AlphaCassiopeiae/web/Files/docs/A7 - Bill of Materials.xlsx

Bill of Materials
Year: | 2025
Semester: | Spring
Team #: | 15
Project Name: | αCassiopeiae
Authors: | Caleb Shinkle, Brian Lu, Seth Deegan, Nathan Huang
Created: | 2025-02-10
Last Modified: | 2025-02-15
Project Component | PCB |  | Value | Package |  |  |  |  | Approximate Price
Description | ID | Qty | (Ohm, etc.) | (type or size) | Manufacturer | Mfg. Part # | Supplier | Supplier Part # | (Qty 1)
RP2350 Stamp XL Boards | 1 | 3 | - | 1 in x 1.75 in | Raspberry Pi | Raspberry Pi Stamp | Pimoroni |  | $19
SMD Red Reverse LEDs | 2 | 36 |  | 3.2 mm x 2.8 mm | SunLED | XZM2CRK45WT-9 | DigiKey | 1497-1331-1-ND | $14
Printed Circuit Board | 3 | 9 | - | Custom | JLCPCB | - | JLCPCB | - | $10
Raspberry Pi Pico 2 | 4 | 3 | - | 21 mm x 51 mm | Raspberry Pi Ltd | RP2350B | DigiKey | - | $5
128 MB Flash | 11 | 3 |  | 8-SOIC (0.209", 5.30mm Width) | Winbond Electronics | W25Q128JVSJQ | DigiKey | W25Q128JVSJQ-ND | $1.75
Crystal Oscillator | 12 | 3 |  | 5 SMD | Abracon LLC | ABM8-272-T3 | DigiKey | 535-ABM8-272-T3TR-ND | $0.54
MCP16331T-E/CH | 5 | 2 | DC-DC converter IC | 6-pin SOT-23 | Microchip Technology | MCP16331T-E/CH | DigiKey | MCP16331T-E/CH | $1
USB-C BREAKOUT | 6 | 6 | - | 22.1mm x 14mm x 4.9mm | SparkFun Electronics | BOB-15100 | DigiKey | BOB-15100 | $6
Flat Flexible Cable | 7 | 3 | - | 2.000 inches | Molex | 0150150233 | DigiKey | WM9647-ND | $2
FFC Socket Strip | 8 | 6 | Connector | 20-position, 1.00 mm pitch | Samtec | FC1-20-01-T-TR | Mouser | 200-FC12001TTR | $3.34
TFT Slide Switches | 9 | 16 | Through Hole Mount | - | Amazon | B09R3XLVVS | Amazon | - | $7
Enclosure | 10 | 1 | - | 12 in x 7 in x 5 in | Custom | - | Custom | - | N/A
Note: Do not list misc. discrete parts (resistors, caps, etc.) such as decoupling caps and ESD protection current limiting resistors.
