AlphaCassiopeiae/web/Team/journal/img - member1/week11/20250325_8800_computer.csv

Query | Qty | Manufacturer | MPN | Octopart URL | Part Description | Description | Schematic Reference | Internal Part Number | Lifecycle | Lead Time | RoHS | Total Qty (@ Batch Size: 4) | SKU | SKU | SKU | SKU | SKU | Packaging | Packaging | Packaging | Packaging | Packaging | Unit Price (@ Batch Size: 4) | Unit Price (@ Batch Size: 4) | Unit Price (@ Batch Size: 4) | Unit Price (@ Batch Size: 4) | Unit Price (@ Batch Size: 4) | In Stock | In Stock | In Stock | In Stock | In Stock | MOQ | MOQ | MOQ | MOQ | MOQ | URL | URL | URL | URL | URL | Distributor [Lowest Price (Preferred Distributors)] | SKU [Lowest Price (Preferred Distributors)] | Packaging [Lowest Price (Preferred Distributors)] | Unit Price (@ Batch Size: 4) [Lowest Price (Preferred Distributors)] | Line Total [Lowest Price (Preferred Distributors)] | Batch Total [Lowest Price (Preferred Distributors)] | In Stock [Lowest Price (Preferred Distributors)] | MOQ [Lowest Price (Preferred Distributors)] | URL [Lowest Price (Preferred Distributors)] | Notes
 |  |  |  |  |  |  |  |  |  |  |  |  | Digi-Key | Mouser | Newark | Onlinecomponents.com | RS Components | Digi-Key | Mouser | Newark | Onlinecomponents.com | RS Components | Digi-Key | Mouser | Newark | Onlinecomponents.com | RS Components | Digi-Key | Mouser | Newark | Onlinecomponents.com | RS Components | Digi-Key | Mouser | Newark | Onlinecomponents.com | RS Components | Digi-Key | Mouser | Newark | Onlinecomponents.com | RS Components
TLC59211IPWR | 5 | Texas Instruments | TLC59211IPWR | https://octopart.com/tlc59211ipwr-texas+instruments-12190463 | Tape & Reel (TR) TLC59211 Boost Surface Mount led driver 6.5mm 200mA 5.5V 1MHz |  |  |  | Production (Last Updated: 1 week ago) | 6w | Compliant | 20 | 296-25404-1-ND | 595-TLC59211IPWR |  |  |  | Cut Tape | Tape & Reel |  |  |  | 1.096 | 1.03 |  |  |  | 5318 | 1116 |  |  |  | 1 | 1 |  |  |  | https://octopart.com/opatz8j6/a1 | https://octopart.com/opatz8j6/a1 |  |  |  | Mouser | 595-TLC59211IPWR | Tape & Reel | 1.03 | 5.15 | 20.6 | 1116 | 1 | https://octopart.com/opatz8j6/a1
VLRK31Q1R2-GS08 | 36 | Vishay | VLRK31Q1R2-GS08 | https://octopart.com/vlrk31q1r2-gs08-vishay-23378693 | Led Smd Red Reverse Gullwing Rohs Compliant: Yes |Vishay VLRK31Q1R2-GS08 |  |  |  |  | 10w | Compliant | 144 | VLRK31Q1R2-GS08CT-ND | 78-VLRK31Q1R2-GS08 | 58AJ2838 |  |  | Cut Tape | Tape & Reel | Cut Tape |  |  | 0.2158 | 0.171 | 0.166 |  |  | 8551 | 806 | 287 |  |  | 1 | 1 | 5 |  |  | https://octopart.com/opatz8j6/a1 | https://octopart.com/opatz8j6/a1 | https://octopart.com/opatz8j6/a1 |  |  | Newark | 58AJ2838 | Cut Tape | 0.166 | 5.976 | 23.904 | 287 | 5 | https://octopart.com/opatz8j6/a1
10145891-0320J13LF | 4 | Amphenol Communications Solutions | 10145891-0320J13LF | https://octopart.com/10145891-0320j13lf-amphenol+communications+solutions-126543368 | DDR4 Memory Module Socket Connector Socket 288 Position 0.85mm Solder Surface Mount |  |  |  |  | 16w |  | 16 | 609-6571-ND | 649-1014591320J13LF | 81AC5784 | 10145891-0320J13LF |  | Tray | Tray |  | Bulk |  | 3.097 | 2.97 | 2.83 |  |  | 1757 | 1500 | 1148 | 2 |  | 1 | 1 | 1 | 32 |  | https://octopart.com/opatz8j6/a1 | https://octopart.com/opatz8j6/a1 | https://octopart.com/opatz8j6/a1 | https://octopart.com/opatz8j6/a1 |  | Newark | 81AC5784 |  | 2.83 | 11.32 | 45.28 | 1148 | 1 | https://octopart.com/opatz8j6/a1
MCP16331T-E/CH | 1 | Microchip | MCP16331T-E/CH | https://octopart.com/mcp16331t-e%2Fch-microchip-47099655 | Conv DC-DC 4.4V to 50V Step Down Single-Out 2V to 24V 0.5A Automotive 6-Pin SOT-23 T/R |  |  |  | Production (Last Updated: 4 years ago) | 17w | Compliant | 4 | MCP16331T-E/CHCT-ND | 579-MCP16331T-E/CH | 84X5964 | MCP16331T-E/CH |  | Cut Tape | Tape & Reel | Cut Tape | Bulk |  | 1.75 | 1.75 | 1.48 |  |  | 4507 | 6366 | 6866 | 6000 |  | 1 | 1 | 1 | 250 |  | https://octopart.com/opatz8j6/a1 | https://octopart.com/opatz8j6/a1 | https://octopart.com/opatz8j6/a1 | https://octopart.com/opatz8j6/a1 |  | Newark | 84X5964 | Cut Tape | 1.48 | 1.48 | 5.92 | 6866 | 1 | https://octopart.com/opatz8j6/a1
USB4105-GF-A | 4 | Global Connector Technology | USB4105-GF-A | https://octopart.com/usb4105-gf-a-global+connector+technology-107467269 | USB Connector, 24 Contact(s), Female, Right Angle, Solder Terminal, Locking, Receptacle |  |  |  |  | 12w | Compliant | 16 | 2073-USB4105-GF-ACT-ND |  | 86AH2021 |  |  | Cut Tape |  | Cut Tape |  |  | 0.659 |  | 0.701 |  |  | 52214 |  | 556 |  |  | 1 |  | 1 |  |  | https://octopart.com/opatz8j6/a1 |  | https://octopart.com/opatz8j6/a1 |  |  | DigiKey | 2073-USB4105-GF-ACT-ND | Cut Tape | 0.659 | 2.636 | 10.544 | 52214 | 1 | https://octopart.com/opatz8j6/a1
OS102011MS2QN1 | 16 | C&K Components | OS102011MS2QN1 | https://octopart.com/os102011ms2qn1-c%26k+components-2486956 | C & K COMPONENTS - OS102011MS2QN1 - Slide Switch, SPDT, On-On, Through Hole, OS Series, 100 mA |  |  |  |  | 10w | Compliant | 64 | CKN9565-ND | 611-OS102011MS2QN1 | 35AH4511 | OS102011MS2QN1 |  | Bulk | Bulk |  | Bulk |  | 0.5616 | 0.475 | 0.51 |  |  | 63701 | 3295 | 315 | 36554 |  | 1 | 1 | 1 | 300 |  | https://octopart.com/opatz8j6/a1 | https://octopart.com/opatz8j6/a1 | https://octopart.com/opatz8j6/a1 | https://octopart.com/opatz8j6/a1 |  | Mouser | 611-OS102011MS2QN1 | Bulk | 0.475 | 7.6 | 30.4 | 3295 | 1 | https://octopart.com/opatz8j6/a1
USB4235-03-C | 1 | Global Connector Technology | USB4235-03-C | https://octopart.com/usb4235-03-c-global+connector+technology-157378717 | Usb Connector, 2.0 Typ C Rcpt, 16POS, SMT; |  |  |  |  | 7w |  | 4 | 2073-USB4235-03-CCT-ND |  | 16AM9284 |  |  | Cut Tape |  |  |  |  | 0.87 |  | 1.15 |  |  | 361 |  | 439 |  |  | 1 |  | 1 |  |  | https://octopart.com/opatz8j6/a1 |  | https://octopart.com/opatz8j6/a1 |  |  | DigiKey | 2073-USB4235-03-CCT-ND | Cut Tape | 0.87 | 0.87 | 3.48 | 361 | 1 | https://octopart.com/opatz8j6/a1
5017868090 | 1 | Molex | 501786-8090 | https://octopart.com/501786-8090-molex-46509680 | FFC & FPC Connectors 0.5 FFC To Board ST Type 80CktEmbsTp Pkg |  |  |  | Production (Last Updated: 4 years ago) | 9w | Compliant | 4 | WM20781CT-ND | 538-501786-8090 | 82AH2668 | 501786-8090 |  | Cut Tape |  | Cut Tape | Bulk |  | 4.82 | 4.82 | 5.12 |  |  | 2552 | 2016 | 623 | 17100 |  | 1 | 1 | 1 | 900 |  | https://octopart.com/opatz8j6/a1 | https://octopart.com/opatz8j6/a1 | https://octopart.com/opatz8j6/a1 | https://octopart.com/opatz8j6/a1 |  | DigiKey | WM20781CT-ND | Cut Tape | 4.82 | 4.82 | 19.28 | 2552 | 1 | https://octopart.com/opatz8j6/a1
1455T2202 | 1 | Hammond | 1455T2202 | https://octopart.com/1455t2202-hammond-50599 | Aluminum enclosure, (L x W x H) 220 x 165 x 51.5 mm, natural, IP54, 1455T2202 |  |  |  |  | 4w | Compliant | 4 | HM906-ND | 546-1455T2202 | 98H4055 | 1455T2202 |  | Bulk | Bulk |  | Bulk |  | 33.01 | 29.41 | 30.87 | 30.01 |  | 37 | 81 | 249 | 3 |  | 1 | 1 | 1 | 1 |  | https://octopart.com/opatz8j6/a1 | https://octopart.com/opatz8j6/a1 | https://octopart.com/opatz8j6/a1 | https://octopart.com/opatz8j6/a1 |  | Mouser | 546-1455T2202 | Bulk | 29.41 | 29.41 | 117.64 | 81 | 1 | https://octopart.com/opatz8j6/a1
S3B-XH-A | 12 | JST | S3B-XH-A | https://octopart.com/s3b-xh-a-jst-3990374 | Board Connector, 3 Contact(s), 1 Row(s), Male, Right Angle, Solder Terminal |  |  |  |  | 16w | Compliant | 48 | 455-S3B-XH-A-ND |  |  |  |  | Bulk |  |  |  |  | 0.118 |  |  |  |  | 138085 |  |  |  |  | 1 |  |  |  |  | https://octopart.com/opatz8j6/a1 |  |  |  |  | DigiKey | 455-S3B-XH-A-ND | Bulk | 0.118 | 1.416 | 5.664 | 138085 | 1 | https://octopart.com/opatz8j6/a1
NCP1117ST33T3G | 3 | onsemi | NCP1117ST33T3G | https://octopart.com/ncp1117st33t3g-onsemi-538117 | NCP1117 Series 1 A 3.3 V Fixed Output LDO Positive Voltage Regulator - SOT-223 |  |  |  | Production (Last Updated: 4 years ago) | 9w | Compliant | 12 | NCP1117ST33T3GOSCT-ND | 863-NCP1117ST33T3G | 67H7013 | NCP1117ST33T3G |  | Cut Tape | Tape & Reel | Cut Tape | Bulk |  | 0.71 | 0.71 | 0.749 |  |  | 35924 | 40182 | 2284 | 16000 |  | 1 | 1 | 1 | 4000 |  | https://octopart.com/opatz8j6/a1 | https://octopart.com/opatz8j6/a1 | https://octopart.com/opatz8j6/a1 | https://octopart.com/opatz8j6/a1 |  | Mouser | 863-NCP1117ST33T3G | Tape & Reel | 0.71 | 2.13 | 8.52 | 40182 | 1 | https://octopart.com/opatz8j6/a1
500SSP1S1M7QEA | 1 | E-Switch | 500SSP1S1M7QEA | https://octopart.com/500ssp1s1m7qea-e-switch-1199228 | Switch Slide ON None ON SPDT Side Slide 5A 250VAC 28VDC PC Pins Bracket Mount/Through Hole |  |  |  |  | 12w | Compliant | 4 | EG2480-ND | 612-500-A171 | 16N1338 | 500SSP1S1M7QEA |  | Bulk | Bulk |  | Bulk |  | 4.13 | 4.03 |  |  |  | 1528 | 730 | 1512 | 762 |  | 1 | 1 | 252 | 63 |  | https://octopart.com/opatz8j6/a1 | https://octopart.com/opatz8j6/a1 | https://octopart.com/opatz8j6/a1 | https://octopart.com/opatz8j6/a1 |  | Mouser | 612-500-A171 | Bulk | 4.03 | 4.03 | 16.12 | 730 | 1 | https://octopart.com/opatz8j6/a1
SS34 | 3 | onsemi | SS34 | https://octopart.com/ss34-onsemi-84331624 | SS Series 500 mV 3 A 40 V Max Reverse Voltage Schottky Rectifier - DO-214AB |  |  |  | Production (Last Updated: 4 years ago) | 9w | Compliant | 12 | SS34FSCT-ND | 512-SS34 | 18C8659 | SS34 |  | Cut Tape | Tape & Reel | Cut Tape | Bulk |  | 0.461 | 0.555 | 0.267 |  |  | 19835 | 63709 | 98766 | 27000 |  | 1 | 1 | 1 | 3000 |  | https://octopart.com/opatz8j6/a1 | https://octopart.com/opatz8j6/a1 | https://octopart.com/opatz8j6/a1 | https://octopart.com/opatz8j6/a1 |  | Newark | 18C8659 | Cut Tape | 0.267 | 0.801 | 3.204 | 98766 | 1 | https://octopart.com/opatz8j6/a1
ERJ-PA3F27R0V | 8 | Panasonic | ERJ-PA3F27R0V | https://octopart.com/erj-pa3f27r0v-panasonic-51302422 | Res Thick Film 0603 27 Ohm 1% 0.25W(1/4W) ±100ppm/C Pad SMD Automotive T/R |  |  |  | Production (Last Updated: 4 years ago) | 15w | Compliant | 32 | P27.00BYCT-ND | 667-ERJ-PA3F27R0V | 85Y6353 | ERJ-PA3F27R0V |  | Cut Tape | Tape & Reel | Cut Tape | Bulk |  | 0.07 | 0.047 | 0.046 |  |  | 29555 | 5294 | 580 | 0 |  | 1 | 1 | 10 | 5000 |  | https://octopart.com/opatz8j6/a1 | https://octopart.com/opatz8j6/a1 | https://octopart.com/opatz8j6/a1 | https://octopart.com/opatz8j6/a1 |  | Newark | 85Y6353 | Cut Tape | 0.046 | 0.368 | 1.472 | 580 | 10 | https://octopart.com/opatz8j6/a1
TAJA226M006RNJ | 6 | AVX | TAJA226M006RNJ | https://octopart.com/taja226m006rnj-avx-3912279 | Cap Tant Solid 22uF 6.3V A CASE 20% (3.2 X 1.6 X 1.6mm) SMD 3216-18 3 Ohm 125A HA T/R |  |  |  | Production (Last Updated: 5 years ago) | 6w | Compliant | 24 | 478-3028-1-ND | 581-TAJA226M006R | 60R5845 |  |  | Cut Tape | Tape & Reel | Cut Tape |  |  | 0.287 | 0.206 | 0.052 |  |  | 10738 | 3115 | 63 |  |  | 1 | 1 | 1 |  |  | https://octopart.com/opatz8j6/a1 | https://octopart.com/opatz8j6/a1 | https://octopart.com/opatz8j6/a1 |  |  | Newark | 60R5845 | Cut Tape | 0.052 | 0.312 | 1.248 | 63 | 1 | https://octopart.com/opatz8j6/a1
C0805C106K4PACTU | 3 | KEMET | C0805C106K4PACTU | https://octopart.com/c0805c106k4pactu-kemet-9144095 | Multilayer Ceramic Capacitors MLCC - SMD/SMT 16V 10uF X5R 0805 10% |  |  |  |  | 33w | Compliant | 12 | 399-C0805C106K4PACTUCT-ND | 80-C0805C106K4P | 25M8789 |  |  | Cut Tape | Tape & Reel | Cut Tape |  |  | 0.086 | 0.086 | 0.738 |  |  | 495105 | 348315 | 213204 |  |  | 1 | 1 | 10 |  |  | https://octopart.com/opatz8j6/a1 | https://octopart.com/opatz8j6/a1 | https://octopart.com/opatz8j6/a1 |  |  | Mouser | 80-C0805C106K4P | Tape & Reel | 0.086 | 0.258 | 1.032 | 348315 | 1 | https://octopart.com/opatz8j6/a1
CRG0603F5K1 | 6 | TE Connectivity | CRG0603F5K1 | https://octopart.com/crg0603f5k1-te+connectivity-16077405 | Res Thick Film 0603 5.1K Ohm 1% 0.1W(1/10W) ±100ppm/C Pad SMD T/R |  |  |  | Production (Last Updated: 2 weeks ago) | 12w | Compliant | 24 | 1712-CRG0603F5K1CT-ND | 279-CRG0603F5K1 | 20R1551 | CRG0603F5K1 |  | Cut Tape | Tape & Reel | Tape & Reel | Bulk |  | 0.027 | 0.019 |  |  |  | 32330 | 25484 | 0 | 5000 |  | 1 | 1 | 20000 | 10000 |  | https://octopart.com/opatz8j6/a1 | https://octopart.com/opatz8j6/a1 | https://octopart.com/opatz8j6/a1 | https://octopart.com/opatz8j6/a1 |  | Mouser | 279-CRG0603F5K1 | Tape & Reel | 0.019 | 0.11399999999999999 | 0.45599999999999996 | 25484 | 1 | https://octopart.com/opatz8j6/a1
CRGCQ0805J100K | 3 | TE Connectivity | CRGCQ0805J100K | https://octopart.com/crgcq0805j100k-te+connectivity-91018199 | Res Thick Film 0805 100K Ohm 5% 0.125W(1/8W) ±100ppm/C Pad SMD Automotive AEC-Q200 T/R |  |  |  | Production (Last Updated: 2 weeks ago) | 12w | Compliant | 12 | A130146CT-ND | 279-CRGCQ0805J100K | 61AC6610 | CRGCQ0805J100K |  | Cut Tape | Tape & Reel | Cut Tape | Bulk |  | 0.031 | 0.017 | 0.018 |  |  | 20354 | 2744 | 8 | 0 |  | 1 | 1 | 10 | 5000 |  | https://octopart.com/opatz8j6/a1 | https://octopart.com/opatz8j6/a1 | https://octopart.com/opatz8j6/a1 | https://octopart.com/opatz8j6/a1 |  | Mouser | 279-CRGCQ0805J100K | Tape & Reel | 0.017 | 0.051000000000000004 | 0.20400000000000001 | 2744 | 1 | https://octopart.com/opatz8j6/a1
AC0402JR-130RL | 12 | Yageo | AC0402JR-130RL | https://octopart.com/ac0402jr-130rl-yageo-30510720 | Zero Ohm Resistor, Jumper, 0402 [1005 Metric], Thick Film, 63 mW, 1 A, Surface Mount |  |  |  |  | 18w |  | 48 | 13-AC0402JR-130RLCT-ND | 603-AC0402JR-130RL | 46AK2287 |  |  | Cut Tape | Tape & Reel |  |  |  | 0.01 | 0.01 | 0.01 |  |  | 74451 | 111817 | 133650 |  |  | 1 | 1 | 10 |  |  | https://octopart.com/opatz8j6/a1 | https://octopart.com/opatz8j6/a1 | https://octopart.com/opatz8j6/a1 |  |  | Mouser | 603-AC0402JR-130RL | Tape & Reel | 0.01 | 0.12 | 0.48 | 111817 | 1 | https://octopart.com/opatz8j6/a1
CRG0402F5K1 | 2 | TE Connectivity | CRG0402F5K1 | https://octopart.com/crg0402f5k1-te+connectivity-22736831 | Fixed Resistor, Thick Film, 0.063W, 5100ohm, 50V, 1% +/-Tol, 100ppm/Cel, Surface Mount, 0402 |  |  |  | Production (Last Updated: 2 weeks ago) | 13w | Compliant | 8 | 1712-CRG0402F5K1CT-ND | 279-CRG0402F5K1 | 95W7485 | CRG0402F5K1 |  | Cut Tape | Tape & Reel | Cut Tape | Bulk |  | 0.1 |  |  |  |  | 27333 | 0 | 9870 | 0 |  | 1 | 10000 | 10 | 10000 |  | https://octopart.com/opatz8j6/a1 | https://octopart.com/opatz8j6/a1 | https://octopart.com/opatz8j6/a1 | https://octopart.com/opatz8j6/a1 |  | DigiKey | 1712-CRG0402F5K1CT-ND | Cut Tape | 0.1 | 0.2 | 0.8 | 27333 | 1 | https://octopart.com/opatz8j6/a1
CRGP0402F150R | 2 | TE Connectivity | CRGP0402F150R | https://octopart.com/crgp0402f150r-te+connectivity-91018667 | Res Thick Film 0402 150 Ohm 1% 0.125W(1/8W) ±100ppm/°C Pad SMD T/R Automotive AEC-Q200 |  |  |  | Production (Last Updated: 2 weeks ago) | 15w | Compliant | 8 | A130345CT-ND | 279-CRGP0402F150R | 61AC7076 | CRGP0402F150R |  | Cut Tape | Tape & Reel | Cut Tape | Bulk |  | 0.13 | 0.13 |  |  |  | 72296 | 20904 | 1928 | 0 |  | 1 | 1 | 10 | 10000 |  | https://octopart.com/opatz8j6/a1 | https://octopart.com/opatz8j6/a1 | https://octopart.com/opatz8j6/a1 | https://octopart.com/opatz8j6/a1 |  | DigiKey | A130345CT-ND | Cut Tape | 0.13 | 0.26 | 1.04 | 72296 | 1 | https://octopart.com/opatz8j6/a1
2176325-1 | 1 | TE Connectivity | 2176325-1 | https://octopart.com/2176325-1-te+connectivity-91017193 | Res Thick Film 0402 10 Ohm 1% 0.125W(1/8W) ±400ppm/°C Pad SMD T/R Automotive AEC-Q200 |  |  |  | Production (Last Updated: 2 weeks ago) | 19w | Compliant | 4 | A130331CT-ND | 279-CRGP0402F10R | 61AC7066 | 2176325-1 |  | Cut Tape | Tape & Reel | Cut Tape | Bulk |  | 0.13 | 0.13 |  |  |  | 11091 | 53543 | 13409 | 50000 |  | 1 | 1 | 10 | 10000 |  | https://octopart.com/opatz8j6/a1 | https://octopart.com/opatz8j6/a1 | https://octopart.com/opatz8j6/a1 | https://octopart.com/opatz8j6/a1 |  | Mouser | 279-CRGP0402F10R | Tape & Reel | 0.13 | 0.13 | 0.52 | 53543 | 1 | https://octopart.com/opatz8j6/a1
598-8010-107F | 2 | Dialight | 598-8010-107F | https://octopart.com/598-8010-107f-dialight-868653 | 0603 PACKAGE MICRO SMD LED Single Color LED, Red, Water Clear, 1.1mm |  |  |  |  | 8w | Compliant | 8 | 350-2029-1-ND | 645-598-8010-107F | 75R0572 | 598-8010-107F |  | Cut Tape | Tape & Reel | Cut Tape | Bulk |  | 0.23 | 0.32 | 0.064 |  |  | 47129 | 162 | 7082 | 8797 |  | 1 | 1 | 1 | 4000 |  | https://octopart.com/opatz8j6/a1 | https://octopart.com/opatz8j6/a1 | https://octopart.com/opatz8j6/a1 | https://octopart.com/opatz8j6/a1 |  | Newark | 75R0572 | Cut Tape | 0.064 | 0.128 | 0.512 | 7082 | 1 | https://octopart.com/opatz8j6/a1
AMK107ABJ106MAHT | 2 | Taiyo Yuden | AMK107ABJ106MAHT | https://octopart.com/amk107abj106maht-taiyo+yuden-29102938 | Multilayer Ceramic Capacitors MLCC - SMD/SMT 10uF 4V X5R +/-20% 0603 AEC-Q200 |  |  |  |  | 12w | Compliant | 8 | 587-3261-1-ND | 963-AMK107ABJ106MAHT | 02AH5350 | AMK107ABJ106MAHT |  | Cut Tape | Tape & Reel | Cut Tape | Bulk |  | 0.12 | 0.11 |  |  |  | 49050 | 11019 | 0 | 16000 |  | 1 | 1 | 4000 | 4000 |  | https://octopart.com/opatz8j6/a1 | https://octopart.com/opatz8j6/a1 | https://octopart.com/opatz8j6/a1 | https://octopart.com/opatz8j6/a1 |  | Mouser | 963-AMK107ABJ106MAHT | Tape & Reel | 0.11 | 0.22 | 0.88 | 11019 | 1 | https://octopart.com/opatz8j6/a1
CC0402MRX5R5BB106 | 2 | Yageo | CC0402MRX5R5BB106 | https://octopart.com/cc0402mrx5r5bb106-yageo-51849243 | 0402 10 uF 6.3 V ±20 % Tolerance X5R SMT Multilayer Ceramic Capacitor |  |  |  |  | 22w | Compliant | 8 | 311-1729-1-ND | 603-CC402MRX5R5BB106 | 34AK1777 |  |  | Cut Tape | Tape & Reel | Cut Tape |  |  | 0.2 | 0.18 |  |  |  | 748335 | 3790 | 94041 |  |  | 1 | 1 | 10 |  |  | https://octopart.com/opatz8j6/a1 | https://octopart.com/opatz8j6/a1 | https://octopart.com/opatz8j6/a1 |  |  | Mouser | 603-CC402MRX5R5BB106 | Tape & Reel | 0.18 | 0.36 | 1.44 | 3790 | 1 | https://octopart.com/opatz8j6/a1
CC0402JRX7R7BB104 | 1 | Yageo | CC0402JRX7R7BB104 | https://octopart.com/cc0402jrx7r7bb104-yageo-21707045 | 0402 0.1 uF 16 V ±5 % Tolerance X7R SMT Multilayer Ceramic Capacitor |  |  |  |  | 18w | Compliant | 4 | 311-1676-1-ND | 603-CC402JRX7R7BB104 | 40AJ6340 |  |  | Cut Tape | Tape & Reel | Cut Tape |  |  | 0.08 | 0.1 |  |  |  | 711875 | 242502 | 29373 |  |  | 1 | 1 | 10 |  |  | https://octopart.com/opatz8j6/a1 | https://octopart.com/opatz8j6/a1 | https://octopart.com/opatz8j6/a1 |  |  | DigiKey | 311-1676-1-ND | Cut Tape | 0.08 | 0.08 | 0.32 | 711875 | 1 | https://octopart.com/opatz8j6/a1
BAS16L-G3-08 | 1 | Vishay | BAS16L-G3-08 | https://octopart.com/bas16l-g3-08-vishay-114064069 | Switching Diode Genpurp Dfn1006-2A Rohs Compliant: Yes |Vishay BAS16L-G3-08 |  |  |  |  | 8w |  | 4 | 112-BAS16L-G3-08CT-ND | 78-BAS16L-G3-08 | 60AJ3508 |  |  | Cut Tape | Tape & Reel | Cut Tape |  |  | 0.17 | 0.17 |  |  |  | 23780 | 26451 | 0 |  |  | 1 | 1 | 5 |  |  | https://octopart.com/opatz8j6/a1 | https://octopart.com/opatz8j6/a1 | https://octopart.com/opatz8j6/a1 |  |  | Mouser | 78-BAS16L-G3-08 | Tape & Reel | 0.17 | 0.17 | 0.68 | 26451 | 1 | https://octopart.com/opatz8j6/a1
B130L-13-F | 1 | Diodes Inc. | B130L-13-F | https://octopart.com/b130l-13-f-diodes+inc.-325738 | Diode Schottky 30 Volt 1A 2-Pin SMA Tape and Reel |  |  |  |  | 10w | Compliant | 4 | B130L-FDICT-ND | 621-B130L-F | 28AK7619 |  |  | Cut Tape | Tape & Reel | Cut Tape |  |  | 0.24 | 0.24 | 0.087 |  |  | 12807 | 34738 | 650 |  |  | 1 | 1 | 1 |  |  | https://octopart.com/opatz8j6/a1 | https://octopart.com/opatz8j6/a1 | https://octopart.com/opatz8j6/a1 |  |  | Newark | 28AK7619 | Cut Tape | 0.087 | 0.087 | 0.348 | 650 | 1 | https://octopart.com/opatz8j6/a1
7447779115 | 1 | Wurth Elektronik | 7447779115 | https://octopart.com/7447779115-wurth+elektronik-8917202 | Power Choke Shielded Wirewound 15uH 20% 1KHz Ferrite 1.6A 81mOhm DCR T/R |  |  |  |  | 8w | Compliant | 4 | 732-4137-1-ND | 710-7447779115 | 08P2859 |  |  | Cut Tape | Tape & Reel | Cut Tape |  |  | 2.13 | 2.31 | 2.78 |  |  | 2355 | 1206 | 971 |  |  | 1 | 1 | 1 |  |  | https://octopart.com/opatz8j6/a1 | https://octopart.com/opatz8j6/a1 | https://octopart.com/opatz8j6/a1 |  |  | DigiKey | 732-4137-1-ND | Cut Tape | 2.13 | 2.13 | 8.52 | 2355 | 1 | https://octopart.com/opatz8j6/a1
CPF-A-0402B10KE1 | 1 | TE Connectivity | CPF-A-0402B10KE1 | https://octopart.com/cpf-a-0402b10ke1-te+connectivity-58810720 | Fixed Resistor, Thin Film, 0.063W, 10000ohm, 25V, 0.1% +/-Tol, 25ppm/Cel, Surface Mount, 0402 |  |  |  | Production (Last Updated: 2 weeks ago) | 10w |  | 4 | 1712-CPF-A-0402B10KE1CT-ND | 279-CPF-A-0402B10KE1 | 52Y3079 | CPF-A-0402B10KE1 |  | Cut Tape | Tape & Reel | Cut Tape | Bulk |  | 0.31 | 0.31 | 0.421 |  |  | 607 | 1939 | 128 | 2000 |  | 1 | 1 | 1 | 1000 |  | https://octopart.com/opatz8j6/a1 | https://octopart.com/opatz8j6/a1 | https://octopart.com/opatz8j6/a1 | https://octopart.com/opatz8j6/a1 |  | Mouser | 279-CPF-A-0402B10KE1 | Tape & Reel | 0.31 | 0.31 | 1.24 | 1939 | 1 | https://octopart.com/opatz8j6/a1
RP73PF1E31K6BTDF | 1 | TE Connectivity | RP73PF1E31K6BTDF | https://octopart.com/rp73pf1e31k6btdf-te+connectivity-89154235 | Res Thin Film 0402 31.6K Ohm 0.1% 0.1W(1/10W) ±25ppm/C Pad SMD Medical T/R |  |  |  | Production (Last Updated: 2 weeks ago) | 10w | Compliant | 4 | 1712-RP73PF1E31K6BTDFCT-ND | 279-RP73PF1E31K6BTDF | 48AC7074 | RP73PF1E31K6BTDF |  | Cut Tape | Tape & Reel | Cut Tape | Bulk |  | 0.21 | 0.33 | 0.309 |  |  | 940 | 885 | 0 | 0 |  | 1 | 1 | 1 | 1000 |  | https://octopart.com/opatz8j6/a1 | https://octopart.com/opatz8j6/a1 | https://octopart.com/opatz8j6/a1 | https://octopart.com/opatz8j6/a1 |  | DigiKey | 1712-RP73PF1E31K6BTDFCT-ND | Cut Tape | 0.21 | 0.21 | 0.84 | 940 | 1 | https://octopart.com/opatz8j6/a1
