AlphaCassiopeiae/web/Team/journal/journal4.html

## Project Journal for Nathan Huang

#### Table of Contents

- Week 15 (April 19 - 25)
- Week 14 (April 12 - 18)
- Week 13 (April 5 - 11)
- Week 12 (March 29 - April 4)
- Week 11 (March 22 - 28)
- Week 10 (March 15 - 21)
- Week 9 (March 8 - 14)
- Week 8 (March 1 - 7)
- Week 7 (February 22 - 28)
- Week 6 (February 15 - 21)
- Week 5 (February 8 - 14)
- Week 4 (February 1 - 7 )
- Week 3 (January 25 - 31)
- Week 2 (January 18 - 24)
- Week 1 (January 11 - 17)

## =============== Week 15: =================

#### Entry 4: -----------------------------------------------------------------

Date: April 25
Start Time: 9:30 am
Duration: 2 hours

Content:
Today was crunch time for the project, as our demonstration was 2:00 PM today. My main priority was creating the debug cables and getting the sticker carved out so that last parts of our software could be debugged for the final demonstration, and we had the final assembly all finished and polished. First, I needed to make the debug cables.
I talked to Brian, who walked me through how he made the first one. To begin, the correct wire gauge was selected, from the box of high quality wire. We choose the colors of green, black, and blue, in that order.



What the debug probe should look like is seen below. I looked up online the process of making on, found here (https://www.societyofrobots.com/electronics_wire_connector.shtml), which would give me some more insight to how these are made.



After selecting the right length and color of wire as seen below, the JST housing and DuPont Housings were found, which is a certain housing that we got.

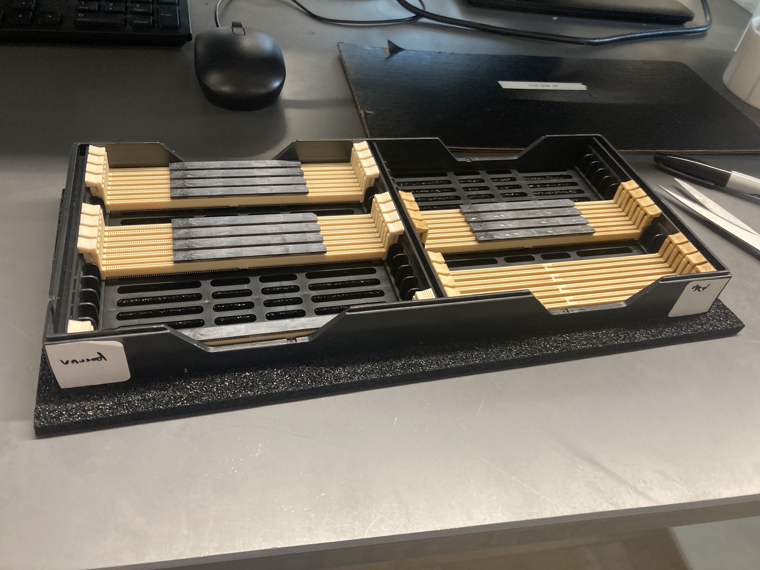
[picture p41: Team/journal/img - member4/week12/4.5.jpg]
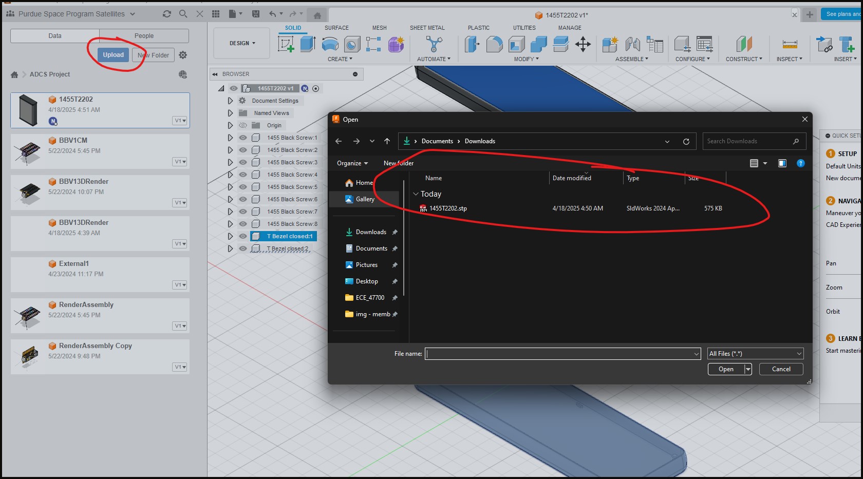
[picture p42: Team/journal/img - member4/week14/4.6.jpg]
   

The wire was crimped so that a little bit of the wire showed, enough to fit into the housing.

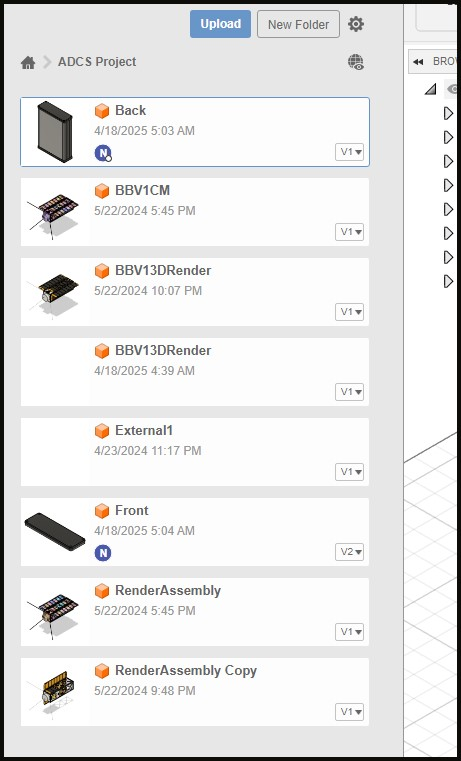
[picture p43: Team/journal/img - member4/week14/4.7.jpg]


After which, the wire was place into the enclosure with tweezers and the pliers were used to move the metal into position. Afterwards, the heavy duty wire crimps were used so that the housing perfectly wrapped around the enclosure.

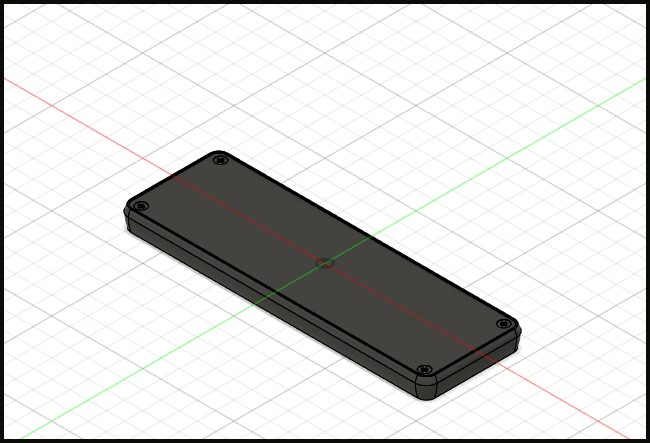
[picture p44: Team/journal/img - member4/week14/4.8.jpg]


Then, I put the proper housing (DuPont or JST) onto the wire, and pushed it into it snapped in. This resulted in each wire looking as below.

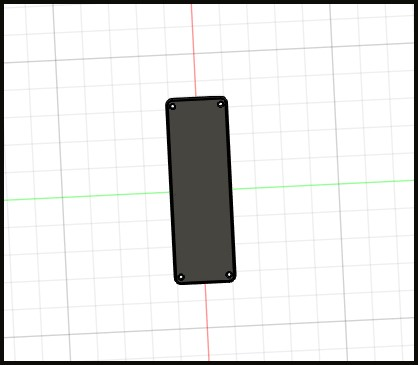
[picture p45: Team/journal/img - member4/week14/4.9.jpg]


The process was repeated for the green, black, and blue wires, as seen below.

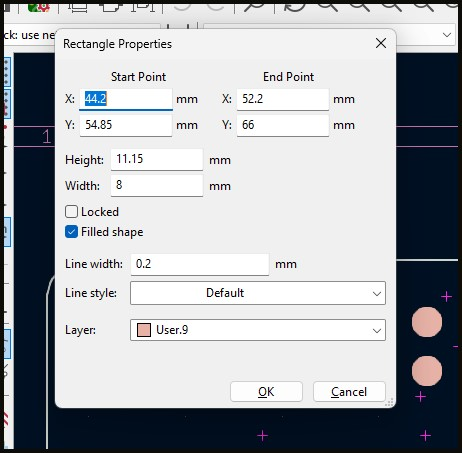
[picture p46: Team/journal/img - member4/week14/4.10.jpg]
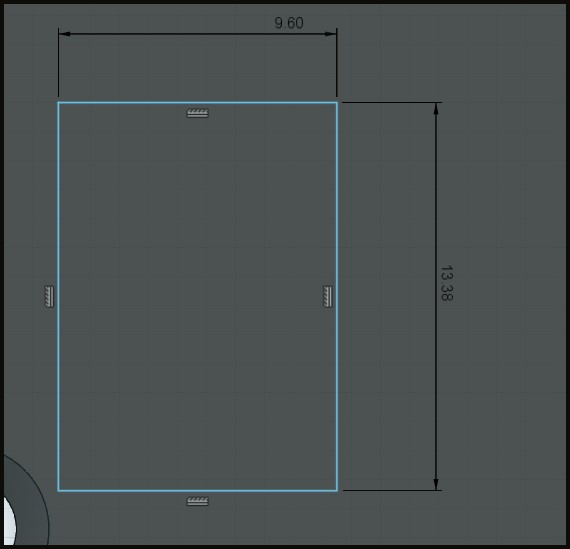
[picture p47: Team/journal/img - member4/week14/4.12.jpg]
  

There were some mishaps, with the metal housing breaking before I could fully crimp it, due to too much pressure being applied with the crimps. The broken housings can be seen in the below image(s).

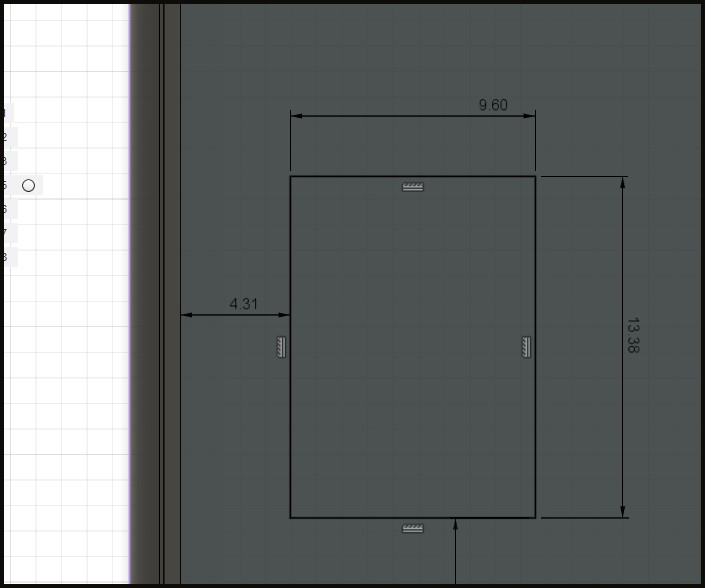
[picture p48: Team/journal/img - member4/week14/4.13.jpg]
 

Then, some rubber shrink wrap was acquired, and cut into tiny rings with pliers so that they could fit around all of the wire. This can be seen in the below image.

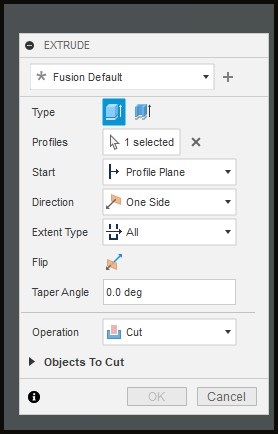
[picture p49: Team/journal/img - member4/week14/4.14.jpg]
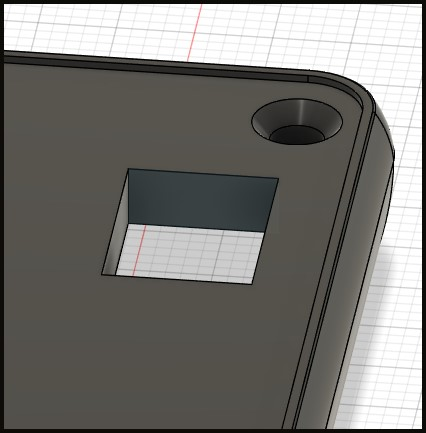
[picture p50: Team/journal/img - member4/week14/4.15.jpg]
 

The shrink wrap was heated with the hot air gun. I turned on the hot air gun from the back and pressed the yellow buttons in periods so that the shrink wrap could fully set. The final product looked as below.

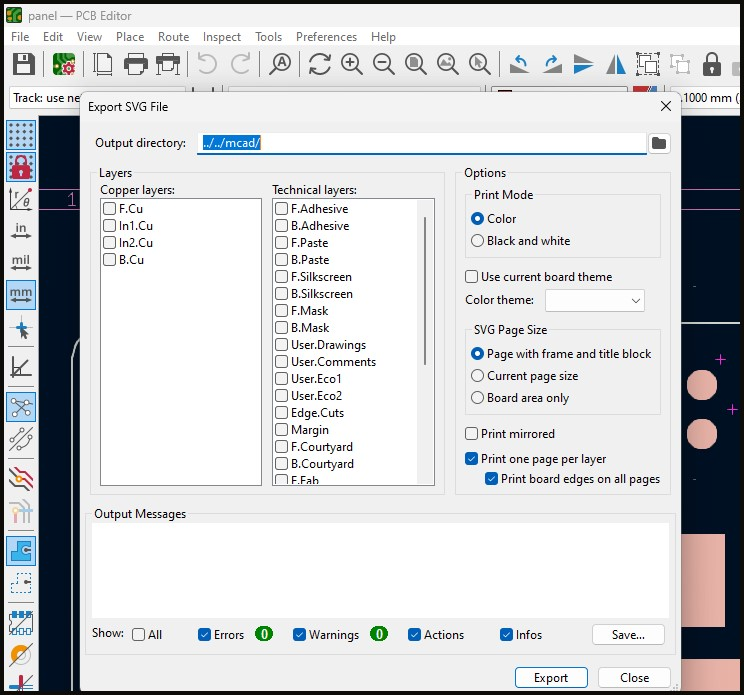
[picture p51: Team/journal/img - member4/week14/4.16.jpg]


I made two more of these wires in the preceding hour. Next, I needed to cut out the sticker for placement on the blue front panel bezel. I grabbed a nail file and an exacto knife, seen in the photo below.



I started by cutting the polygonal areas of the sticker first, by tracing the perimeter. I first cut out the region for the buttons, seen below with the lighter tint around the regions the sticker would be pulled from.



Then, I cut out the back rectangles for each of the 16 switches, tracing each of the them. It can be seen below.

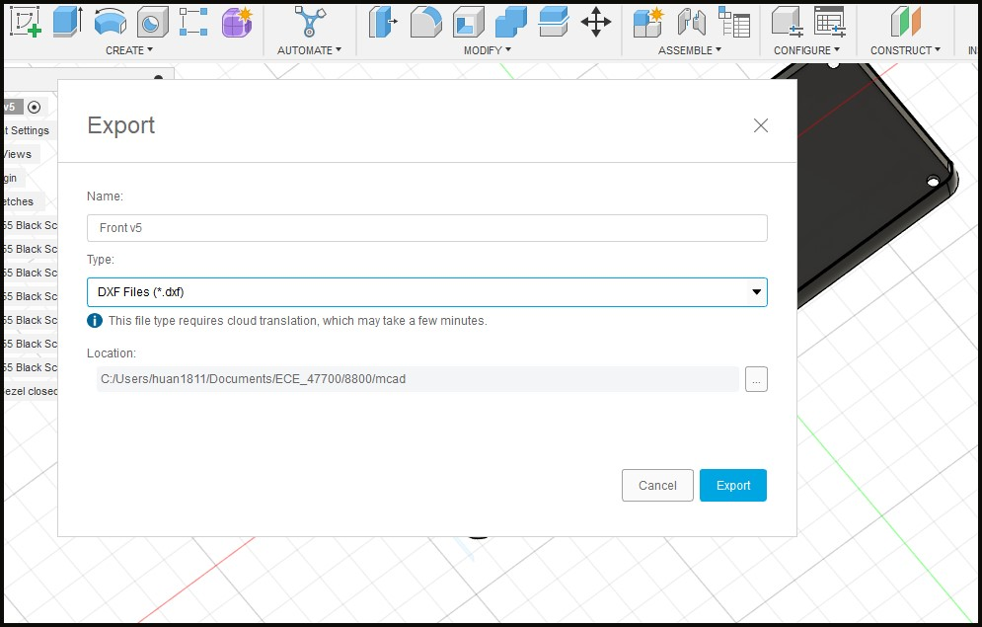
[picture p52: Team/journal/img - member4/week14/4.20.jpg]


For all the little circles, I did some research and found that the best way to remove them when they are stuck to the back of a sticker sheet is by using a sticker label, found with this information here (https://forums.onlinelabels.com/postst1412_Removing-Individual-Circle-Labels.aspx). We will get a circle label or use the back of a pen/pencil, and force push the sticker circles out, seen below.

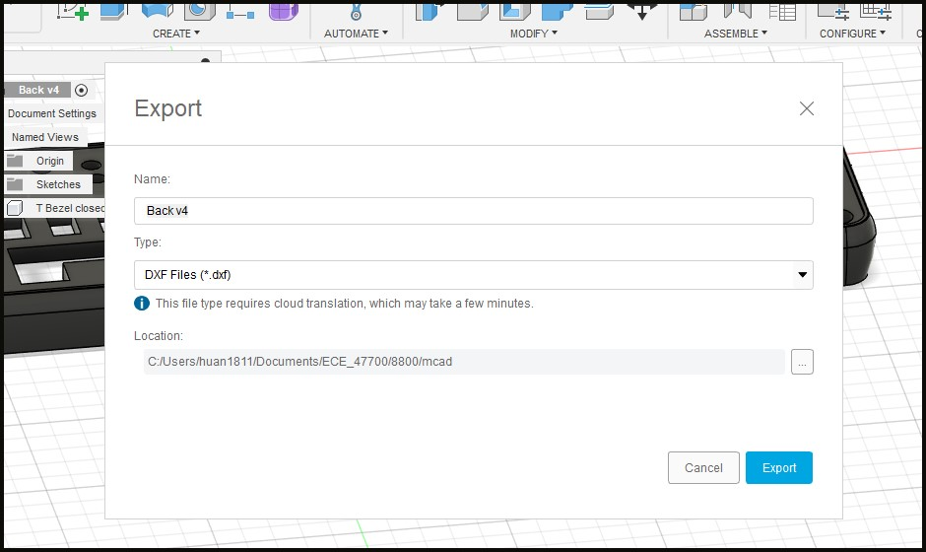
[picture p53: Team/journal/img - member4/week14/4.21.jpg]


It was at this time that I got an email from the machine shop saying the enclosures had been properly tapped, and were ready to be picked up. I went downstairs and brought the new enclosures up, completing the final assembly for the final demo, which was approaching very soon.

Today was crunch time for the project, as our final demonstration was scheduled for 2:00 PM. My main priorities were creating the debug cables and finishing the sticker design for the blue front panel bezel, while ensuring the final assembly was completed and polished. I started by working on the debug cables. I talked to Brian, who showed me the process for making the first one, selecting the right wire gauge and colors (green, black, and blue). I referenced a guide on wire connector creation (https://www.societyofrobots.com/electronics_wire_connector.shtml) for additional insights.

I then proceeded to crimp the wires into JST and DuPont housings, ensuring the crimps were tight and the wires properly inserted into the enclosures. Some mishaps occurred, with a few metal housings breaking due to excessive pressure, but I managed to continue with the process. I added rubber shrink wrap to the wires, which I heated with a hot air gun to secure the wrapping. I created two more wires and moved on to the next task.

Next, I worked on cutting out the sticker for the front panel bezel. I used a nail file and an exacto knife to cut out polygonal areas, including the button regions and rectangles for the 16 switches. I faced some difficulty with the small circle cutouts but found a solution by researching the best way to remove individual circle labels, as detailed in this forum post (https://forums.onlinelabels.com/postst1412_Removing-Individual-Circle-Labels.aspx).

During this, I received an email from the machine shop saying that the enclosures had been tapped and were ready for pickup. I went downstairs, retrieved the enclosures, and completed the final assembly, preparing everything for the imminent demonstration.

Citations:
- 1: Wire Connector Tutorial - Society of Robots (https://www.societyofrobots.com/electronics_wire_connector.shtml)
- 2: Removing Individual Circle Labels - OnlineLabels Forum (https://forums.onlinelabels.com/postst1412_Removing-Individual-Circle-Labels.aspx)

#### Entry 3: -----------------------------------------------------------------

Date: April 23
Start Time: 9:30 am
Duration: 2 hours

Content:
Today, I really needed to get working hardware so that my teammates, who were working on the software, would not face any issues. This began with a visual and close-up inspection of the board I had used the hot plate on, using my eyes and the microscope.

 

I realized that the solder had not melted fully, so only a couple of the components that I needed to be soldered onto the board were properly soldered. Therefore, I needed to manually solder EVERY component onto the board, completing over 1000 solder mounts. I knew this would take a while, so I decided to create a new setup of boards on the soldering station, because I knew that the DIMM connectors would raise the board up slightly, which I needed to avoid.

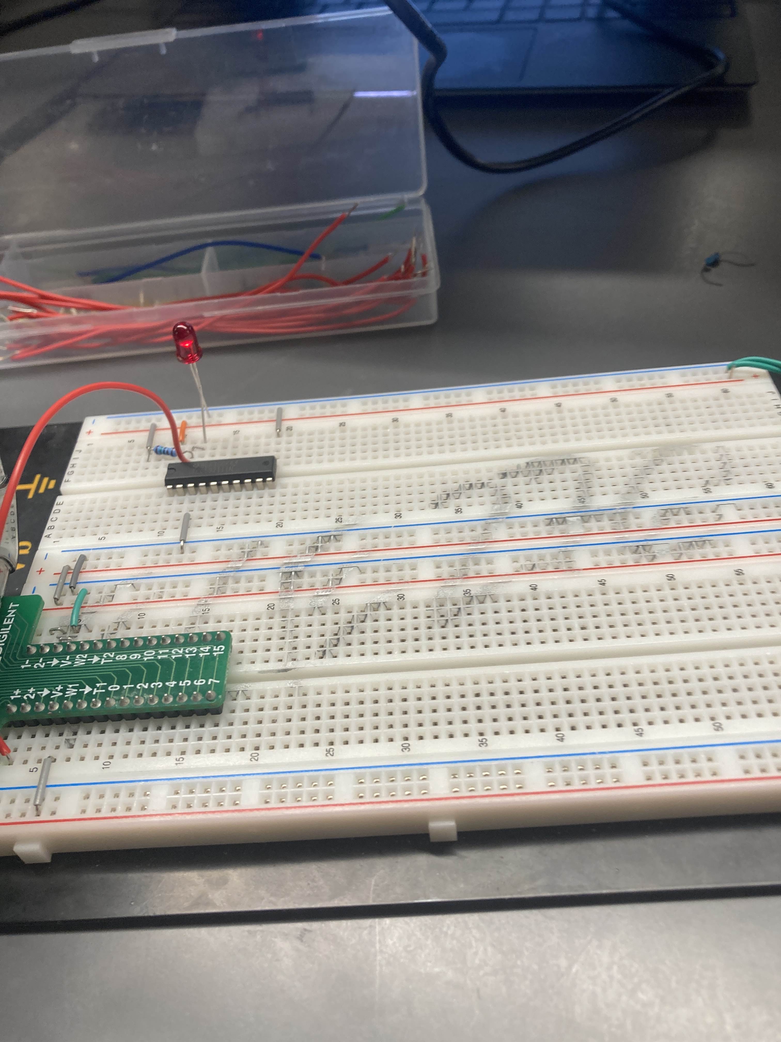
[picture p54: Team/journal/img - member4/week5/3.3.jpg]


The above was accomplished by pre-inserting the DIMM slots and measuring out exactly where the level increase occured. The technique can be seen below, as well as the final result.

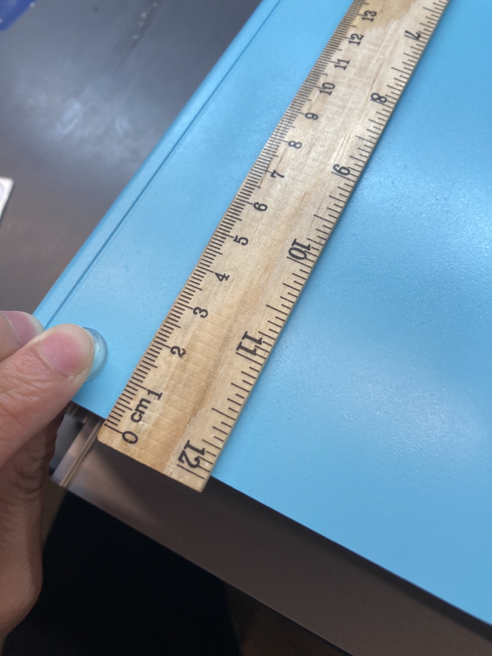
[picture p55: Team/journal/img - member4/week14/3.5.jpg]
 

Then, I got to work soldering. I used the same technique I detailed earlier, trying to work much faster, but the difference was that I was using the WellerX, and the soldering and power output was much better than the other soldering stations in the lab. The first DIMM slot connecting being placed can be seen below, as circled in blue.

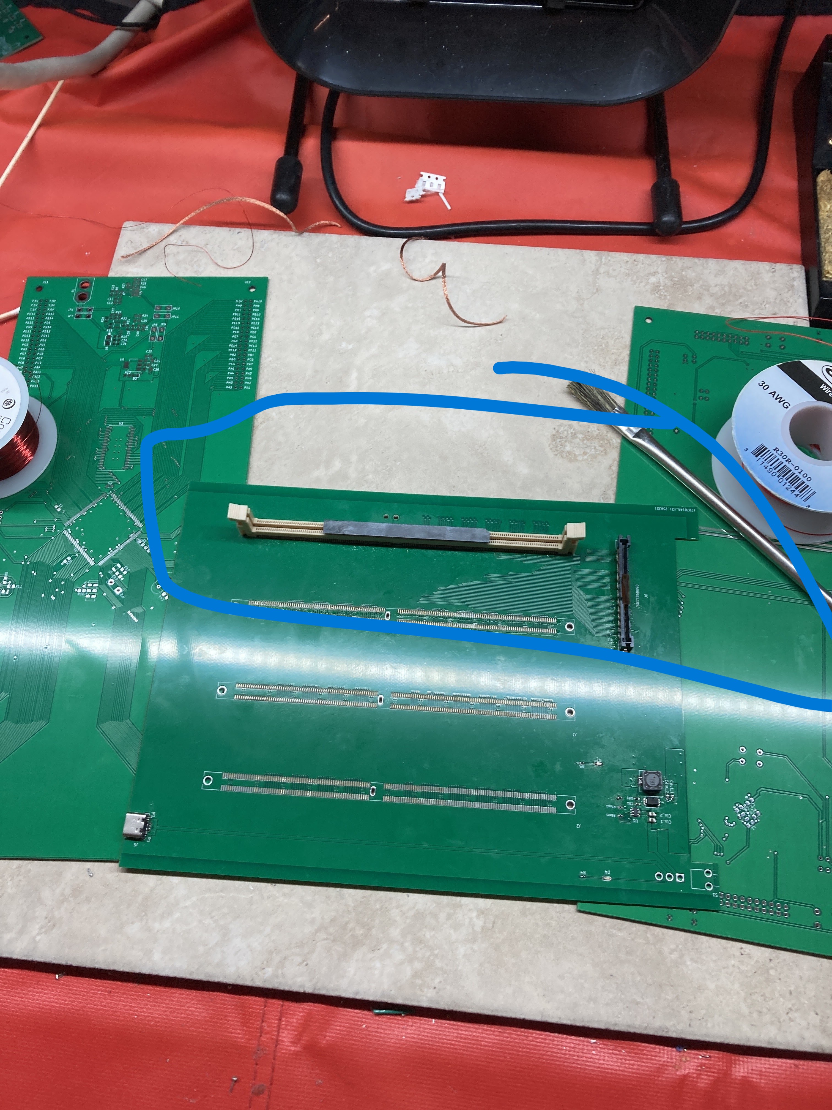
[picture p56: Team/journal/img - member4/week15/3.5.2.jpg]


The second connector was placed, taking the next 30 minutes and following the same procedure.



And the third and fourth DIMM connectors.

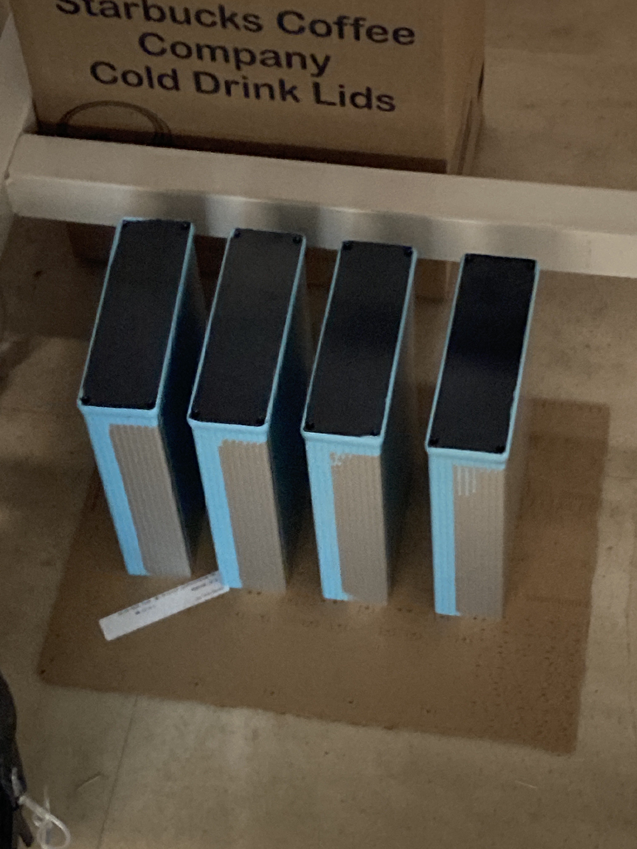
[picture p57: Team/journal/img - member4/week14/3.7.jpg]


I realized there might be some shorts within the board with I did pin by pin, so I used the microscope to get a closer view to see if any shorts existed. If a short did exist, the metal chisel was enough to get rid of the trace, since these traces were so small. I used the information in this (https://electronics.stackexchange.com/questions/16398/find-short-location-on-pcb) location to better find the shorts on the PCB.

 

By going pin by pin again, I was able to find 3 shorts and fix them using the method I described above.
After finishing the final backplane, it was time to solder some USB-C mounts onto two of the cards. Brian and Seth needed these cards so they could program the last PSDR, the connection between the front panel and the cards. Below is a photo of the card without the mount, which needed to be changed. I had to flip the flywire up, just so I could solder around it.

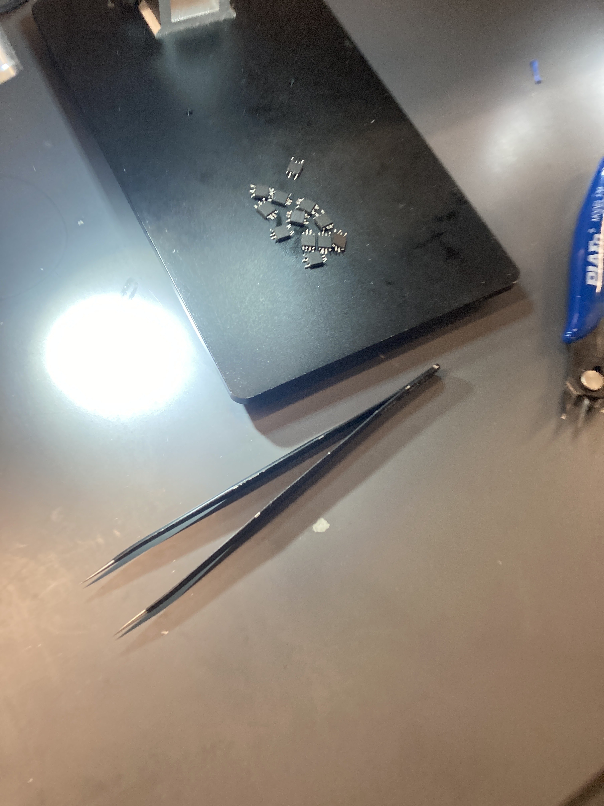
[picture p58: Team/journal/img - member4/week14/3.10.jpg]


I removed one of the legs of the USB-C mount, so that it would not interfere with the flywires or resistors. Below is an image of the new USB-C mount under a microscope.

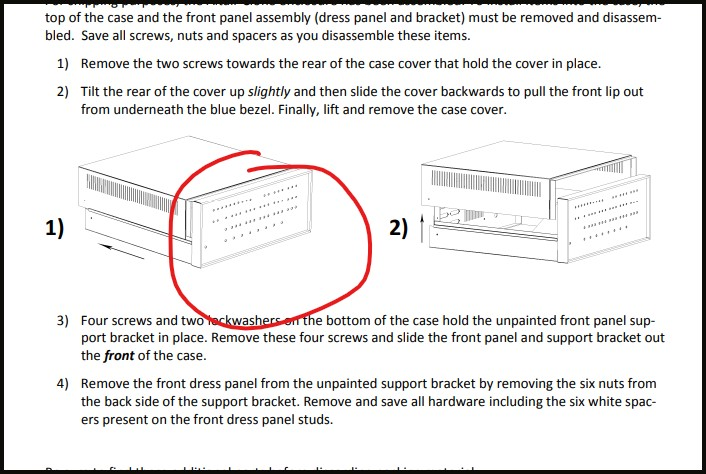
[picture p59: Team/journal/img - member4/week13/3.11.jpg]


I preset the WellerX to an appropriate solder temperature. I had to read the operating manual in order to figure out how to exchange power wires and still maintain proper operation, located here (https://www.weller-tools.com/sites/default/files/products/documents/WE_WX_Units_Manual_EN_FR_ES_T0055746801.pdf).

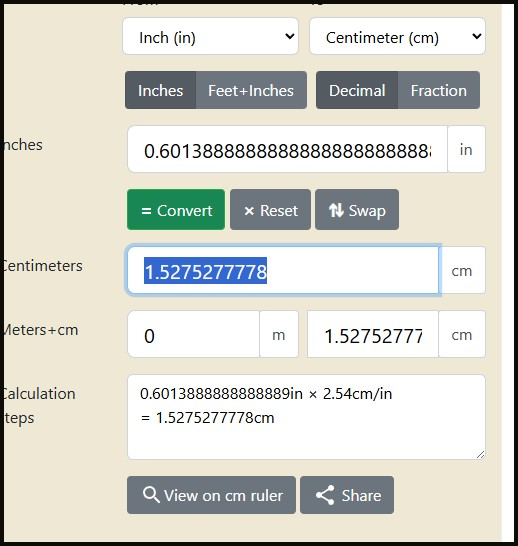
[picture p60: Team/journal/img - member4/week13/3.12.jpg]


I had the two cards to solder shown in the photo below. I got started by placing the card under the microscope, setting the scope, and placing the iron under the microscope to make sure I got a good mount.

 

I applied solder to the places I knew I would need it on the USB-C mount. The process went a lot faster since I now had a better idea of what I was doing.

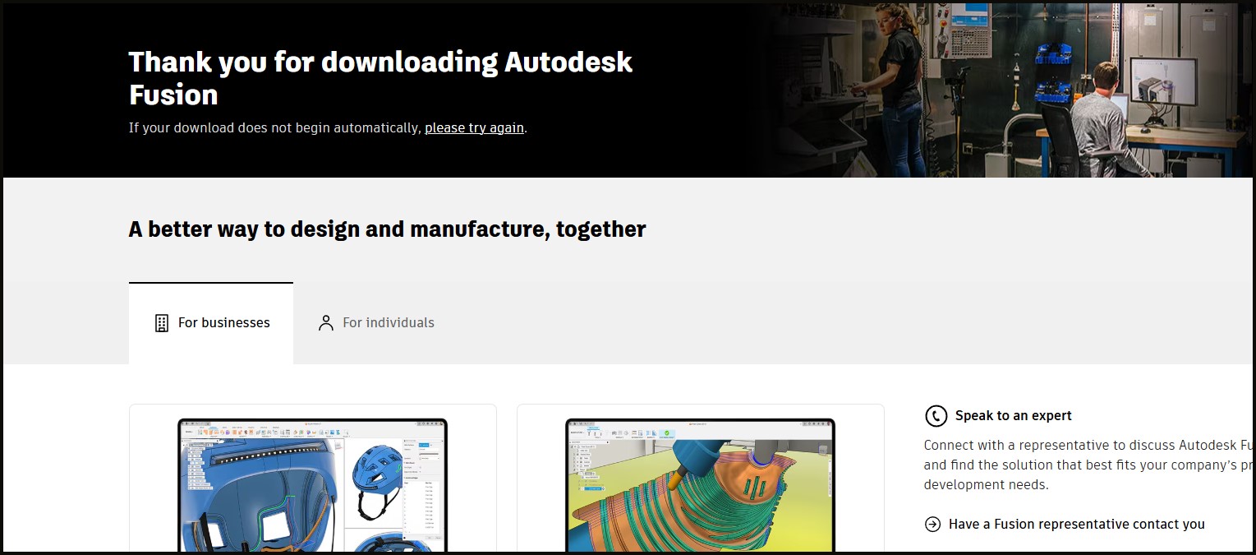
[picture p61: Team/journal/img - member4/week14/3.15.jpg]


I placed the USB-C mount, and soldered it under the microscope by placing my pen onto the flux with a bit of solder, so that it autoset onto the pins. I would move the pen around so that the mounts all set, and any shorts were removed meticulously.

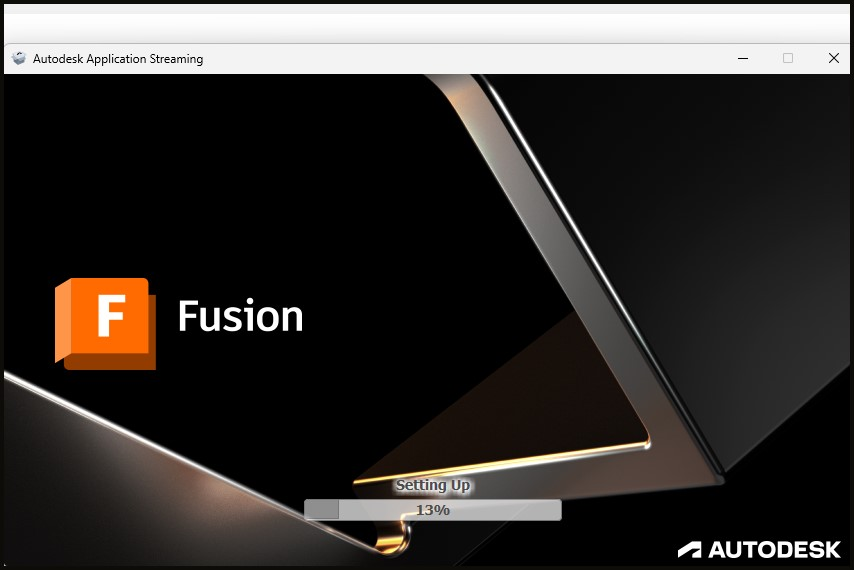
[picture p62: Team/journal/img - member4/week14/3.16.jpg]


The backside (3 mounts) were soldered in the same fashion, by applying flux to the regions of the board, and burning the flux while applying the solder such that it set. Below you can see the final result for one of the boards.



Two 0603 resistors also needed to be mounted onto the PCB. I placed flux onto the board, and melted a bit of solder by placing my pen on those spots with a bit of wire. The four positions can be seen below, circled in blue.

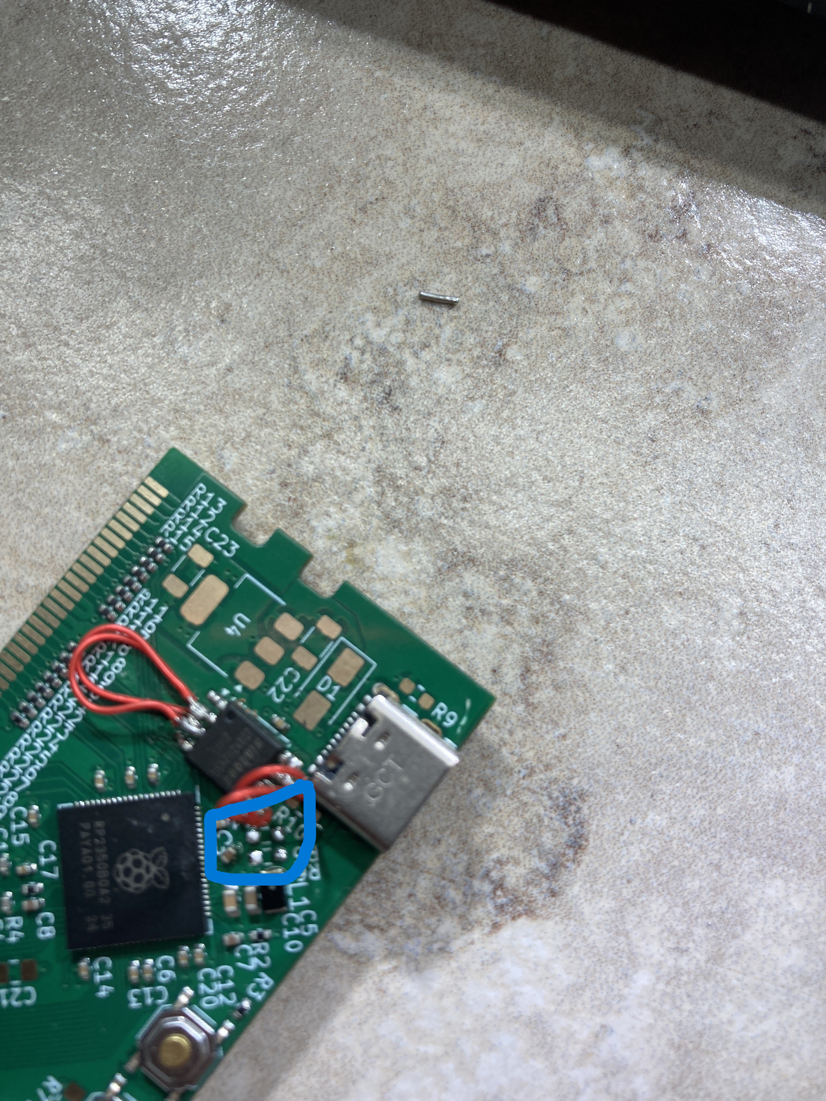
[picture p63: Team/journal/img - member4/week15/3.18.jpg]


I used the Weller Tweezers to mount the resistors on. To do this, I turned on the right side of the weller using the user manual as a guide, and then cleaned off the tweezers. I was able to just pick up the component with the heated tweezers, and touch both flux pads at the same time. Then, I used a second pair of tweezers with my left hand to constrain the other dimension of movement. The whole process looked as below.



And the final result was as below. I gave the finalized product to Brian and Seth so that they could start working on the new card immediately.



I got an email from the shop, saying that the back bezels which I requested were finished. However, I realized I also needed to tap the screw mounts so that the screws would successfully fit in the enclosure we choose. I brought all four enclosures down to the machine shop, where Chuck told me they could get it done.

Today, I focused on soldering and debugging hardware to ensure my teammates working on the software wouldn’t face issues. I started by inspecting the board that had been heated on the hot plate, using both visual inspection and a microscope to identify any issues. I realized that the solder hadn’t fully melted, so I needed to manually solder every component onto the board, totaling over 1000 solder mounts. To make the process easier, I set up a new soldering station with the DIMM connectors pre-inserted, which helped account for the slight height increase caused by the connectors.

Using the WellerX soldering station, I worked efficiently, starting with the hardest components, the 0402 resistors, and continued with the DIMM connectors. The process was much faster with the improved soldering setup. After finishing the first three DIMM connectors, I noticed some potential shorts on the board and used a microscope to inspect each pin. Following advice from this StackExchange post (https://electronics.stackexchange.com/questions/16398/find-short-location-on-pcb), I identified and fixed three shorts using a metal chisel to remove problematic traces.

Once the DIMM connectors were soldered, I moved on to soldering USB-C mounts onto two cards, which were required by Brian and Seth for programming. I carefully soldered the mounts under a microscope to ensure precision. I also had to adjust the WellerX settings, and used the user manual, which I accessed through this link (https://www.weller-tools.com/sites/default/files/products/documents/WE_WX_Units_Manual_EN_FR_ES_T0055746801.pdf), to correctly set the power and maintain proper operation.

During this process, I also mounted two 0603 resistors using Weller Tweezers, which allowed me to pick up the resistors and place them on the PCB with precision. After completing the soldering and ensuring everything was properly connected, I handed over the finalized product to Brian and Seth. Later in the day, I received an email from the shop confirming that the back bezels I requested were finished. However, I realized I needed to tap the screw mounts for proper fitment in the enclosure, so I brought the enclosures to the machine shop, where Chuck assured me they could take care of it.

Citations:
- 1: Find Short Location on PCB - Stack Exchange (https://electronics.stackexchange.com/questions/16398/find-short-location-on-pcb)
- 2: Weller WX Units Manual (https://www.weller-tools.com/sites/default/files/products/documents/WE_WX_Units_Manual_EN_FR_ES_T0055746801.pdf)

#### Entry 2: -----------------------------------------------------------------

Date: April 21
Start Time: 9:30 am
Duration: 2 hours

Content:
Today, I needed to try to paste the final backplane, and do some debugging on the existing backplane. I started by revisitng the setup we had for the first four backplanes, with the PCB stencil. Below you can see the setup, and a working board which was the outcome of using this setup.



I cleaned off the surface and the workspace, and verified that the last backplane was already under the stencil. I also decided to wipe away some of the old solder paste from the station, seen below.



I pulled out some solder paste from the refrigerator, and placed it on the work station. I didn't realize it at the time, but I choose T4 paste instead of T5 paste. This might prove to be detrimental, as I looked up the stark differences here (https://fctsolder.com/solder-paste-type-3-vs-type-4-vs-type-5/). This told me the difference pitch profiles I needed, which might have caused issues.



With that, I began to place the components onto the pasted board again. I became quite effective with it, starting with the hardest components, the 0402 resistors first, as seen below.



I needed some spare components, but luckily Brian put in a parts order and we got everything we needed, seen below.

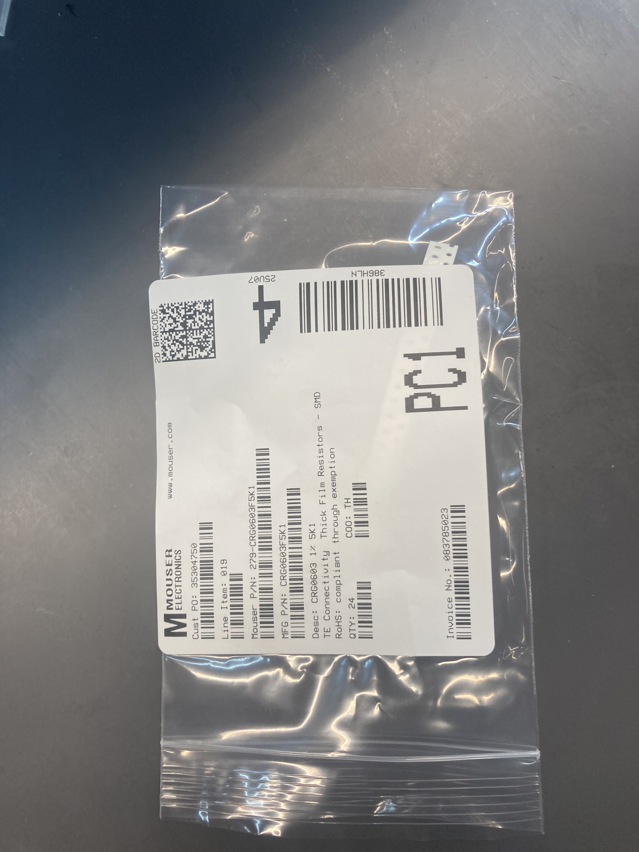
[picture p64: Team/journal/img - member4/week12/2.5.jpg]


I completed the rest of the components, and heated up the hot plate after looking up its specifications here (https://www.obrnutafaza.hr/pdf/mrc/proizvodi/Hotplates.pdf). Then I placed the board on the hot plate, as seen below.

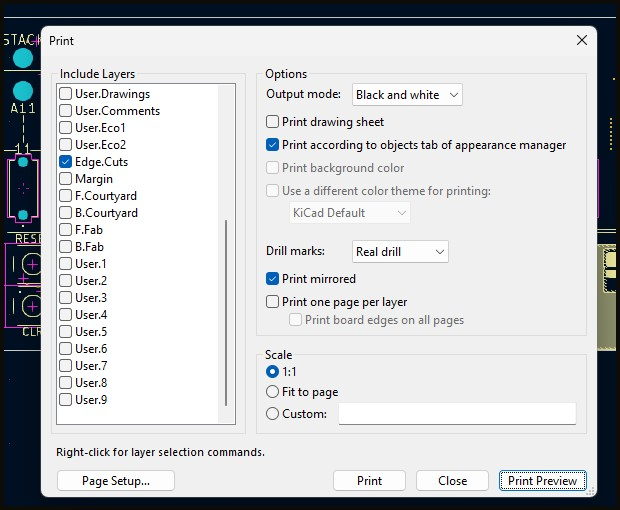
[picture p65: Team/journal/img - member4/week14/2.6.jpg]


After a while, I moved the board to the right side of the board, which was slightly cooler, using the wire crimps to move the board without touching it.



The board came out like below, and I needed to give it like 30 minutes before soldering on it in order to make sure there were no complications.

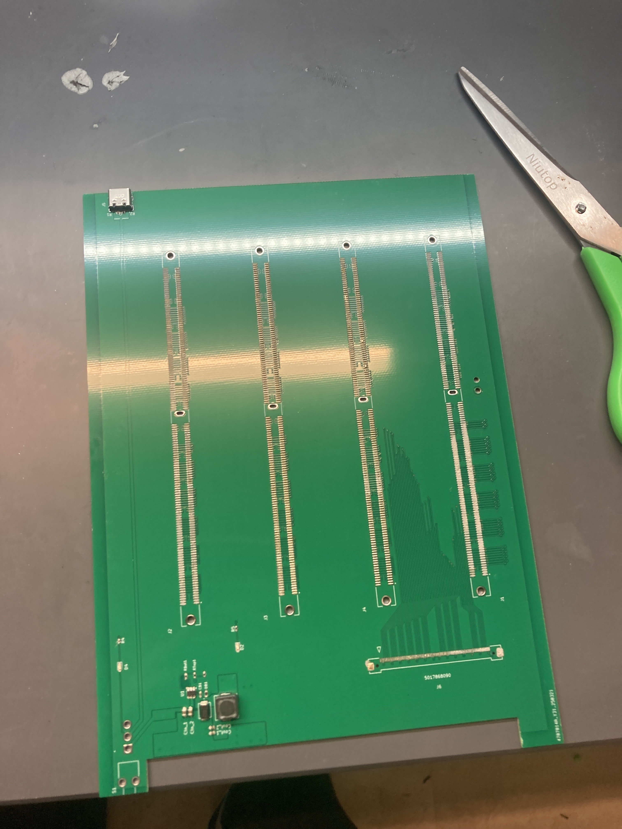
[picture p66: Team/journal/img - member4/week15/2.8.jpg]


In the meantime, I began to debug the A3 signal, which we knew was not 100% working based on some of the traces on the front panel. I took another look at the traces in KiCad, seen below.

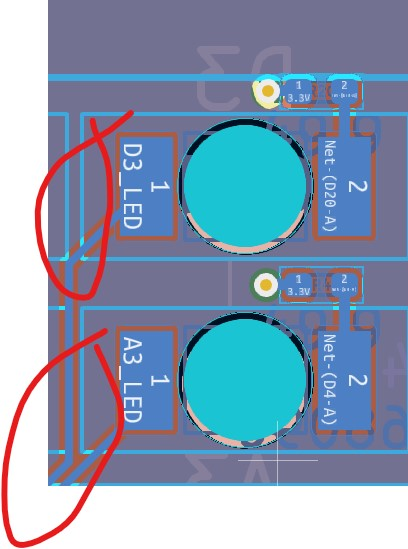
[picture p67: Team/journal/img - member4/week15/2.10.jpg]
 

I realized that it must have been a sink driver issue, so I went to go rework those so it would not cause any future issues when we went to flash the software onto the hardware.
At this moment, Chuck from the machine shop called me saying he needed to talk about the Bezel design. I went downstairs to the machine shop, where he told that he could not get the detail we needed on the switches, and that it would just be one large rectangle when milled out. This was fine, as the switches would fit perfectly either way, and the sticker would cover up and match the black regions well enough so the aesthetic would still be visually pleasing.

Today, I worked on pasting the final backplane and debugging an existing one. I started by revisiting the setup from the previous four backplanes, using the PCB stencil to ensure everything was aligned correctly. After cleaning the surface and workspace, I noticed that I had accidentally chosen T4 solder paste instead of the intended T5 paste. This could be problematic, as I discovered differences in pitch profiles that might cause issues, which I researched on this guide (https://fctsolder.com/solder-paste-type-3-vs-type-4-vs-type-5/).

Despite the potential paste issue, I continued placing components on the board, starting with the hardest ones, the 0402 resistors. Brian also placed a parts order, so we received all necessary components, and I successfully completed the rest of the placement. I then heated the board on the hot plate after reviewing its specifications on this document (https://www.obrnutafaza.hr/pdf/mrc/proizvodi/Hotplates.pdf). Once heated, I moved the board carefully using wire crimps to avoid contact with the hot surface.

After giving the board time to cool, I spent the waiting period debugging the A3 signal, which was known to be problematic due to traces on the front panel. I reviewed the traces in KiCad and suspected the issue was with the sink driver. I began reworking the sink drivers to prevent future issues when flashing the software onto the hardware.

In the meantime, Chuck from the machine shop reached out about the Bezel design. He informed me that the level of detail required for the switches wouldn’t be achievable, and the final product would be one large rectangle. This was acceptable, as the switches would fit perfectly, and the aesthetic would still be visually pleasing with the sticker covering the areas.

Citations:
- 1: Solder Paste Types Comparison (https://fctsolder.com/solder-paste-type-3-vs-type-4-vs-type-5/)
- 2: Obrnutafaza Hotplates Product Catalog (https://www.obrnutafaza.hr/pdf/mrc/proizvodi/Hotplates.pdf)

#### Entry 1: -----------------------------------------------------------------

Date: April 20
Start Time: 12:00 am
Duration: 3 hours

Content:
Today, I needed to get started on creating a vinyl sticker for the front panel. This should be an easy process, and it starts by using Adobe Illustrator here (https://www.adobe.com/products/illustrator/free-trial-download.html) on the lab computers.
I went to the stations in the WALC which had adobe illustrator installed. Before that, I needed to import the proper .SVG file with everything that we wanted on the sticker to show as an illustration. I imported the selected layers below, which made the silkscreen look as below.

 

I uploaded these files to my google drive, and then went to the WALC to get started on the final design. Hopefully I can get it printed on the same day.



One thing I do need to account for is the three pins on the right side of the PCB, when I am milling, so I will add length to the existing rectangle.
I finished the design of the illustrator file, by importing the .svg file into Illustrator and making the appropriate changes to the file. In the end, the .ai file looked as below.

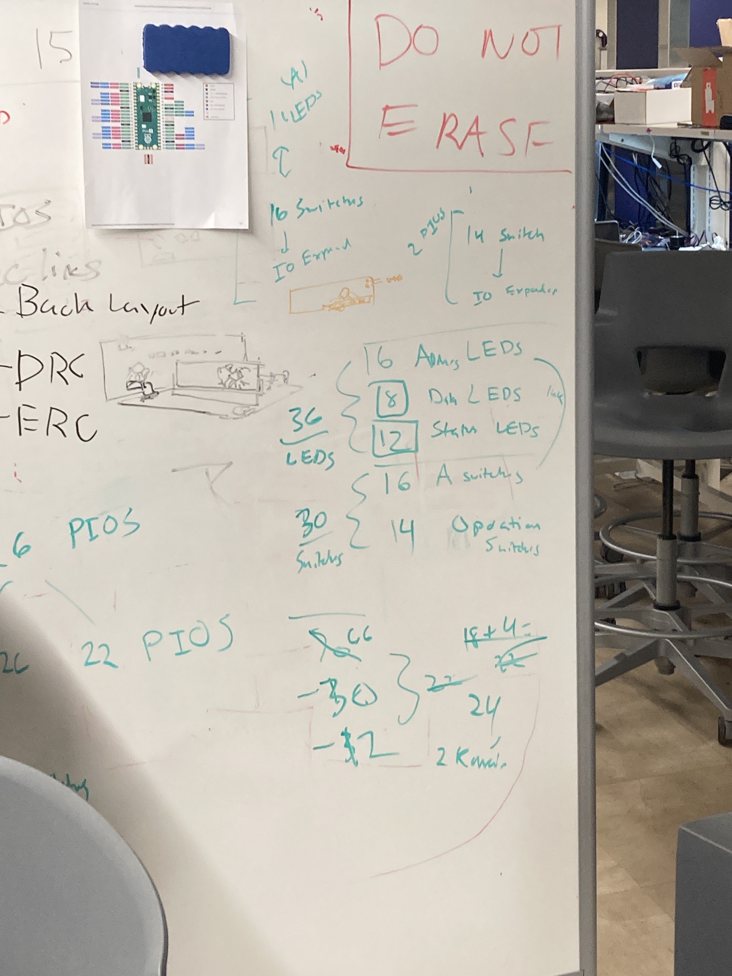
[picture p68: Team/journal/img - member4/week10/1.4.jpg]


The next thing I needed to do was solder the dimm slots onto the backplane. These would hold the cards, and I needed to do at least 3 more for one of the backplanes. As seen from the image below, the paste for the connector had already been pasted, and I needed to add flux and reactivate the solder.



I looked up how to effectively reactivate the solder here (https://www.circuitrework.com/guides/6-3.html), and got to work on each of the 288 connections. I used a special technique to get the connector down before drag soldering, soldering ONLY the top right pin and bottom left pin. In the end, I completed this connector slot, as seen below.



I followed the exact same process for the DIMM connector to the immediate right, which looked as below. The largest issue was keeping the pen at an angle such that it would not burn the plastic. This time, the first solder connection was on the top right and bottom right, seen below.

 

I had to add a lot of flux, an agent to help soldering easier. I looked at this (https://www.protoexpress.com/blog/guide-soldering-flux/) link again, before applying flux to the places seen in the photo below.

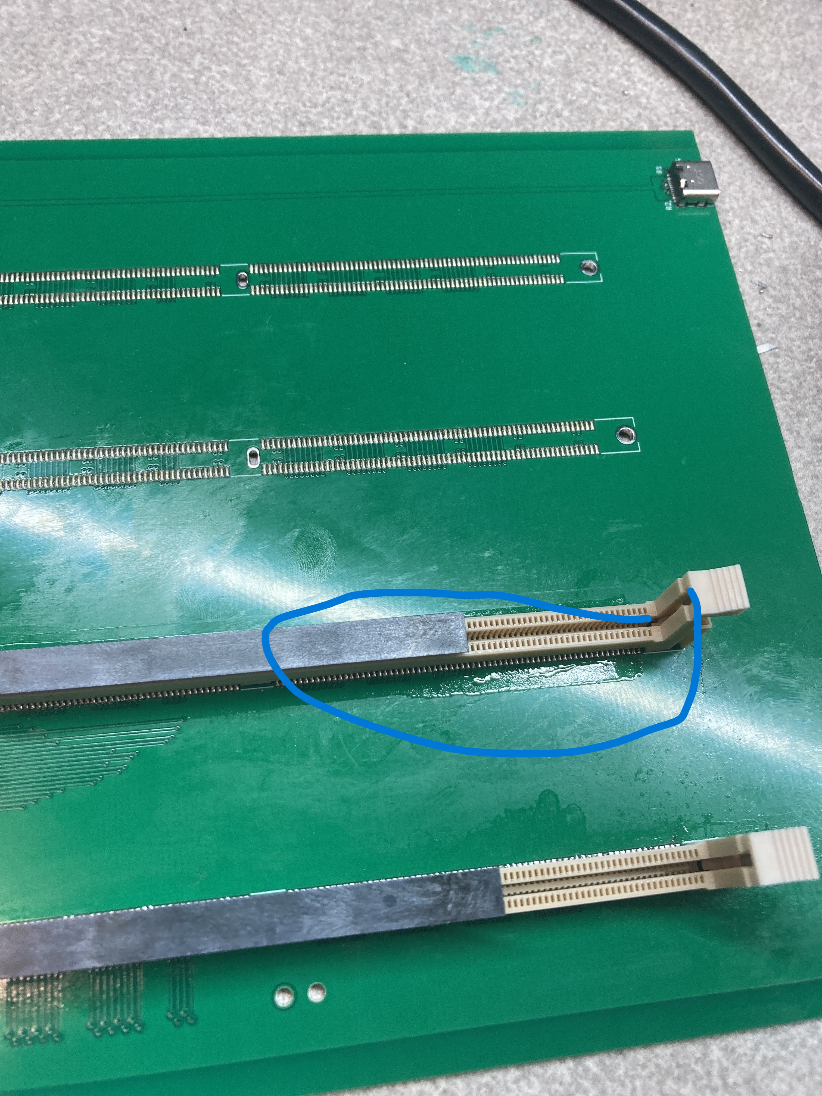
[picture p69: Team/journal/img - member4/week15/1.9.jpg]


One of the most difficult parts of this solder was the fact I had to go pin by pin on such fine pitch mounts, because if we tried to use the oven the entire board would be ruined. This caused quite a bottleneck, as these boards took VERY long.
Another thing that I should mention is that I was moving the pen very very slightly until only a little pressure was applied to each pin. This would cause the pin to be pushed down, and the flux to burn, bonding the agent very well. This was working for a while.



I finished the second DIMM connector and began the flux application on the next board. The flux being added can be seen in the image below.

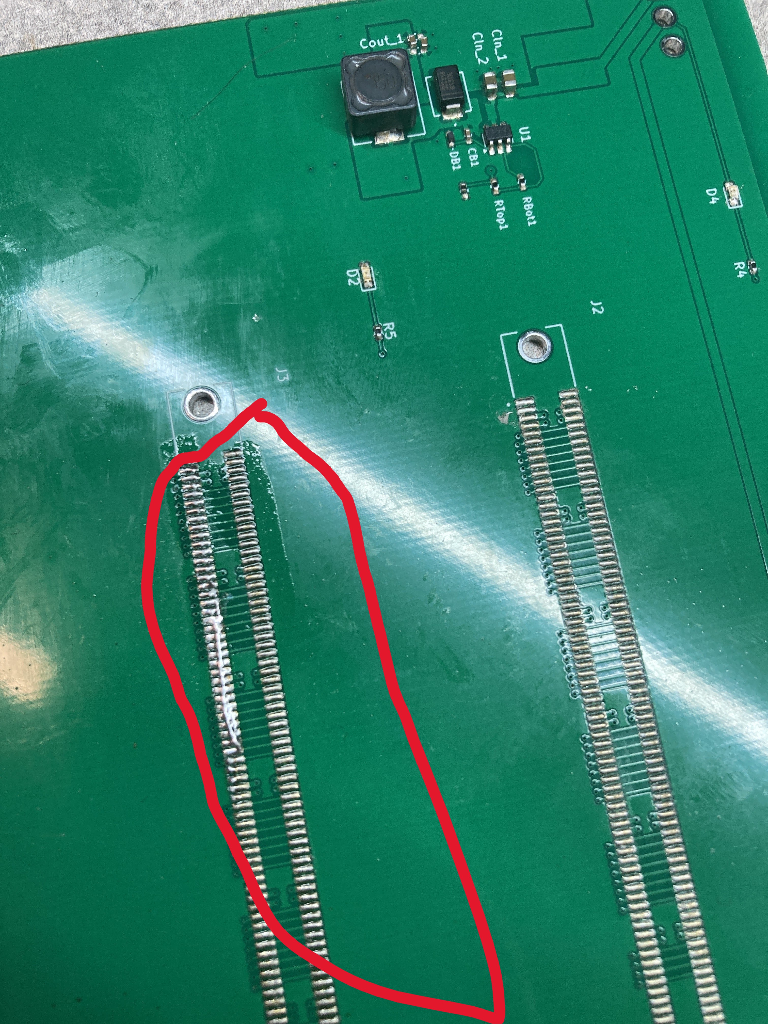
[picture p70: Team/journal/img - member4/week15/1.12.jpg]
 

I got the first half of the DIMM on, before an issue arose. Below you can see the first half of the DIMM, with the proper solder mounts.

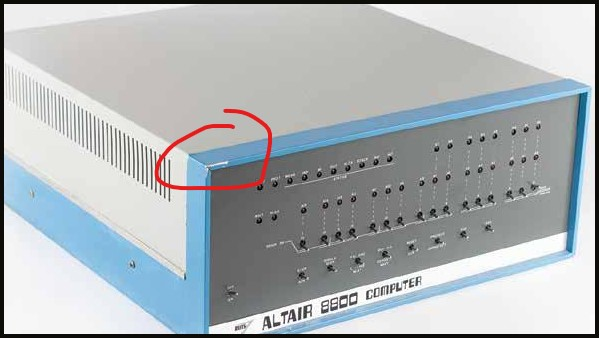
[picture p71: Team/journal/img - member4/week14/1.13.jpg]
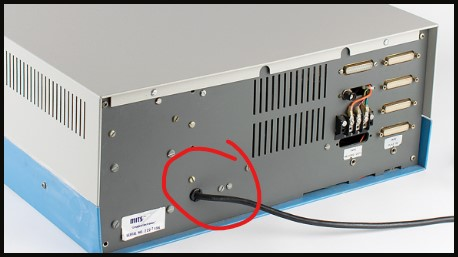
[picture p72: Team/journal/img - member4/week14/1.14.jpg]
 

Some of the solder got stuck too far deep inside the DIMM connector, so I had to take the entire thing off, unfortunately. There was no way around this, since this was an old DIMM connector which I was soldering on, which already had its issue. This was a massive oversight by me, and I had to look on how to desolder with chipquick here (https://electronics.stackexchange.com/questions/438868/smd-desoldering-struggling-to-get-this-chip-quik-stuff-working-what-am-i-doin). This took a while, but I knew I needed to do it.



Some of the chipquick did not work, so I had to just pull the connector out. This was fine, since it was already broken.



After the connector was gone, the board looked as in the following two images. It was reworkable again, but I decided to leave out the third and fourth DIMM connectors, since we didn't need them for the current testing.

 

After this, I quickly talked to Chuck downstairs about the design I wanted milled into the front panel bezel. The image seen below, which is the original design which I wanted, needed to be recreated and scaled in AutoCAD. This process would take a couple days, so the progress on the front panel bezels was slightly slower than I would have liked.

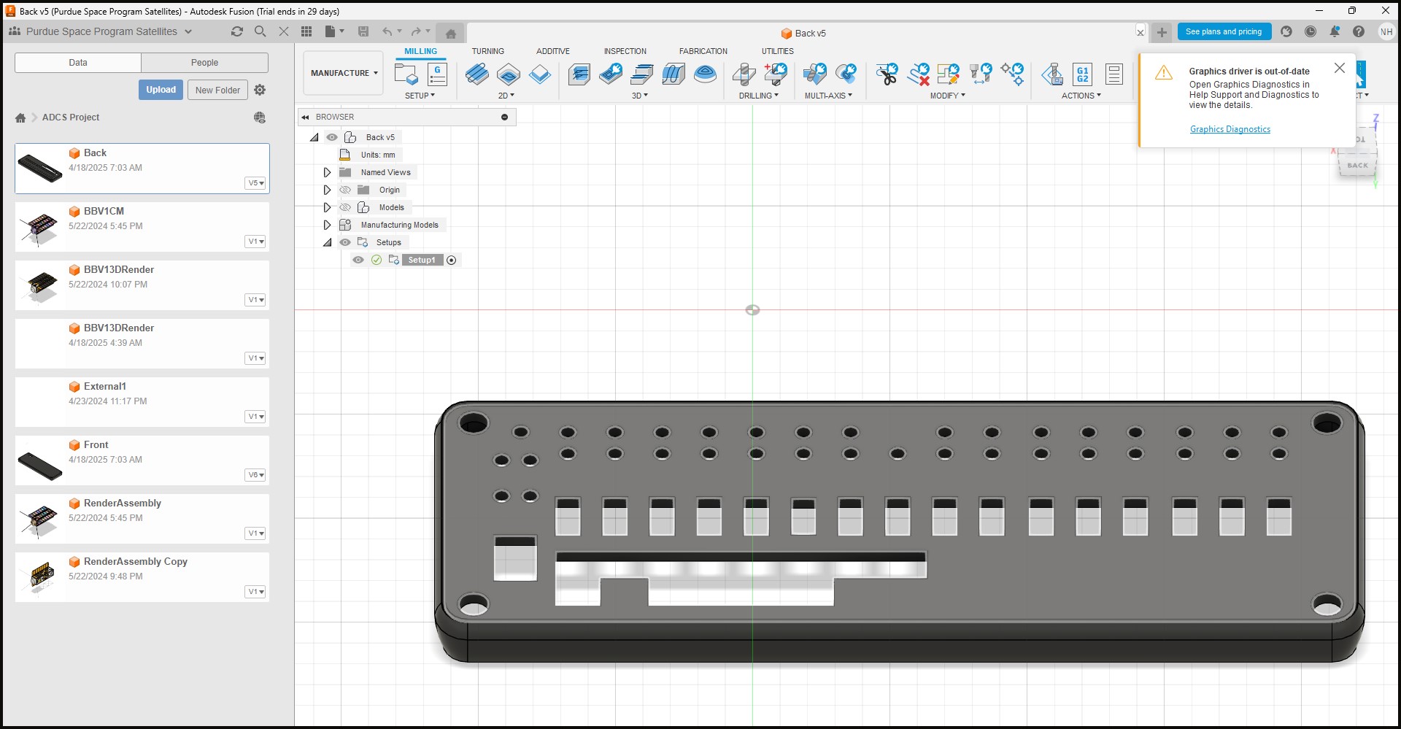
[picture p73: Team/journal/img - member4/week15/1.19.jpg]


After this, I needed to wait on Brian to talk about some hardware issues, especially the modifications we needed to make to the buttons.

Today, I began by focusing on creating a vinyl sticker for the front panel. I used Adobe Illustrator, which I accessed through the lab computers, and imported the necessary .SVG file. After preparing the design, I uploaded the files to Google Drive and proceeded with finalizing the design in Illustrator. The design process is available in the following link: Adobe Illustrator Free Trial (https://www.adobe.com/products/illustrator/free-trial-download.html).

Next, I began working on soldering the DIMM slots onto the backplane. Using a technique of applying flux and drag soldering, I was able to successfully solder the first DIMM connector after some trial and error. I referred to this guide (https://www.circuitrework.com/guides/6-3.html) to learn how to reactivate the solder effectively. Unfortunately, I ran into issues when the first DIMM connector caused a solder bridge, and I had to desolder the whole connector. I researched desoldering with Chip Quik at this StackExchange post (https://electronics.stackexchange.com/questions/438868/smd-desoldering-struggling-to-get-this-chip-quik-stuff-working-what-am-i-doin), but the process was still time-consuming.

Once I resolved the issues with the first DIMM connector, I proceeded to solder the second DIMM slot. I encountered another challenge with the fine pitch, requiring careful attention to the angle of the soldering pen to avoid damaging the plastic. After a few more successful connections, I continued the process with flux application to ensure smooth soldering.

I ran into a major setback when some of the solder was trapped inside the DIMM connector, forcing me to desolder it completely. I eventually pulled out the faulty connector and left the remaining DIMM connectors off the board since they weren't needed for testing at this stage. I updated the team on the situation.

I also discussed the front panel bezel milling process with Chuck, who suggested we recreate the design in AutoCAD for a more accurate result. This slowed down the progress, but I understand the need for precision. The final design was scaled, and we plan to move forward with it in the coming days. Lastly, I awaited Brian’s input on hardware modifications, particularly regarding the buttons on the panel.

Citations:
- 1: Adobe Illustrator Free Trial with Email (https://www.adobe.com/products/illustrator/free-trial-download.html)
- 2: Circuit Rework Guide (https://www.circuitrework.com/guides/6-3.html)
- 3: A Practical Guide to Soldering Flux (https://www.protoexpress.com/blog/guide-soldering-flux/)
- 4: SMD Desoldering - Struggling with Chip Quik (https://electronics.stackexchange.com/questions/438868/smd-desoldering-struggling-to-get-this-chip-quik-stuff-working-what-am-i-doin)

## =============== Week 14: =================

#### Entry 4: -----------------------------------------------------------------

Date: April 17
Start Time: 9:00 pm
Duration: 2.5 hours

Content:
Today, I needed to get started on the desoldering of the front panel buttons, as well as the CAD/CAM models for the back and front bezels. Below is an image of the front panel buttons, of which I need to desolder 52 of the pins so we can reassemble them.



I used the fine tipped soldering tip on the soldering iron, as well as the suction gun. These mounts were large enough to use the gun on. Below is an image of the tools I would use.



The plan is to desolder all of the button pins, and then pull the entire button out at out. We have enough leftover buttons, so thankfully that will not be an issue.
I put the tip at 750 degrees Fahrenheit, and the new tip on, as well as some water in the sponge. Then I got to work.
After about an hour of soldering, I was unsuccessful at pulling out all of the buttons. This may have been because of bad equipment. I pulled the plastic and the metal out with tweezers, but it proved to not be the most effective way to desolder. I might be using a hot air gun in the future.



I decided to just cut some legs on the spot, but that did not leave enough room to properly pull out the button. I used pliers to take out 8 legs from two buttons, as seen below.



In the end, the desoldering was unsuccessful due to a lack of preparation. I will discuss with Brian how to go about the buttons, the final piece of the puzzle, and then we will have a mostly ready project, ready for finishing touches. For now, the progress on the front panel is as below.



Next, I started on the Fusion360 for the front and back bezels.
First, I learned how to upload a .stp file into Fusion360. I did this by creating a new project and importing the .stp file into the directory. I knew that I would need two files, one for the front and one for the back, so I imported it twice. The import and the final result can be seen below.

 

Next, I needed to move the entire bezel down so it was flush with the ground plane. I looked at this tutorial here (https://help.autodesk.com/view/fusion360/ENU/?guid=SLD-USE-MOVE-COPY), and was able to move both the bezels down the ground plane. I also figured out that middle clicking and dragging would move your view, and how to get the position of an object so that I could translate it down. I also learned that shift + middle click could orbit the design.

 

I figured out that Fusion will not save on exit, so you have to manually save, which is quite annoying. I replicated the same translation on the back bezel. Now, it was time to cut out a certain size rectangle out of the design. I looked up this (https://forums.autodesk.com/t5/fusion-design-validate-document/how-can-i-cut-a-custom-shape-out-of-a-shape/td-p/9413686) article about someone else cutting a star out of their shape, and decided to follow a similar procedure. I decided to extrude the shape to get what I wanted.
I got the dimensions of the rectangle I wanted to cut out of the back bezel, which was 8 mm by 11.15 mm. This came from the KiCad file. I also measured the position of the center of the USB-C mount, which was 17 mm away from the side, and 11 mm away from the bottom.

 

I realized that the size of the rectangle may not be sufficient to fit the USB-C connector, so I will scale the entire design up by 1.2, to make sure it fits. The new dimensions will be: 9.6 mm x 13.38 mm. Below is the image of the new rectangle on the CAD design.



If the dimensions of the rectangle are 9.6 mm by 13.38 mm, that means that half of one side is 4.8 mm x 6.69 mm. Therefore, the dimension markings from the side need to be placed at (17 - 4.8) mm and (11 - 6.69) mm, as seen below.



Now that the rectangle is made, I can complete the extrusion. I selected all the necessary components from the backside and did object -> extrude.

 

Since the back bezel was done, I moved onto the front bezel. I saved the back bezel and went to import the svg of the design the laser needed to cut out.
I needed to extrude from object, so I watched this (https://help.autodesk.com/view/fusion360/ENU/?guid=SLD-EXTRUDE-SOLID) tutorial to get the information. I also needed to figure out how to import a .svg into the same design.
First, I needed to export the design I needed into a .svg. Then I could import it into Fusion360. I first exported the layer as svg in KiCad, seen below.



Then, I imported the .SVG into solidworks, making sure the design overlapped what I had already. I overlapped the two designs, making sure there was minimal error. It looked as below.



To extrude, I had to do the annoying thing of selecting all the bodies I wanted to extrude, and then doing the operation. It was tedious, but I got it done and it looked as below.



Now the extrusions were complete, and the designs were ready to go. First, I exported them as three separate file formats:

- Autodesk Fusion Archive (.f3d)
- Drawing Interchangable Format (.dxf)
- .cam file, (.cam360)

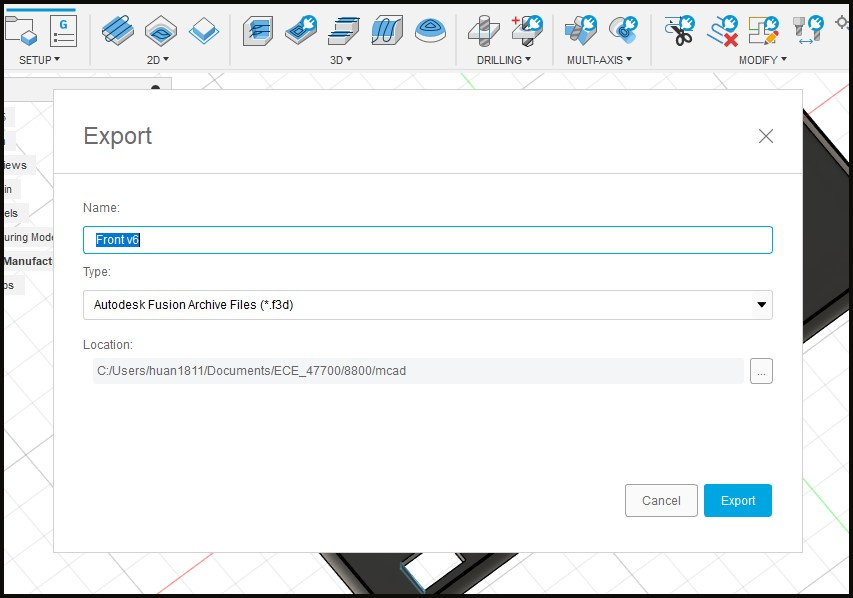
[picture p74: Team/journal/img - member4/week14/4.22.jpg]
   

With the cam files done, I exported the file version and got ready to go to the BIDC. I set up a request to use their CNC milling machine here (https://www.purdue.edu/bidc/os1/project/proposal/7747), which led me to finish the brightspace training. I quickly finished the training, and send my completed model over, as seen below.

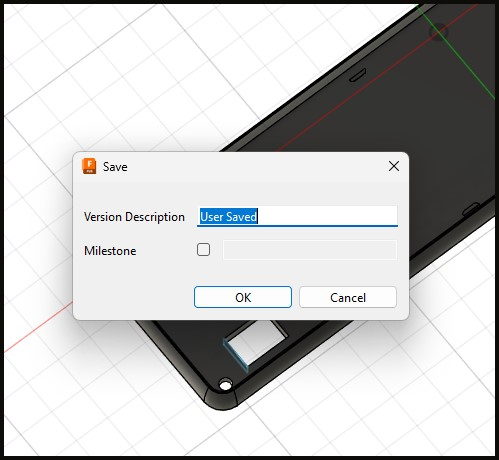
[picture p75: Team/journal/img - member4/week14/4.23.jpg]
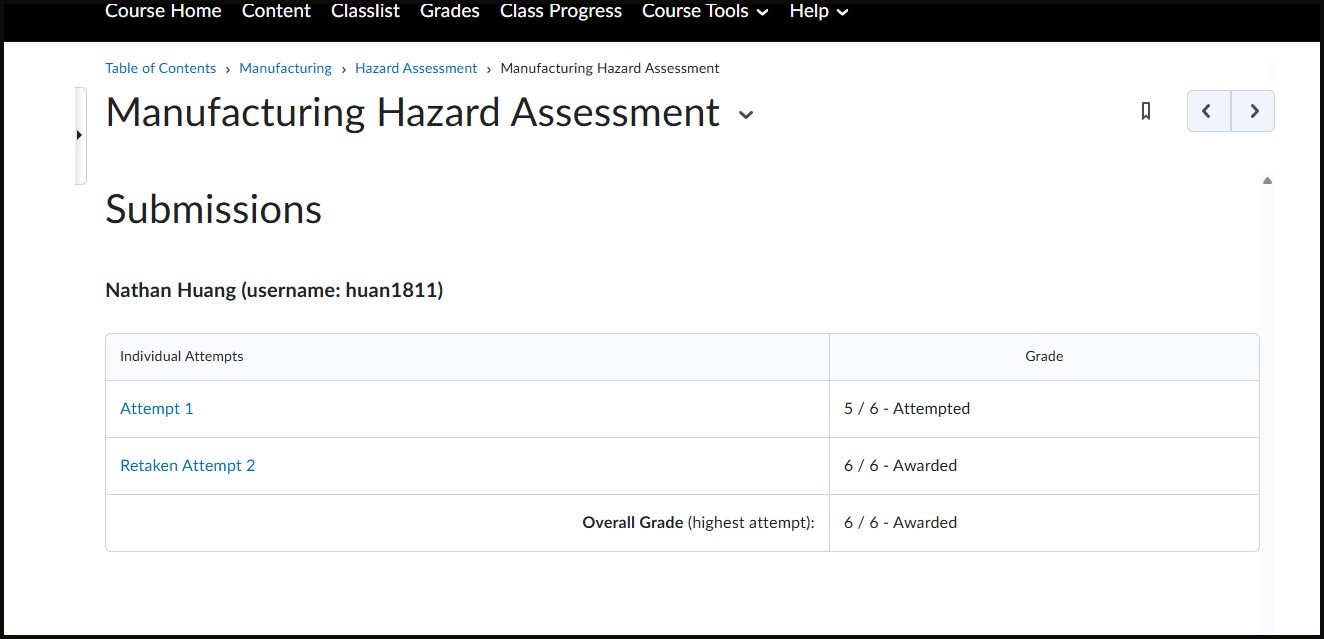
[picture p76: Team/journal/img - member4/week14/4.24.jpg]
 

Today, I focused on desoldering the front panel buttons and developing CAD/CAM models for the front and back bezels. Initially, I attempted desoldering 52 pins from the buttons using a fine-tipped soldering iron set to 750°F and a suction gun. Despite an hour of effort, this method proved ineffective due to difficulty extracting the buttons cleanly. I briefly tried cutting button legs and pulling them out with pliers, but this also had limited success. Going forward, I plan to discuss using a hot-air rework station or alternative techniques with Brian to simplify the process.

Afterwards, I began working with Fusion360, importing two separate .stp files for the front and back bezels. Following this Fusion360 guide (https://help.autodesk.com/view/fusion360/ENU/?guid=SLD-USE-MOVE-COPY), I learned to move and align components precisely within the software. I then measured and cut out an opening on the back bezel for the USB-C connector, adjusting dimensions to 9.6 mm by 13.38 mm for adequate clearance. The positioning was based on measurements from the KiCad layout.

Next, I imported the front panel design from KiCad as an .svg file and aligned it accurately onto the front bezel model in Fusion360, guided by this tutorial (https://help.autodesk.com/view/fusion360/ENU/?guid=SLD-EXTRUDE-SOLID). After meticulously selecting each body, I completed the extrusion cuts to finalize the CAD models.

With the CAD models ready, I exported them into three different formats: Autodesk Fusion Archive (.f3d), Drawing Exchange Format (.dxf), and CAM (.cam360) files. Finally, I submitted a CNC milling request to the BIDC facility through their online platform (proposal link (https://www.purdue.edu/bidc/os1/project/proposal/7747)), completing the required Brightspace training, and uploaded the finished CAM files in preparation for fabrication.

Citations:
- 1: Fusion 360 Help: Move or Copy Geometry (https://help.autodesk.com/view/fusion360/ENU/?guid=SLD-USE-MOVE-COPY) - 2: Extrusion in Fusion360 (https://forums.autodesk.com/t5/fusion-design-validate-document/how-can-i-cut-a-custom-shape-out-of-a-shape/td-p/9413686) - 3: Object extrusion in Fusion360 (https://help.autodesk.com/view/fusion360/ENU/?guid=SLD-EXTRUDE-SOLID) - 4: BIDC Guidelines (https://www.purdue.edu/bidc/os1/project/proposal/7747)

#### Entry 3: -----------------------------------------------------------------

Date: April 16
Start Time: 9:30 am
Duration: 2 hours

Content:
Today, I focused on more hardware manufacturing was well as the physical enclosures. First, I removed all of tape from the existing enclosures, to see if the paint had fully dried. It looked like it did, from the images below. I also removed the painter's tape from the plastic bezels.

 

Dr. Walter came by during the mandatory lab session, where we got another checkoff for the I/O expanders as seen in the photo below. One of the biggest concerns we reported to him was the amount of manpower it would take to solder all of the back planes.



I checked the time it would take the paint to fully dry, which was on the container of the spray paint can. I also checked online at this link (https://www.thespruce.com/how-long-does-it-take-spray-paint-to-dry-7486380), which matched up with the estimate from the can.



After the boxes were all unboxed as seen in the photo below, I decided to add the rubber feet which came in the enclosure packages. I first decided to make them 1 cm away from the corners, but that resulted in the plastic bezels not fitting onto the enclosure. Thus, I spaced them out to be 1 inch away from the corners, as seen in the second image. I was aiming to get the position close to what we saw in the enclosure documentation here (https://www.hammfg.com/electronics/small-case/extruded/1455), which I realized might not be possible to get it pixel perfect.

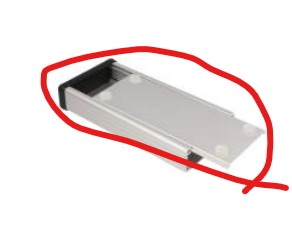
[picture p77: Team/journal/img - member4/week14/3.6.2.jpg]
  

The new spacing worked perfectly, and the boxes were starting to look like the original Altair, which we were going off of here (https://americanhistory.si.edu/collections/object/nmah_334396)



I messed up the back panel a little bit due to the fact that some of the solder decided to bridge and the pen was unable to get it off, so I believe I will need to be more patient next time when applying the solder and drag soldering, even going to the extents of doing it one pin at a time. Below you can see the bridged mounts on the FFC.



Next, I created bends in the flash chips so that we could solder the proper pins into the card PCBs, because they were reverse in the schematic and we had to deal with the fallout when the PCBs were ordered. I had 10 to make, as seen in the below photo, and I successfully changed the orientation of the legs, as seen in the photo to the right.

 

Then, I went to ACE hardware to return the usused can of spray paint and try to get the plastic bezels engraved. I grabbed the second can and returned it promptly, as seen in the photos below.

 

After this, I went to BIDC to try to get the bezels engraved, but it turned out they were closed, and I needed to schedule an appointment with the BIDC center. After this, I went to the machine shop, but they were also closed. Hopefully the machine shop has something for me, so I don't need to schedule things with Bechdel.



I helped with the soldering of the new QSPI Flash chips onto the cards, which I organized and checked for non-continuity at the mounts, before organizing them and placing them under the table, as seen in the image below.



Next, I needed to download Fusion360 here (https://www.autodesk.com/products/fusion-360/appstream) and Adobe Illustrator here (https://www.adobe.com/products/illustrator/free-trial-download.html). I had already used an existing trial of Adobe illustrator in the past, so I think I would have to go to one of the WALC computers in order to use it.

 

The new plan for the front panel details would be to mill out a design from the front and back bezels, and then print out a vinyl sticker from the knowledge lab in order to paste on top of the the front bezel. This would allow us to exactly replicate the original design, which is what we are intending. I looked up how if Adobe Illustrator could import .svg files, which it could here (https://www.adobe.com/creativecloud/file-types/image/vector/svg-file.html)
I needed to leave to attend a meeting, but I will pick up the work during my next work session, starting with Fusion360.

Today, I continued work on hardware manufacturing and enclosure preparation. I began by removing all painter’s tape from the aluminum enclosures and plastic bezels, confirming that the paint had fully dried. The results looked clean and matched expectations. During our mandatory lab session, Dr. Walter reviewed our progress and checked off the functionality of the I/O expanders. One of our concerns discussed was the time and manpower required to complete soldering on all the backplanes.

To confirm drying times, I referenced the spray paint can and verified the estimate with this guide (https://www.thespruce.com/how-long-does-it-take-spray-paint-to-dry-7486380) on spray paint drying. Once the boxes were unboxed, I installed rubber feet onto each enclosure. Initially, I placed them 1 cm from the corners, but this prevented the bezels from fitting properly. Adjusting to a 1 inch offset solved the issue, aligning with placement recommendations from the Hammond enclosure documentation (https://www.hammfg.com/electronics/small-case/extruded/1455). The boxes are now beginning to resemble the original Altair design, as seen in this reference (https://americanhistory.si.edu/collections/object/nmah_334396).

While soldering a back panel, I ran into an issue with solder bridging on the FFC mounts. I realized I needed to slow down and consider soldering each pin individually to avoid short circuits. Additionally, I corrected the pin orientation on ten QSPI flash chips by bending their leads—an adjustment made necessary by a schematic error in our PCB design. I also made a trip to ACE Hardware to return unused spray paint and attempted to engrave bezels, but both BIDC and the campus machine shop were closed. I will need to schedule time with either facility soon.

Back in the lab, I helped solder QSPI chips to the cards, verified continuity, and stored the completed boards properly. I then prepared to begin the next phase of front panel detailing. To do this, I downloaded Fusion 360 (https://www.autodesk.com/products/fusion-360/appstream) and attempted to access Adobe Illustrator (https://www.adobe.com/products/illustrator/free-trial-download.html). Since my free trial had expired, I plan to use the WALC computers to access Illustrator.

Citations:
- 1: Duration it takes spray paint to fully dry (https://www.thespruce.com/how-long-does-it-take-spray-paint-to-dry-7486380)
- 2: Rubber feet positioning (https://www.hammfg.com/electronics/small-case/extruded/1455)
- 3: Fusion 360 Documentation (https://www.autodesk.com/products/fusion-360/appstream)
- 4: Adobe Illustrator documentation (https://www.adobe.com/products/illustrator/free-trial-download.html)
- 5: here (https://www.adobe.com/creativecloud/file-types/image/vector/svg-file.html)

#### Entry 2: -----------------------------------------------------------------

Date: April 14
Start Time: 9:30 am
Duration: 3.5 hours

Content:
Today, I got to lab and went to check on the paint. I removed some of the painter's tape on one of the front panel bezels, just to inspect it, and it came out perfectly. Below you can see an image of what it looked like.



After thinking about how they came out, I realized that I maybe should have waited on painting the bezels, based on the plan I had for the entire front panel bezel.
I looked at the silkscreen of the front panel, trying to think of a way to print out the front panel so that we could laser engrave it with the front panel design we desired. After turning off all of the unnecessary layers, I came out with the following image, which I send to the printer.

  

The following layers were selected:

- F.silkscreen
- F.Edge.Cuts
- F.Courtyard

I also removed the layers of tape on one of the enclosures, and it came out pretty well. I still need to wait 4 more days for the paint to dry completely. Below is an image of what the enclosure looks like.



In the meantime, I got more layers of the KiCad layout, and I cut out on of the papers after marking some measurement marks on a few. I talked to Shivam, who recommended we use the laser in BIDC to get the intended design onto our front and back panel bezels. I also printed out an example back panel bezel just so I could know what it looked like, seen in the images below. I also made sure to mirror the back panel bezel so that it actually matched up with the final physical version.

  

I was concerned that the paint might peel, so I looked up the conditions and images of psray paint peeling here (https://www.behr.com/consumer/how-to/interior/how-to-repair-peeling-paint), just for reference I will have to talk with the Machinist in the ECE building later to see if he can laser the bezels without me having to go to BIDC. Otherwise, I will likely have to go to BIDC. In the meantime, I needed to get another back panel ready for baking, by setting the PCB stencil on all sides.
I talked to the machinist about laser engraving the bezels, which he said he did not have the capability to do. I put in a work order for him to etch out the design for the back panel, which would be just the one slot.
After I got back to lab, I decided to solder paste the backplane. I used a technique where I would go over it once and then go back in order for all of the solder to stick to the backplane mounts. Then, I put all of the components onto the backplane.
Resistors and ceramic capacitors were not polarized, so I started with those. An image of the non-polarization can be found below. I also found the information from this (https://www.protoexpress.com/kb/component-orientation-and-polarity/) source



Then, I put on the diodes and other polarized components using the existing backplane as a guide. I placed the PCB stencil and spent a lot of time trying to get all of the edges aligned. I knew that if I was even a millimeter off, the PCB was not going to come out how I wanted it too. The two major points I used for this were the entire buck converter region and the USB-C connector region. Again, a lot of time was spent to make sure the stencil was aligned, given how many mounts we needed to make. Below, you can see an image of the completed stencil.



Afterwards, all the solder paste was added to the backplane, which made it look like below. I followed a special method for pasting the board, by applying ONLY one coat on the long edge of the board, and then going back the other way to make sure that every single pad was coated. I only did this for one layer, because as I discovered before, two or more layers would cause bridges between the solder, which we did not want.

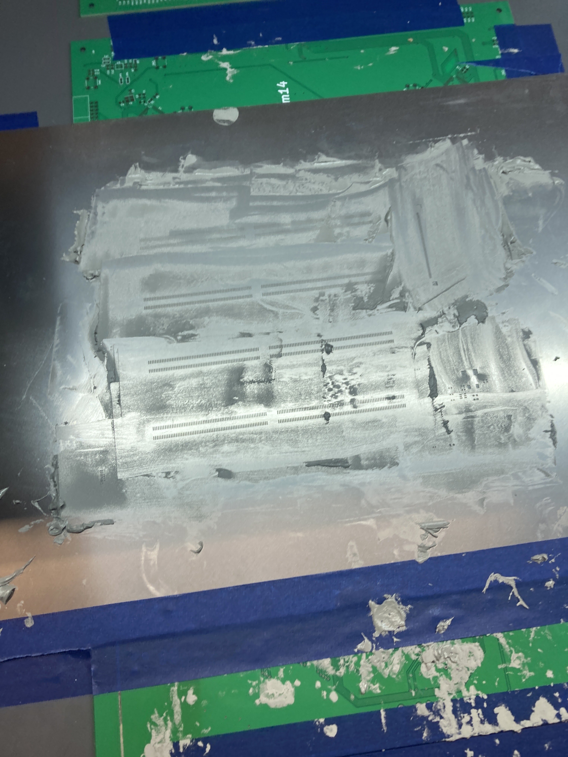
[picture p78: Team/journal/img - member4/week14/2.11.jpg]


All the necessary components were populated, being all of the buck converter items and the USB-C mounts as well as the resistors. In the photos below you can see the proper placements of the items.

 

On the way to placing all of the components, I accidently lost on of the 0402 resistors. I looked up how small it was here (https://www.rohm.com/electronics-basics/resistors/chip-resistor-specifications), and spent 30 minutes searching for it, but never found it. I think that the 0402s are just way to small. After this I needed to switch to a new pair of tweezers to complete the rest of the components.

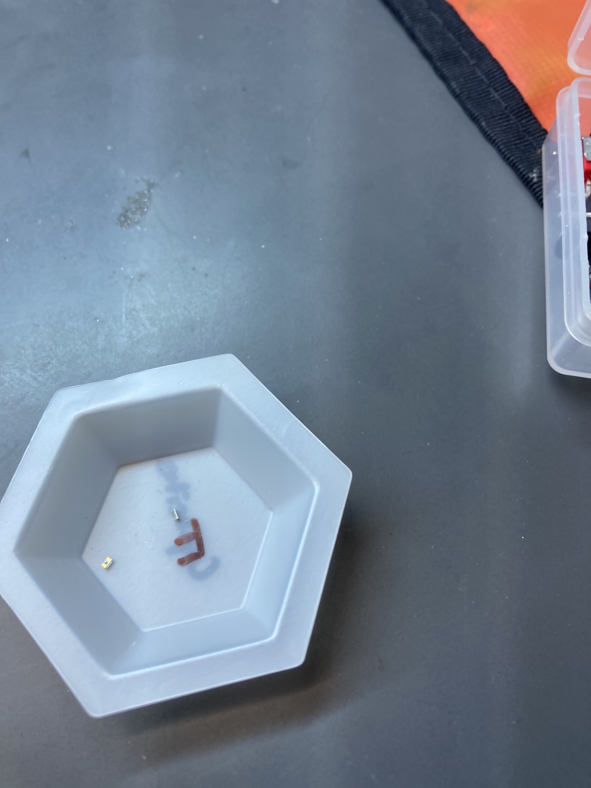
[picture p79: Team/journal/img - member4/week14/2.14.2.jpg]
 

I cleaned up the stencil and the table after completing the pasting, as seen in the below image.

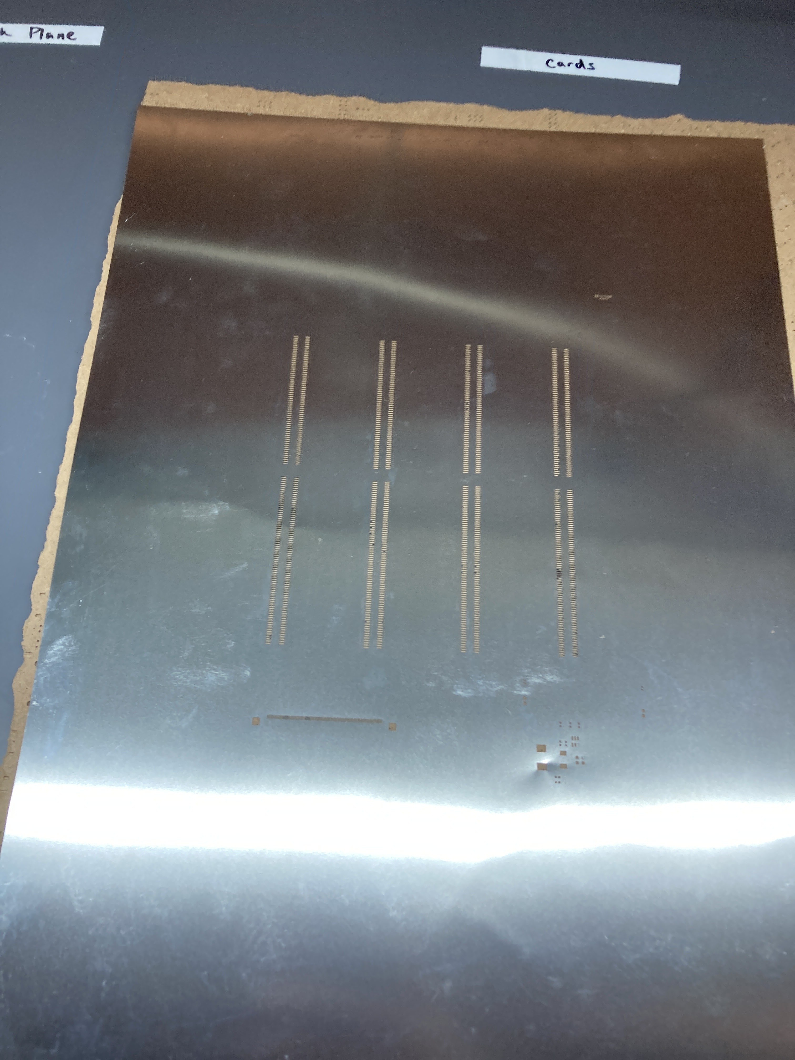
[picture p80: Team/journal/img - member4/week14/2.15.jpg]
 

After this, I created a new stencil layout, removing all of the existing tape and paste off of the old stencil, and placing the new one on top of the new board, following the rules and regulations I developed before. The outcome can be seen below.

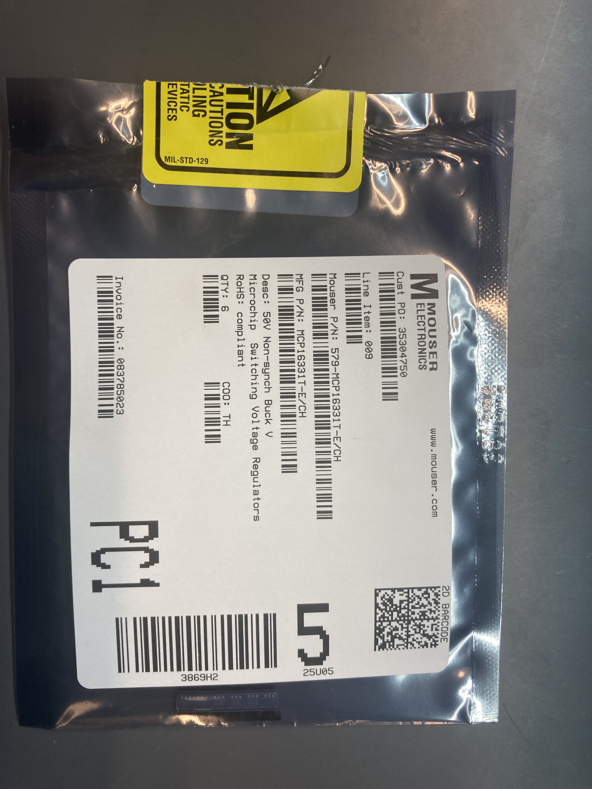
[picture p81: Team/journal/img - member4/week12/2.18.jpg]
 

I wanted to use the gloves for spreading the solder paste, but I had got them wet before, and I looked up this article (https://www.indium.com/blog/humidity-and-solder-paste-do-not-mix.php) on the effects of using solder paste with water. Because it decreases viscosity and performance, I decided against doing it. Below is an image of the wet gloves.

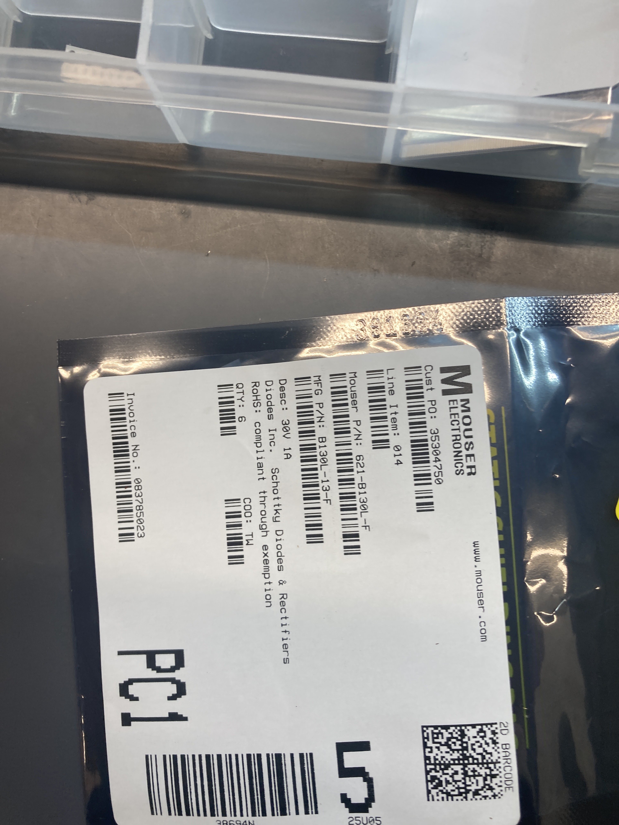
[picture p82: Team/journal/img - member4/week12/2.19.jpg]


I continued to place the components that were necessary on the backplane. Below is an archive of all of these components, also found on our website here (https://engineering.purdue.edu/477grp15/Files/references.html):
The buck converter and the position of the buck converter:

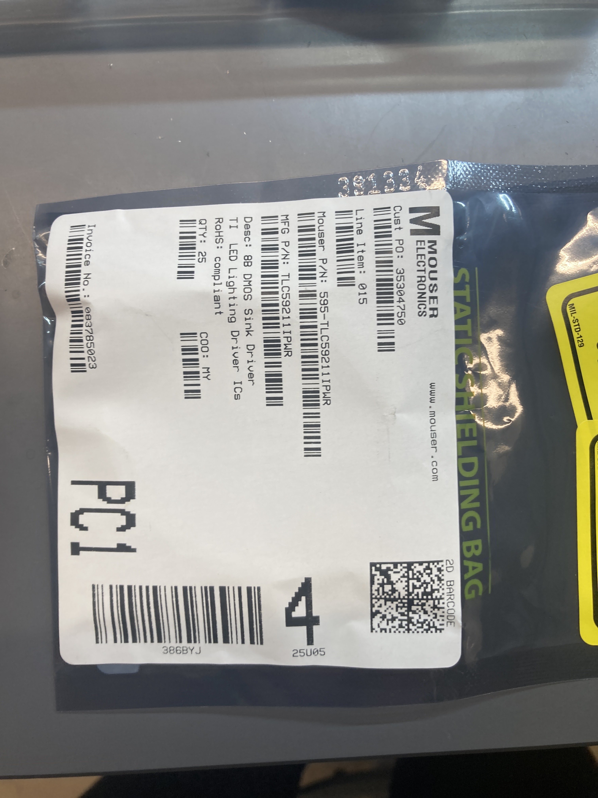
[picture p83: Team/journal/img - member4/week12/2.20.jpg]
 

The USB-C mount and the 5.1k resistors around the USB-C mount:



The debugging diodes on the backplane:



The drum inductor for the power converter:



Capacitors, resistors, and diodes around the buck converter:

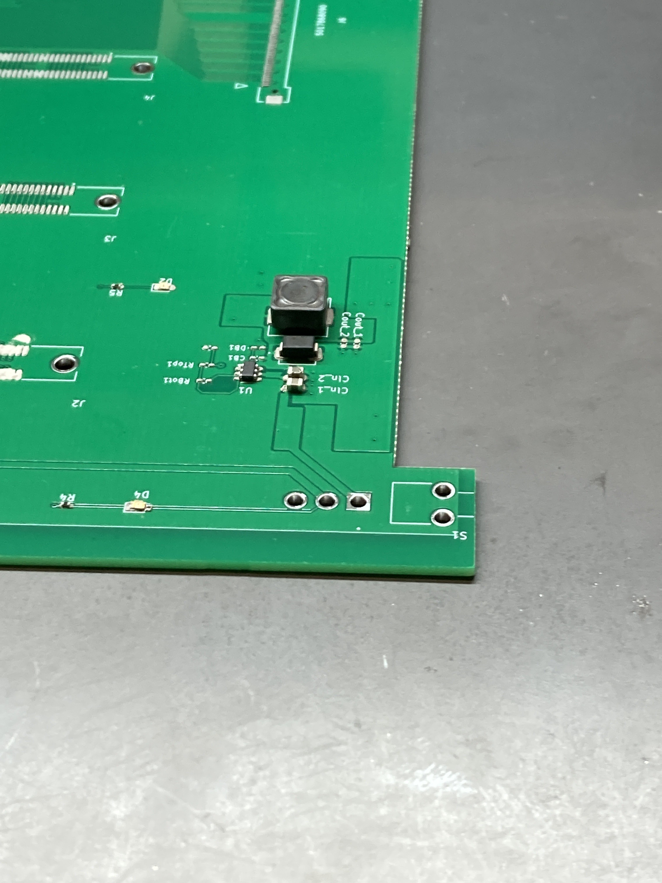
[picture p84: Team/journal/img - member4/week14/2.25.jpg]
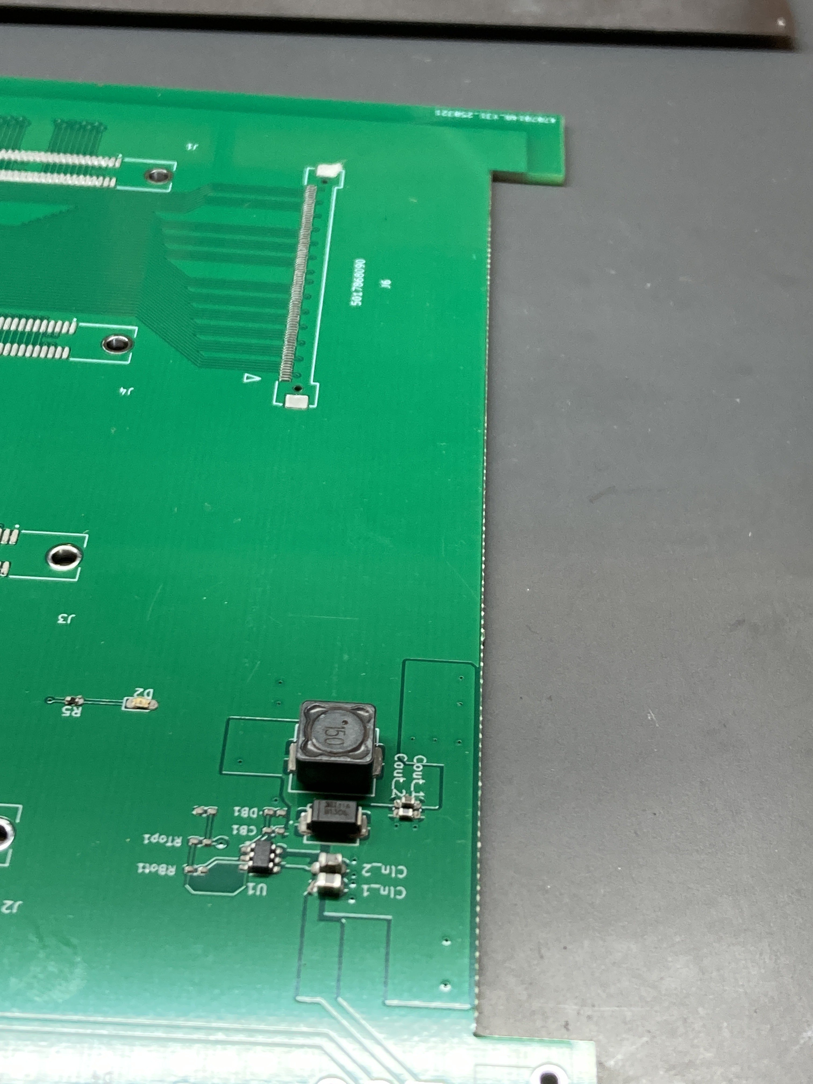
[picture p85: Team/journal/img - member4/week14/2.26.jpg]
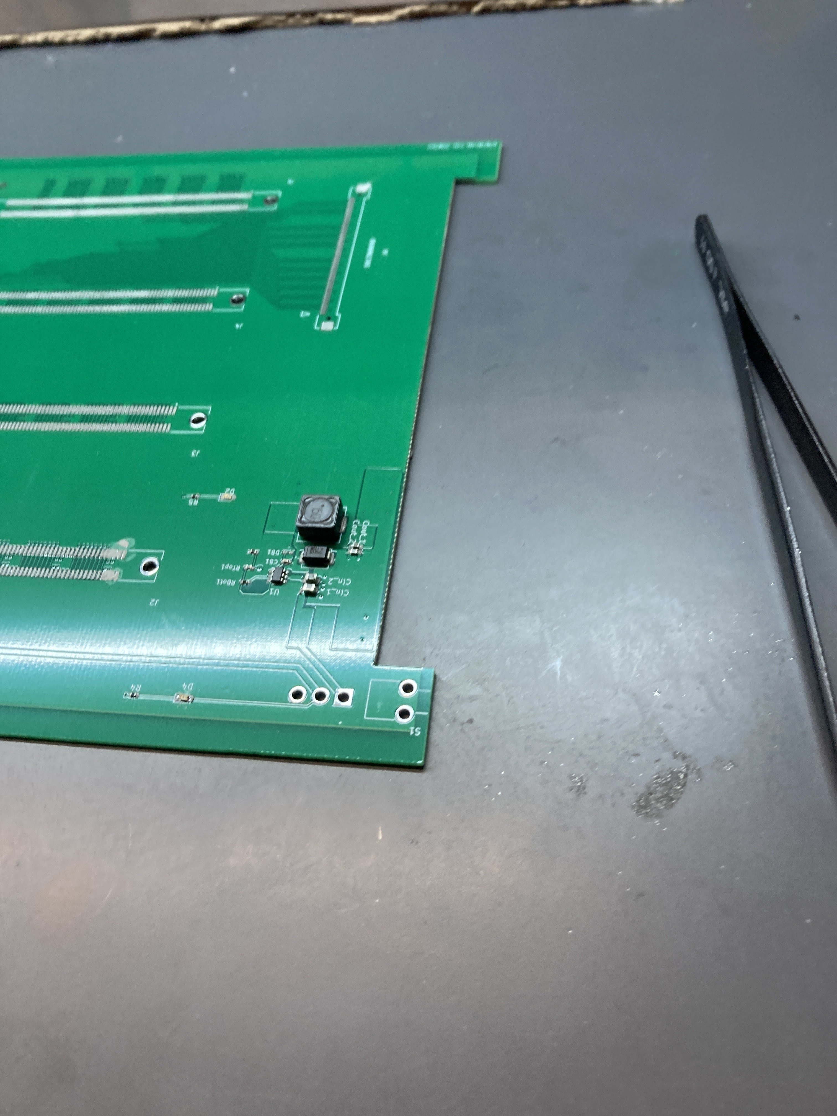
[picture p86: Team/journal/img - member4/week14/2.27.jpg]
  

Afterwards, the completed backplane was placed on the hotplate, and allowed to cooled after everything was heated up. Below is an image of the result, which was pretty good.

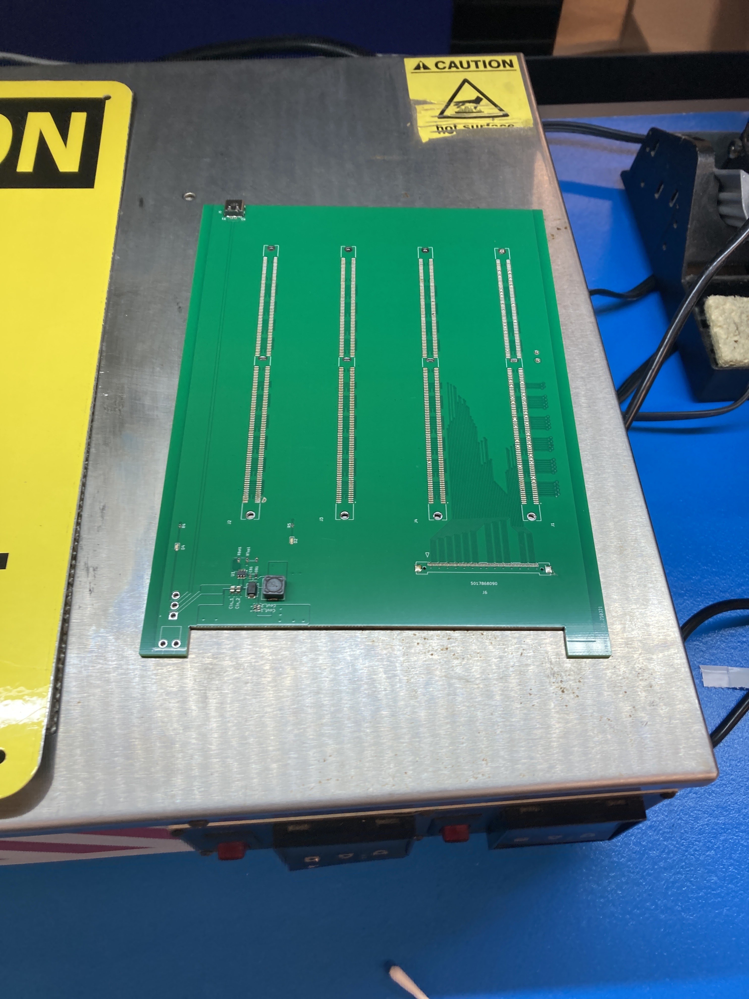
[picture p87: Team/journal/img - member4/week14/2.28.jpg]


Because I was unable to complete another backplane due to lack of parts (3 parts were missing because I lost them), I decided to clean up the environment and wait for another day to complete the last backplane. I returned the solder to the contained and placed the paste container inside the refrigerator, cleaned the PCB stencil with water, and then reconfigured the layout with the last back panel inside. Below are three images of my work.

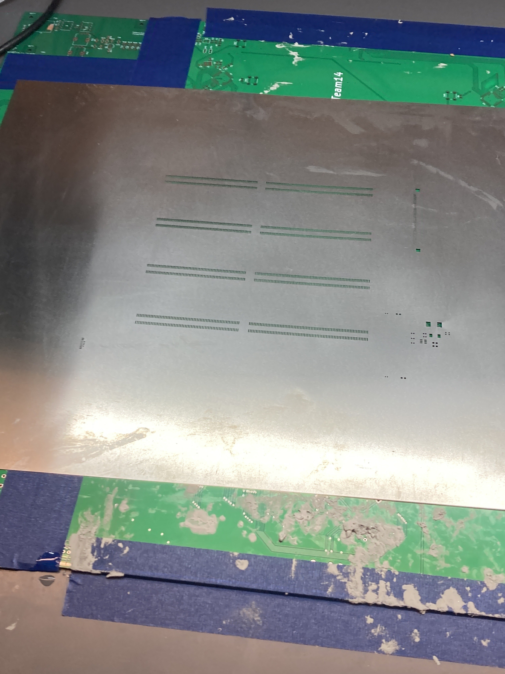
[picture p88: Team/journal/img - member4/week14/2.31.jpg]
  

Today, I began by checking on the status of the spray-painted enclosures. I removed the painter’s tape from one front panel bezel, and the result was nearly perfect. However, upon further reflection, I realized I may have painted the bezels prematurely given our updated plan to laser engrave the front panel design. I turned off unnecessary layers in KiCad—specifically F.silkscreen, F.Edge.Cuts, and F.Courtyard—to generate a printable image for the laser cutter. After exporting the image, I printed and mirrored the back panel version for alignment, preparing for future laser etching at BIDC.

I also peeled the painter’s tape off one of the enclosures and was pleased with the outcome. Since the paint still needs several days to fully cure, I researched spray paint peeling scenarios from this guide (https://www.behr.com/consumer/how-to/interior/how-to-repair-peeling-paint) to be cautious. I consulted with the ECE building machinist about laser engraving, but he didn’t have the capability. Instead, I submitted a work order for a simple back panel cut. Meanwhile, I began preparing another backplane for baking.

Using a PCB stencil, I carefully applied solder paste and placed components onto the new backplane. I began with non-polarized components like resistors and ceramic capacitors, referencing this polarity reference (https://www.protoexpress.com/kb/component-orientation-and-polarity/). Next, I placed polarized parts such as diodes, the buck converter circuitry, and the USB-C mount. I ensured the stencil alignment was accurate by using the buck converter and USB-C regions as anchor points. After aligning and applying solder paste with a single pass to prevent bridging, I populated all key components.

While populating the board, I lost a 0402 resistor—so small that even after 30 minutes of searching, I couldn’t find it. According to ROHM’s specifications (https://www.rohm.com/electronics-basics/resistors/chip-resistor-specifications), 0402 components are just 1.0 × 0.5 mm, which explains the difficulty. I replaced my tweezers and continued component placement. After confirming that all components were correctly mounted—including buck converter elements, debugging diodes, and 5.1k resistors for the USB-C port—I placed the backplane on a hotplate for reflow soldering.

Citations:
- 1: Conditions for paint to peel (https://www.behr.com/consumer/how-to/interior/how-to-repair-peeling-paint)
- 2: Polarity of SMD components (https://www.protoexpress.com/kb/component-orientation-and-polarity/)
- 3: Size of 0402 components (https://www.rohm.com/electronics-basics/resistors/chip-resistor-specifications)
- 4: Effects of mixing solder paste and water (https://www.indium.com/blog/humidity-and-solder-paste-do-not-mix.php) - 5: Documentation of backplane components (https://engineering.purdue.edu/477grp15/Files/references.html)

#### Entry 1: -----------------------------------------------------------------

Date: April 13
Start Time: 7:00 pm
Duration: 3 hours

Content:
Today, I wanted to complete spray painting of the enclosures so I could spend the next week getting all the back panels assembled, cutting out the front panels, and assembling all of the PCs. The first step for me was using the calipers I had found last week to get the exact measurements for the depth and height of the blue paint. The calipers in use can be seen in the image below.



As mentioned last week, after doing all the calculations of the scale of the Altair using external sources and this (https://americanhistory.si.edu/collections/object/nmah_334396) reference, I needed to measure at the following markings.

- The portion from the bottom to the (2/3) mark, or 17.33 mm from the bottom of the box. This matched up perfectly with one of the grooves on the box.
- The portion from the top to the (1.25/18) mark, or 15.28 mm from the front of the box. This was a little harder to secure the tape onto the box in straight lines, but I used a method to get it like so.

I used the guidance in this (https://tapemanblue.com/blogs/tips-tricks/paint-straight-lines) website to figure out how to get perfectly straight lines on the tape. I also decided to double up the layering of painter's tape, so no tape would bleed through. Below is an image of the finished box with the double layered tape. I made sure that everything was as close to aligned as possible and that I went the 90 degree direction when applying the tape.



The process I followed for taping the boxes was as follows:
First, I would place lines in pencil where the markings should go. This can be seen in the photos below.

 

Then, I would apply tape to the front and bottom, so that no paint would bleed inside. After this step was done, it would look like this:



Afterwards, I would apply the first round of tape, making sure that the lines were straight and applied to the edges. The following two photos demonstrate what this would look like.

 

Next, I would apply the remaining tape, making sure it covered the entire rectangular region on the top which I did not want painted. Sometimes, I would use a card to smooth out the lines. A photo of the finished product and me using a card can be seen below.

 

Afterwards, I would go and tape over the lines with another layer. In all, the box would look like below.



I repeated the process 2 more times for the remaining two enclosures. I had to remove some of the tape on the enclosures in the past, because it wasn't the correct painter's tape (https://www.homedepot.com/b/Paint-Paint-Supplies-Tape-Painters-Tape/N-5yc1vZcibu) that we needed to do the painting.



I placed the enclosures on the leftovers of a cardboard poster. In the end, it looked as below.



I started thinking about how I would paint the front panel portion of the enclosure. From the two images below, It can be seen that the blue paint went outside the perimeter. The back plane of the enclosure, however, is not painted, as seen in the photo.

 

I decided to paint only the sides of the front facing plastic, as I had another plan for the front panel plastic. To do this, I would need to tape over the front face of the plastic. I use two pieces of tape in order to do so, making two layers to make sure no paint leaked. A single front panel plastic can be seen below.



And all four completed plastic panels looked as below:



I then moved forward to painting the alluminum, where I would need a 180 grit sandpaper followed by a 220 grit sandpaper, according to this (https://machining-quote.com/bolg/how-to-paint-aluminum/) website, so I obtained those materials as seen in the picture below, as well as a higher pitch sandpaper.



I started sanding each of the front panels so the surface would not be as smooth, just to try it out, first with the 180P and then with the 240P. Below you can see how it turned out.



After this was complete, I packed up all the painting related things, including goggles, gloves, masks, and headed up to the BIDC to complete painting in their ventilated rooms. Below is an image of the box I took.



While at BIDC, the first thing I needed to do was find a suitable place to paint, which was away from anything hazardous and that could cause damage. I looked up this article (https://www.fivestarpainting.com/blog/2021/october/indoor-painting-how-to-do-it-safely/) on find a place to paint indoors.
I got the necessary materials which I needed, and made a setup like you can see below. I need to find an object to hold the front panel plastics down, so the cardboard box is what I settled on. I saw that the plastic we were using was ABS plastic, so I found this (https://www.pfonline.com/articles/painting-plastic) article on how to paint ABS plastic. It was a similar procedure to spray painting alluminum, so I made sure to sand all of the edges of the bezels. I continued to abrase the surfaces until they were ready to be painted.



After which, I began spray painting, following the instructions on the can. I began with adding one coat of paint, and then waiting around 20 minutes to apply the second one. Then I would apply the third coat of paint at the 40 minute mark, and wait another hour before taking them back to the lab, inside the cardboard box. The first coat of paint can be seen below.



During the painting, I ran into the issue that the painter's tape would sometimes peel. If this happened on the plastic bezels, it would be some issue, but not a lot since we were going to hacksaw them anyways. After 20 minutes, I applied the second coat of paint. It can be seen in the image below.



After the second coating, the spray painting was much better, and I believe that the coats were actually applying to the alluminum. I will still likely have to apply the third coat in around 30 minutes, because I do not trust that 2 will do the trick.
Before the third coating was applied, I wanted to get the box ready for transport, in the case that the paint were to leak. The main reason I did this was so the boxes would be held secure in place if the box moved around. Even if the paint leaked or wasn't applied correct, the damages would be minimal. I used some tape and taped inside the box with some newspaper inside. It looked as such.



THe third coating was applied, and looks as below.



I felt like the spray painting was very successful, as I saw no paint move during the 90 minutes I was watching it. I took the boxes back to the lab and let them dry on the floor on the cardboard. I will check back on the painted boxes sometime later.

Today, I focused on completing the spray painting process for the enclosures to prepare for next week's tasks of assembling the back panels, cutting out the front panels, and fully building the miniaturized PCs. I began by using calipers to precisely measure the height of the blue paint section based on a scaled model of the original Altair, referencing accurate historical dimensions from the Smithsonian collection (https://americanhistory.si.edu/collections/object/nmah_334396). Using guidelines from a tape-laying tutorial (https://tapemanblue.com/blogs/tips-tricks/paint-straight-lines), I carefully taped off sections of the enclosure to ensure clean, sharp edges without bleed-through, even applying a double layer for extra protection. After outlining the sections with pencil and covering the enclosures with painter’s tape, I completed the masking process for all three boxes. I also corrected earlier mistakes by removing incorrect tape types, verified by guidance from Home Depot's selection of painter’s tape (https://www.homedepot.com/b/Paint-Paint-Supplies-Tape-Painters-Tape/N-5yc1vZcibu).

Next, I prepared the aluminum and ABS plastic components for painting by sanding their surfaces using 180P and 240P grit sandpapers, following the recommended method from this aluminum painting guide (https://machining-quote.com/bolg/how-to-paint-aluminum/). I also researched how to handle ABS plastic painting using this plastic-focused article (https://www.pfonline.com/articles/painting-plastic). Once everything was prepared, I transported the materials to the BIDC facility, using a safe indoor painting environment, as described in this article on safe indoor painting (https://www.fivestarpainting.com/blog/2021/october/indoor-painting-how-to-do-it-safely/).

During the spray painting session, I applied three coats of paint, waiting 20 minutes between the first and second, and then another 40 minutes before applying the third. I encountered a minor issue with tape peeling, especially on the plastic bezels, but this was manageable since those would be trimmed with a hacksaw anyway. To prepare for safe transportation back to the lab, I reinforced the box interior with newspaper and tape to prevent the painted pieces from shifting. Ultimately, the paint adhered well, with no signs of movement during the drying period. I let the pieces dry on a cardboard platform in the lab and will inspect the final result later. The spray painting process was thorough and successful, ensuring the enclosures are now visually accurate and professionally finished.

Citations:
- 1: Dimensions of old Altair (https://americanhistory.si.edu/collections/object/nmah_334396)
- 2: Painting techniques for straight lines (https://tapemanblue.com/blogs/tips-tricks/paint-straight-lines)
- 3: Correct painter's tape for straight lines (https://www.homedepot.com/b/Paint-Paint-Supplies-Tape-Painters-Tape/N-5yc1vZcibu)
- 4: Technique for painting alluminum (https://machining-quote.com/bolg/how-to-paint-aluminum/)
- 5: Indoor painting with ventilation (https://www.fivestarpainting.com/blog/2021/october/indoor-painting-how-to-do-it-safely/)
- 6: Plastic painting guide (https://www.pfonline.com/articles/painting-plastic)

## =============== Week 13: =================

#### Entry 4: -----------------------------------------------------------------

Date: April 11
Start Time: 9:30 am
Duration: 2 hours

Content:
Today, I needed to make serious strides towards the construction of the enclosure. I looked online for the appropriate tape to use when painting, which led me to this website (https://www.homedepot.com/b/Paint-Paint-Supplies-Tape-Painters-Tape/N-5yc1vZcibu). I knew I needed to ask the lab staff for painter's tape.
While I waited for the lab staff, I decided to finish up another front panel. This would take the better half of an hour. I used the same procedure I used in the previous night, only soldering the 5 I/O expanders as well as all 36 LEDs. This exhaustive process is detailed in steps below.
1. Each of the I/O expanders was soldered:



2. Each of the LEDs was soldered, following the ordering bottom to top, and right to left:



3. Each of the switches were soldered, following the order from right to left. The most difficult LEDs were located in the center of the board, where the USB-C connector:



4. Solder was placed on the bottom of the board, and then all of the buttons were placed and soldered:



This process took very long, because of how I needed to align every single LED to get the correct polarity and the fact there was room for little to no error.
Because the Lab staff were not in yet, I decided to go up to the ECE shop in order to see if they had anything. In the meantime, I decided to cut up a cardboard box in order to get ready for painting. The cardboard box I pulled from the Starbucks staff because they were throwing away some cardboard boxes I knew we needed for painting. I used the box cutters to get rid of the lid flaps of the box. The before and after can be seen as below, in the series of two pictures.



I got some washers from Shivam, which were the perfect size and height we needed to avoid the collision of the front panel. After this, I found that the ece shop had the exact painter's tape I needed for the project. It can be seen below.
I tried to find the depth of the blue paint for the altair front panel, but it was hard without a primary reference. I realized there was something called an "Altair Clone Cabinet", which I followed to this website (https://adwaterandstir.com/product/altair-reproduction-case/), but it ended up not being of a correct scale.
Looking for the dimensions of the blue part of the altair proved to be quite a challenge, and it led me down the original owner's manual for the Altair, found here (https://altairclone.com/downloads/manuals/Altair%208800%20Operator's%20Manual.pdf). I also cross-referenced the wikipedia article and the sources found here, and finally was able to find a reputable source that said that the front panel was 1.25 inches, sourced here (http://altair32.classiccmp.org/Altair32FrontPanel.htm).
Because the old Altair was 17'' x 18'' x 7'', 1.25 inches only represented 6.9% of the total depth. Because our enclosure measures 8.66 inches, I need to measure nearly 0.60 inches into the panel, or 1.53 cm. I measured out all of the necessary dimensions on one of the enclosures, just to test it for spray painting. It is seen below, with 2 angles. I measured the depth of one of the plastic cartridges and saw that it was 1 cm exactly, so the depth of the paint would definitively exceed the plastic portion.

 

Now I have the enclosures ready for painting, and I will do that tomorrow, when I have an environment that is good for spray painting.

I researched appropriate painter's tape for masking the enclosure during painting. I found suitable options on the Home Depot website (https://www.homedepot.com/b/Paint-Paint-Supplies-Tape-Painters-Tape/N-5yc1vZcibu) and planned to request some from the lab staff.

While waiting for lab access, I completed another front panel. This involved soldering 5 I/O expanders, 36 LEDs, and all switches. The soldering process was meticulous, especially when aligning the center LEDs near the USB-C port, which had very tight spacing.

I repurposed a cardboard box from Starbucks to create a paint-safe workspace by cutting off the lid flaps. This helped prepare a clean area for spray painting the enclosure.

Shivam provided washers that perfectly matched our needs, ensuring the front panel wouldn’t collide with internal components. I also found the exact painter’s tape needed in the ECE shop.

To replicate the original Altair color layout, I looked for the correct depth of the blue panel section. After checking various sources including the Altair 8800 Operator’s Manual (https://altairclone.com/downloads/manuals/Altair%208800%20Operator's%20Manual.pdf) and legacy documentation on Altair32 (http://altair32.classiccmp.org/Altair32FrontPanel.htm), I determined that the blue area should be scaled to 1.53 cm for our enclosure dimensions.

I measured and marked this depth on one of our enclosures, ensuring that the paint would extend slightly deeper than the plastic cartridge. Now the enclosures are fully prepared for spray painting tomorrow.

#### Entry 3: -----------------------------------------------------------------

Date: April 9
Start Time: 9:30 am
Duration: 3 hours

Content:
Today, my main priority is to get the enclosure ready for assembly, as well as one of the front panels. I spent some time assembling the front cards, but just the I/O Expanders and the LEDs so that we can test it manually. I updated the enclosure datasheet so we would have it in the future.
I made another front panel following the functional one that Brian created. For the I/O Expanders, I followed a procedure that I developed through trial and error.
First, I made sure that enough flux was existent on each of the small pads such that when I added solder, it set on all the pads perfectly without overflowing. If the solder overflowed, it would be detrimental to my progress as I would have to use more flux in order to fix the problem. The image of the pads with enough flux is seen below.



Next, I would place the Sink Driver and use enough pressure with my tweezers to keep it in place, so that I could individually solder each of the pins. The process can be seen below.



After the Sink Driver was properly placed and I was sure it wasn't going to move around, I made a second pass using four additional dabs of flux and pushing each of the solder up the pins. This worked extremely well, and after looking at the pin down an electron microscope, every pin seemed to be connected.



I followed this process for all 5 Sink Drivers on the front panel, and then I needed to move to the LEDs, where I followed another five step process in order to get all 36 LEDs on for a single front panel.
First, I would apply the solder flux to the LED pads, but only enough so that the solder would not overflow and move to another pad. This is shown in the photo below:



Then, I would apply enough solder to completely fill the pad. This would exactly fill the area of the rectangle, without going over. This can be seen in the bottom LED in the photo below.



Afterwards, I would use the pointed tweezers to directly apply pressure to the most sensitive point of the LED, which would allow me to put pressure to put the LED down. This process is seen below.



Next, I would reflow the solder for one side, trying to make sure it was aligned. Each LED would look as below.



After that, I would reflow the other side, making sure the solder completely filled the sections of the LED. This can been seen below. If the solder overflowed, I took special care to make sure it was within the pad's limits.



For quality, I made sure to reflow the other side, just to make sure the LED was completely flush with the board and there would be no potential leaks.



After just the Sink Drivers and the LEDs were placed, I did some research on the enclosure of the entire project. I found a similar replica of the model online, which looked as below.



This would be useful for finding the dimensions of the Altair used for painting and scaling. I scaled down the painted regions of the Altair, especially the blue painted region, and did some calculations and to find the lengths in centimeters to use with my calipers.



Today, my main goal was to prepare the enclosure and one of the front panels for final assembly. I started by assembling the front card components, specifically the I/O Expanders and LEDs, to allow for manual testing of the panel functionality. I also took the time to update the enclosure datasheet to ensure we had consistent specifications moving forward.

Following Brian’s functional prototype, I created another front panel and developed a more refined soldering procedure through trial and error. For the I/O Expanders (Sink Drivers) (https://www.ti.com/product/TLC59208F), I first applied just enough flux to each small pad to avoid solder overflow. This preparation was crucial to ensuring a clean and reliable connection without shorting adjacent pins.

Next, I placed the Sink Driver with tweezers and applied enough pressure to keep it stable while I individually soldered each pin. I then made a second pass with four additional dabs of flux and pushed the solder upward into each pin for a solid bond. After inspection under a microscope, each pin showed strong, continuous connections.

I repeated this process for all five Sink Drivers on the front panel. Afterward, I began soldering the 36 LEDs, following a careful five-step process. I first applied a controlled amount of flux to prevent solder from bridging to neighboring pads. Then I added enough solder to fill the rectangular pad area without spilling over.

Using fine-point tweezers, I precisely placed each LED by pressing down on the sensitive contact point, then reflowed one side of the solder to lock in alignment. Once aligned, I reflowed the second side and inspected for overflows or gaps. For quality assurance, I reflowed the first side again to ensure the LED was flush and fully secured.

Once all Sink Drivers and LEDs were mounted, I shifted focus to the project enclosure. I researched replica models of the Altair online and found a similar version to guide the visual design and color accuracy of our final build. A useful resource for this was the Altair Clone Project (https://altairclone.com/), which helped me identify design cues and painted surface dimensions.

I scaled the blue panel dimensions based on the original Altair 8800 manual (https://altairclone.com/downloads/manuals/Altair%208800%20Operator's%20Manual.pdf) and used calipers to calculate the appropriate lengths in centimeters for our enclosure. This reference will be used during spray painting to maintain visual authenticity while ensuring hardware alignment.

#### Entry 2: -----------------------------------------------------------------

Date: April 7
Start Time: 9:30 am
Duration: 3 hours

Content:
I spent some time researching how to paint Alluminium 6063, which was the alluminium used in our enclosures. I knew the process wouldn't be easy, because of how smooth our extruded alluminum was. I first looked at this (https://www.homedepot.com/c/ah/how-to-spray-paint/9ba683603be9fa5395fab901e70320ce) website to find a proper way to paint the smooth alluminium surface. To accomplish this, I decided I needed to coarse up the surface of the case, or the paint would not stick properly. I also needed to find some place to spray paint the case, which was compliant with regulations.
Next, I went to Ace Hardware and got the proper paint we needed to paint the cases. I talked to Brian and we agreed on a color, seen below.

 

The color we decided was near the color shown below, which I picked using a color picker here (https://imagecolorpicker.com/). It can also be seen below.



After this, I reconsidered by objectives for the week, and made a new task list which would help me better attain these objectives. I used Microsoft To Do to accomplish this, as seen below.



Next, I needed to rework one of the Sink Drivers which I had previously messed up. The sink drivers had been soldered too closely together, which had resulted in them all merging together, which was not desired. I needed to reflow this part of the board, so I eventually ended up removing the Sink Driver and replacing it with a new one. The entire process can be seen below, through multiple steps.

  

I found this plastic plate which was the exact perfect height in order to maintain the switches. I used this platform for leverage to get all of the switches in. Below, you can see how I used the platform to my advantage.

 

After this, I started getting the enclosures ready for painting. I taped up the regions I did want painted, as seen below.



My main priority still remains getting all of the front panels soldered, so that we can finish assembly.

Today, I focused on preparing the aluminum 6063 enclosures for painting by researching proper techniques for painting smooth aluminum surfaces. I learned that the surface needs to be roughed up to ensure adhesion, based on guidelines from sources like Home Depot (https://www.homedepot.com/c/ah/how-to-spray-paint/9ba683603be9fa5395fab901e70320ce). After settling on a color with Brian, I purchased spray paint from Ace Hardware (https://www.acehardware.com/) and used Image Color Picker (https://imagecolorpicker.com/) to digitally confirm the shade.

To stay organized, I created a new weekly task list using Microsoft To Do (https://todo.microsoft.com/tasks/). I also reworked a poorly soldered Sink Driver by reflowing and replacing it, using tools like a hot air rework station (https://www.sparkfun.com/products/14528). Additionally, I found a plastic platform that helped align the switches during assembly.

Lastly, I began masking off parts of the enclosure to prep for spray painting, following guidelines similar to those in this guide (https://www.instructables.com/How-to-Mask-Off-for-Spray-Painting/). Despite the progress in painting prep, my main goal remains finishing the soldering on all front panels for final assembly.

#### Entry 1: -----------------------------------------------------------------

Date: April 6
Start Time: 12:00 am
Duration: 3 hours

Content:
I researched some opportunities we could use in the Spark Challenge in addition to our four miniaturized Altairs. I stumbled across this game, which could be played on the original Altair and could be easier to implement with our new Altairs. Additionally, the fairly popular Lunar Lander game could be played on the Altair, which I will have to look into later.



I also spent some time on the reliability analysis, working on the calculations of A10, as seen below.



Afterwards, I had to cross check some things on the schematics, especially the Schottsky Diodes that were used on each Card PCB as well as the orientation of the LEDs on the front panel. I discovered that the triangular segment that is cut out of each LED should face the tiny white dot that is directed towards the microcontroller. The analysis of the component, as well as some analysis of some boards, is seen in the series of two photos below.

 

I spent a lot of time inspecting the boards that were already soldered. I looked under each component in the electron microscope, so that each of the pins on the sink driver were corresponding to the correct pad. This was very difficult, as the sink drivers had a tendency to move around, even with the smallest perturbation. I spent time inspecting three additional boards, which can be seen below.

  

Hopefully, in the end, we will have working PCBs like the image below. For now, I have to complete the inspection of the PCBs.



To explore additional opportunities for our Spark Challenge submission beyond the four miniaturized Altair units, I researched retro-style games that were originally playable on the classic Altair 8800. I came across a game called "Hammurabi," a text-based strategy simulation that could be feasibly adapted for our modern implementation due to its minimal memory and display requirements. Details on this game and others like it can be found on retrocomputing archives such as RetroGames.cz (https://www.retrogames.cz/play_083-DOS.php) and through resources provided by the SparkFun Altair Program Manual (https://s3.amazonaws.com/sparkfun-sparkchallenge/Altair_Programs.pdf).

In parallel, I continued working on the reliability analysis for the Altair hardware, focusing specifically on the A10 life prediction parameter. A10 refers to the number of cycles at which 10% of a population is expected to fail under normal operating conditions. I derived this based on component failure rate data and environmental stressors using the reliability prediction methods recommended by the Weibull++ software by ReliaSoft (https://www.reliasoft.com/products/reliability-analysis/weibull-analysis). The ongoing A10 calculations are shown in the image below.

To validate design and assembly decisions, I cross-checked our schematics, especially focusing on the SS14 Schottky Diodes (https://www.vishay.com/docs/88755/ss14.pdf) used on each Card PCB. I verified that they were placed in the correct direction based on their polarity markers. I also reviewed the orientation of surface-mounted LEDs on the front panel. According to the Kingbright LED datasheet (https://www.kingbrightusa.com/images/catalog/spec/KA-3528SURC.pdf), the beveled corner of each LED package should align with the silkscreen dot pointing toward the microcontroller. This ensures proper current flow and display behavior.

After confirming the design specifications, I spent several hours conducting a meticulous inspection of the assembled boards. Using our lab’s electron microscope, I analyzed the solder joints beneath each Sink Driver chip to verify alignment with PCB pads. These ICs are notoriously sensitive to mechanical misalignment, especially given their fine-pitch packaging. Even a slight shift during reflow can result in intermittent failures. Images of three additional board inspections are shown below.

This inspection process is critical to our quality assurance workflow. By manually inspecting all boards for misalignment and solder bridges, we minimize the risk of electrical faults in our demo units. Ultimately, our goal is to ensure each PCB reaches the assembly-ready state depicted in the last image.

Today’s work contributed significantly to both our design validation and demo preparedness. By identifying a playable game for the Spark Challenge and performing detailed reliability and schematic reviews, we’ve enhanced the Altair’s capability and robustness. The inspection of soldered components using microscopy confirmed correct pin-to-pad alignment, reducing the chance of latent defects. Going forward, the next steps involve finalizing board inspection, verifying firmware compatibility with potential games like "Hammurabi," and beginning integration testing with the enclosure and front panels.

## =============== Week 12: =================

#### Entry 5: -----------------------------------------------------------------

Date: April 4
Start Time: 9:30 am
Duration: 2 hours

Content:
This morning was heavily focused on developing a clear and efficient strategy for soldering the vertical USB-C mount onto our PCB. The vertical orientation of the connector presents unique challenges compared to traditional horizontal ports, especially with regard to mechanical stability and accessibility for the soldering iron tip. I spent time sketching out the soldering plan and referencing datasheets for the USB-C component to verify pin alignment and pad exposure requirements (USB-IF Specification (https://www.usb.org/document-library/usb-type-cr-cable-and-connector-specification-revision-21)). To ensure precision, I used a fine-tipped soldering iron set to 350°C, alongside flux paste and leaded solder for a more forgiving melting point. I also used helping hands to keep the board elevated and angled, allowing me to access the through-hole pins more directly. Since the vertical connector has to endure a decent amount of mechanical stress from cable insertions, I made sure to generously solder the shield pins and reinforced them with additional solder bridges, ensuring both electrical contact and mechanical anchoring (SparkFun Soldering Guide (https://learn.sparkfun.com/tutorials/how-to-solder-through-hole-soldering/all)). A key lesson from this session was the importance of pre-tinning both the pads and the connector legs before final placement. This significantly sped up the actual soldering process and improved the quality of each joint. I did have to reflow one pin where I initially didn’t get full wetting, which reinforced the importance of holding the iron in place just long enough to allow solder flow without overheating the board (Adafruit Soldering Best Practices (https://www.adafruit.com/product/1886)).



The result is a securely mounted and properly soldered vertical USB-C connector, which now allows us to move forward with board testing and integration into our enclosure design. Getting this connector in place is a big step toward finalizing the physical assembly and ensuring our power and data interface is reliable under repeated use. Next steps include testing voltage continuity across the power pins, verifying D+ and D– data line connectivity with the microcontroller, and preparing the adjacent components for full subsystem testing. I’m also planning to document the full soldering process with a step-by-step photo guide to assist other team members with similar components.

#### Entry 4: -----------------------------------------------------------------

Date: April 2
Start Time: 10:30 pm
Duration: 2 hours

Content:
I began by reprinting the PSDR sheet, since I was told we also needed the project description on the sheet.
I edited the original word document, after looking at how other teams did theirs. I reposted the PSDR sheet, which looked as such. I kept the old one with the PSDRs checked out underneath, so we could transfer the checked off backplane PSDR. I also got sturdier tape and staples to put the sheets up The setup looked as below.

 

I saw Brian's existing hot plate deconstruction, and since we were going to buy a new mini hotplate anyways, I cleaned up all the components and put them in a chem cup, as seen below.



Next, I wanted to complete the soldering of all the jumpers onto the cards. I had 39 left to complete, so I went forward to find flux and the appropriate materials. I made the approach progress, and documented an array of the completed boards, which can be seen from the array of images below.
During the entire process, I was concerned that the flux may be too corrosive, so I watched this video from this website (https://www.techspray.com/flux-remover-video-how-to-guide) to figure out a better way to remove the flux.
The whole process I devised was that I would use the flux to solder the board, use isopropyl alcohol to remove the flux, and then use the air gun to remove an remaining flux, before washing the board with a little bit of water.
For testing the connections, I used two tape rolls and the connectivity probes to make sure all the connections were good and that no shorts were found. My testing setup can be seen below.



I was worried that the flux would leak through to the other side, but thankfully every time I inspected a board there was little to no flux leaking through to the other side, which was good.
There were some DIM connector bridges laying around, so I went ahead and organized the box into used and unused DIM connectors. This can be seen below.



I got some flux on my hands, so I had to immediately wash it off as soon as I could. Hopefully the heavy duty hand cleaner did the trick.
I needed make sure that I was handling the RP2350's correctly, so I looked up RP2350 safety and handling and found this (https://datasheets.raspberrypi.com/rp2350/rp2350-product-brief.pdf) website. It told me that the RP2350 should not be exposed to water, but since the RP2350s are already assembled, I think it is fine. To be safe, I will make sure to not use water and only use Isopropyl alcohol in the future.
Shivam visited the lab and told me about the helping hands, so I borrowed the 477 Lab's pair and it made checking the continuity much easier. Below is an image of the helping hands.



In all, the progress of each board can be seen in the image(s) below, as I got through all 13 of them. I left out two to do later, in case something failed.

         

After I completed the first round of soldering the card(s), I went to find the color of the paint used in the Altair so that if we went to spray paint it, it would be successful.
While looking online, I found this (https://deramp.com/downloads/altair/hardware/altair_8800c/Front%20Panel%20Manual.pdf) resource for potential games that could have been played on the Altair. One of these is Pong, as seen in the image below.



I found online that the blue strip of the side panel was almost exactly 1/3 of the entire height, while the back was colored entirely black and the front was entirely blue. I got this information from the below image and the following source (https://www.computerhistory.org/collections/catalog/X1452.97)
;



I looked up the dimensions of our enclosure (https://www.hammfg.com/files/parts/pdf/1455T2202.pdf?v=1697661933), and found that it was exactly 51.50 mm. 2/3 of this would be 34.3 mm. I got this information below.



Thus, I needed to tape exactly 34.33 mm from the top of the enclosure, to fit the blue robin egg blue. We will have to go to Ace Hardware and get the correct (or closest) shade of blue possible to make the color work with the design.
I went ahead and taped all the enclosures, which looked like so after finished.



It was time to assemble the card next, so I decided to only put the LDO and the USB-C connector, that way I could check if power was successfully going to the card. If power was successfully going to the card, there were no purpose to solder any of the other components, since we only needed the card for debugging purposes.
I attempted to solder the USB-C connector first, through drag soldering. There was a loose wire which had been flywired into the board, so I had to remove that one first.
The first result looked as below. With a good portion of the soldering done, I was feeling pretty good about the project.



Today, I revised and reprinted the PSDR sheet to include the project description, ensuring alignment with other teams' formats. The updated sheet was securely posted with improved tape and staples.

Next, I organized and cleaned components from Brian’s hot plate deconstruction, preparing them for future use. I then focused on soldering the remaining jumpers onto the cards, carefully selecting the right materials and refining my process with flux removal techniques, verified through this guide (https://www.techspray.com/flux-remover-video-how-to-guide). Connectivity tests confirmed the integrity of the soldered joints.

To improve organization, I sorted used and unused DIM connectors and ensured proper handling of RP2350 components by consulting this resource (https://datasheets.raspberrypi.com/rp2350/rp2350-product-brief.pdf). I also utilized the 477 Lab’s helping hands, which significantly eased continuity testing.

In preparation for final assembly, I researched and planned the color scheme for the enclosure, referencing the Altair’s design (https://www.computerhistory.org/collections/catalog/X1452.97) and the enclosure dimensions (https://www.hammfg.com/files/parts/pdf/1455T2202.pdf?v=1697661933). I precisely marked and taped the enclosures for accurate painting.

Lastly, I began assembling the card, focusing on the USB-C connector and LDO for initial power testing. Drag soldering was used for the USB-C, ensuring proper connections while removing any unnecessary flywired components.

#### Entry 3: -----------------------------------------------------------------

Date: April 2
Start Time: 9:30 am
Duration: 2 hours

Content:
Today I focused on soldering the backplane PCB using both the hot plate and the reflow oven to attach all surface-mount components. I began by carefully applying solder paste to the pads using a fine-tipped syringe and a stencil for the denser IC sections. After confirming all components were placed according to the board layout and orientation markings, I used the hot plate to begin the reflow process. The temperature was monitored closely using a thermocouple probe taped near the center of the PCB to ensure a gradual ramp-up and consistent heat profile, as recommended in standard leaded solder reflow profiles (NI Reflow Soldering Guidelines (https://www.ni.com/en-us/innovations/electronic-test-measurement/solder-reflow.html)). Once the solder began to liquify, I transitioned the board into the reflow oven to ensure uniform heating and to complete the soak and peak phases. I followed a basic leaded reflow curve, targeting a peak of around 220°C. Visually, most of the solder joints formed well, but several components—particularly a few 0402 capacitors and a QFN IC—did not settle properly. Some shifted slightly during reflow, likely due to uneven heating or an air draft from opening the oven door too early. Upon inspection, I found two capacitors tombstoned and the QFN had several cold joints. I suspect the tombstoning was caused by uneven thermal mass between the two ends of the components, something I’ll need to compensate for by refining the thermal profile or preheating the board longer (Analog SMT Reflow Insights (https://www.analog.com/en/analog-dialogue/articles/smt-component-placement-and-reflow.html)). As for the QFN, I will need to reflow it using a hot air station with flux to repair the incomplete joints. Although some components failed, this session gave me valuable insight into our current reflow setup and its limitations. It also highlighted the need for consistent temperature control and strategic placement of thermocouples. The successful joints on the power regulation section show that the oven can work well when the heat distribution is managed carefully. This backplane is a central part of our electrical system—it provides the communication and power backbone between the modules. Getting it soldered correctly is a critical milestone. With the results from today, I now have a much better understanding of the variables at play and how to approach the next reflow attempt more strategically. Next, I plan to remove and rework the faulty components with a hot air rework station, then retest the continuity and functionality of the backplane. I'll also experiment with a longer preheat phase in the oven to reduce tombstoning and improve thermal consistency across the board.

#### Entry 2: -----------------------------------------------------------------

Date: March 31
Start Time: 9:30 am
Duration: 2 hours

Content:
Today I focused on a mix of project logistics and preparation for extended lab work sessions. The first part of the morning was spent editing the PSDR checkoff form in Microsoft Word to reflect our team’s latest design changes and progress. This involved updating the requirement descriptions, cross-checking our documentation for accuracy, and ensuring that all deliverables were clearly aligned with what we’ve implemented so far. This form will serve as the basis for our official progress review, so clarity and precision were critical. I referred to the project guidelines and previous feedback from the TAs to make sure everything was formatted and worded correctly (Microsoft Word Documentation (https://support.microsoft.com/en-us/word)).



After completing the documentation edits, I turned my attention to setting up for long lab sessions that we’ll need in the coming days for soldering, testing, and debugging. I gathered supplies like snacks, water, hand wipes, and basic hygiene items to keep nearby in the lab. This was a practical move to stay focused and minimize disruptions during multi-hour build sessions. I’ve learned from earlier phases that even minor interruptions—like leaving to get food or water—can significantly slow down our momentum during technical work.



These efforts, while not directly technical, contribute meaningfully to our team’s overall productivity and time efficiency. Having our documentation ready ensures we’re aligned with expectations for the PSDRs, and being physically prepared for long work sessions means fewer interruptions when we're deep in debugging or integration. Another portion of this session was dedicated to both hands-on soldering work and analyzing the long-term durability of our hardware. As we move closer to final integration, I revisited several key solder joints—especially those related to high-usage interfaces like the vertical USB-C connector and the main backplane headers. These parts are expected to endure frequent plug/unplug cycles and mechanical stress, making joint reliability critical. I touched up the existing solder joints using a fine-point iron and added additional solder fillets to reinforce mechanical strength (Adafruit Soldering Guide (https://learn.adafruit.com/adafruit-guide-excellent-soldering/common-problems)). To further enhance mechanical robustness, I applied UV-curable epoxy to high-stress components like the USB-C port and large electrolytic capacitors. This helps distribute strain across the PCB and reduces the risk of microfractures in solder joints over time (Henkel Potting/Encapsulation Guide (https://www.mouser.com/pdfdocs/Henkel-Potting-Encapsulation-Guide.pdf)). I also checked for thermal expansion concerns by inspecting clearance around large packages and connectors, ensuring no tight interference that could cause warping or stress during heating. Next steps include finalizing and submitting the updated PSDR form for TA review, as well as beginning hardware testing as soon as the soldering tasks are complete. With the right preparation, we’re in a strong position to tackle the next phase of assembly and system integration.

#### Entry 1: -----------------------------------------------------------------

Date: March 30
Start Time: 12:30 am
Duration: 2 hours

Content:
Each sorting section would consist of selecting a component from the parts order, finding the part on the order sheet, finding if the part was on the backplane, front panel, or card(s), finding the component reference designator, and then putting the part in the box with the appropriate labelling to match the section.
I completed the sorting of all three boxes. Each component was carely photographed as seen below.

        

           

## =============== Week 11: =================

#### Entry 4: -----------------------------------------------------------------

Date: March 28
Start Time: 7:00 pm
Duration: 1 hours

Content:
Today's session was just about making sure all the components were in the proper boxes, with both the Mouser and Digikey shipments. I also needed to do the Preliminary PDSR checkoff lists for our team, so I spent some time copying from our website and printing out the sheets. I put the sheets in the following region in our lab section, which can be seen below.

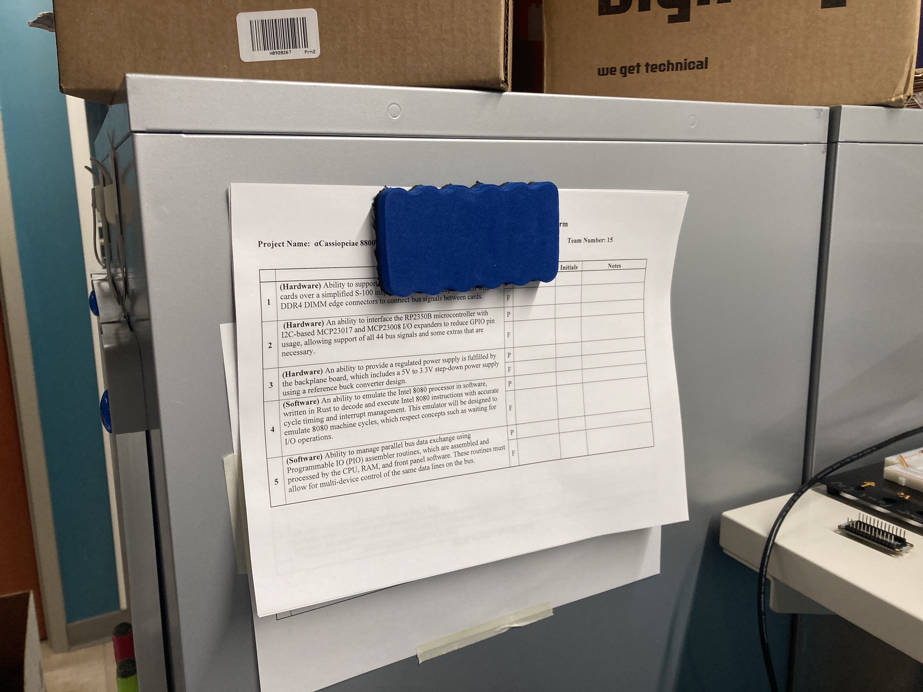
[picture p89: Team/journal/img - member4/week11/6.1.jpg]


I looked at this guide (https://weishielectronics.com/how-to-organize-electronic-components/)
for organizating parts for the PCB just so it would be easier to obtain the components when we went to solder the PCBs. I spent the rest of the time putting the components into the three appropriate boxes, and labeling the component to be the labelling on the PCB.

Today, I focused on organizing all the components from the Mouser and Digikey shipments and ensuring they were placed in the correct boxes for easy access during the PCB assembly. I spent some time reviewing our team's Preliminary PDSR checkoff lists, which I copied from our website and printed out for reference. I then placed the checkoff sheets in our designated lab section, ensuring that everyone could easily refer to them when needed.

To ensure the components were properly organized, I followed a guide (https://weishielectronics.com/how-to-organize-electronic-components/) that provided useful tips for organizing electronic parts for the PCB. This was important because it would simplify the process of obtaining components when we go to solder the PCBs. I spent the remaining time sorting the components into three separate boxes and labeling them according to the corresponding labels on the PCB.

This work contributed to the progress of our project by ensuring that all parts are properly categorized, which will streamline the assembly process. The next steps involve verifying that all components are in place and ready for the soldering phase.

#### Entry 4: -----------------------------------------------------------------

Date: March 28
Start Time: 9:30 am
Duration: 2 hours

Content:



After tidying up the workstations, I went to the ECE shop to collect labelling materials. These items will be crucial for organizing the parts more effectively, as it will allow us to clearly mark different components and keep everything in its proper place. I also made sure to gather extra supplies in case we needed more labels during the next few weeks.



Upon returning to the lab, I started sorting the three types of PCBs we have. This step was essential as each type of PCB will require different components and processes during the assembly phase. Sorting them ensures that we can easily identify which PCB corresponds to each task and avoid confusion when assembling the components. During this process, I also labeled each section of the sorting boxes, making sure that every part is placed in its appropriate category for easy access later.



In addition to sorting the PCBs, I also created sorting boxes to further organize the components based on type. This will help streamline our workflow during assembly, as we can quickly grab the necessary components without wasting time searching for them. The boxes were labeled carefully to reflect the part types, which will make it easier for everyone in the team to identify and access the parts they need.

Today’s work focused on organizing and labeling our components to ensure a smooth and efficient assembly process. I tidied up the lab, obtained labelling materials from the ECE shop, sorted the three types of PCBs, and created sorting boxes to store the components. By taking these steps, we are preparing for a more streamlined workflow in the coming weeks, helping us avoid confusion and delays when assembling the PCBs.

#### Entry 4: -----------------------------------------------------------------

Date: March 27
Start Time: 6:00 pm
Duration: 2 hours

Content:

Today, I focused on cleaning and organizing the workspace to ensure a more efficient and effective environment for our upcoming work. The first step was cleaning the lab desks, as there was some clutter that needed to be removed. With a clean space, it will be easier to keep track of our components and tools during assembly.



After tidying up the workstations, I went to the ECE shop to collect labelling materials. These items will be crucial for organizing the parts more effectively, as it will allow us to clearly mark different components and keep everything in its proper place. I also made sure to gather extra supplies in case we needed more labels during the next few weeks.



Once I returned to the lab, I began sorting the three types of PCBs we have. It was important to organize them by type, as each will have different components and processes associated with them. This will make the assembly process smoother, and ensure that we can quickly identify the right PCB for each task. The sorting process also involved labeling each section to avoid any confusion when we begin working on them.



Today’s work focused primarily on creating a more organized and efficient workspace. By cleaning the lab desks, gathering labeling materials, and sorting the three types of PCBs, we are setting ourselves up for a smoother and more streamlined assembly process. These organizational tasks are crucial as they lay the groundwork for a more productive work environment, allowing us to focus on the technical aspects of the project in the coming weeks.

#### Entry 3: -----------------------------------------------------------------

Date: March 26
Start Time: 9:30 am
Duration: 2 hours

Content:
Today was ManLab, so we had a lot to discuss as a team following the break and moving forward.
Dr. Walter told us to begin sorting and organizing our parts, so I decided to grab some chem cups from the drawer and empty out some of the component boxes so that it would be much easier to store parts in there.
I saw Dr. Walter's announcement on the brightspace about the soldering workshop, and I think it would be good for my team to join and learn the surface mount solder as well as the



I notified by teammates on the software we were using, just so they knew to show up to one of these sessions.
Completed footprint verification on the front panel, using a ruler and calipers to measure exact lengths of parts. Printed out to-do checklists for soldering components.
Got the UPS tracking link from Brian and looked at the estimated arrival date of the package. The tracking link said that the package would arrive Thursday around 11:00 AM, maybe later. In the meantime, we have to prepare for the soldering the components.



Parts would come around Thursday or Friday, and we are still waiting on some parts next week. I was still unsuccessful in printing out the layouts, I will have to transition to black and white and find a way to print all the necessary components while leaving the unnecessary ones.

Despite previous challenges with printing layouts due to ink shortages, I attempted to print the necessary component layouts today. However, the printer issues persisted. As an alternative, I plan to print the layouts in black and white, selectively including only the essential components to conserve resources. This approach will provide us with the necessary references while we await the resolution of the printer's ink supply.

As we progress, our focus remains on meticulous preparation and organization. By addressing these foundational tasks now, we aim to facilitate a seamless assembly process and ensure the overall success of our project.

Citations:
- 1: Dr. Walter's Brightspace Announcements (https://www.purdue.edu/brightspace/Workshops.php)
- 2: UPS Tracking Information (https://www.ups.com/track?loc=en_US)

#### Entry 2: -----------------------------------------------------------------

Date: March 25
Start Time: 6:00 pm
Duration: 2 hours

Content:

Ensuring the accuracy of our PCB assembly process is crucial, so today, I worked on developing a detailed checklist for verifying every aspect of our 25 ordered PCBs. The goal was to establish a systematic method for inspecting each board before moving forward with soldering and testing.



The checklist was created by identifying key areas that required verification. These included footprint alignment, component orientation, solder pad sizing, and electrical connectivity. To make sure no detail was overlooked, I referenced Professor Walter’s slides, past project documentation, and manufacturer datasheets to define specific checkpoints. Each section of the checklist corresponds to a critical PCB element, such as ensuring that all capacitors and resistors are correctly placed, verifying pin-1 indicators for ICs, and checking the silkscreen labels for accuracy.



One of the most critical aspects of verification was checking the orientation of polarized components. Components like diodes, LEDs, electrolytic capacitors, and ICs can be rendered unusable or even damage the circuit if incorrectly placed. I systematically checked the footprint markings against the schematic and datasheets to confirm alignment. For example, the QFN I/O Expander had a small dot marking pin 1, which needed to match the designated corner on the PCB. Additionally, the Sink Drivers had a specific orientation that, if flipped, would result in incorrect logic signals. Catching these issues now helps prevent costly debugging later.

To make verification easier for the entire team, I printed physical copies of the checklist and included annotated diagrams highlighting key concerns. Each board will be inspected using this checklist before soldering begins. As I worked through the initial verification process, I noticed that some silkscreen labels were slightly misaligned with their corresponding components. Although this won’t affect functionality, it could lead to confusion during assembly. I made a note of this and will discuss potential fixes with the team.

Once the checklist was fully compiled, I began marking off verified components on a printed layout. Each confirmed part was checked against both the PCB design software and the physical board to ensure consistency. This approach guarantees that any errors are caught before they become irreversible during soldering.

With the checklist and orientation verification complete, the next step is to have all team members follow the same procedure before soldering begins. By maintaining strict adherence to this process, we can ensure that our PCBs function correctly and avoid unnecessary troubleshooting. Moving forward, I will continue verifying additional boards while also preparing the I2C communication setup for testing the assembled boards.

Citations:
- 1: PCB verification guidelines (https://www.wevolver.com/article/test-pcb-everything-you-need-to-know)
- 2: The FFC Connector - 3: The Switch(es) - 4: The Button(s) - 5: The QFN I/O Expander - 6: The Sink Drivers - 7: The Reverse LEDs

#### Entry 1: -----------------------------------------------------------------

Date: March 24
Start Time: 9:30 am
Duration: 2 hours

Content:

To ensure a more organized workflow, I dedicated time today to sorting all the components into their respective storage boxes. With a variety of parts needed for assembly, it was essential to categorize everything properly to avoid confusion during the soldering process. Each component was carefully placed in a labeled section, making retrieval easier for future work sessions.

Once the sorting was complete, I selected the necessary components to take home for further testing and preparation. This would allow me to continue working outside the lab, ensuring steady progress on the project. By having the required parts readily available, I can begin preliminary assembly and verification before our next session.

The organization of components not only optimizes efficiency but also minimizes the risk of misplacing critical parts. With everything in place, the next steps will focus on testing individual components and integrating them into the system.

  

Citations:
- 1: Component organization
- 2: Sorting and labeling
- 3: Component selection for home testing

## =============== Week 10: =================

#### Entry 3: -----------------------------------------------------------------

Date: March 19
Start Time: 9:00 am
Duration: 2 hours

Content:
Today, I needed to organize all of our parts so that we would have an easier time finding components when soldering. I first went up to the ECE shop to look for some of the ones which we were missing, since we received all the shipments of parts.
I got the needed components from the shop, as well as a bunch of labelling items which would be good for organization. I labelled our work areas so that the workflow would be smoother, and I sorted all the appropriate components into the empty sorting boxes, which I emptied out earlier. This was tedious work, but it was necessary in order to maintain order for the rest of the 5 weeks and the project.

Today, I focused on organizing our workspace to improve efficiency during the soldering process. With all shipments of parts received, the first step was to visit the ECE shop to collect any missing components. Additionally, labeling materials were acquired to help streamline organization.

To create a more structured workflow, work areas were labeled, and components were carefully sorted into empty storage boxes that had been cleared earlier. This process, though tedious, was essential for maintaining order throughout the remaining five weeks of the project.

After organizing, tools and equipment were rearranged to ensure that our lab bench was cleaner and more accessible. By optimizing the layout, the team will be able to quickly locate necessary items during assembly and testing.

Images of the reorganized workspace can be seen below.





After doing all this week during the first half of the week of Spring break, I decided to take a break for the remainder of the week, because it was break. This is why my total hours for this week does not reach 8-12, because I was on break for the half of it.

Citations:
- 1: ECE shop
- 2: Empty storage boxes

#### Entry 2: -----------------------------------------------------------------

Date: March 18
Start Time: 9:30 am
Duration: 3 hours

Content:
Today, I hope that the printer is fresh in Ink so that I can final complete verification of the components on the front panel. I went to print from the printer, but it refused to print again because it was still low on ink. I will have to do it during tomorrow or Wednesday's session.
In the meantime, I can get a PDF of a checklist for the things we must do for each PCB completed, since I know there is a lot of verification that must go through each of the 25 PCBs which we ordered. After this, I can get started on the I2C Rust code to read each of the values from the breadboard/PCB layout. I made a new checklist based on the information Professor Walter provided on the slides.
I made a word document for checking the relevant parts of our PCB, in the form of a checklist. We will hopefully use this checklist when soldering each of our boards.
An image of the notion so page with additions for soldering can be found below.



I printed this out and we will use it to solder the components.

With documentation in place, attention will next turn to implementing I2C communication using Rust to read values from the breadboard and PCB layout. This step is crucial for testing and integrating hardware functionality.

An image of the updated Notion page with soldering-related additions can be seen below.

#### Entry 1: -----------------------------------------------------------------

Date: March 15
Start Time: 3:00 pm
Duration: 2 hours

Content:
Today, I needed to get the last footprints verified on the front panel. I arrived and check if all of PCB files had been verified, which they hadn't, so I printed the layout of the front panel out via the printer in the lab.
The printer gave me the following output, and I already had a list of the parts on the schematic, so I was able to start verifying that everything was correct. In total, I printed 3 copies so there was a margin for error.



When printing, the printer ran out of yellow ink and the colors which we needed to verify (likely because other people were using it), so I had to reprint in black and white to ensure this got completed. I reprinted with black and white, and all of my papers looked as below.



I realized that the printer was completely out of ink, so I needed to wait until the course staff refilled it before printing out the new layouts. In the meantime, I wrote out all of the specifications for the LED count on the whiteboard, just so we could have it.
I didn't want any of my team members to be confused with the number of signals, so I wrote out all three types of signals, their counts, and the reductions we were doing with the I/O Expanders. This worked out well, and we now have a permanent reference within the lab when late nights occur.
A photo of the specifications can be seen below.



Because I couldn't verify the layouts, I decided just to write the details (height and width) of the remaining components that needed to be verified. These included:

- The FFC Connector - The Switch(es) - The Button(s) - The QFN I/O Expander - The Sink Drivers - The Reverse LEDs

I successfully wrote down all the measurements of these components, which can be seen below.
To do this, I accessed the relevant parts of the datasheet and got the proper measurements, and this process can be also seen below in the top photo, where the photo of all the measurements can be seen in the bottom.
After this, I checked my email to look if Professor Walter gave us the feedback we needed to make modifications to our design.

I decided to begin the process of cleaning up the lab in order to get ready for PCB manufacturing. I decided to erase the whiteboard which we originally had the address numbering and amount of LED needed, so we would have more space to design the final software which would go into our implementation. The photo of the whiteboard which I erased can be seen below.



Finalizing the front panel’s footprint verification required ensuring all PCB files were properly checked. Since some had not been verified, a printed layout was necessary, but printer issues complicated the process. Initially, the color printout failed due to a lack of yellow ink, forcing a black-and-white reprint. When the printer ran entirely out of ink, further prints had to be postponed until course staff refilled it.

While waiting, LED signal specifications were documented on the whiteboard to serve as a reference for the team during late-night work sessions. Additionally, key component measurements—such as The FFC Connector, The Switch(es), The Button(s), The QFN I/O Expander, The Sink Drivers, and The Reverse LEDs—were manually recorded using datasheets. This ensured that verification could proceed efficiently once printing resumed.

Afterward, an email check confirmed no immediate feedback from Professor Walter. To prepare for PCB manufacturing, the lab was cleaned, and the whiteboard was erased to make room for software design discussions. With these steps completed, the next focus will be finalizing verifications and implementing the software for the project’s hardware integration.

## =============== Week 9: =================

#### Entry 4: -----------------------------------------------------------------

Date: March 14
Start Time: 9:00 am
Duration: 3.5 hours

Content:
I need to finish up the PCB tonight, so my team will likely for a good portion of the night getting things done. I went looking for the AD2 as well as the cable, because they got misplaced on the table. I also realized it is much faster to leave everything within the Senior design lab in the future.
I swapped all the silkscreen footprints on the board to be F.Fab prints, just so we wouldn't get confused in the future. The new board looks as such.
I set up the Buck Converter based on an LMC555 Timer Switching Regulator, which worked so some degree, although not giving us the proper output. The layout can be seen on the Breadboard below.



I also took the time to put all of the decoupling resistors between each of the 44 lines on the RP2350. It took a while because I crimped all of the wires, but in the end, it was worthwhile.
A photo can be seen below.



Afterwards, I needed to do budget cuts and estimations, to make sure my team wasn't going too over the budget. I put in all the production files into JLCPCB, as well as the alluminium cartridges. The following estimates are seen in the next 3 pictures.







In sum, we got the cost down to 426.61 dollars, but we still need to do some cost reduction.
Regardless, we sent our PCBs to print, and we got some feedback about them. It turns out we had not updated the site properly, so I had to send a follow-up with the correct files so that they could judge our new work.
A photo of the email conversation is seen below.



I had to follow a bunch of steps [1] to order from JLC, making sure everything was correct. However, there were some errors in the silkscreen.
I forgot to save my work editing the silkscreen, so a lot of my progress got wiped. I had to reset and update from PCB again, so I could trace again.
I reconfigured the mappings for the PCB (again), because I realized my board was reversed and some of the RP2350 pins were not assigned correctly. Next, I will have to look at protection diodes and protection resistors for the entire board. The Rat's nest was still looking hard to manage, so I have to reconfigure the mapping for the LEDs to make the routing simpler.
I moved some of the components such that they were basically touching each other on the board, so that we could have traces with less length.
I spent the night finalizing the PCB with my team, ensuring everything was in place. While working, I misplaced the AD2 and cable but later found them, realizing it's best to keep everything in the Senior Design Lab for efficiency. I swapped all the silkscreen footprints to F.Fab prints to avoid confusion. Additionally, I set up a Buck Converter using an LMC555 Timer Switching Regulator, but it didn’t provide the expected output. The breadboard layout can be seen above.
I also added decoupling resistors to all 44 lines on the RP2350, which took time due to crimping all the wires, but it was worth it. Afterward, I conducted budget estimations and uploaded our production files to JLCPCB, managing to reduce costs to $426.61, though more cuts are needed. We submitted our PCBs for printing but had to resend corrected files after realizing an update issue. An email exchange regarding this is shown above.
While ordering from JLC, I noticed silkscreen errors due to unsaved work, forcing me to redo the edits and update the PCB mappings. I also corrected misassigned RP2350 pins and worked on protection diodes and resistors. The Rat’s nest was still complex, so I adjusted LED mappings and moved components closer to shorten trace lengths, simplifying routing.

Citations:
- 1: Fabrication Toolkit (https://github.com/bennymeg/Fabrication-Toolkit)
- 2: Gerber file generation (https://jlcpcb.com/help/article/how-to-generate-gerber-and-drill-files-in-kicad-7)
- 3: PCBA Assembly on Layout Boards (https://jlcpcb.com/parts/bom-tool-res/?fileAccessId=8d6afaca485e420e973a054ac8c8b47b)
- 4: Quote generator for PCBA (https://cart.jlcpcb.com/quote?orderType=1&stencilLayer=2&stencilWidth=100&stencilLength=100&stencilCounts=5)

#### Entry 3: -----------------------------------------------------------------

Date: March 12
Start Time: 9:30 am
Duration: 2.5 hours

Content:
I got started on the datasheet verification part of the PCB checklist today. I remembered how important that each datasheet was successfully in the project archives of our project.
The datasheets needed to accumulate are listed below and can also be found in the photo below.

- Buttons - FS...
- DDR4 - 101...
- DDR4 - 101...
- FFC - 50178...
- Inductor - D...
- LEDs - AA35...
- Micro - RP2...
- os.pdf
- Oscillator - ...
- Power Induc...
- Power Switch...
- Slide Switch...
- tlc59211.pdf
- USB4125 Product...

The provided image gives a good reference to the task I needed to complete.



I had to find all the datasheets online, get the links and download them to a project directory, then upload those links both to KiCad and the BOM, so that we had everything organized.
After this, I needed to complete footprint verification on all of our parts. Because we had pretty common parts, I thought it best to just measure the printout and make sure it matched, as it was unlikely they would mess up the components.
A photo of all the printed out Layouts and schematics can be seen below.



I messed up the layout of the card, and forgot to print the back layer so some of the footprints were invisible. Because of this, I needed to reprint only the card. I printed 5 copies so that we would have plenty to cross-reference. The newly printed cards can be seen below.



First, I compared the components on the card. There were several important components, including the oscillator, the RP2350, the 3.3V LDO, and the Power Inductors and Diodes. I wrote down all the pieces that needed verification on the back of the schematic paper, and got to work.



I also had access to the backplane layout, so I decided to finish writing all of those components out as well. The major components were the FFC connectors, the edge connectors, and the switching regulator.



Below you can see me carefully measuring out and recording the lengths and widths of the given parts. I followed this guidance online [1] to complete the task.



I started working on the datasheet verification portion of the PCB checklist today. I recalled how crucial it was to have each datasheet successfully archived within our project records. The list of datasheets I needed to gather included components such as buttons, DDR4 modules, FFC connectors, inductors, LEDs, microcontrollers, oscillators, power inductors, power switches, and slide switches. These documents provided essential technical details to ensure proper implementation and compatibility within our design. A reference image displaying the required datasheets can be seen above, which helped me keep track of the verification process.
Once I located all the necessary datasheets, I proceeded to download and organize them into the project directory. I also uploaded these links into both KiCad and the Bill of Materials (BOM) to maintain a structured documentation system. After completing the datasheet verification, I moved on to the footprint verification of all parts. Since we were using relatively common components, I decided to measure the printout and cross-check it with the actual dimensions, as significant discrepancies were unlikely. However, I forgot to print the back layer of the card, causing some footprints to be invisible. To correct this, I reprinted five copies to ensure accuracy and provide ample reference material. The revised printouts were much clearer and ready for verification.
I then began comparing critical components on the front panel card. Key parts included the oscillator, RP2350 microcontroller, 3.3V LDO, power inductors, and diodes. To ensure accuracy, I documented verification details on the back of the schematic paper before proceeding with the measurements. Additionally, since I had access to the backplane layout, I decided to complete the component verification for that section as well, focusing on FFC connectors, edge connectors, and the switching regulator. Using precise measurement techniques, I carefully recorded the dimensions of each component and referenced a guidance document to ensure everything aligned properly. The provided images above illustrate the meticulous verification process I followed to confirm the PCB design’s accuracy.

Citations:
- 1: Verification Guidance (https://www.linkedin.com/advice/0/what-best-practices-tips-verifying)

#### Entry 2: -----------------------------------------------------------------

Date: March 11
Start Time: 8:30 pm
Duration: 2 hours

Content:
I talked with Brian about changes to the KiCad files. All the footprint models had been inserted. Now, I need to convert the front panel back into KiCad 8.0.0.
I got a merge conflict when pulling from main, so I decided to use the modified files from main to do all the operations. The merge conflict can be seen in the photo below.



Made a file called "KiCad Deprecation" which I will use to deprecate files from KiCad 9.0.0 to KiCad 8.0.0. I will basically copy paste structures into the google doc and export them back into new project files. I will do this for every component I need to.
This worked for some of the layout components, as you can clearly see I was able to paste a switch into the PCB editor in the photo below.



I also recreated the I/O expanders and passed the electrical rules check like previously, such that we could get started on the layout. The whole (NEW) schematic can be seen below, as well as the passed ERC rules check.
I had to find the severity rules in KiCad to determine which errors could be successfully ignored. I ignored three errors in the Electrical Rules Check, namely these three:
- Conflict Problems between Pins
- Library Symbol Editor
- More than one name given to bus or net
I do not think these warnings will cause as issue, and we have records of them if they do. I finished the re-remapping of the pins based on Brian's new PIO logic and Seth's specifications, which made the connectors look like in the following photo.



After completing the entire schematic based on the one I already made, the completed routing looked like below:



To complete this routing, it took a lot of steps:

- I needed to place parallel traces for all of the lines to indicate that a signal was going through because we wanted to minimize EMI interference.
- For the signal lines on the FFC, vias were used to take advantage of perpendicular traces and routing each object 1 to 1
- For the power system, all the heavy power lines were placed near the top of the schematic.

After initially placing the schematic, the Rat's nest looked like the following picture, which was initially very intimidating to route correctly.



After routing everything to the specifications I detailed above (which took a while), I was able to silkscreen our group's name as well as the prototype revision and project name, leading to a completed back panel.
This was good work, and let me control on the front panel, which was by far the hardest design. A photo of the finished back panel is seen below.



I needed to complete the PCB board layout based on the schematic I created, so I opened the KiCad footprint library and manually assigned all of the footprints. There were 159 footprints missing, so I had to assign all of it.
Afterwards, I got started on making sure that the footprint library was up to data, but I had a class soon, so I needed to leave and come back.
I talked with Brian about the recent updates to the KiCad files, and he informed me that the library had been updated with all the necessary footprint models inserted. My next task was to convert the front panel back to KiCad 8.0.0, ensuring compatibility with our project. While pulling from the main branch, I encountered a merge conflict, so I opted to use the modified files from the main branch as a reference for my work. The conflict can be seen in the screenshot provided above, showing the differences in versioning.
To resolve compatibility issues, I created a "KiCad Deprecation" file, where I manually copied and pasted structures into a Google Doc for conversion before exporting them back into new project files. This method worked successfully for some of the layout components, as evidenced by my ability to insert a switch into the PCB editor. Once I restructured the necessary components, I recreated the I/O expanders, ensuring they passed the Electrical Rules Check (ERC). I carefully reviewed the severity rules in KiCad to determine which errors could be ignored, and I ultimately chose to ignore three non-critical warnings, as they did not impact functionality.
After finalizing the schematic updates, I proceeded with routing the PCB layout. The revised schematic now included updated PIO mappings based on Brian’s logic and Seth’s specifications. The completed routing process required several strategic steps: I placed parallel traces for signals to minimize EMI interference, used vias for signal routing on the FFC connector, and ensured heavy power lines were positioned at the top of the schematic. Initially, the Rat’s Nest looked overwhelming, but after carefully following the outlined routing strategy, I managed to organize everything efficiently.
Once the routing was complete, I finalized the silkscreen labels, adding our group’s name, prototype revision, and project title to the back panel design. This step marked significant progress, as the back panel was now fully designed, allowing me to shift focus toward the front panel, which posed the greatest design challenge. The completed back panel layout can be seen in the photo above, demonstrating the successful implementation of all required elements.

Citations:
- 1: Parallel Traces Guidelines (https://forum.kicad.info/t/parallel-zigzag-traces-and-outline-edge-cut/51541)

#### Entry 1: -----------------------------------------------------------------

Date: March 10
Start Time: 9:30 am
Duration: 4 hours

Content:
During this team meeting, I needed to finalize the hardware prototypes and reconfigure the PCB for easier routing. I know that this week our PCB is due, but during mandatory lab we will probably just have a Soldering workshop, and since I am pretty well versed in soldering, I think that I should put most of the emphasis on the PCB.
After I finish all of the PCB action items, then I can show my work to Professor Walter on Wednesday for him and the staff to verify this before printing, because our PCB printing is quit special.
I began with trying to reroute the PCB, so it would be easier to trace. Obviously, I had to change some of the PIO mappings.
I forgot to delete the second layer when I went to reroute the PCB, so I had to backtrack and get rid of it.
By completing the route of the backside of the PCB first, I was able to drastically reduce the amount of traces needed. I originally thought to make my traces like the first PCB I did, but the routes would have been far too confusing.
I made the mistake of forgetting to change the side of the board before routing, so I had to manually go through and fix all of that.
Downloaded the QFN Footprint [1] for the MCP23017. This will make it easier to route, as well as the presence of less EMI. Link is provided in the references, but this is what it looks like. I plan to place this component at a 45 degree angle so the expansion covers more area per track width.
On the hardware prototypes side, which I switched back to after Brian took over some of the routing after I pushed my changes, I placed an AD2 breakout [1] onto the breadboard such that I had an easier way to debug the entire thing, and a way to protect again incidental shorts.
You can see the AD2 breakout in photo below.



I set up the GPIO lanes such that they were each configured to a PIO pins when the PICO 2 was set to the edge of the breadboard. This would make it so we could always place it easily and did not have to worry about any incorrect pinnings. I took special care to follow this pinout [3] to make sure it was correct, meticulously mapping each of the 28 pins.



I thought that parasitic capacitance would still be an issue, because when I used the DP switches, multiple lights were lighting up, so I decided to change the wire length to make sure there was no electric interference between signals. I placed higher, longer wires like in the photo below.



It turned out that the parasitic capacitance was not inside the wires, but inside the DP switches, which there was nothing I could do about. When our team orders the entire board, we will not have to worry about this parasitic capacitance, as all of the switches will be spaced out enough to disregard any substantial effects of EMI.
I routed the rest of the PIOs on the left hand side of the Pico 2 (Looking down from the text side of the breadboard), which gave me the exact number of PIOs necessary. This was quite a stroke of luck, as we did not have ANY to spare. the longer wires were used, as can be seen in the photo below.



After a lot of meticulous routing and proper procedure, the entire front panel prototype was complete.
I tested each of the switches and the LEDs to make sure they worked, and there was no present short, meaning the IO expanders were fulfilling their purpose and we could move entirely to the routing portion of the PCB design for the rest of the week.
The entire front panel schematic, in its glory, is seen in the picture below.



Next, I resumed my work on the PCB design for all (3) cards. I figured out that a global label would override a NET, so I decided to remove one of the nets on the I2C Lines. This was successful, and I continued making several routing into placement changes for the PCB I took a look at my old ECE 20008 Buck Converter Lab, just so I knew what to reconfigure to get our desired output. I plan to make 3 prototypes: One using an LM1117, one using an LMC555 Timer, and one with our desired chip.
I went to the ECE shop to see if they restocked on the MCP16331, or any switching regulator chips, but it did not look like it. I think I will have to put in an order for 1-3 of a chip or something similar.
During this team meeting, I focused on finalizing the hardware prototypes and refining the PCB layout for easier routing. With the PCB submission deadline approaching, I prioritized layout improvements over the upcoming mandatory soldering workshop, as I’m already proficient in soldering. My plan was to complete all necessary PCB tasks before presenting my work to Professor Walter on Wednesday for verification, given the specialized nature of our PCB printing process.
I started by re-routing the PCB to simplify trace routing, which required modifying some PIO mappings. Initially, I forgot to delete the second layer before re-routing, leading to some backtracking. However, by routing the backside of the PCB first, I significantly reduced the number of required traces and avoided the confusion of my initial routing approach. I also mistakenly routed some traces on the wrong side of the board, which I had to manually correct. To improve routing efficiency and reduce EMI, I downloaded the QFN footprint for the MCP23017 and positioned it at a 45-degree angle. This placement should allow for better track width distribution and optimize signal flow across the PCB.
Once Brian took over some of the PCB routing, I returned to hardware prototyping. I placed an AD2 breakout onto the breadboard to facilitate easier debugging and provide protection against accidental shorts. To ensure correct pin mapping, I configured the GPIO lanes so that each pin was aligned with the Pico 2 at the edge of the breadboard. I meticulously followed the pinout reference to verify the correct mapping of all 28 pins. While testing the DP switches, I noticed multiple LEDs lighting up unexpectedly, suggesting parasitic capacitance issues. Initially, I suspected that wire length was the cause, so I adjusted the wire layout to minimize interference. However, after further investigation, I determined that the parasitic capacitance was within the DP switches themselves, not the wiring. This won’t be an issue in the final PCB design, as the switches will be adequately spaced to mitigate EMI effects.
After meticulous routing and adherence to best practices, the front panel prototype was completed. I thoroughly tested each switch and LED, confirming that there were no shorts and that the I/O expanders functioned correctly. This success allowed us to shift our focus entirely to PCB routing for the remainder of the week. Resuming PCB design, I discovered that global labels override NET names, so I removed one of the redundant I2C nets, which resolved a conflict. I also made several placement and routing optimizations to improve board layout efficiency.
To refine our Buck Converter design, I reviewed my old ECE 20008 lab notes to determine necessary modifications for achieving our target output. I plan to prototype three different designs: (1) LM1117-based regulator, (2) LMC555 Timer-based solution, and (3) Final design with our intended switching regulator. I checked the ECE shop for the MCP16331 or other switching regulators, but none were in stock. I will likely need to place an order for 1–3 suitable components to proceed with testing.

Citations:
- 1: AD2 Breakout Information (https://www.amazon.com/Digilent-Breadboard-Breakout-Analog-Discovery/dp/B07Q5SGSVQ)
- 2: MCP23017 QFN Mount (https://www.digikey.com/en/models/894270)
- 3: Pico 2 Pinout

## =============== Week 8: =================

#### Entry 4: -----------------------------------------------------------------

Date: March 6
Start Time: 9:30 am
Duration: 3 hours

Content:
I attended one of the review sessions which was required for the Midterm design review.
I asked the question of if the current team which was presenting (Team 2), was prepared for ESD protection for the user, just in the worst case that their input power or Buck Converter shorted.
This review presentation session took place from 10:30 - 11:20, where I learned team 2's idea for translation glasses, which would have a PCB attached to the left of a pair of glasses.
After this peer review, I attended another peer review session for team 18, Grid Wars, whose idea was to recreate grid wars with a microcontroller and RFID input devices.
They decided to use a ESP32-PICO as well as a Raspberry Pi 4. One of the major questions I asked during the presentation, which response gave me some information to put in the survey, the distinction between the many grounds on the schematic.
Another thing which I noticed was that they would be very financially or technologically constrained when making more cards for their game. After making these remarks on other team, I returned back to the lab to continue with my own senior design project. Firstly, I got a collection of other LEDs which I was to use on the front panel prototype. The yellow LEDs were to act as STATUS LEDs, and the green LEDs were to act as Data LEDs.
You can see that I grabbed the appropriate amount of both and placed them on the table in the image below.



Afterwards, I started wiring up the chips. I wanted to reduce parasitic capacitance and inductance, so I chose the shortest length wires I could to reduce parasitic inductance, and tried to space out my traces such that they would not as impacted by parasitic capacitance. In the photo below, you can see my attempts.



I took a break from the hardware prototyping to check that the backplane had been properly version controlled. Some of my changes had been overwritten, so I had to take the time inside the git log page to see the changes that were applied and backtrack the ones that should not have been applied. All in all, there was just on commit which was interfering, the bottom merge branch in the photo below.



After this, I decided to refresh my layout knowledge. On top of Professor Walter's existing slides, I also read these documents [1] on proper orientation and looked at the buck converter's layout [2] again, which would be by far the most important section of the layout.
Today, I attended the required midterm design review session, where I observed presentations from two teams. During Team 2’s session, I inquired about their ESD protection strategy in case of a power short, particularly with their Buck Converter. Their project involved translation glasses with an attached PCB, which provided insight into their approach to compact circuit design. Later, I joined Team 18’s presentation on "Grid Wars," a microcontroller-based RFID game. I asked about the distinctions between the multiple grounds in their schematic and noted potential financial and technical constraints in manufacturing additional game cards.
After these sessions, I returned to the lab to continue work on my senior design project. I gathered LEDs for the front panel prototype—yellow for STATUS indicators and green for DATA indicators—ensuring the correct quantities were available. Once collected, I began wiring the chips while focusing on minimizing parasitic capacitance and inductance. To achieve this, I used the shortest possible wires and spaced out the traces effectively to reduce unwanted electrical interference.
I briefly paused hardware prototyping to review the backplane’s version control. Some of my changes had been unintentionally overwritten, so I analyzed the Git log to identify and revert any unnecessary modifications. Fortunately, only a single interfering commit required adjustment, which I resolved by tracking and restoring the correct files. This step ensured that all recent progress remained intact without unexpected regressions.
To reinforce my PCB layout approach, I revisited Professor Walter’s lecture slides alongside external layout references. I also revisited documentation on proper component orientation and re-examined the Buck Converter’s layout, as it remains one of the most critical elements of the design. Moving forward, I will focus on refining the PCB layout and preparing for final testing.

Citations:
- 1: JLCPCB Design Guide (https://www.google.com/search?q=pcb+layout+design&rlz=1C1OPNX_enUS1145US1145&oq=PCB+Layout+&sourceid=chrome)
- 2: MCP16331 Buck Converter (https://www.microchip.com/en-us/product/mcp16331)

#### Entry 3: -----------------------------------------------------------------

Date: March 5
Start Time: 9:30 am
Duration: 2 hours

Content:
Today, I needed to completely finish the hardware prototypes of all of the circuit boards. First, I looked around for the proper buttons which I needed in order to mount them onto the breadboard.
I found both the SMD and THT mounted components which were needed to complete assembly, but I had to look a little harder in order to find the breadboard buttons which I needed. Eventually, after searching the leftmost cabinet on the left side of the lab, I was able to locate the buttons seen in the photo below.



The buttons had this datasheet [1], and I needed exactly 14 of them to route each of the control signals which the user could control on the front panel. I selected these buttons, and layed them out in the following way:

- Each button on the left hand side of the breadboard would receive a wire from the voltage line, and a route to the other side such that it could be connected to the I2C expander.
- Each button on the right hand side of the breadboard would receive a simple power and ground such that it could be directly routed in the same way.

After completing the routing, the breadboard had the following initial state. As you can see, all of the components have been placed in a way that everything can be easily routed, which is something I want to mimic when I go to finalize the PCB designs.



More layout was completed, and all the chips were fastened onto the breadboard. Additionally, I tested all the power and ground lines just to make sure all the chips were fully functionally and that there were no internal shorts within the circuitry. I completed this step so that it would save us time in the long run, and would take less time to debug overall. The final project looked as below.



I used this guide [2] to follow some general breadboarding techniques. After this was completed, It was time to complete some wiring on the breadboard.
After all of this was completed, I proceded to start touching up the midterm design review slides.
Today, I focused on completing the hardware prototypes for all circuit boards. I started by searching for the necessary buttons to mount onto the breadboard, eventually locating the required SMD, THT, and breadboard-compatible components in the leftmost cabinet of the lab. I needed exactly 14 buttons to route control signals for the front panel, ensuring that each was positioned for efficient wiring. The left-side buttons were connected to the voltage line and routed to the I2C expander, while the right-side buttons received a direct power and ground connection.
Once the initial layout was complete, I carefully placed all components to optimize routing and minimize complexity, a strategy I plan to apply when finalizing the PCB design. With the components secured, I tested the power and ground lines to confirm functionality and check for internal shorts. This proactive step aimed to prevent debugging issues later in the process. Ensuring that all chips were properly fastened and operational was crucial for the next stages of development.
After verifying the electrical connections, I referenced a breadboarding guide to refine my approach and implement best practices. This helped streamline the assembly process and reinforce key layout principles. By following a systematic approach, I ensured that the setup was both organized and scalable for the final PCB layout.
With the breadboard assembly completed, the next step was to focus on wiring, making sure all signal paths were properly connected. This step is essential for validating the prototype’s functionality before transitioning to PCB manufacturing. Moving forward, I will refine the connections and begin testing the circuit under different conditions to ensure reliability.

Citations:
- 1: Datasheet for Tactile buttons (https://www.te.com/commerce/DocumentDelivery/DDEController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)
- 2: Breadboarding techniques (https://forum.digikey.com/t/definitive-guide-to-breadboarding-circuits/36584)

#### Entry 2: -----------------------------------------------------------------

Date: March 3
Start Time: 8:30 pm
Duration: 3 hours

Content:
I talked with Brian about changes to the KiCad files. He said that the library had been updated, and all the footprint models had been inserted. Now, I need to convert the front panel back into KiCad 8.0.0.
I got a merge conflict when pulling from main, so I decided to use the modified files from main to do all the operations. The merge conflict can be seen in the photo below.
Made a file called "KiCad Deprecation" which I will use to deprecate files from KiCad 9.0.0 to KiCad 8.0.0. I will basically copy paste structures into the text and export them back into new project files. I will do this for every component I need to.
This is based on components, so there should not exist an issue between larger chunks of code, which is my initial assumption.



I realized that copy and pasting in to KiCad would not be realistic, as when I copy pasted even a little bit of our existing schematic, the google doc shot up to 114 pages. I decided to just recreate the front board for our project, as I had already done it once.
I recreated the Schematic in KiCad 8.0.0. I made sure to avoid all the pitfalls I made the first time, and removed the useless Nets, including VREG_AVDD and VREG_LX. I also created the new expansion connector, and made sure that between each 4 busses which actually had signals, I had a power and ground, and between the lines which did not have any usable signals, I had a power and ground between every 10 pins.
I also recreated the I/O expanders and passed the electrical rules check like previously, such that we could get started on the layout. The whole (NEW) schematic can be seen below, as well as the passed ERC rules check.
There were pretty annoying violation severity which were passed into KiCad which didn't seem to matter in our final design. The criteria for the constraints were wildly away from JLCPCBs regulations, which I looked up on this website [1].
I had to find the severity rules in KiCad to determine which errors could be successfully ignored. I ignored three errors in the Electrical Rules Check, namely these three:
- Conflict Problems between Pins
- Library Symbol Editor
- More than one name given to bus or net
I do not think these warnings will cause as issue, and we have records of them if they do. The exceptions can be found in the image below.
After completing the entire schematic based on the one I already made, it looked as below. I had to remap several of the net classes such that they would be easier to solder. I did this for the following reasons:

- Before the design review, we realized we needed to get a working draft of the PCB done. However, I disregarded the fact that negligence of nets would make an entire board harder to solder.
- I realized while I was routing the PCB that some routes were vritually impossible to trace within the constraints and without the use of multiple layers.
- I read some resources online stating and reinforcing the fact that PCB design was, indeed, 90% layout. The resources I found were based on KiCad's own development team [2].

I went back into the schematic and remapped all 36 nets which were on the left hand side of the RP2350b microcontroller. This took a while, but was overall worthwhile because it made the routing of the PCB much easier. A photo of the completed new nets can be seen below.



After this, I realized that my version control, and our team's entire version control for the whole project, was very lacking. I encouraged everyone to use GitHub Desktop, as it allowed us to contribute on multiple KiCad files without the use of the terminal and with very little merge conflicts. I had tried git through the terminal in the past, but it wasn't as fast or comprehensive. I installed Github Desktop from this link [3], and encouraged my teammates too as well. An image of the installation can be seen below.



After working on the front panel for so long, I decided it would be nice for a change to work on the back panel. But first, I needed to create global labels for each of the signals that were going into our Emulator bus. I had the following logic:

- Bold format for any single signal that would not be regularly accessed by the user.
- Normal format on a global label for a signal that would active on the front panel and actively used by the user.

I got started on these mappings for all 44 signals which required this criteria, as seen in the photo below.



I needed to complete the PCB board layout based on the schematic I created, so I opened the KiCad footprint library and manually assigned all of the footprints. There were 159 footprints missing, so I had to assign all of it.
I set the following assignments for each of the parts that were missing:
- Amphenol Connector [4]
- Buck Converter [5]
- Schottsky Diode [6]
After this was complete, I went to the front panel PCB editor and started laying everything out.
In sum, discussing the KiCad file updates with Brian, I learned that the library had been updated with all the footprint models. I attempted to merge my changes but encountered a conflict, so I used the modified files from the main branch to proceed. Initially, I planned to deprecate the files by copying structures into a text document and exporting them, but the sheer volume of data made this unrealistic. Instead, I opted to manually recreate the front panel schematic in KiCad 8.0.0, refining it by removing unnecessary nets and improving the expansion connector layout.
While working on the schematic, I ensured compliance with electrical rules, ignoring three warnings that were not relevant to our final design. I also remapped 36 nets on the left side of the RP2350b microcontroller to simplify PCB routing and improve soldering feasibility. Recognizing the team's struggles with version control, I advocated for using GitHub Desktop to streamline collaboration and minimize merge conflicts. This approach offered a more intuitive workflow than using Git through the terminal.
After completing the front panel schematic, I shifted focus to the back panel. I created global labels for the signals going into our Emulator bus, implementing a formatting system to distinguish user-accessible signals from those not regularly accessed. With 44 signals requiring this mapping, I ensured consistency across the schematic to facilitate easier design navigation and organization.
Finally, I began the PCB layout process by manually assigning footprints in KiCad, as 159 components were missing their respective assignments. I referenced external datasheets to correctly set footprints for key components such as the Amphenol Connector, Buck Converter, and Schottky Diode. With the footprints assigned, I moved on to laying out the front panel PCB, ensuring optimal placement for efficient routing and assembly.

Citations:
- 1: JLCPCB Assembly Guidelines (https://jlcpcb.com/blog/pcb-basics-2-design-guidelines)
- 2: Layout Importance (https://forum.kicad.info/t/pcb-layout-strategy/51620)
- 3: Github Desktop Installer (https://docs.github.com/en/desktop/installing-and-authenticating-to-github-desktop/installing-github-desktop)
- 4: Amphenol Connector (https://cdn.amphenol-cs.com/media/wysiwyg/files/documentation/datasheet/ssio/ssio_ddr4.pdf)
- 5: Buck Converter PDF (http://ww1.microchip.com/downloads/en/DeviceDoc/20005308C.pdf)
- 6: Schottsky Diode

#### Entry 1: -----------------------------------------------------------------

Date: March 2
Start Time: 5:00 am
Duration: 3 hours

Content:
First, I needed to deprecated all our KiCad files from 9.0.0 back down to 8.0.0, following Dr. Walter's note which I saw below. I downloaded the older KiCad version of this site [1], and spent some time installing it.

- This note came as a surprise to us, as we thought that KiCad 9.0.0 would be fine in order to continue our PCB assembly, but we were very mistake. We realized that we would have to deprecate all of our things manually, and recreate everything. As such, I began to recreate the new schematic on a new ecad project within the directory, on top of the new files we had to make.
- I just saw this note 1 week into our PCB creation, so we lost a bunch of progress that could have been accumulated if we didn't make the switch to KiCad 9.0.0. However, I think that this will be helpful, as there will now be time to improve on the existing design and refine any inaccuracies that might have been there initially.

The note which Dr. Walter left us can be seen below.



I wanted to try a naive approach of just importing all the content into a text document and copy pasting that into KiCad. I first created a new google doc with my personal google drive account on the lab computer, and tried to import all of the KiCad 9.0.0 content onto that google doc. However, this did not work, as the KiCad 9.0.0 format was not backwards compatible with the KiCad 8.0.0 formatting.
I also looked at the github branch history inside Github, as I thought that there would be a matching version which was not upgraded which I could work off of in order to restore my progress. The branch history which I was trying to compare to can be seen in the image below.



I quickly realized that there was no good branch to siphon off of, as all of our changes were divergent and in separate KiCad Project directories, so there really was no synchronized version. However, at this time, the google doc finished uploading, and I was able to see all of the content of KiCad 9.0.0.
I thought that there would be a way to deprecate the content of the KiCad 9.0.0, but after I saw that there were 114 pages of content and the file size was several MB, I decided to refrain from this choice and simply recreate the front panel and back plane schematics from their respective KiCad 9.0.0 files, just deprecated to KiCad 8.0.0. A photo of the very long google doc can be found here, and the file can be seen here [1].



After this, I admitted defeat and began to work on the conversion from KiCad 9.0.0 back down to KiCad 8.0.9. I first installed the KiCad 8.0.9 installer here [2], and realized that I could have both KiCad 9.0.0 and 8.0.9 on my system. This would allow me to switch between desktops and reference the existing design I had on KiCad 9.0.0 to insert it back into KiCad 8.0.9. The existing design which I had can be seen in the image below.



Afterwards, because I knew that the midterm design review presentation was next week, I decided to work on that and upload the new files to teams. KiCad was still installing in the background, because the installer is quite large.
I create new files and made sure they were properly linked inside the teams, and go to work creating slides for the midterm design review based on the slides that were given to us within the assignment which was posted in Brightspace. Before the end of the period, I was able to create 15 slides.
After realizing that KiCad 9.0.0 was not suitable for our PCB assembly process, I had to manually deprecate all our design files back to KiCad 8.0.0. This unexpected issue caused a significant loss of progress, as we had already spent a week working in the newer version.
I initially attempted a quick workaround by importing the KiCad 9.0.0 content into a text document, but the incompatibility between formats made this approach unfeasible. Checking the GitHub branch history for an older version that could be restored also proved unsuccessful, as our changes were scattered across multiple project directories without a synchronized version.
Ultimately, I opted for a complete recreation of the front panel and backplane schematics using KiCad 8.0.0 while referencing the existing design in KiCad 9.0.0. Despite the setback, this process allowed for improvements and refinements to the schematic.
While waiting for KiCad 8.0.9 to install, I shifted focus to preparing slides for the upcoming midterm design review, ensuring that the newly created files were properly linked and uploaded. Moving forward, the priority will be finalizing the schematic conversion, verifying functionality, and continuing preparations for the presentation.

Citations:
- 1: (https://docs.google.com/document/d/1cOvcpEqkHJi-3afqtSzrdmrRLiiJ992B-ypC7sXVeEU/edit?tab=t.0)
- 2: Kicad 8.0.9 Installer (https://downloads.kicad.org/kicad/windows/explore/stable)

## =============== Week 7: =================

Date: February 27
Start Time: 9:00 am
Duration: 3 hours

Content:
First, I needed to get working Hardware prototypes of the front and back panel, so we could put the issue to rest and consolidate the rest of our efforts on PCB design and manufacturing. I got these new(ish) Breadboards from the closest in the ECE 47700 Lab, and went to the ECE shop to get more components.
The original breadboards looked like below, but I had to start over because our layout had changed.



I went around the lab looking for wire kits and breadboard rubber boards, so I asked lab staff where I could find these materials.
There were no rubber bumpers in the ECE 47700 Lab, and I got some male to male jumpers from the TA.
I started wiring up the ground planes of the breadboard, which looked like below after they were finished.



I found two new breadboards in the storage drawers, and decided to use one breadboard for the new front panel and keep the existing front panel on the breadboard, just in case. I also decided to keep the spare just in case we needed it. A photo of all the breadboards can be seen below.



I went to the ECE shop and got a variety of parts. The parts I obtained were needed for the front panel, which included: 3 DIP switches, 3 592TLC11IN Sink Drivers, 2 AD2 Breakouts, and 44 red LEDs, as well as 48 220 Ω and 470 Ω resistors. I put them all in a box, and will use the box for random part storage later on in the semester. The box can been seen below.

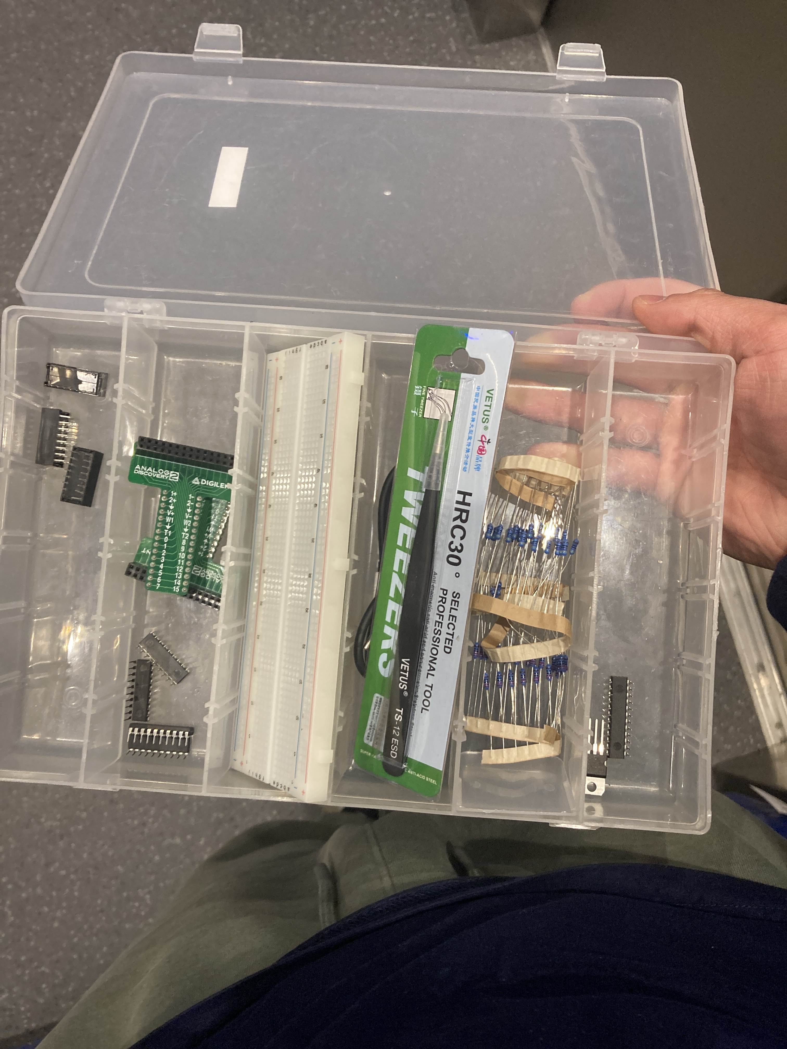
[picture p90: Team/journal/img - member4/week7/5.4.jpg]


I was actually lucky enough to find a MCP23017 I/O expander, the exact one we were using. I assume some other group was using it in their project. I looked up the datasheet here [1]. A photo can be seen below.

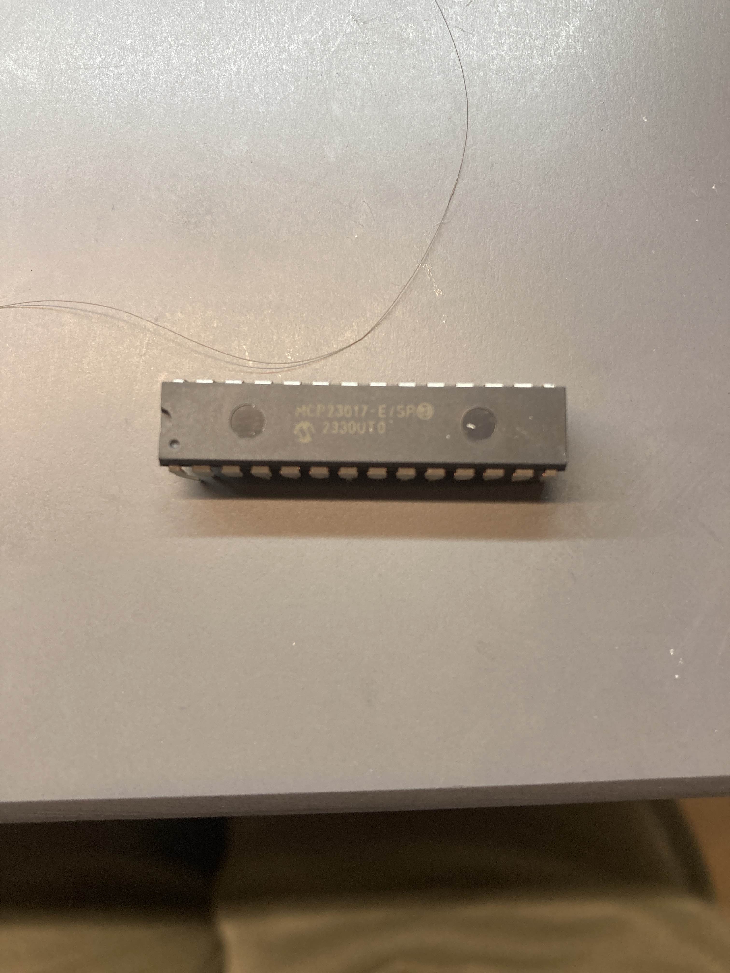
[picture p91: Team/journal/img - member4/week7/5.5.jpg]


I labeled all of the boards with white sharpie, so that we could distinguish the functionality of each of them. A photo is provided below. The labels I gave were: Front Panel (1), Front panel (2), Back Plane, and Spare.

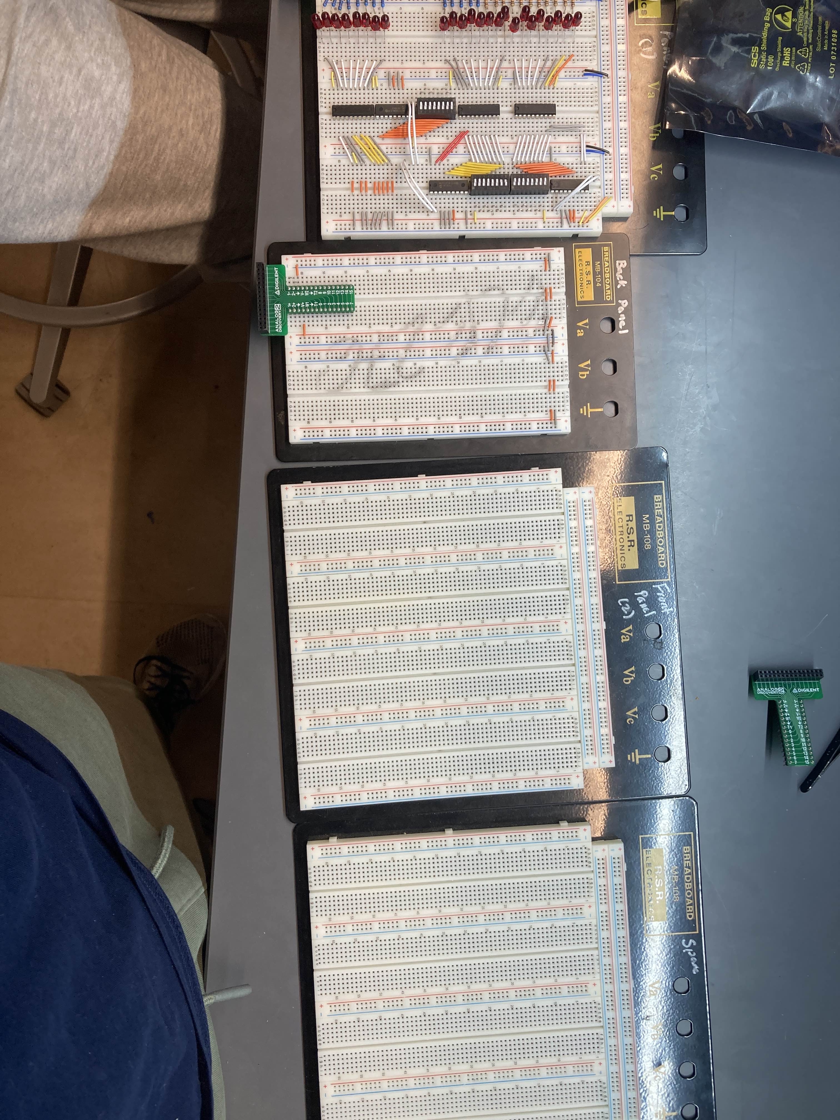
[picture p92: Team/journal/img - member4/week7/5.6.jpg]


I added the breakouts to each of the specific boards, and wired up the inputs to the AD2 breakout. Even if a short circuit occurs, this will not affect the AD2 breakout (I hope it does not occur). A photo is seen below.

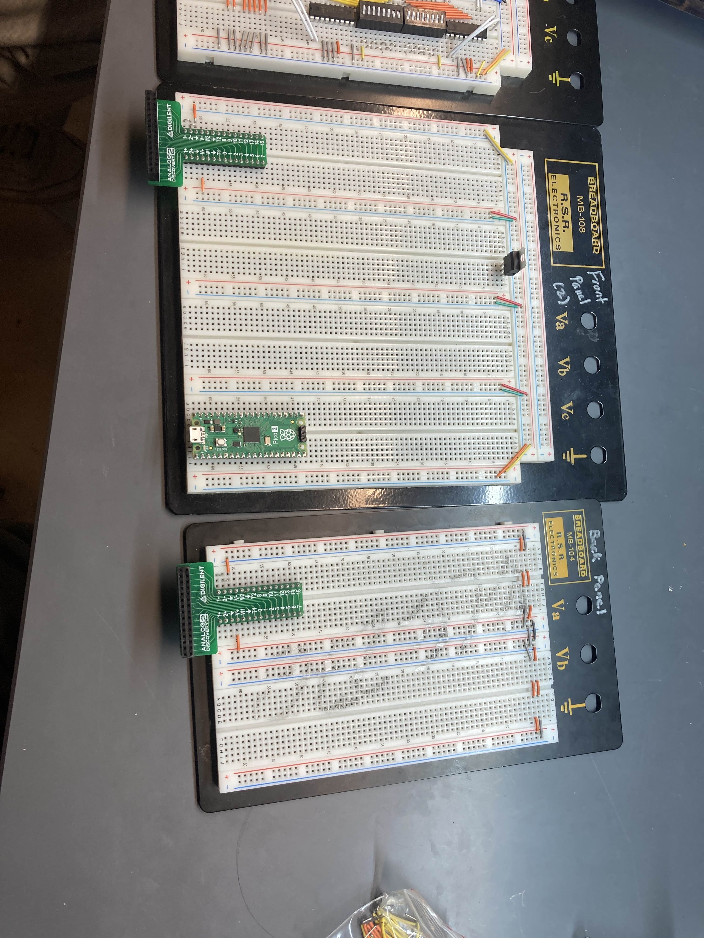
[picture p93: Team/journal/img - member4/week7/5.7.jpg]


I needed the rubber bumpers to make sure the breadboard stayed in place, so I went to the TA to ask for some. He said that they did not have the rubber bumpers, so I went to the ECE shop and got 9 of them. A photo of the rubber bumpers I obtained is seen below.



Afterwards, I applied all the rubber bumpers to the boards [2], and let them stay for a while, around 2 hours before they would set. A photo of a singular one is attached below.

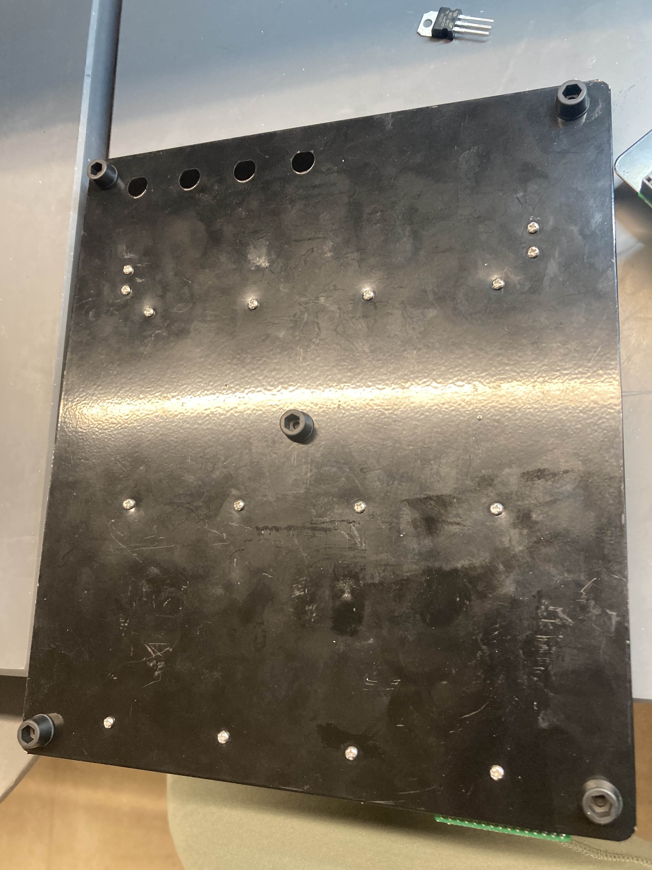
[picture p94: Team/journal/img - member4/week7/5.9.jpg]


The result was that the breadboards were set up with the necessary components, including DIP switches, TLC59211IN drivers, and AD2 breakouts, all properly wired. I was able to apply rubber bumpers to the boards to keep them stable, preparing everything for the next steps.
This contributes to the project’s progress by finalizing the hardware prototypes, which will allow us to focus more on the PCB design and manufacturing.
The next steps involve transitioning to the PCB design phase, ensuring the breadboard setup translates well into the final PCB layout. Additionally, I will keep monitoring the hardware prototypes for any issues that might arise and adjust the design as needed before manufacturing.

Citations:
- 1: Datasheet for MCP23017 (https://ww1.microchip.com/downloads/en/devicedoc/20001952c.pdf)
- 2: Cylindrical Bumper reference sheet (https://www.digikey.com/en/products/detail/keystone-electronics/728/61971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)

Date: February 26
Start Time: 9:00 pm
Duration: 1 hour

Content:
I will spend most of this session ensuring that we had a working KiCad Library for all of our schematics.
Based on my existing knowledge on KiCad libraries, I knew that each component needed a footprint and a 3D layout.
I researched most of the components online, finding four of the necessary components for our library. The four I found are listed below, with their links as reference to their right.

- ECAD for ABM8-272-T3 Model [1]
- ECAD for CONN SKT DIMM 288POS PCB [2]
- ECAD for FSM103A [3]
- ECAD for TLC59211IN [4]

I knew that I needed the electrical rules check to pass, so I needed to make efforts to ensure a PWR Flag was on every source of power where current was running through, just as Professor Walter had stated.
I kept getting the "signal not connected error", so I had to manually attached power flags to each of these signals. This process was very tedious, and might have been unnecessary in the end. I will keep it in mind on a list of procedures to avoid. The cumulative power flag grid looks as such.



Then, I needed to polish up the library. I downloaded the proper ECAD off of the internet, off the sites I listed above, and then extracted them into the 3d_models folder that was inside our directory. After that, I added them to the specific project library we had. I had no major issues with this process.



I editted the names of these files before I updated the library, just to ensure we stayed organized. KiCad would normally download the file as the date, so the file name needed to be changed in order for the files to show as their prpoper component names.



Above, you can see that each of the component libraries has the proper name, which will be important in the future.
The end result was a well-organized library with properly named and integrated components. I learned that while power flags are important, manually placing them was more work than needed, and I’ll look for ways to avoid that in the future.
Next, I’ll continue refining the schematic design, ensuring all components are correctly linked. I'll also focus on streamlining the process and avoiding unnecessary steps, like the manual placement of power flags, as the library is now in good shape.

Citations:
- 1: ABM8-272-T3 Model (https://www.digikey.com/en/products/detail/abracon-llc/ABM8-272-T3/22472366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)
- 2: Model for CONN SKT DIMM 288POS PCB (https://www.digikey.com/en/models/10233356)
- 3: Model for FSM103A (https://www.digikey.com/en/models/701085)
- 4: Model for TLC59211IN (https://www.digikey.com/en/models/2183120)

#### Entry 3: -----------------------------------------------------------------

Date: February 25
Start Time: 11:00 pm
Duration: 3 hours

Content:
This evening, I needed to finish the PCB layout of all the cards on our PCB. This meant assigning and create footprints for all the boards on our KiCad Schematic, and making sure that the schematic passed the electrical rules check.
First, I made sure that the PCB was up to date by pulling on Github desktop. KiCad 8.0 was still installed on my computer, and we migrated everything over to KiCad 9.0, so I uninstalled KiCad 8.0 from my computer.
I realized that KiCad 8.0.0 would still have some remnants, as people online were complained about, so I looked into removing it completely from my system.



I was still unsure on how to create nets in KiCad, which would streamline the wiring process, so I watched a video on YouTube [1] showing me how to do so. After watching this video, I learned more about creating a net in KiCad.
I was looking for a fast way to change reference numbers, because I know that we would have to be doing a lot of that for our very large PCB, so I asked ChatGPT how to change reference numbers quickly.
I started changing all the reference designators for our project, which I knew would take a long time. We have over 100 resistors and 50 capacitors, as well as a bunch of switches, so changing all the numbers took very long.
Next, I began to look into protection diodes to make sure our project would NEVER overcurrent or short circuit. I looked at the old Altair circuit diagrams [2] for inspiration.
Additionally, I also had to find out how to find a certain net within a KiCad schematic, so I looked it up on Google and found this article [2]. It was presented to me that we would have to use matrices to register button presses, so I started looking back into the ECE 362 matrix scanner to see how we could implement it with the 24 switches.
I decided to annotate the existing power electronics that Brian conducted in order to make the schematic more organized before we go into Layout. To do this, I needed to make regions of each schematic which detailed exactly what was occuring, so the graders would have an easier time figuring out what was what. I made five regions in the front panel, all specified below by what their functionality is.



Schematic area for switches and LEDs.



Schematic area for sink drivers.



Schematic area for scanning matrix (PDSR).



I quickly realized after I made the scanning matrix that we did not need it, as I2C communication would be enough to hit our PSDR. I knew that creating I2C communication may be a stretch, so I made sure to keep the schematic area outside the region of our paper, so it would not cause interference in the future.



Schematic area for microcontroller.
I also wanted to learn how to make the components in the schematic equally spaced, so I looked up a tutorial on that. The tutorial can be found here [3]. This was very useful, as I could now align the components to a grid.
In total, the keypad we will create will look something like below, with 4 rows and 6 columns for scanning, only using 10 of the 16 I/O pins on our expanders.
I talked with Brian about the whole layout of our board, and he told me that he was still selecting parts for use in the DIM connectors and bus lanes. I think I will organize the footprint library and try to fix the ERC errors for now.
After successfully fixing all of the ERC errors, I needed to fit the reverse mounted LED footprint such that it would fit on the back of our PCB.
This footprint was found on the digikey website [4], and I downloaded the KiCad version.



This session demonstrated significant progress in finalizing the PCB layout, requiring both technical problem-solving and organizational refinement. Migrating from KiCad 8.0 to 9.0 was a necessary step to ensure compatibility and efficiency, and researching complete removal methods highlights attention to detail in preventing software conflicts.
The effort to learn and implement nets in KiCad, as well as finding a quick way to change reference numbers, shows an emphasis on workflow optimization. Given the scale of the project—handling over 100 resistors and 50 capacitors—such efficiency improvements are crucial. The research into protection diodes and references to the old Altair circuit diagrams reinforce a strong design methodology, ensuring the project remains both functional and protected against potential faults.
Citations:
- 1: How to create nets (https://www.youtube.com/watch?v=x4gjpgTBGTo)
- 2: Finding net names in KiCad, with other tricks (https://docs.kicad.org/master/en/eeschema/eeschema_schematic_creation_and_editing.html)
- 3: Aligning to grid in KiCad (https://forum.kicad.info/t/align-parts-to-grid-in-layout/47336)
- 4: Model for Reverse mounted LEDs (https://www.digikey.com/en/models/6615712)

#### Entry 2: -----------------------------------------------------------------

Date: February 24
Start Time: 9:30 am
Duration: 4 hours

Content:
Today, I needed to update the team's website, because some of the changes I made yesterday did not stick. I first updated the documents page with A8, which Seth completed last night. I pulled this document from the teams and put it inside the Github repository.
I replaced the existing A8 with the new one. I tried to get the front photo to work, but it was not functioning properly. I thought that the reason it failed last time was because the file was of the wrong format.
I migrated over to working on the PCB design, and first needed to find a working model for the TLC59211IN sink driver to use in the KiCad schematics. I found this model online [1], which was an exact match for the one we needed.
I put a photo of the existing Altair onto our schematic, just so we could always reference what the old one looked like. It looked as below.



Afterwards, I tried to fix the footprint libraries, but because Brian had imported them and there was no real documentation within the KiCad, I could not make heads or tails of it. It just shows how important documentation is.



I wanted to use GitHub desktop to make it easier to push changes to the ECad files, so I went ahead and installed that and set the default repository to our repo. I thought that I would run into issues with the installation because I was using a lab computer, but there were no issues.
The use of GitHub desktop [4] on the lab computer is seen below.



I decided to add global labels to each of the signals in the schematic, based on the photo of the Altair, so I created and power flagged all 44 signals.
Additionally, I added a new sheet to the schematic with references, such that we could stay organized. I started adding the datasheets to the components we knew we were going to use. I hope that the other members of my team follow suit.
Afterwards, I saw that the MCP23017 I/O Expander, the expander that we are actually using, came, so I decided to take a break and solder all the pins to the MCP23017. I followed these instructions online [2], where I learned what the appropriate mounts for the solder are.



The process to solder the pins was much smoother than the first time(s) I soldered, because I had more experience soldering and I was using a better soldering iron. I was able to get the pins soldered in about 30 minutes. I needed to solder a total of 16 pins, so I went one by one, following the process of heating the pad, applying the solder, and then quickly removing the pen. I did not run into any issues while doing this, and afterwards I went pin by pin and checked its appropriate connectivity to its pin across the board, as well as its non-existent connectivity to its neighbors. All the pins were soldered properly, and none of the pins were connected to their neighbors.
I made the correct solder mounts and the final product looked as below, very similarly mimicing the picture above.



I realized that some of the pins on the Stamp XL board were connected together, causing a virtual short circuit whenever they were used. I needed to fix this, so I needed to go back and desolder/resolder the pins which needed it. I followed a very thorough process to do so, following advice I found online [3]. This tutorial taught me even more ways to desolder, and even gave me a streamlined process to follow.
I went counterclockwise around the center pins, making sure each pin was not connected to its neighbors but making sure that it was indeed connected to the pins across the board from it. There were several pins that did not match this specifically, so I had to resolder them and then using the connectivity probes on the multimeter to ensure that they were working. After I did this for all of the pins, I moved to the edge pins. These edge pins were easier, and I followed the same procedure, and I was eventually able to verify that every pin was working.



However, while desoldering and resoldering 5 of the pins which were not functionally, I accidently bumped my pen into the male to the pin headers, which caused the plastic to melt. I removed the plastic via clamps, but I will have to resolder each of these pins again, a painful process I will likely do in the next entry. However, this was a meaningful learning experience, because I now know just how careful you have to be when soldering, and how you cannot make any mistakes.
The removed pins, and the 16 pins I must resolder, are seen below.



Finally, the board looked as above, and I learned some very meaningful lessons about desoldering, specifically. In the future, perhaps later this week, I will need to revisit these concepts in case we make mistakes during assembly.
A significant challenge faced was troubleshooting the footprint libraries in KiCad due to a lack of prior documentation. This reinforces the importance of maintaining clear, well-organized records, as missing information can create roadblocks. In future work, a standardized method for documenting custom footprint imports should be considered to prevent similar issues.
Moving forward, breaking down the remaining resoldering task into manageable steps could help mitigate the frustration of repeating the process. Additionally, testing pins incrementally rather than all at once might reduce the likelihood of needing to redo large sections of work.
Additionally, another thing that I quickly saw and considered was the use of KiCad 9.0.0 to accelerate the development of our PCB layouts. I know that this version of the tool will be much better. I saw this information at this article [5], and seen below.



Citations:
- 1: TLC59211IN ECad Model for KiCad (https://www.digikey.com/en/models/2183120)
- 2: How to solder MCP23017 SMD (https://www.robotics.org.za/W15391)
- 3: Steps to properly Desolder (https://www.instructables.com/The-Ultimate-Guide-to-Desoldering/)
- 4: Github desktop installer (https://desktop.github.com/download/)
- 5: KiCad 9.0.0 Release (https://www.kicad.org/blog/2025/02/Version-9.0.0-Released/)

#### Entry 1: -----------------------------------------------------------------

Date: February 22
Start Time: 9:30 am
Duration: 2 hours

Content:
This night, I needed to finish checking the stamp board which I had finished soldering the previous night. I realized that there was a connectivity issue between three of the stamps' pins. I needed to fix this, so I went back and desoldered the pins, and resoldered them. I followed a very thorough process to do so, following advice I found online [1]. This tutorial taught me even more ways to desolder, using a conductive object to absorb the solder. However, the process would be quite risky.
In the end, the new stamp looked as below, with all the incorrect pins, being the 10 pins at the bottom and three around the sides, removed.



Afterwards, because I knew I needed more practice, I went to get a prototype board which I knew had some mismatched pins, and desolder the board.
I found one which the staff had given us, and I practice removing the pins, because the old pins had been placed the wrong way ahead. I knew that if we made a similar mistake, we would lose a lot of time, unless I learned to do this well.
The old pins had been set to activate servo motors, but the entire breadboard did not work, so the idea was trashed. The board original looked as below, but with pins in the wrong direction to the ones visible.



I meticulously desoldered the pins, applying a lot of heat at the maximum temperature to remove them. I realized that if the solder was not applied at the correct temperature, there would be no chance to remove the pins. I read this article [1] about temperatures required to desolder pins in order to become more knowledgable about the ranges of soldering heat.
Below is a picture of me going through the entire process, waiting a while for the heat to remelt the solder.



This session was heavily focused on refining desoldering techniques and improving overall hardware troubleshooting skills. Identifying a connectivity issue on the stamp board and methodically fixing it demonstrated both patience and attention to detail. The decision to follow an online tutorial for alternative desoldering methods highlights a proactive approach to problem-solving.
One key takeaway from this session was the risk involved in using a conductive object to absorb solder. While it provided an effective solution, it also introduced potential hazards that required careful handling. Successfully removing and resoldering the incorrect pins strengthened soldering proficiency, making future corrections more efficient.
Practicing on a prototype board was a strategic move, allowing for hands-on experience in desoldering without risking critical project components. This foresight—anticipating potential mistakes and preparing for them in advance—is a valuable skill in hardware development. The research into appropriate desoldering temperatures further reinforced the importance of applying the correct heat range to avoid unnecessary damage.

Citations:
- 1: Desoldering without wick or a pen (https://community.spiceworks.com/t/solder-removal-without-a-solder-sucker/1010894)
- 2: desoldering ranges Wikipedia article (https://en.wikipedia.org/wiki/Desoldering)

## =============== Week 6: =================

#### Entry 4: -----------------------------------------------------------------

Date: February 21
Start Time: 9:30 am
Duration: 2 hours

Content:
The third Raspbery Pi Stamp XL board came today, so I had to spent some time making sure it was operable because it looks like some of the pins were soldered already.
I initially put the flexy pins in the breadboard as instructed from their website, but I realized that it would not match the configuration we were desiring, so I removed the flexy pins to put them in the right way. A photo of the initial incorrect configuration is seen below.



I realized that I had to desolder the pins to ensure there would be no conflicts in the future, so I began learning how to do so. I first watched the following video below:
Below is a photo of me following the procedure for desoldering with solder wick.



I was able to desolder some of the pins, but I realized halfway through that the pins were already electrically connected, so there was no point in soldering them. After which, I choose to resolder all of the pins in the proper mounting positions.
I then put the flexy pins in the breadboard in the correct configuration, and I was able to get the RP to work with the breadboard. I will likely be using this configuration for the final prototype board.
After which, I started to update the website with the appropriate schematics.
I started finalizing the hardware prototype, using WaveForms and staticIO as my debugging tools of choice.
I put in all the I2C lines and got everything working, through trial and error with testing each switch, sink driver line, and I/O expansion port.
The final prototype looks as below.



I got started on the KiCad schematic for the whole front panel, which I had to redo because my initial prototype was incorrect. However, I ran out of time as I had to leave for another meeting.
With the Raspberry Pi Stamp XL properly configured and operational, the next step involved verifying its communication with peripheral components. The I2C bus was a primary focus, as its stability would determine the success of interfacing with the I/O expanders. Initial tests with the oscilloscope confirmed signal integrity, but occasional noise indicated a need for better grounding and shielding.
With stable I2C communication achieved, the focus transitioned to integrating the front panel controls. LED behavior was tested under varying load conditions to validate brightness levels, and debouncing strategies for switches were evaluated. The design was also reviewed to ensure seamless integration into the final PCB layout.
These advancements have moved the hardware prototype closer to finalization. The next steps will involve refining the software to implement more efficient polling mechanisms and exploring interrupt-based approaches for handling switch inputs. These optimizations will enhance the interface's responsiveness and overall performance
Citations:
Links and sources are found below, for ease of access:
- 1: Flexy pins documentation for installation (https://www.solder.party/docs/flexypin/)
- 2: Tutorial for desoldering pads (https://www.youtube.com/watch?v=bG7yW9FigJA)

#### Entry 3: -----------------------------------------------------------------

Date: February 20
Start Time: 10:00 am
Duration: 3 hours

Content:
During this session, I really needed to finish the hardware prototype, because as Professor Walter stated, we were very behind on prototyping and should have been creating PCBs at the given time.
First, I needed to find the proper resistors to get the sink driver to work as intended. The old resistor values, the 150 Ω resistors, were not drawing nearly enough power to control the 592TLC11IN, so I needed to find a new value.
I revisited the datasheet for the 592TLC11IN, and found that the maximum current draw was 200 mA, so I needed to find a resistor that would draw that much current or less. I found that an equation detailed in the datasheet [1] that would meet my exact specifications, so I needed to do the math to calculate the proper values.



I found that the resistor values I needed was closest to 220 or 330 Ω, Because they were the closest to my specifcations. I found this interesting graph on the datasheet [1] showcasing the performance of the sink driver with different resistor values.



I swapped out the final resistors, and the final decision was operable for the LEDs and switches.
Next, I needed to make room for the I2C serial data and clock, so I connected wires to where these segments would go, in white.
I knew that I had my LED segments done, but I still needed a I/O expander for the 16 switches on the front panel, as well as the 8 switches for bus operations.
I went back to the ECE shop to look for spare I/O expanders and was able to find 3 spare ones.
After the I/O expanders were installed, I decided to work with a smaller resistance value, the one given in the datasheets, there were some good resources showing me the switching characteristics of the sink driver, as seen below [1].



These values set a good benchmark for me, and I was able to implement the proper resistors and know the expected results of the sink driver. This will be very useful, as I am certain that proper resistance will play a key factor in our project, and slight differences might cause errors.
Although I was fairly certain on my resistor values, I still needed to verify, so I decided to use the support website they had for engineering applications, found in the datasheet and seen below.



I created a discussion post and installed all 24 220Ω resistors, so our board could progress. With the LED driver circuit functioning as expected, the next challenge was ensuring that switch inputs could be properly registered. This required integrating the I/O expanders with the microcontroller and setting up communication over I2C. The initial wiring seemed correct, but testing revealed inconsistencies in signal transmission, suggesting that the I2C pull-up resistors might not be ideal.
A logic analyzer helped visualize the data on the I2C lines, and an oscilloscope confirmed irregular voltage levels. Adjusting the pull-up resistors brought the signals within an acceptable range, allowing reliable communication between the expander and the Raspberry Pi Pico. A few test scripts verified that each switch press was correctly interpreted, though some inconsistencies pointed to the need for additional software adjustments.
With inputs now properly received, the next steps involve refining the software to handle signal stability. Debouncing needs to be addressed, and an interrupt-driven approach would likely improve efficiency over continuous polling. Once these refinements are in place, attention can shift toward full integration of the panel’s functionality.

Citations:
Links and sources are found below, for ease of access:
- 1: Sink Driver specifications (https://www.ti.com/lit/ds/symlink/tlc59211.pdf?ts=1740190473624)
- 2: Peer to peer engineering forum for TI (https://e2e.ti.com/)

#### Entry 2: -----------------------------------------------------------------

Date: February 19
Start Time: 9:30 am
Duration: 2 hours

Content:
During this mandatory lab section, I wanted to make sure everything we got from the staff was properly soldered. I also wanted to work (and almost complete) our hardware development board, such that I could show it to the 477 Staff during "Show me a thing".
We got two Raspberry Pi stamp boards from the staff, but neither came with pins installed. I decided to install most of the connecters needed for the board to function properly.



The first connectors I needed to install were the male to female connectors [2], as seen below. I needed to use the wire crimpers to cut the connectors to the right length, or look for the proper size in the lab.



There were also the two row variants of these connectors, which were exactly as they sound like, with two of the same rows. There were objects known as flexy pins, which were to connect the RP stamp board to the printed circuit board. I also noticed the presence of several external connectors, such as USB, LiPo, and UART. For now, we will have to put in wires for the LiPo interface.
I connected the flexy pins based on the documentation that solder party had on their website [1], and I was able to get the RP stamp board to work with the breadboard. This taught me how the flexy pins normally work, and the mechanics behind them.
After all of the flexy pins were installed, I made sure that the stamp was securely connected to the breadboard, and I was able to get the RP stamp board to work with the breadboard. To do this, I conducted a connectivity test with each of the 60 flexy pins.
For the other Stamp board, Brian and Seth helped to assemble the boards, as well as the necessary components on board. After which, I continued working on the hardware prototype of the breadboard. I still needed to crimp some of the resistors and LEDs, because I only wanted to make the breadboard once, through ample testing, and make sure I didn't have to reroute any of the wires on the breadboard.
I installed the I/O expanders, and wired up the proper pins. After which, the hardware prototype looked as below.



I showed my work to the 477 staff, and our team got some good feedback from Professor Walter on how our team should approach the following two weeks. Our PSDRs needed to be condensed, but still with an appropriate level of detail.
After which, I updated our team website with the appropriate images and html formatting, as well as the documents and schematic downloads. In the following weeks, I will need to change my directive towards PCB design primarily.
One of the challenges I addressed was the precise alignment of the flexy pins during soldering. Misalignment could prevent the RP stamp board from seating properly, leading to functional issues. To overcome this, I utilized alignment jigs to maintain accurate spacing and ensure the connectors fit as intended. This approach not only resolved the alignment issue but also reinforced the importance of precision in hardware assembly.
These efforts directly contribute to the project's progress by establishing a solid foundation for the hardware setup. Reliable connections and proper alignment are critical for the overall functionality of the system, and addressing these aspects early helps prevent potential issues during later stages of development.
Looking ahead, the next steps involve completing the final wiring for the I/O expanders and initiating preliminary testing of the GPIO functionality. This will include verifying voltage levels, assessing signal integrity, and identifying any potential sources of interference. Additionally, I plan to integrate a logic analyzer to monitor and validate data transmission between the RP stamp board and external peripherals, ensuring seamless communication and further advancing the project toward full functionality.

Citations:
Links and sources are found below, for ease of access:
- 1: Flexy Pin Installation (https://www.solder.party/docs/flexypin/)
- 2: Male Header Reference Datasheet (https://www.digikey.com/en/products/detail/samtec-inc/SSW-104-02-G-S/1112449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)

#### Entry 1: -----------------------------------------------------------------

Date: February 17
Start Time: 9:30 am
Duration: 3 hours

Content:
First, I needed to fix a repository issue between the desktop computer I was working with in the senior design lab.
The problem was that nothing was syncing correct, and I did not have access to the repository I was working within.
I discovered that the lab computer was actually two separate accounts, the desktop and my huan1811 user account, so I needed to be very careful with the account I actually was using.
I then needed to fix the repository, so I went to the github website and cloned the repository to the desktop, then made sure to save the repository to an individualized account which I would only touch.
The issue found with the multiple accounts can be seen below.



Next, I decided to do some research on how an I/O expander works. I knew that with 36 ports, we would eventually need at least one for our design.
I decided to research the MCP23008 I/O expander [1], because it was a common I/O expander. Although we might not use it in the final design, it will be good to know.
From the datasheet, I was able to figure out that the 8 ports on the chip were all bidirectional, so we could use the 8 ports as inputs to the RP2350.
The datasheet can be seen below, with bidirectional ports.



I also found a video online [2], detailing how to use an I/O expander for an application where the GPIO pins outnumber the ports. I watched this video, and some important parts are below.
After this, I was able to find another video on YouTube that was actually using a RP pico, so I able to gain incredible insight with that, which taught me that the GPIO expander was very usable with most microcontrollers.



I was scared because an older video [3] mentioned that GP7 could be write only, which would mess up our plans. When I started wiring, I made sure to wire right to left such that the rightmost switch was GP0 and the leftmost was GP15. I learned from the video the basic setup of the I/O expander.
I also noticed during the video that a maximum of 8 I/O expanders could be used, so I made sure to keep that in mind. We probably won't hit that limit, but it is good to know.
I will likely be EXACTLY mimicing the image seen below for the hardware prototype. After I am done with this, we will do all the software testing on this and there will not be a substantial need for another prototype board, for now.
The image I will be mimicing is seen below.



Also, for each of the 3 DP switch segments, I will need to create a level shifter for each of the segments. This will look like below.



After creating this level shifter, I with need to make sure the DC buck converter is working properly, so I will need to create the schematic I found online [4] in the buck converter datasheet on the breadboard, making sure it actually regulates the output. From this datasheet, I was able to learn several approaches on how to create a working buck converter, as well as their efficieny levels.



Citations
Links and sources are found below, for ease of access:
- 1: Datasheet for MCP23008 (https://www.microchip.com/wwwproducts/en/MCP23008)
- 2: How to use MCP23008 to expand GPIO (https://www.youtube.com/watch?v=LyRON_EK8Q4)
- 3: MCP23008 expander with raspberry pi (https://www.youtube.com/watch?v=BtAAOXPCuHc)
- 4: Buck converter datasheet for hardware prototype (https://ww1.microchip.com/downloads/en/DeviceDoc/20005308C.pdf)

## =============== Week 5: =================

#### Entry 4: -----------------------------------------------------------------

Date: February 14th
Start Time: 6:30 pm
Duration: 2 hours

Content
I needed to refresh my soldering skills, since I was rusty with soldering without the use of Flux, and the last time I had soldered without it was five months ago, during my Co-Op.
I decided to watch this video, which showed me how to solder without flux, and how to properly tin the soldering iron. I also learned how to properly clean the soldering iron, which I had not done before.



Since I was still unsure of my abilities, I decided to take an old PCB and solder some header pins without flux to practice. I went to a solder station, heated up the iron, and got to work soldering.
One of the things I figured out quite quickly was that although the iron was hot enough, I needed to let the solder sit for a very exactly amount of time, or it would either group up or not set.
There was a method I began to employ, where I would heat the pad for exactly 2 seconds, put the solder and other things, and wait exactly 1 second, before removing the solder. This allowed me to consistently solder, with very little error.
An image of me soldering is found below:



Another thing I found quite quickly without flux was that the solder smoke would quickly rise. I needed to offset this by adding a fan pushing the smoke away from me at all times.
After I employed both these tactics and protected myself thoroughly through eye and mask protection (from the smoke), I was able to solder 16 pins onto a practice PCB, successfully learning how to solder without flux.
The prototype PCB I soldered is found below, with the 16 pins I soldered completely attached:



Another thing which I had to do after the practice PCB was complete was check for connectivity. This would make sure all the solder points actually attached where they were supposed to.
After testing all 16 points, they all beeped when I attached the multimeters' probes to them, so I knew that the soldering was successful.
While soldering, I noticed that the heat distribution on the pad was inconsistent, leading to uneven solder joints. To fix this, I adjusted the tip angle of the soldering iron to ensure full contact with the pad before applying solder. This significantly improved joint consistency.
Another challenge I faced was that some pins were not wicking solder properly. I realized this was due to oxidation on the header pins. To resolve this, I lightly sanded the pins with fine-grit sandpaper before soldering, which helped the solder flow better.
To further refine my technique, I experimented with different solder wire thicknesses. I found that using a thinner 0.6mm solder wire gave me better control over the amount of solder applied, preventing excessive buildup on the pads.
Citations
Links and sources are found below, for ease of access:
- 1: Soldering a PCB without Flux: Precautions and procedure (https://www.youtube.com/shorts/SCFWatyjGHQ)
- 2: Refreshing myself on how to solder effectively (https://www.instructables.com/How-to-solder/)

#### Entry 3: -----------------------------------------------------------------

Date: February 14th
Start Time: 9:30 am
Duration: 3 hours

Content
I began finishing the prototype for the front panel of the Altair. I had to make sure that the LEDs and switches were properly connected to the breadboard, and that the power was properly connected to the breadboard.
I decided to switch from the PSU to the AD2 for digital testing, because the AD2 would stop any short circuits from interfering with my work. The PSU I used is show below, which was the one which might have malfunctioned my chips.



I had to fix the sink driver issue, so I tried to make it on one specific part of the breadboard to isolate it.
The sink driver was acting up again, so I decided to watch this [video](https://www.youtube.com/shorts/jXq5t6bl6MM) on how to properly wire up the sink driver, but when searching online, I could not find anything outside of a support document which was published.

I found this old documenation of a similar issue being documentated, but it was not relevant to our situation.
I talked to Niraj and he told me it was likely a breadboard issue, but we could also switch to the TLC59210IN, which would also drive the clk as well as the pins, so we will look into that.
Afterwards, I wired the breadboard based on the schematic below, which I knew would work. However, when I went to try it, only one LED would light at a time, so I went back to the drawing board.
When we actually go to create the board, I will be sure to install the TLC59210IN, because it is a better alternative to the TLC59211IN, which is known to have issues.
This is the new chip I will install, seen below, rather than the TLC59211IN, which is known to have issues.



For now, I need to isolate the issue with the sink driver. Because I thought that the breadboard was the issue, whether that be a stray wire or extra impedance interfering with the digital signals, I moved back to the original, smaller breadboard.
Below are my attempts to isolate the issue with the sink driver, by testing one LED and a time and gradually adding more.



I plan to make a concrete schematic of this circuit on post it to our Github schematic page later. I noticed that even after switching to the smaller breadboard, the issue with the sink driver persisted. To rule out a potential power delivery issue, I measured the voltage at different points in the circuit. I found that the voltage drop across some connections was higher than expected, indicating poor contact in certain areas.
To further isolate the problem, I used a logic analyzer to monitor the signals going into the TLC59211IN. The clock and data signals appeared clean, but the latch signal was occasionally unstable. This suggested that there could be noise interference or timing issues in the circuit.
Before moving forward with the TLC59210IN, I plan to compare its timing requirements with the TLC59211IN to ensure that it will integrate smoothly into our circuit without requiring major redesigns.
Citations
Links and sources are found below, for ease of access:
- 1: Circuit to try to isolate broken sink driver (https://www.youtube.com/shorts/jXq5t6bl6MM)
- 2: Old issue with TLC59211IN (https://e2e.ti.com/support/power-management-group/power-management/f/power-management-forum/1345987/tlc59211-seeking-tlc59211in-alternatives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)
- 3: New TI chip for use in actual PCB (https://www.ti.com/lit/ds/symlink/tlc59210.pdf?ts=1739589660843)
- 4: Instructions on creating a better front panel (https://modwiggler.com/forum/viewtopic.php?t=235049)

#### Entry 2: -----------------------------------------------------------------

Date: February 14th
Start Time: 9:30 am
Duration: 2 hours

Content
I began to work on the prototype for the Front panel with the sink drivers, LEDs, and the shift registers.
Most importantly, I needed to find a way to test the sink drivers, because I was unsure if they were working properly. I found this portion on the datasheet, which was a useful reference and an example on how to wire up LEDS successfully.



I wired it up like in the example, and used the wire crimpers to get the optional length of resistors such that the components would fix exactly onto our board.
Since we are going for a minimal design, I thought it would be best to start that practice, even with the breadboards.
My work can be seen below:



I knew that I needed to minimize the use of wiring, so I revisited some old ECE362 Labs in order to see how the circuit was wired optimally, because the circuit in ECE362 was quite large and a hassle to keep neat.
I also needed to consider the pinout of the TLC59211IN, which I found that the voltage and ground pins were strangely connected, unlike most LED drivers. This can be seen below in the datasheet references.



I also watched this video on best wiring practices and layout practices for PCB design, because I knew I needed to improve my skills if we want to create something that small which still works.



I am likely going to return to the lab to test the sink drivers and recrimp the LEDs, because I am unsure if they are working properly.
I ran into an issue where some LEDs were not lighting up as expected, despite being wired according to the datasheet. After debugging, I realized that some connections were not making proper contact with the breadboard. I used a multimeter to check continuity and identified a few loose crimps that needed to be redone.
To further test the sink drivers, I used an oscilloscope to probe the output pins while toggling input signals. The voltage levels confirmed that the drivers were switching correctly, but I noticed a slight delay in response time. This could indicate a need for pull-down resistors to stabilize the inputs.
I experimented with different resistor values to determine the optimal configuration for balancing brightness and current draw. A 1kΩ pull-down resistor seemed to provide a stable signal without excessive current consumption.
Since PCB layout will be critical, I started drafting an initial schematic in KiCad to visualize how the components will be positioned and connected. This helped me identify potential routing challenges early on.
Citations
Links and sources are found below, for ease of access:
- 1: Datasheet for TLC59211IN, a sink driver (https://www.ti.com/lit/ds/symlink/tlc59211.pdf?ts=1739519117322)
- 2: Proper wiring tutorial found on youtube. (https://www.youtube.com/shorts/3qbz26m9SPA)

#### Entry 1: -----------------------------------------------------------------

Date: February 10th
Start Time: 9:30 am
Duration: 2 hours

Content
Today, I began prototyping the new front panel for our Altair, which would incorporate both the power inputs and the LED and switch matrices.
I had to get a bunch of components from the ECE shop in order to begin the prototyping build. I looked around the 477 Lab, but did not know where the parts I needed were, and there was no one in lab. So I went up to the ECE shop and got the parts I needed.
I obtained around 30 red LEDs, 4 switch mounts for 8 switches each, and a bunch of wires for connecting the LEDs to the bound. My collection can be seen below.



I had to look up documentation on the [CTS 208-8 T208](https://www.ctscorp.com/Files/DataSheets/Switches/DIP-Switches/CTS-Switches-DIP-208-Series-Datasheet.pdf) 8 mount slide switches, because I was unsure how they worked with only 16 total pins. I found this part of the datasheet showing me how to connect the pins.



This photo showed me how to adequately wire up the LEDs. I needed to make sure that each of the 4 8-pin SPST switches actually worked, so I needed a software to test them with, because our emulator was not 100% working yet.
I decided to download Waveforms from this [link](https://cloud.digilent.com/myproducts/waveform?pc=1&tab=2), because we already had an AD2 and a breakout in house. I then tested each of the switches, following a procedure seen below.



As seen from the photo, I have to test each of the 32 LEDs. Seth asked me to install the Rust toolchain, so I spent some time making sure the install was correct. I download a part of the Rust toolchain from this [website](https://github.com/raspberrypi/picotool), where I followed the install steps.
I pushed my final changes to the github repository becase I had to leave for a meeting, but I let Seth finish the rest of the toolchain setup and documentation
The tool chain I had to install is found below, which I had to install on my local machine.



I encountered an issue while wiring the switches to the LEDs because the pinout on the CTS 208-8 T208 was slightly different from what I initially expected. I had to use a multimeter to confirm connectivity before proceeding.
While testing the LEDs, I noticed that some of them had inconsistent brightness. After checking the resistances, I found that a few of the LEDs had higher forward voltages than expected, so I replaced them with spares.
I also experimented with different resistor values to optimize brightness while maintaining power efficiency. A 150Ω resistor seemed to provide a good balance.
During the Rust toolchain setup, I ran into a dependency issue where cargo failed to locate rustc. I fixed this by ensuring that my PATH variable included the correct installation directory.
Before pushing to GitHub, I verified that my changes did not interfere with existing build scripts by running cargo check, ensuring the Rust environment was correctly set up.
Citations
Links and sources are found below, for ease of access:
- 1: 8-pin SPST switches for testing (https://www.ctscorp.com/Files/DataSheets/Switches/DIP-Switches/CTS-Switches-DIP-208-Series-Datasheet.pdf)
- 2: Waveforms download link (https://cloud.digilent.com/myproducts/waveform?pc=1&tab=2)
- 3: Picotool necessary for testing our RP on Rust (https://github.com/raspberrypi/picotool)

## =============== Week 4: =================

#### Entry 4: -----------------------------------------------------------------

Date: February 7th
Start Time: 7:00 pm
Duration: 2.5 hours

Content
To refresh my knowledge of formal electrical specification documentation, I reviewed the IEEE guidelines, specifically their citation and documentation resource [insert link here]. This review helped me recall the proper formatting for references, system component descriptions, and technical content structure. It reinforced the importance of clearly defining power budgets, signal interfaces, and electrical tolerances.
I then revisited the existing Electrical Overview document, which details our project's hardware components, power requirements, and communication interfaces. I revised the electrical implementation sections, ensuring accurate categorization of chips, sensors, and devices. I also clarified the descriptions of data collection, software computations, and power distribution.

Next, I detailed the power budget calculations, listing system voltages (e.g., 3.3V, 5V), the expected current draw for each component, and the resulting power consumption. I also explicitly defined voltage and current tolerances for system safety. The table can be seen below.

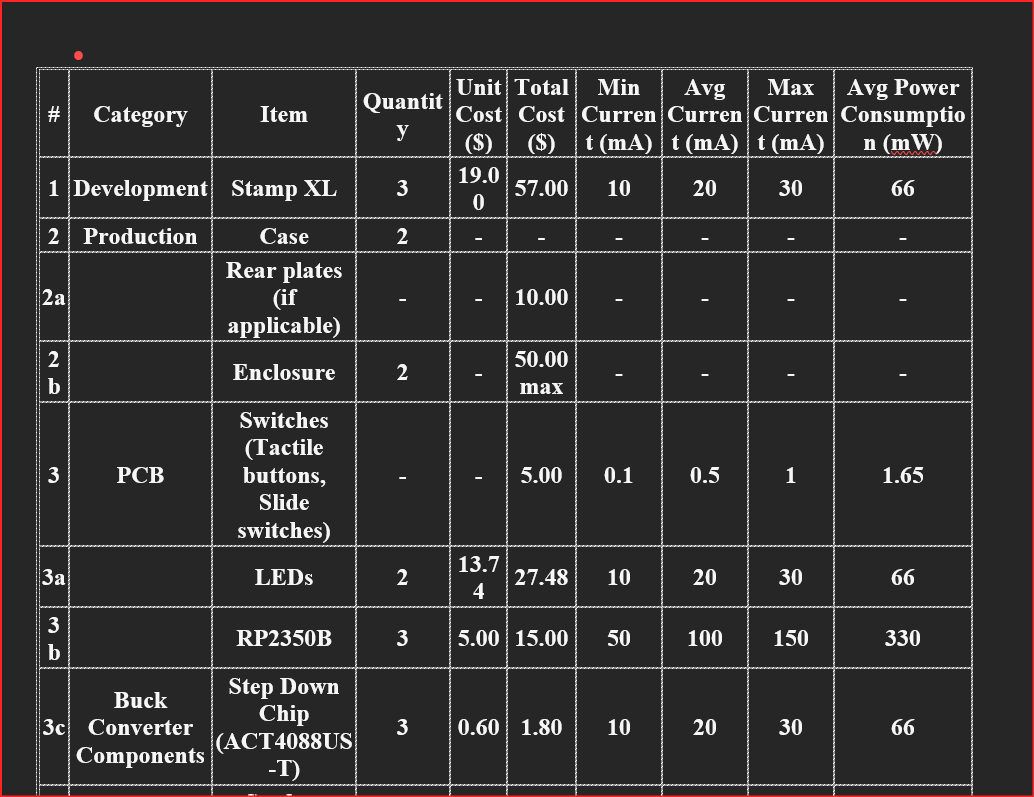
[picture p95: Team/journal/img - member4/week4/6.png]


Finally, I enhanced the interface considerations section with specifics on data rates and protocols, including UART, I2C, and USB, ensuring alignment with our system's communication requirements.

Citations
Links and sources are found below, for ease of access:

#### Entry 3: -----------------------------------------------------------------

Date: February 7th
Start Time: 9:30 am
Duration: 2 hours

Content
Today I need to make the final edits to A5 so my team can all review it and revise it when we submit.
But first, I need to make sure that files A1-A4 are update to date on the website. I realized the file links were NOT working, so I had to fix them manually.
To fix this problem, I downloaded every Ax document into my local machine, then cut them all into the repository with windows explorer.
I know that this is only a temporary fix, but my team needs to focus on the Documents.

I also saved the templates to my local machine, and started working on the Component analysis.
I began looking into three options to use for the step-down buck regulator:
- [AP66200](https://www.diodes.com/assets/Datasheets/AP66200.pdf)
- [TPS732](https://www.ti.com/lit/ds/symlink/tps732.pdf?ts=1738905137165)
- [MCP16639](https://www.mouser.com/datasheet/2/268/50002364A-766362.pdf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)

The website download links broke for a little, but they are back up now
I wrote the specifications for our 3-4 parts, as well as descriptions of the power source
Next, I looked at three options for the reverse mounted LEDs. I also watched this [video](https://www.youtube.com/watch?v=wkFOF71a2bk) to see how the mounting works
- [XZMDKVG45WT-9](https://www.sunledusa.com/products/spec/XZMDKVG45WT-9.pdf)
- [XZMYKVG45WT-9](https://www.sunledusa.com/products/spec/XZMYKVG45WT-9.pdf)
- [HLMP-D150A](https://mm.digikey.com/Volume0/opasdata/d220001/medias/docus/4128/HLMP-D%2CK.pdf)

One thing which I incidentially discovered was that it may be a bad idea to use TFT mounted switches, as seen in the image below:



Citations
Links and sources are found below, for ease of access:
- 1: Reverse Mounted LED 1 (https://www.sunledusa.com/products/spec/XZMDKVG45WT-9.pdf)
- 2: Reverse Mounted LED 2 (https://www.sunledusa.com/products/spec/XZMYKVG45WT-9.pdf)
- 3: Regular Mounted LED 3 (https://mm.digikey.com/Volume0/opasdata/d220001/medias/docus/4128/HLMP-D%2CK.pdf)
- 4: Buck Converter 1 (https://www.diodes.com/assets/Datasheets/AP66200.pdf)
- 5: Buck Converter 2 (https://www.ti.com/lit/ds/symlink/tps732.pdf?ts=1738905137165)
- 6: Buck Converter 3 (https://www.mouser.com/datasheet/2/268/50002364A-766362.pdf)

#### Entry 2: -----------------------------------------------------------------

Date: February 5th
Start Time: 9:30 am
Duration: 2 hours

Content
Today, I tried to get software to successfully flash onto the Raspberry Pi pico. I followed the instructions found [here](https://datasheets.raspberrypi.com/pico/getting-started-with-pico.pdf) to install the raspberry pi pico extension in vs code.

Then, I ran the example code after storing it in a proper directory. The software rebooted several times.

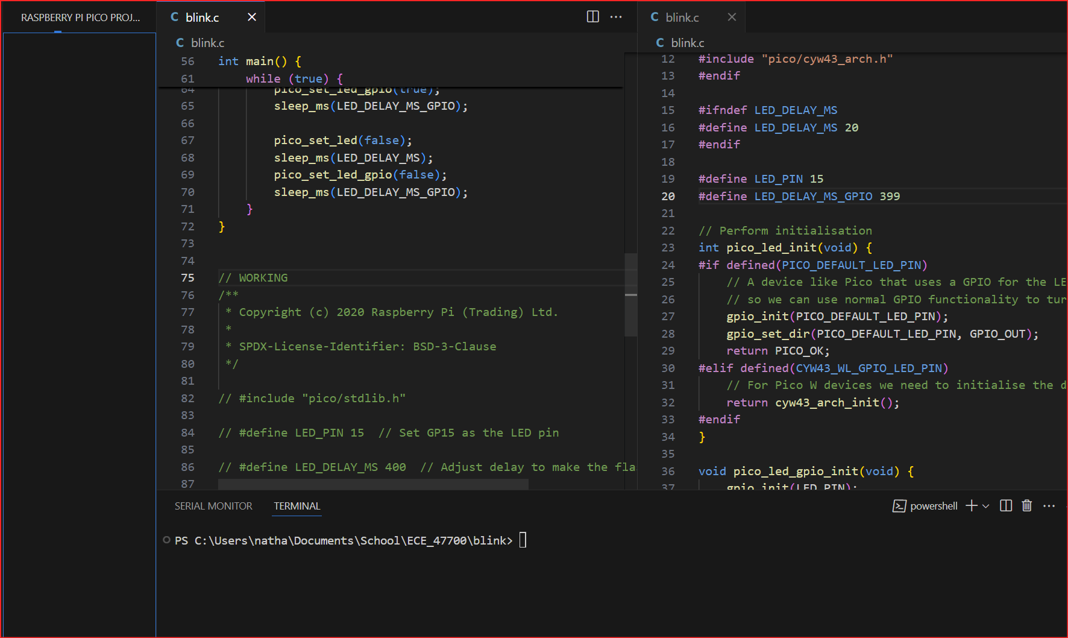
[picture p96: Team/journal/img - member4/week4/3.png]


One thing we figured out with the dev board software was that every time we wanted to load something, we needed to disconnect and reconnect the device while holding the BOOTSEL button on the Pi.
We also figured out to not overload the IDE with several 'run' requests, or the device would get overloaded and not work.
I also realized I needed a JDK in order to successfully compile the code. Although the main.c was running without this, I figured it would be essential to have in the future. I downloaded the JDK from [here](https://www.oracle.com/java/technologies/downloads/#java17).
I created an account an downloaded the JDK, and I proceeded to make a circuit to demonstrate that we have the ability to run any software we want.
To test the circuit, I refreshed my knowledge of TFT tactile switches, by watching this [link](https://www.youtube.com/watch?v=0ZXYRU9KPG8)
I constructed a circuit to demonstrate that the pico could flash, and then showed my work to Professor Walter.
Professor Walter said we needed additional description on the PSDRs, so I plan to fine tune and revise those tonight.

Citations
Links and sources are found below, for ease of access:
- 1: Introduction to Tactile Switches (https://www.youtube.com/watch?v=0ZXYRU9KPG8)
- 2: Booting into Pi (https://datasheets.raspberrypi.com/pico/getting-started-with-pico.pdf)

#### Entry 1: -----------------------------------------------------------------

Date: February 3rd
Start Time: 9:30 am
Duration: 2 hours

Content
Today, I began looking at running software through the rust emulator. I first looked at this [video](https://www.youtube.com/watch?v=vwFWBP0IuRU) to obtain an ideal of how rust emulation would work on the pi.



Seth began talking to me about the S100 bus, so I switched tasks to better understand the S100 bus on the original Altair. I went through the bus documentation on the datasheet, found in the image below.



The most important parts of the S-100 (which has 100 signals), would likely be the address bits for reading and writing data.
I took notes on what each of the ports and address bits take in through OneNote, and began thinking of the ways we would emulator the S100 bus, potential with a multiplexer to hit another PSDR.
Afterwards, I opened the electrical specifications example and migrating our power consumptions to the electrical specifications.
Citations
Links and sources are found below, for ease of access:
- 1: Running Rust on a RP 2350 (https://www.youtube.com/watch?v=vwFWBP0IuRU)
- 2: S-100 Bus Descriptions (http://vtda.org/docs/computing/MITS/MITS_Altair8800TheoryOperation_1975.pdf)

## =============== Week 3: =================

#### Entry 3: -----------------------------------------------------------------

Date: January 30th
Start Time: 9:30 am
Duration: 2 hours

Content
- What did you work on?:Soldering
- How did you work on it?:Soldered the Dev Board
- What was the result and what did you learn from it?:Now the dev board is good for us to use and experiment with
- How did this contribute to the project progress?:Test the emulator for our 8080
- What are the next steps that must be taken?:Continue work on the back plane

Detail
I looked through an old video of an individual soldering pins to a Pi Zero.



The final product looked as below, which was pretty good and is now ready for testing



Now our devboard is ready for powering, future soldering, and emulation. Citations
Several links and sources are found below, for ease of access:
- 1: Solder Pins to Pi Zero (https://www.youtube.com/watch?v=UDdbaMk39tM)

#### Entry 3: -----------------------------------------------------------------

Date: January 30th
Start Time: 5:30 pm
Duration: 2 hours

Content
- What did you work on?:Front Panel PCB
- How did you work on it?:Analysis of Front Panel PCB
- What was the result and what did you learn from it?:Learned about the architecture of the front panel, figured out how the circuitry was laid out
- How did this contribute to the project progress?:Had a general idea of the frame we are trying to miniaturize
- What are the next steps that must be taken?:Need to finalize the front and back panel

Detail
I scanned through the documentation on the Altair to find the front plane found below.



I figured out that multiplexing could be the most optimal way to achieve the layout we desired. After taking with Brian, I understood that he wanted to keep the 6 LEDs and 3 switches, but the rest of the design could be modulated.
I went through new documentation about similar projects that tried to achieve the same goal, specifically towards their PCBs



I am going to take most of these design considerations when making our final version and recording the electrical specifications. Citations
Several links and sources are found below, for ease of access:
- 1: Old Operational Manual for the Altair (https://altairclone.com/downloads/manuals/Altair%208800%20Operator's%20Manual.pdf)
- 2: Past project for the Altair (https://andydoz.blogspot.com/2021/12/building-altair-8800-clone.html)

#### Entry 3: -----------------------------------------------------------------

Date: January 29th
Start Time: 8:30 am
Duration: 4 hours

Content
- What did you work on?:Regulator and Front Panel PCB
- How did you work on it?:KiCad software in-lab and wiring tutorials
- What was the result and what did you learn from it?:Started the schematic for the front panel, and layed out a better design for the prototype PCB
- How did this contribute to the project progress?:Started both the front and back panel
- What are the next steps that must be taken?:Need to analyze the electrical schematics further and see what routing needs to be done

Detail
I worked on a better design for the linear switching regulator, based on existing documentation I found only on the chip which I used in the intial design.



This schematic has more detailed metrics on the performance. After which I did all the necessary calculations to build the new design, seen below



The new schematic had to be rerouted, which I completed. Afterwards, Professor Walter met with our team, where I completed the "Show me a thing", found below in the new 3-D Design



Professor Walter gave me some important insights on PCB design, especially towards working with the exist sketches and layouts in the datasheets. I will be sure to use this knowledge moving forward.
Citations
Several links and sources are found below, for ease of access:
- 1: Linear Switching Regulator Datasheet (https://ww1.microchip.com/downloads/en/DeviceDoc/20005308C.pdf)
- 2: Link for finding the old dimensions of the Altair (https://adwaterandstir.com/altair/)
- 2: Front panel example (https://deramp.com/downloads/altair/hardware/altair_8800c/Front%20Panel%20Manual.pdf)

#### Entry 2: -----------------------------------------------------------------

Date: January 27th
Start Time: 9:30 am
Duration: 2.5 hours

Content
- What did you work on?:Software Setup and SSH agent for project
- How did you work on it?:Used eceprog computers and lab computer for setup
- What was the result and what did you learn from it?:How to set up rustlings on personal computer and make ssh key
- How did this contribute to the project progress?:Have a convenient environment to complete the rest of the project
- What are the next steps that must be taken?:See if a docker container or something similar can be created to host the project

Detail
I wanted to set up a successful environment for the whole project, so I looked into setting up the SSH agent for ECEProg.



After setting up the SSH key, I realized that the versions of software that the server was running could not support the versions of KiCad and Rust that we required. Afterwards, I switched to setup on my local machine, including the installation of rust and rustlings. It took a while and a lot of dependencies, but the installation was successful. I also discovered that Visual Studio Build Tools was very much required.



I made sure that the KiCad versions within the github were up to date such that I could work on them remotely anywhere, and tested that pushing and pulling to the EDA file was actually successful, which can be seen in the version history below



In the future, if more dependencies are needed, I will look into a dockerfile which will host a container Citations
Several of the installation links are found below, for ease of access:
- 1: Rustlings download (https://www.rust-lang.org/learn/get-started)
- 2: Rust installation (https://www.rust-lang.org/tools/install)
- 2: Build tools download link used (https://visualstudio.microsoft.com/downloads/?q=build+tools)

#### Entry 1: -----------------------------------------------------------------

Date: January 26th
Start Time: 10:00 pm
Duration: 2 hours

Content
- What did you work on?: KiCad schematic for buck converter
- How did you work on it?: Used KiCad schematic editor and layout editor
- What was the result and what did you learn from it?:Functional buck step down converter, how to follow examples in datasheet
- How did this contribute to the project progress?:Working converter to use in power distribution
- What are the next steps that must be taken?:Continue on the power distribution PCB board

Detail
I started to relearn KiCad for the PCB design aspect of the class. I configured the following KiCad schematic file as seen below



Inside the buck converter file, I created the following schematic following the tutorial created by Phil's Lab



After spending some time rewatching the video, I layered out the PCB to avoid any interference loops and yield the best results in the PCB



Finally, after finicking with the layering and the layout of the page and PCB, the following 3-D view was accomplished



I hope to bring this PCB prototype to manlab as an object to show to the TAs Citations
- 1: Phil's Lab Buck Converter (https://www.youtube.com/watch?v=FqT_Ofd54fo)
- 2: Buck Converter Layout (https://www.youtube.com/watch?v=AmfLhT5SntE)

## =============== Week 2: =================

#### Entry 4: -----------------------------------------------------------------

Date: January 24th
Start Time: 9:30 am
Duration: 3 hours

- Worked on the power converter for the Altera PCB, incorporating Professor Walter's commentary.
- Finished KiCad installation and decided not to use Altium for the board design.
- Resulted in a preliminary sketch of the buck converter we plan to use.
- This contributed to the project by providing us with a baseline PCB that we could visualize and start working on.
- The next steps will be to use videos from [PhilsLab](https://www.youtube.com/@PhilsLab) and schematics found on the Altera website to generate the miniaturized version.

Important Links:
- [Raspberry Pi Hardware Design with RP2350](https://datasheets.raspberrypi.com/rp2350/hardware-design-with-rp2350.pdf)
- [RP2350 Datasheet](https://datasheets.raspberrypi.com/rp2350/rp2350-datasheet.pdf)

#### Entry 3: -----------------------------------------------------------------

Date: January 22th
Start Time: 9:30 am
Duration: 3 hours

- Worked on the power converter for the Altera PCB, incorporating Professor Walter's commentary.
- Finished KiCad installation and decided not to use Altium for the board design.
- Resulted in a preliminary sketch of the buck converter we plan to use.
- This contributed to the project by providing us with a baseline PCB that we could visualize and start working on.
- The next steps will be to use videos from [PhilsLab](https://www.youtube.com/@PhilsLab) and schematics found on the Altera website to generate the miniaturized version.

Important Links:
- [Raspberry Pi Hardware Design with RP2350](https://datasheets.raspberrypi.com/rp2350/hardware-design-with-rp2350.pdf)
- [RP2350 Datasheet](https://datasheets.raspberrypi.com/rp2350/rp2350-datasheet.pdf)

#### Entry 2: -----------------------------------------------------------------

Date: January 21th
Start Time: 2:00 pm
Duration: 3 hours

- Continued on learning Rust.
- Finished several modules of the rustlings tutorial and found documentation of an old project.
- Knowledgeable about concurrency and memory safety in Rust.
- Now familiar with the code and can contribute meaningfully to Rust development.
- Adapting the existing Rust compiler with our modified one to achieve a specified clock rate.

#### Entry 1: -----------------------------------------------------------------

Date: January 20th
Start Time: 9:30 am
Duration: 3 hours

- Worked on learning Rust and found documentation of an old project with a similar goal to ours.
- Used Rustlings, an open-source GitHub repository with many tutorials for Rust, and read a 26-page documentation for the similar project.
- The result was that we now have a framework to work off of and confirmed we will focus on Rust for our compiler.
- This contributed to the project by providing us with metrics and past schematics for use.
- The next steps include watching the project videos and seeing how the design can be updated.

Important Links:
- [Rustlings Repository](https://github.com/rust-lang/rustlings/)
- [Altair 8800 Theory of Operations](https://deramp.com/downloads/mfe_archive/010-S100%20Computers%20and%20Boards/00-MITS/20-Altair%20Systems/11-Altair%208800/Other%20Manual%20Scans/Altair%208800%20Theo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)

## =============== Week 1: =================

#### Entry 3: -----------------------------------------------------------------

Date: January 17th
Start Time: 9:30 am
Duration: 3 hours

- Worked on the parts list for our project and documented A1 and the cost for each component.
- Used several vendors (Digikey, Amazon, Kingbright) to look up and record price estimates.
- Labeled and priced all the needed components for the preliminary PCB and converters.
- Learned the process of purchasing parts.
- Now we have an understanding of the total price for each of the components.
- In the future, we need to refine our choices and make sure they fit the price range.

#### Entry 2: -----------------------------------------------------------------

Date: January 15th
Start Time: 9:30 am
Duration: 3 hours

- Familiarized myself with the Senior Design lab, presented project proposal to course staff, and filled out the course website.
- Gave a 10-minute introduction to course staff about our project and some project specifications.
- Learned how to map the network drive to edit the server directly, as well as how to navigate the lab.
- Now we have a working network drive that will act as our server.
- We have to plan our weekly meetings and get a timeframe for the project.

#### Entry 1: -----------------------------------------------------------------

Date: January 14th
Start Time: 2:00 pm
Duration: 2 hours

- Worked on reading documentation for the Altera 8800, and seeing how everything worked.
- Looked up footage of the Altera working, found several bits of documentation outlining the initial proposal and looked at some attempts to recreate the technology online.
- Learned the basics of the Altera computer, as well as how it operates and is loaded.
- Have a deeper understanding of the objective of our project, and can begin to assign roles.
- The next steps that must be taken are the project specifications and related PSDRs.
