AlphaCassiopeiae/web/Team/journal/img - member1/week1/boardcassiopeiae.png

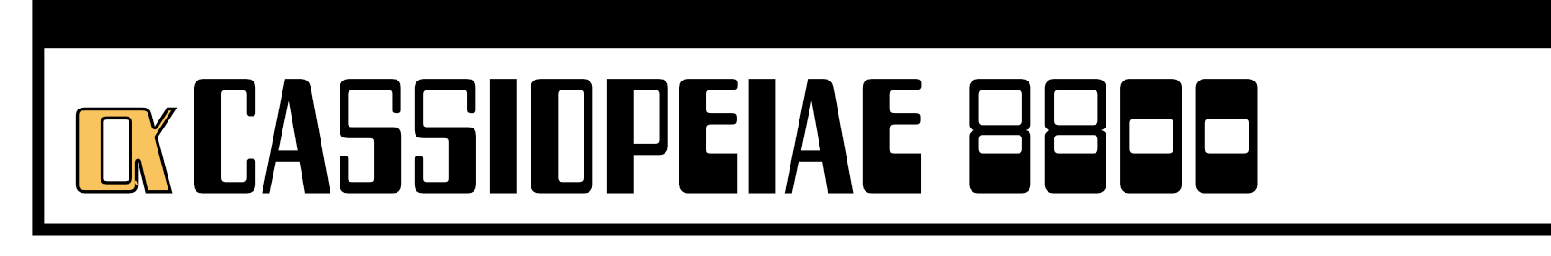
Team/journal/img - member1/week1/boardcassiopeiae.png
