AlphaCassiopeiae/web/Team/journal/img - member1/week2/Engineering Fountain.jpg

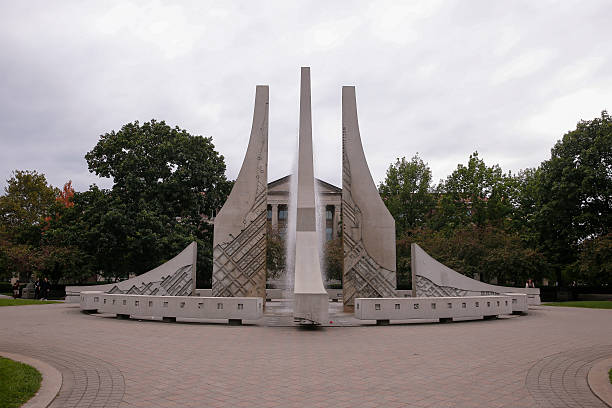
Team/journal/img - member1/week2/Engineering Fountain.jpg
