AlphaCassiopeiae/web/Team/journal/img - member1/week5/sch02.png

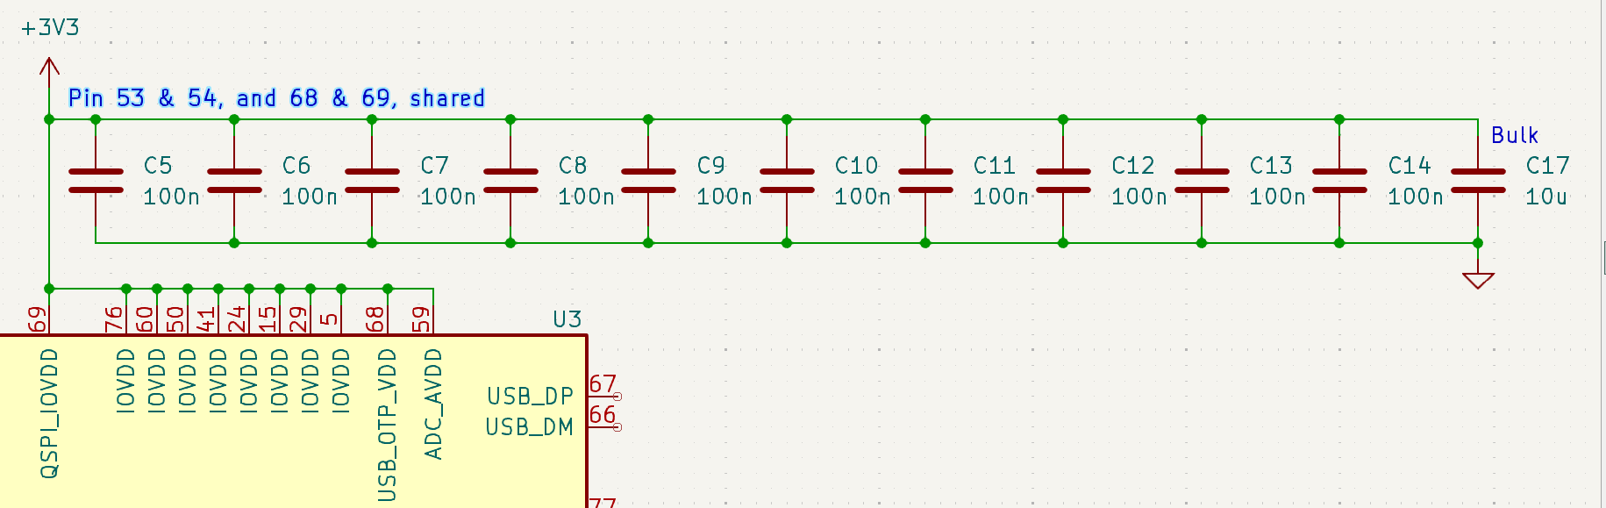
Team/journal/img - member1/week5/sch02.png
