AlphaCassiopeiae/web/Team/journal/img - member1/week5/sch03.png

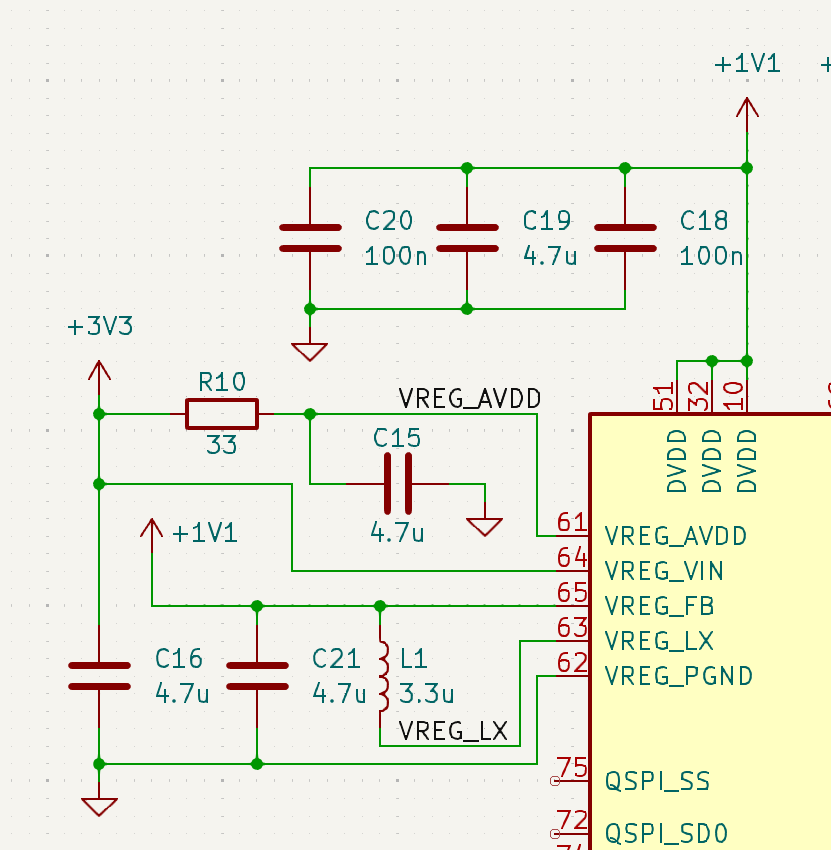
Team/journal/img - member1/week5/sch03.png
