AlphaCassiopeiae/web/Team/journal/img - member1/week5/sch04.png

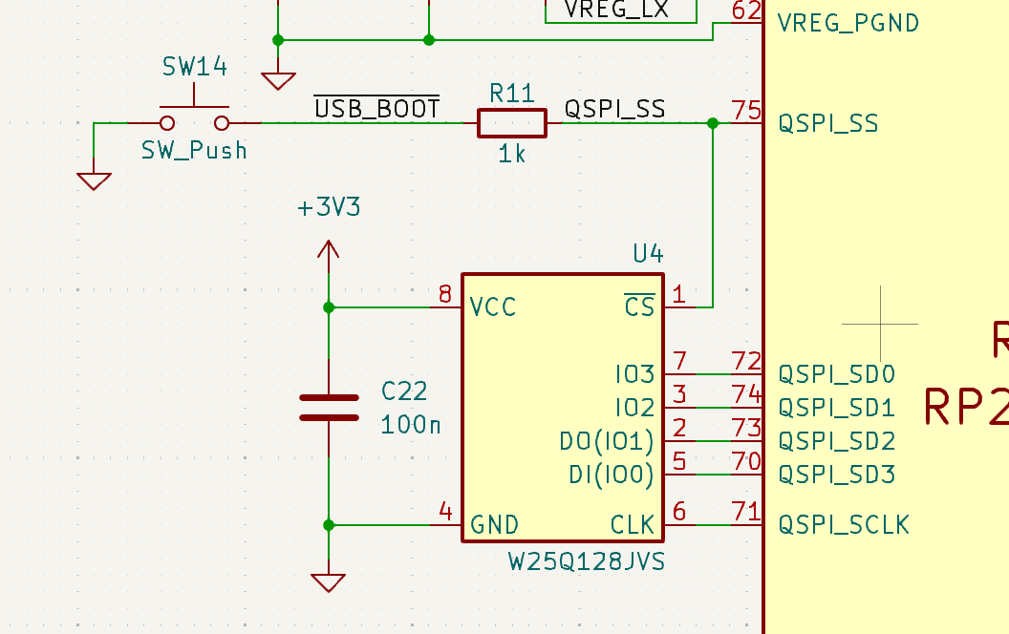
Team/journal/img - member1/week5/sch04.png
