AlphaCassiopeiae/web/Team/journal/img - member1/week5/sch06.png

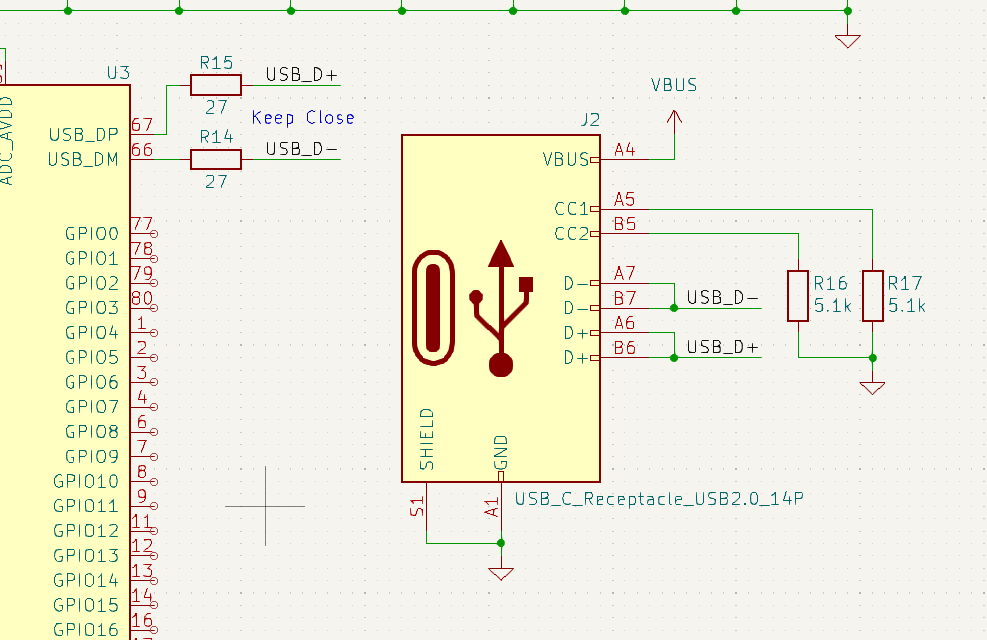
Team/journal/img - member1/week5/sch06.png
