AlphaCassiopeiae/web/Team/journal/img - member1/week5/sch07.png

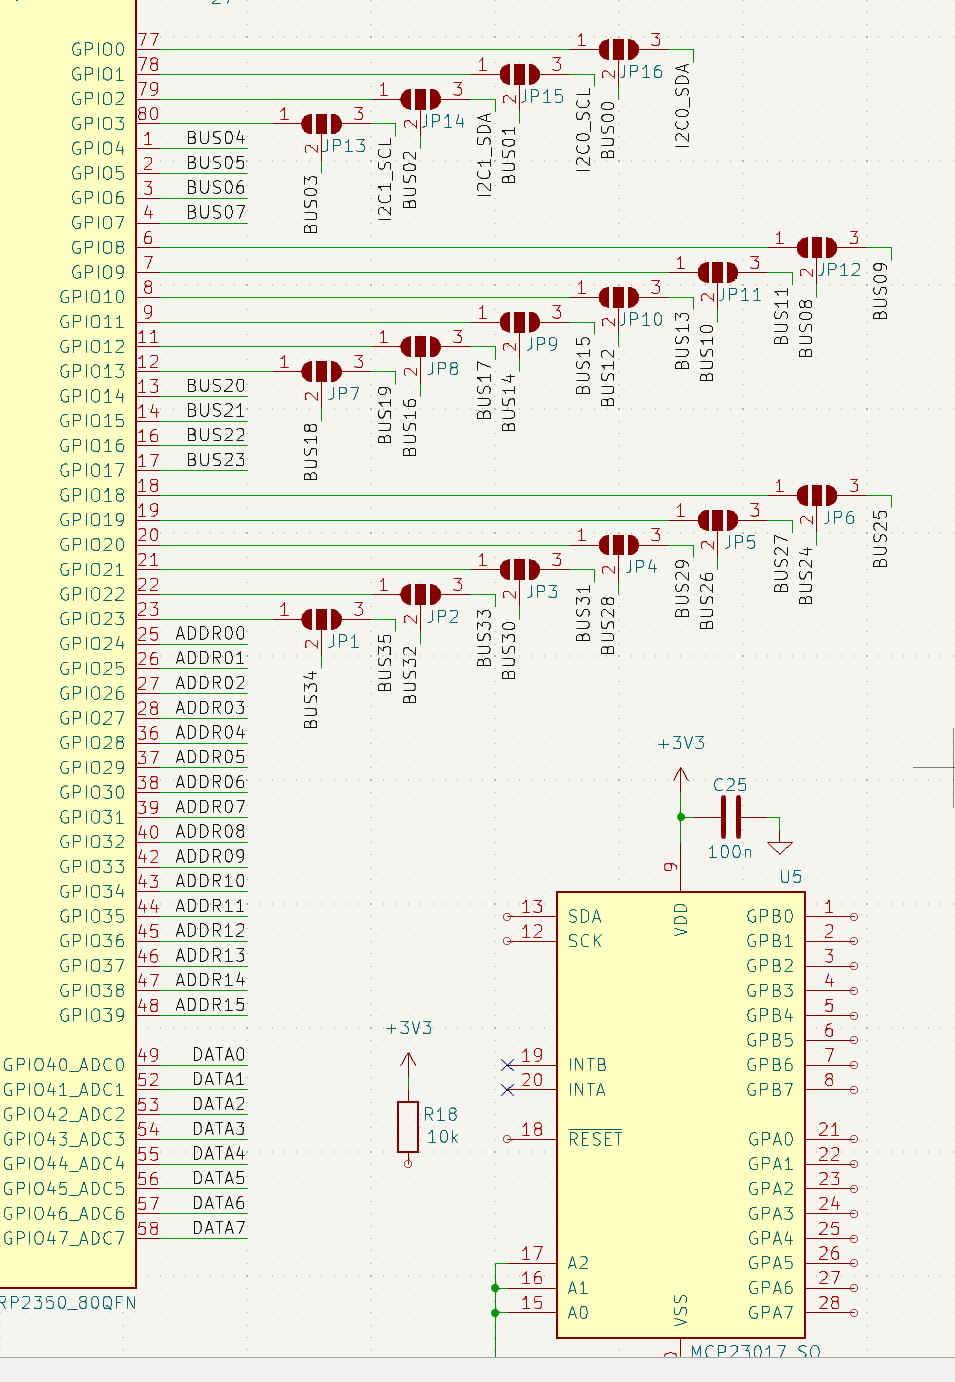
Team/journal/img - member1/week5/sch07.png
