AlphaCassiopeiae/web/Team/journal/img - member1/week5/usbccc.png

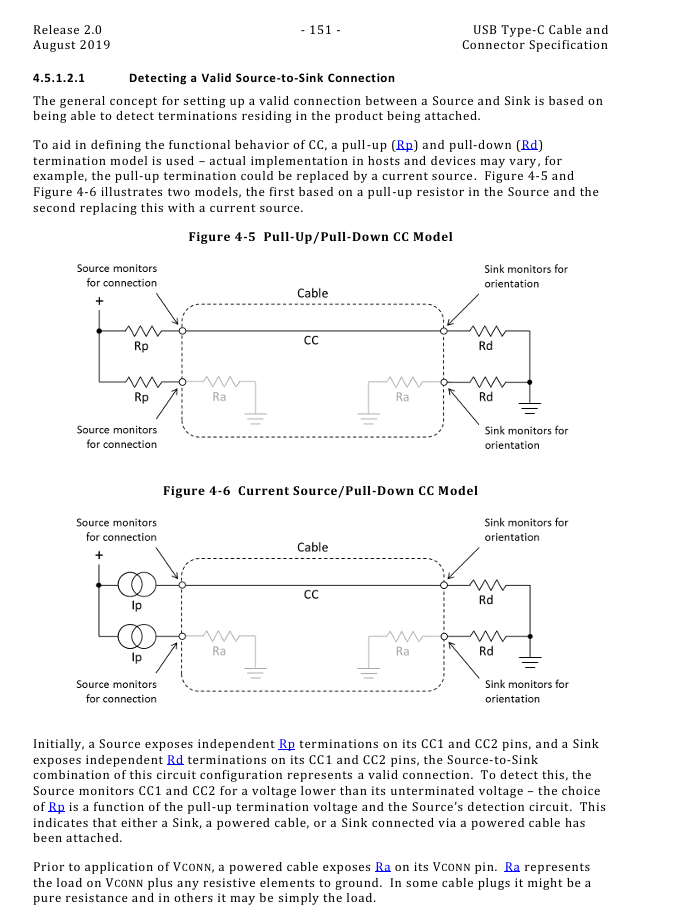
Team/journal/img - member1/week5/usbccc.png
