AlphaCassiopeiae/web/Team/journal/img - member1/week6/phone10.png

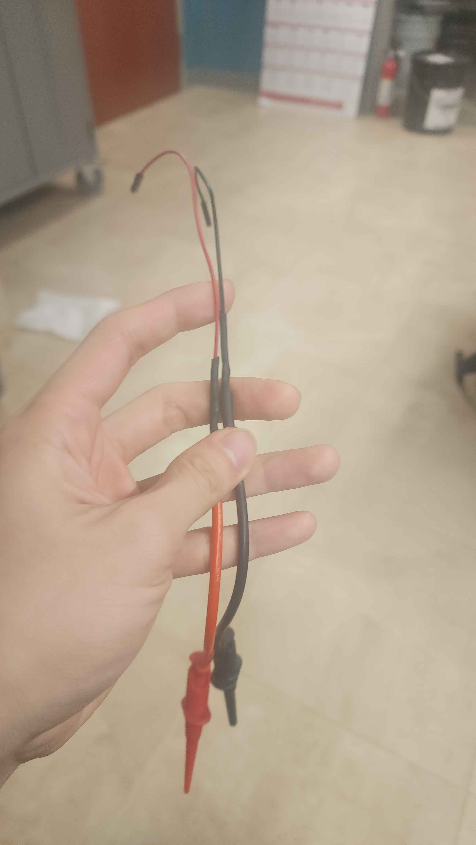
Team/journal/img - member1/week6/phone10.png
