AlphaCassiopeiae/web/Team/journal/img - member1/week7/3.3.png

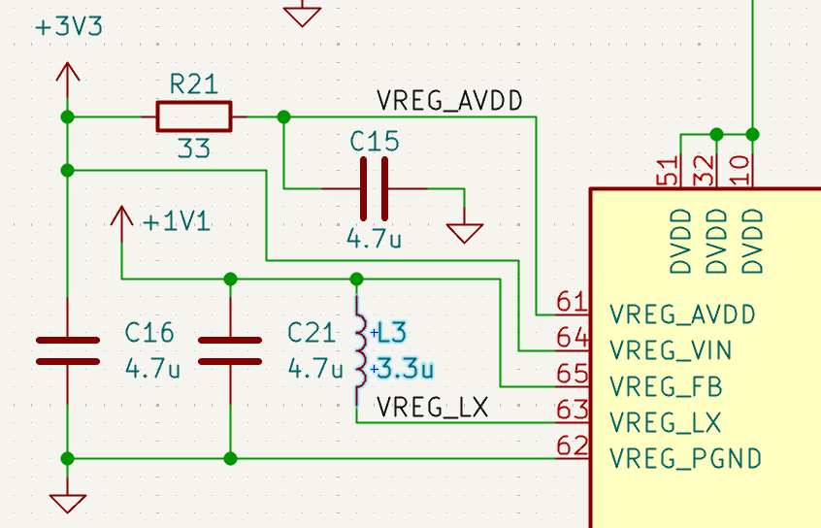
Team/journal/img - member1/week7/3.3.png
