AlphaCassiopeiae/web/Team/journal/img - member1/week7/3.4.png

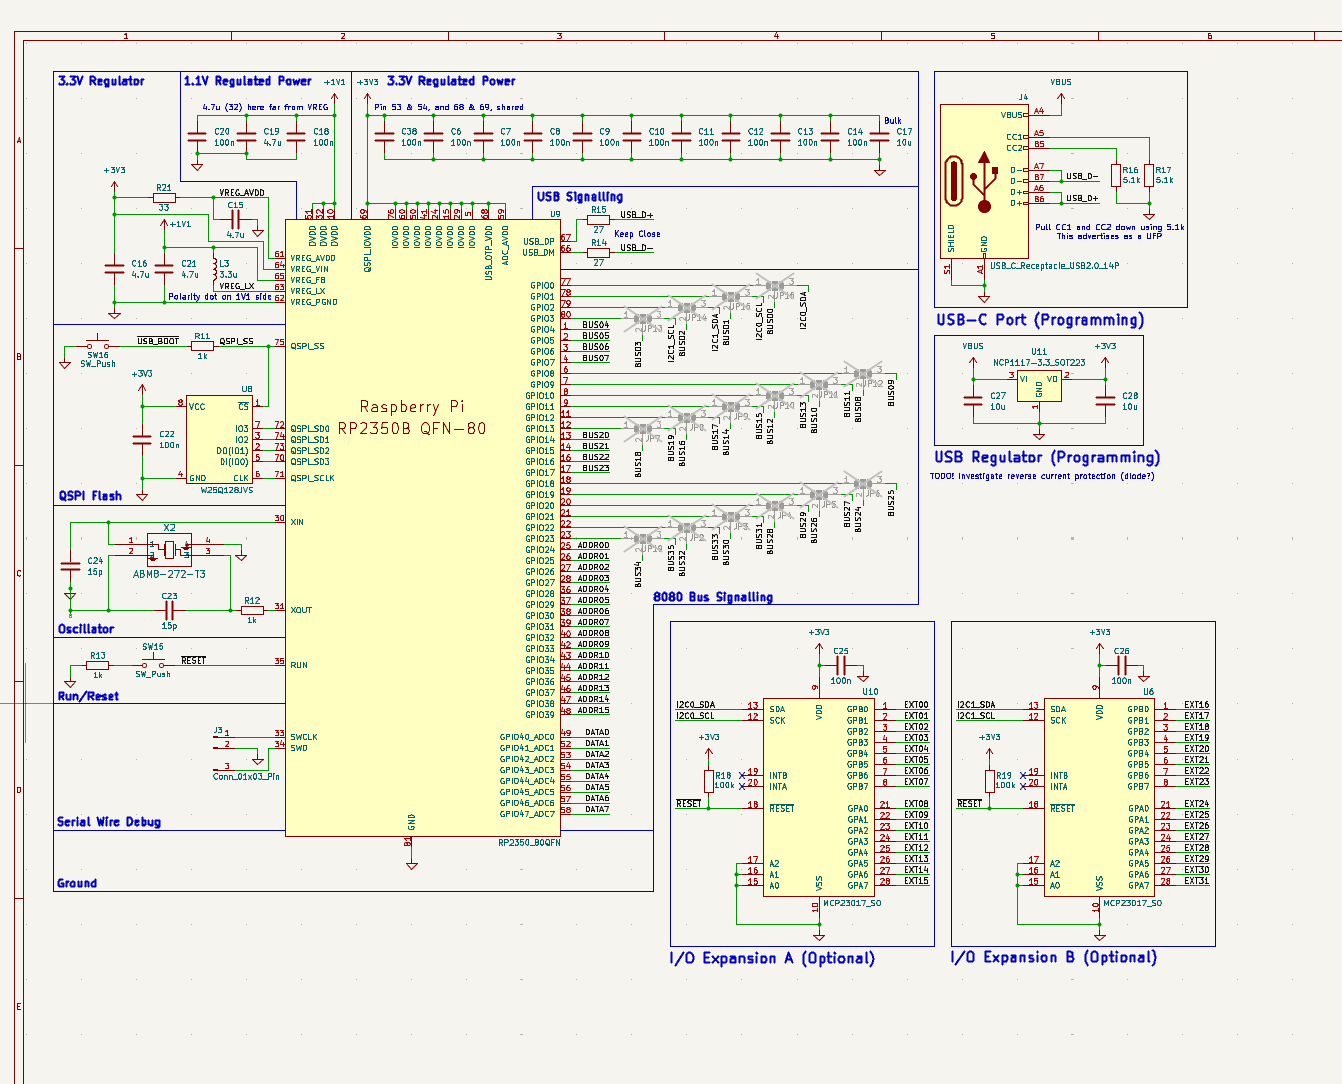
Team/journal/img - member1/week7/3.4.png
