AlphaCassiopeiae/web/Team/journal/img - member1/week8/1.10.png

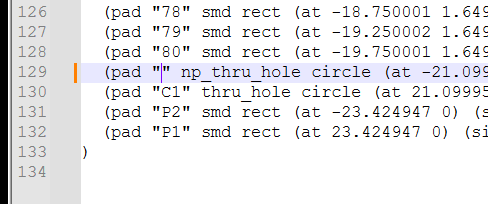
Team/journal/img - member1/week8/1.10.png
