AlphaCassiopeiae/web/Team/journal/img - member1/week8/2.2.png

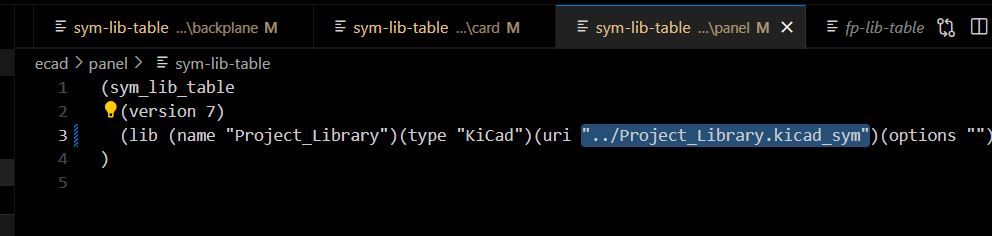
Team/journal/img - member1/week8/2.2.png
