AlphaCassiopeiae/web/Team/journal/img - member1/week8/2.4.png

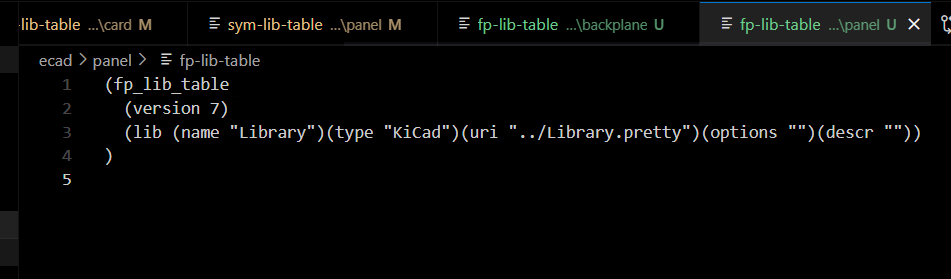
Team/journal/img - member1/week8/2.4.png
