AlphaCassiopeiae/web/Team/journal/img - member1/week8/2.12.png

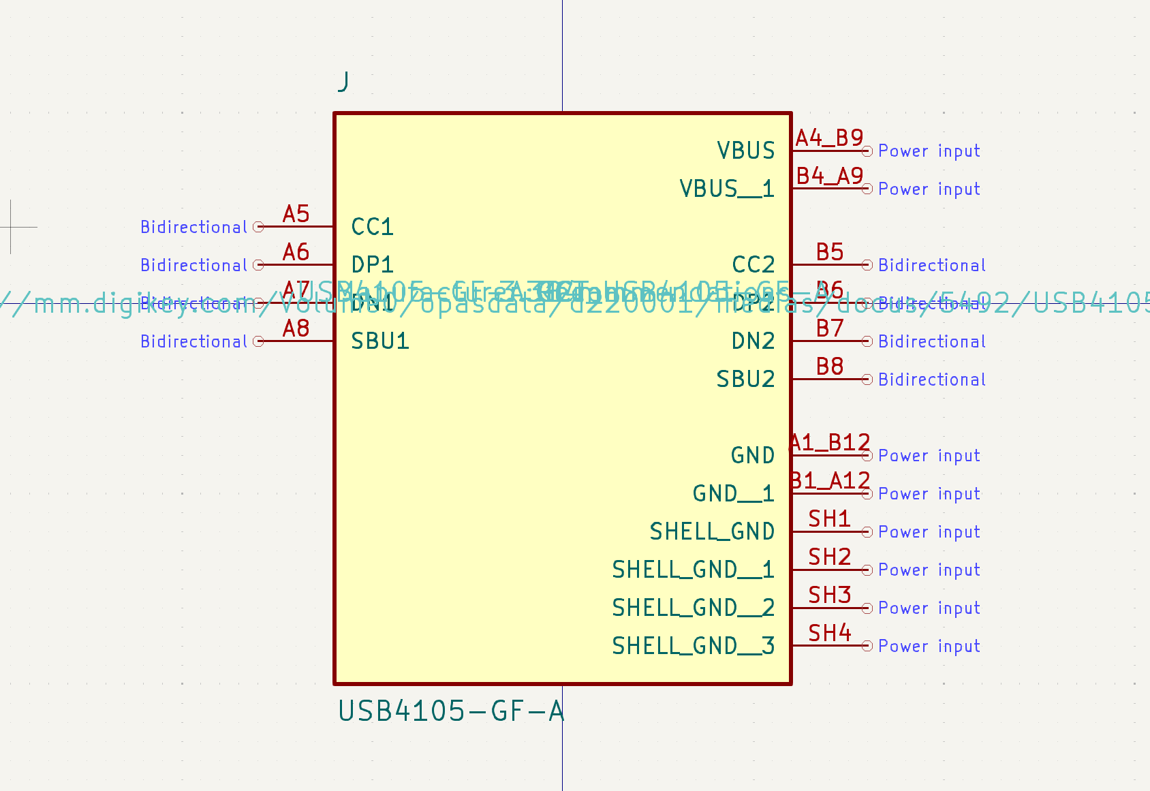
Team/journal/img - member1/week8/2.12.png
