AlphaCassiopeiae/web/Team/journal/img - member1/week8/2.24.png

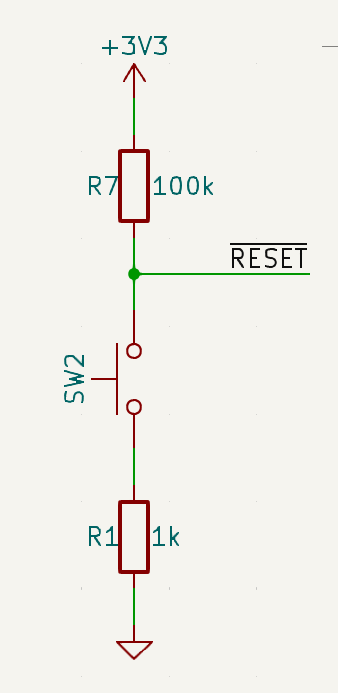
Team/journal/img - member1/week8/2.24.png
