AlphaCassiopeiae/web/Team/journal/img - member1/week8/3.4.png

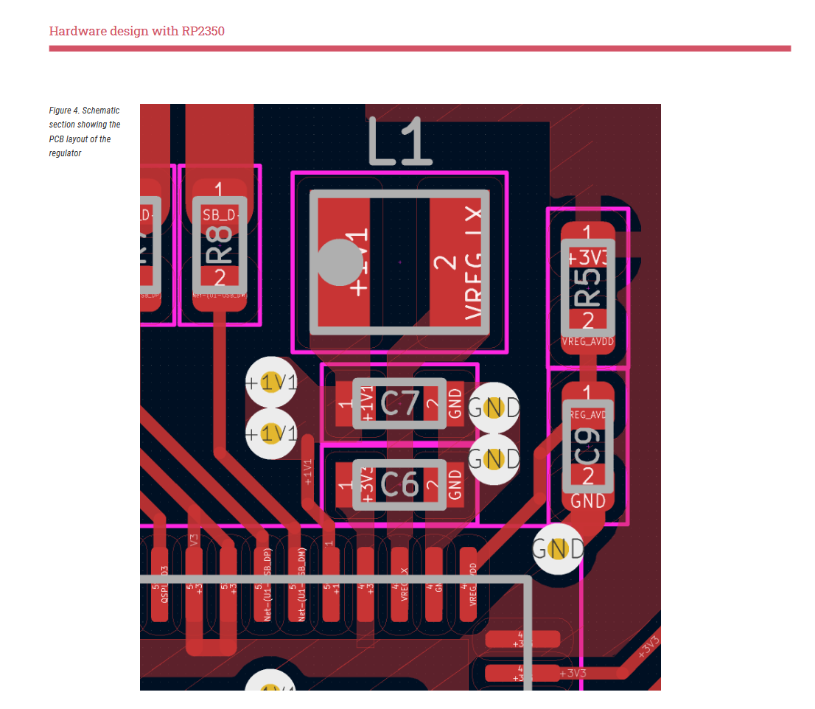
Team/journal/img - member1/week8/3.4.png
