AlphaCassiopeiae/web/Team/journal/img - member1/week8/3.9.png

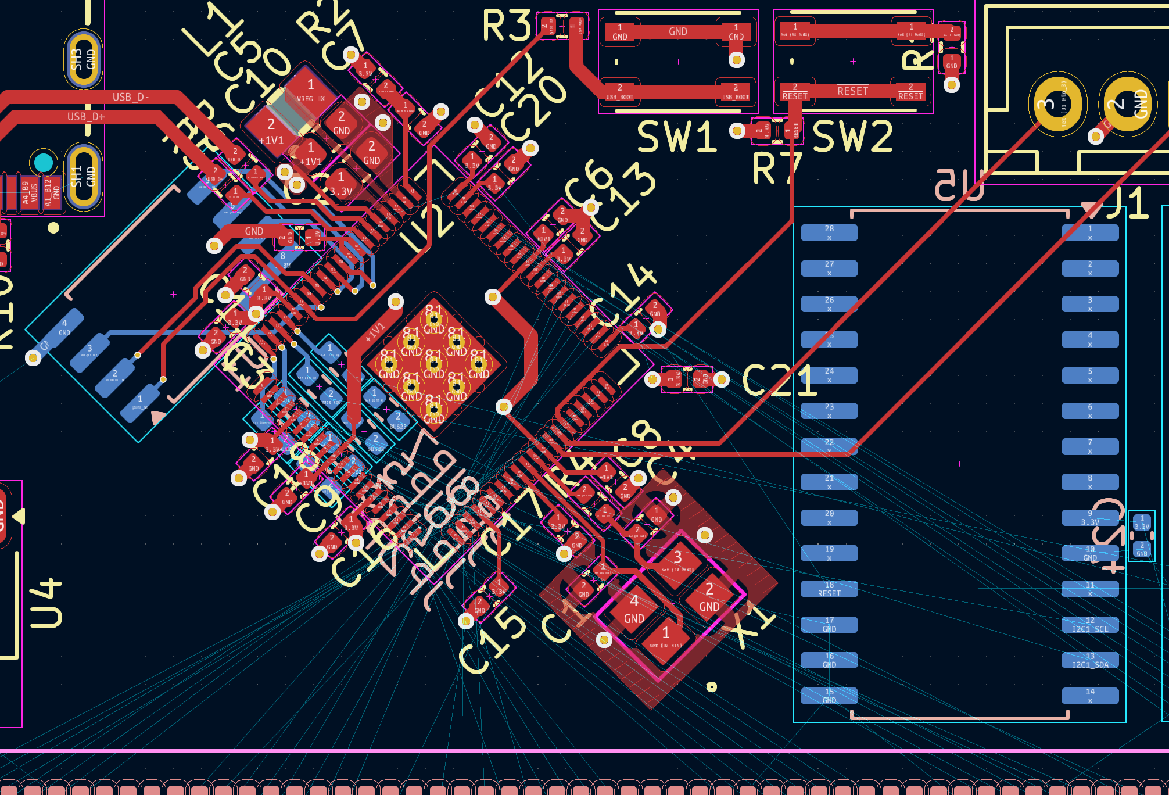
Team/journal/img - member1/week8/3.9.png
