AlphaCassiopeiae/web/Team/journal/img - member1/week9/1.5.png

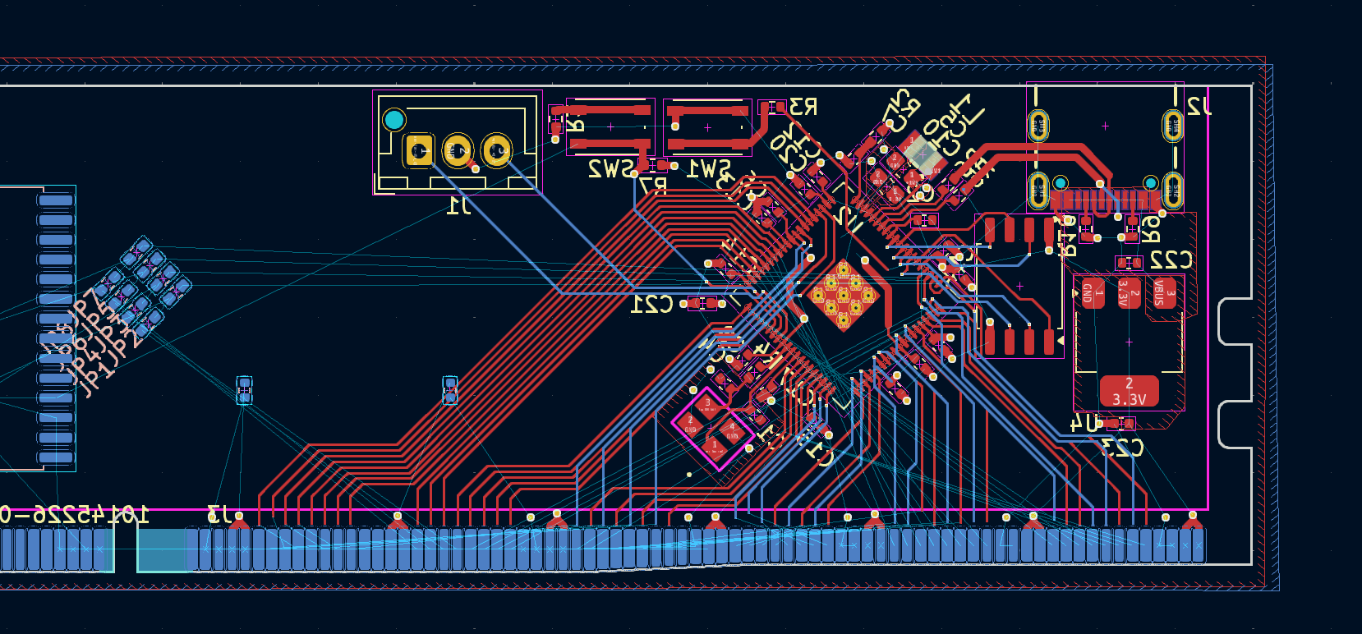
Team/journal/img - member1/week9/1.5.png
