AlphaCassiopeiae/web/Team/journal/img - member1/week9/1.17.png

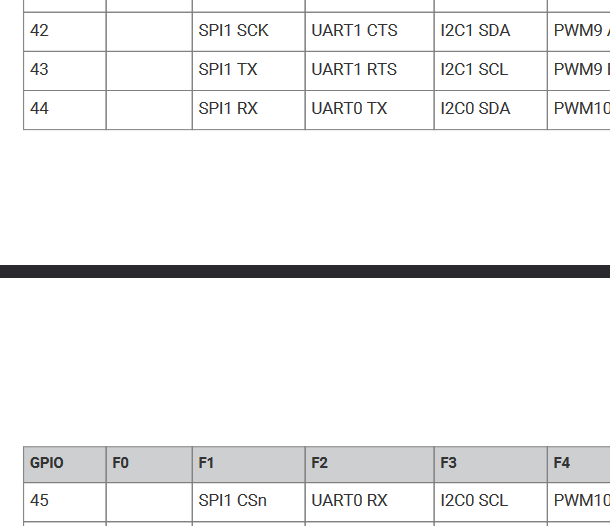
Team/journal/img - member1/week9/1.17.png
