AlphaCassiopeiae/web/Team/journal/img - member1/week9/1.21.png

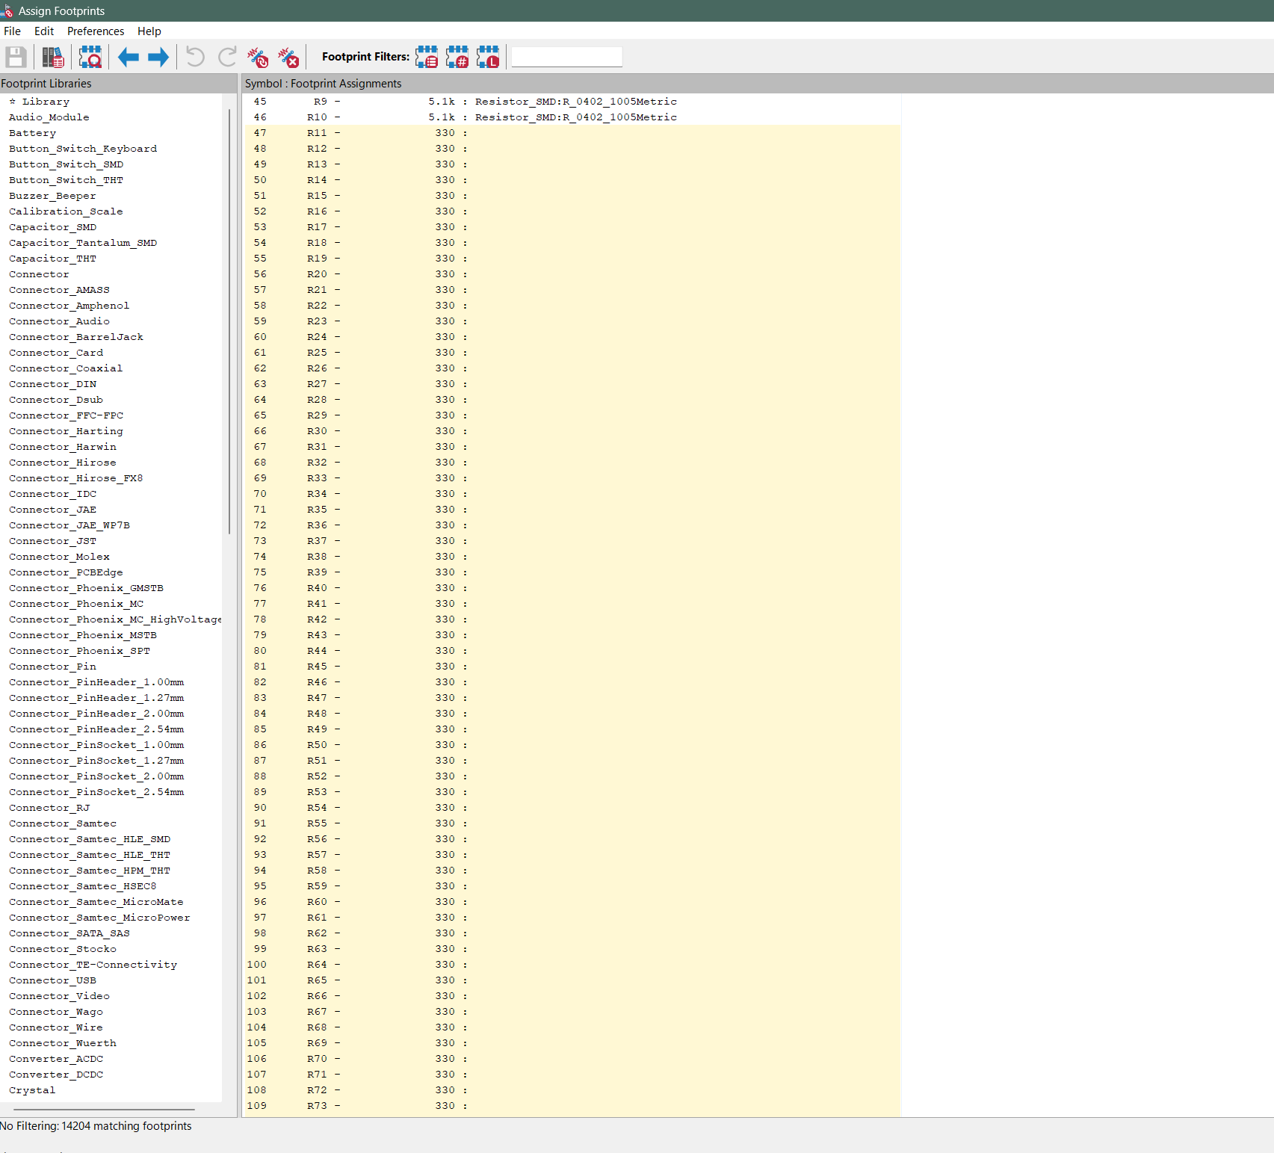
Team/journal/img - member1/week9/1.21.png
