AlphaCassiopeiae/web/Team/journal/img - member1/week9/1.24.png

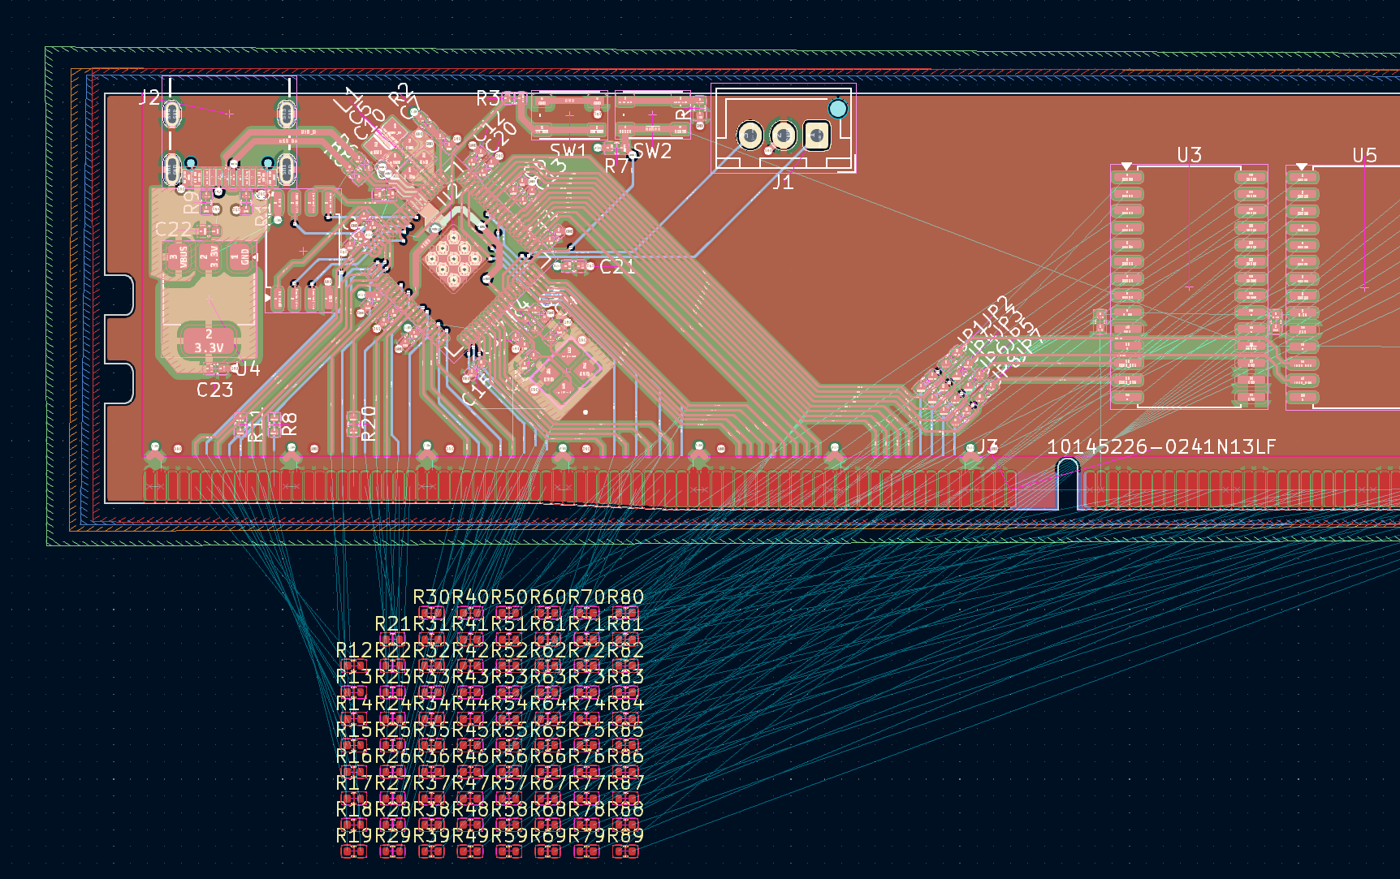
Team/journal/img - member1/week9/1.24.png
