AlphaCassiopeiae/web/Team/journal/img - member1/week9/1.34.png

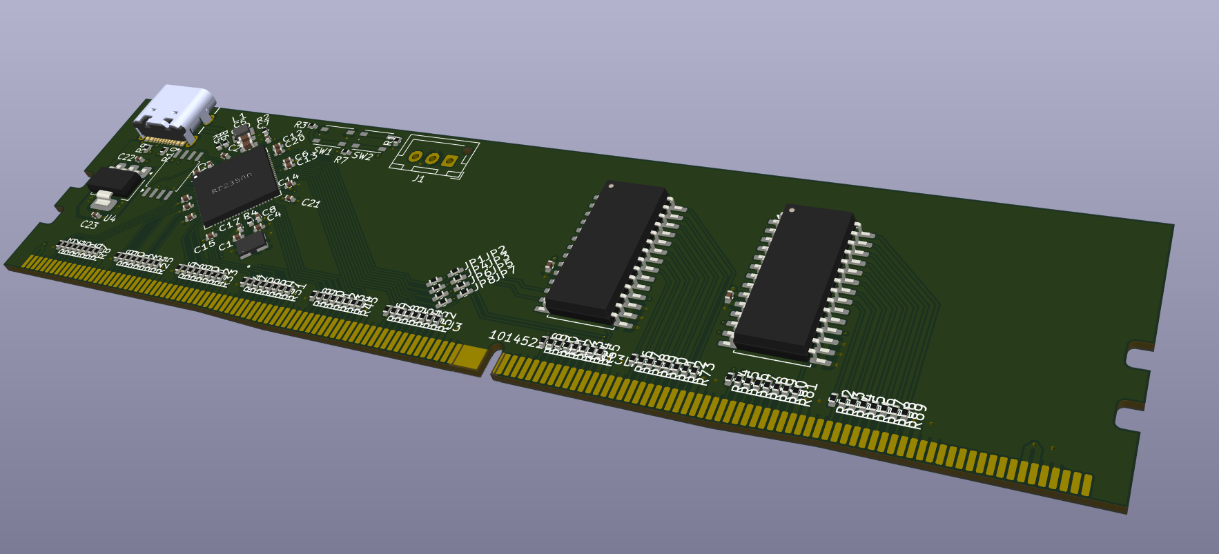
Team/journal/img - member1/week9/1.34.png
