AlphaCassiopeiae/web/Team/journal/img - member1/week9/2.9.png

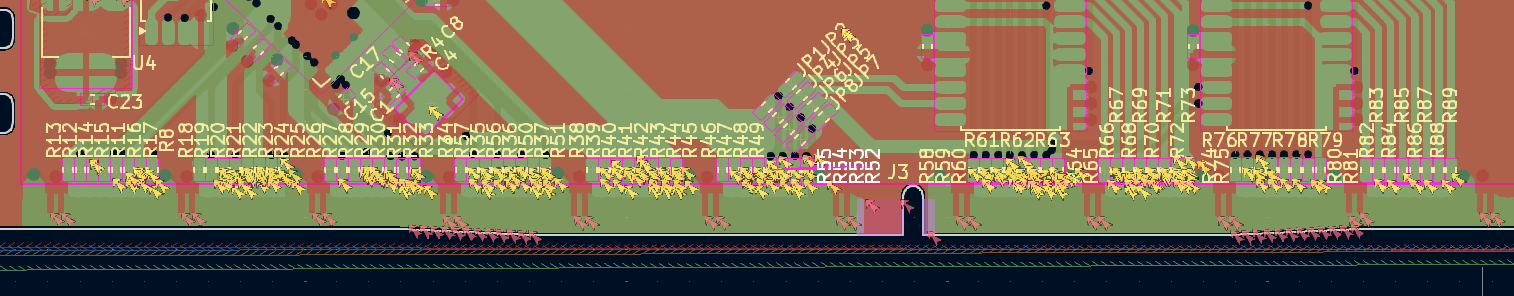
Team/journal/img - member1/week9/2.9.png
