AlphaCassiopeiae/web/Team/journal/img - member1/week9/2.11.png

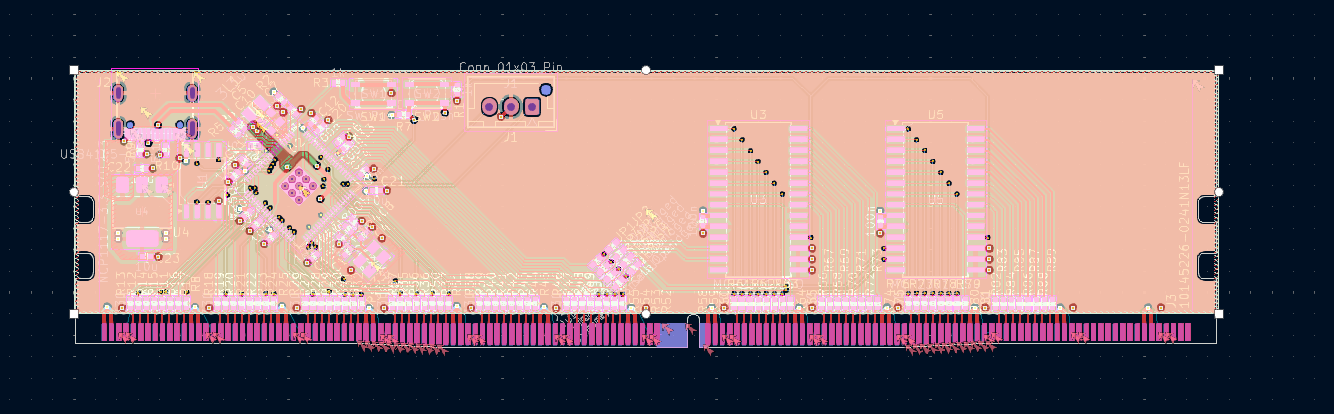
Team/journal/img - member1/week9/2.11.png
