AlphaCassiopeiae/web/Team/journal/img - member1/week9/2.18.png

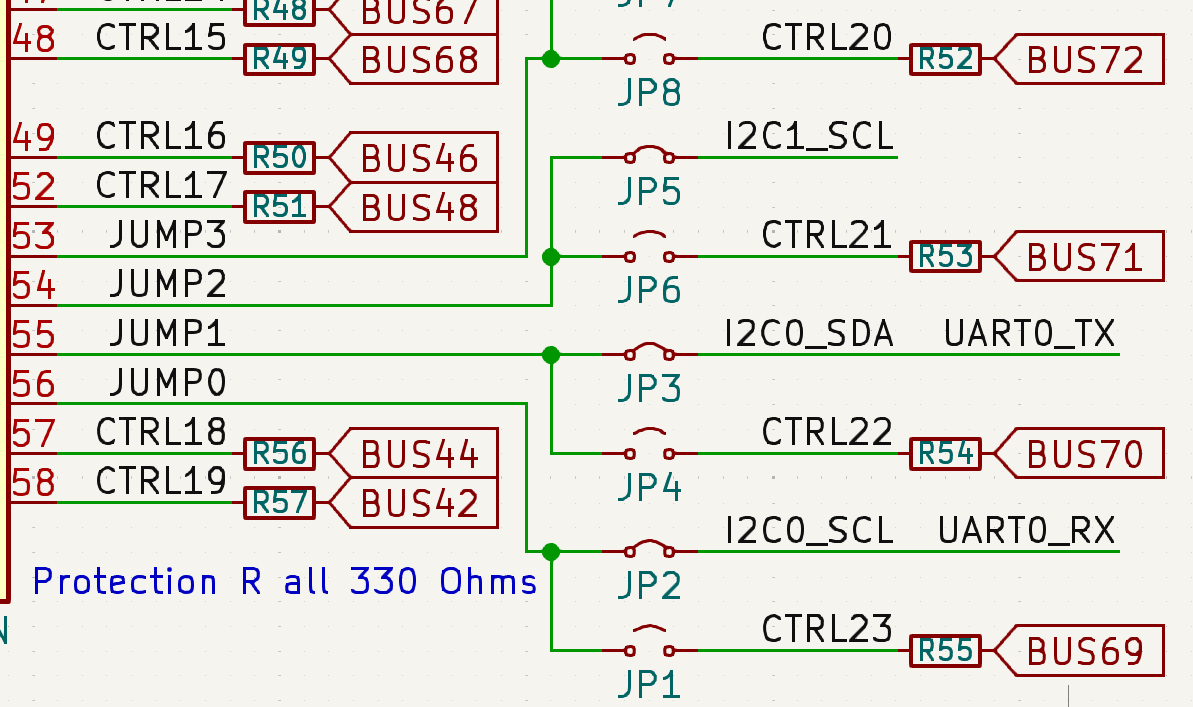
Team/journal/img - member1/week9/2.18.png
