AlphaCassiopeiae/web/Team/journal/img - member1/week9/2.20.png

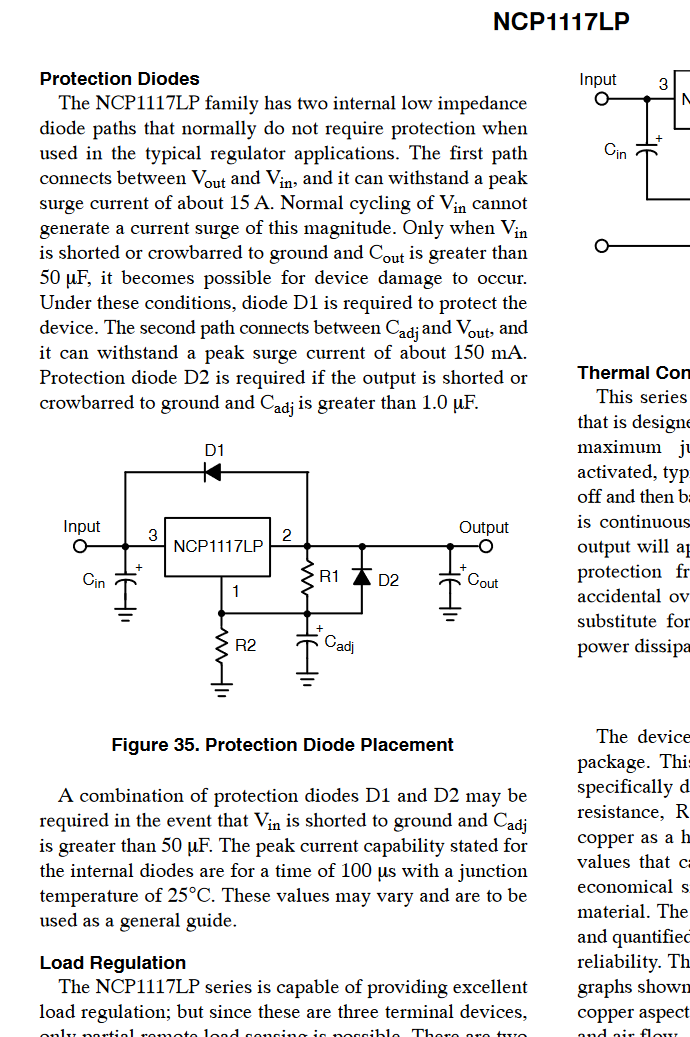
Team/journal/img - member1/week9/2.20.png
