AlphaCassiopeiae/web/Team/journal/img - member1/week9/3.8.png

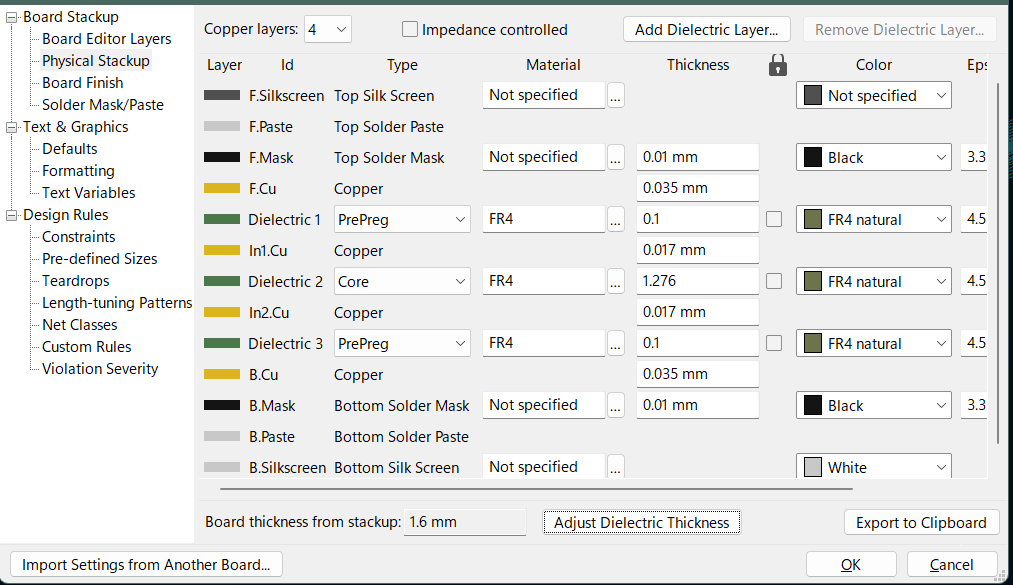
Team/journal/img - member1/week9/3.8.png
