AlphaCassiopeiae/web/Team/journal/img - member1/week9/3.10.png

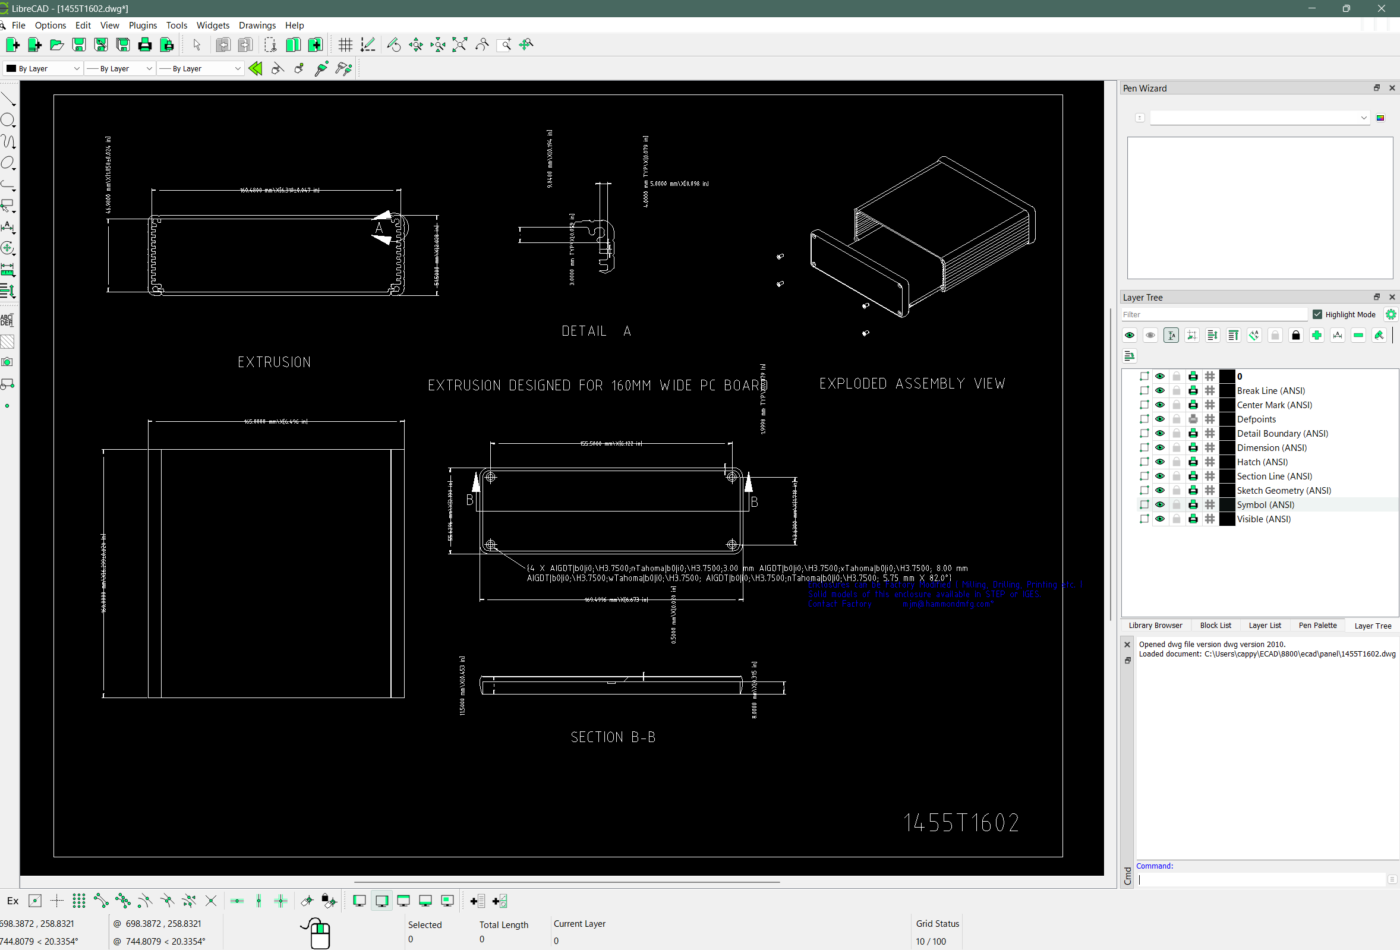
Team/journal/img - member1/week9/3.10.png
