AlphaCassiopeiae/web/Team/journal/img - member1/week9/3.27.png

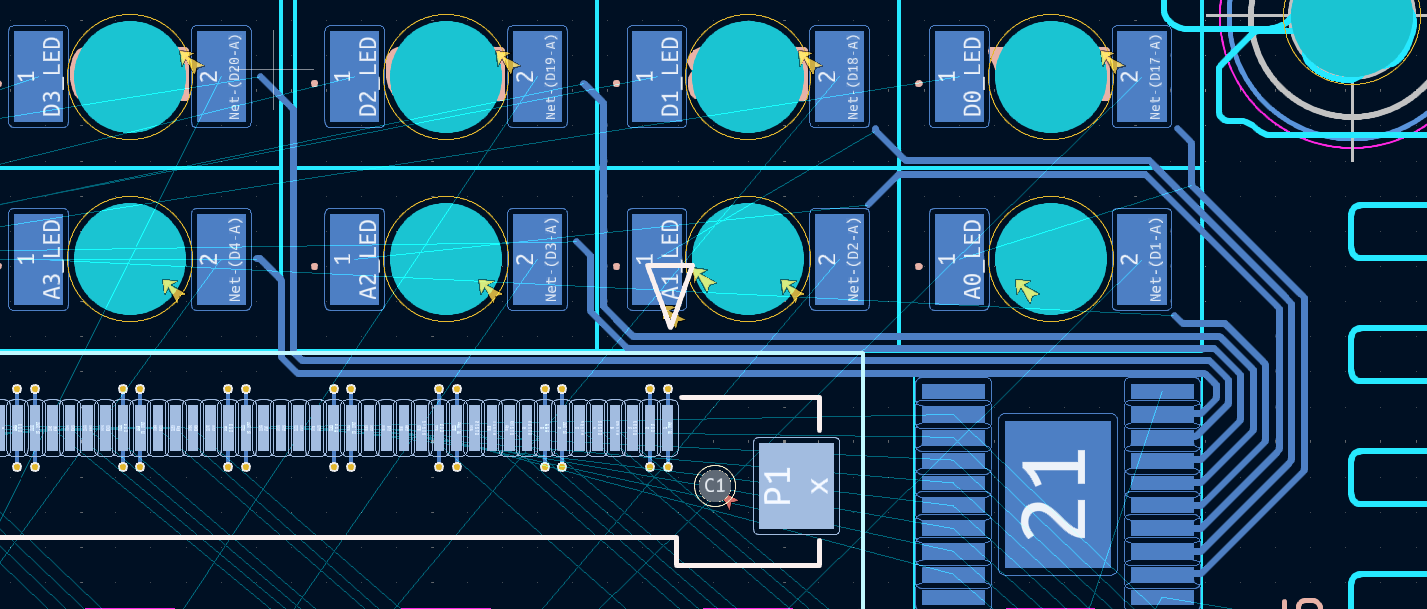
Team/journal/img - member1/week9/3.27.png
