AlphaCassiopeiae/web/Team/journal/img - member1/week9/3.30.png

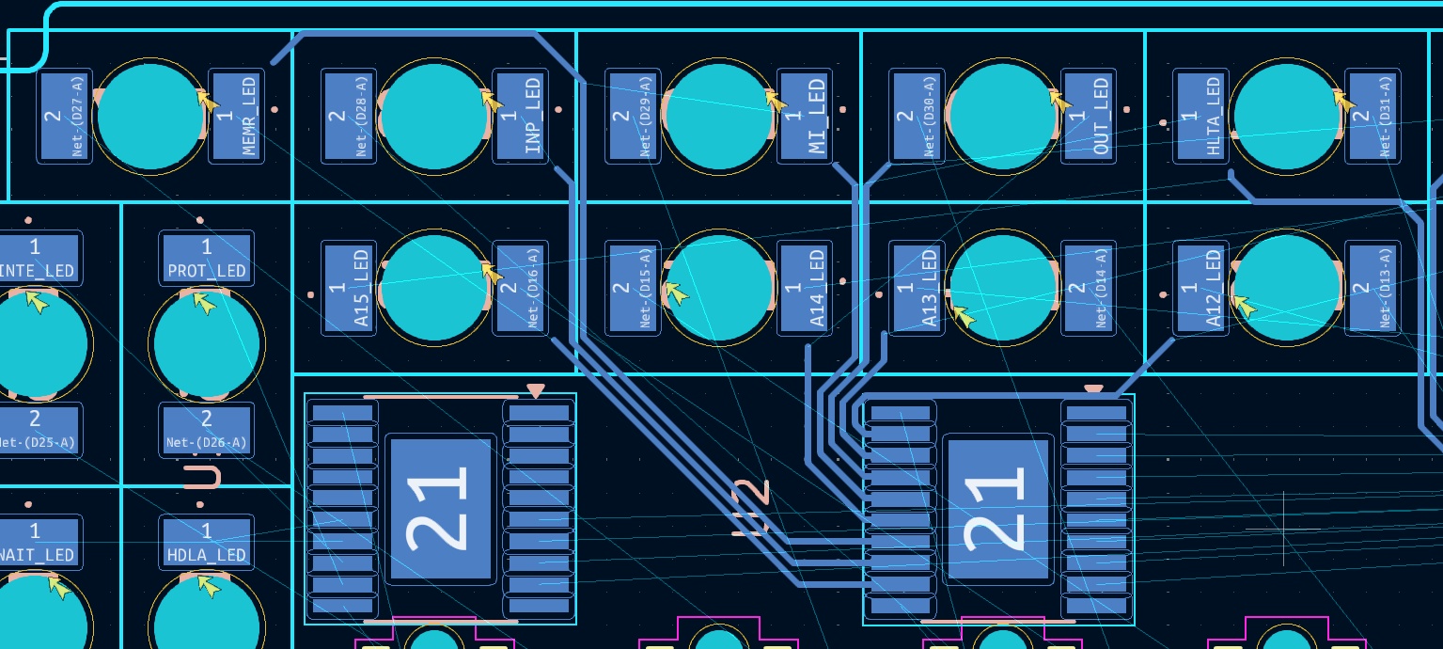
Team/journal/img - member1/week9/3.30.png
