AlphaCassiopeiae/web/Team/journal/img - member1/week9/3.40.png

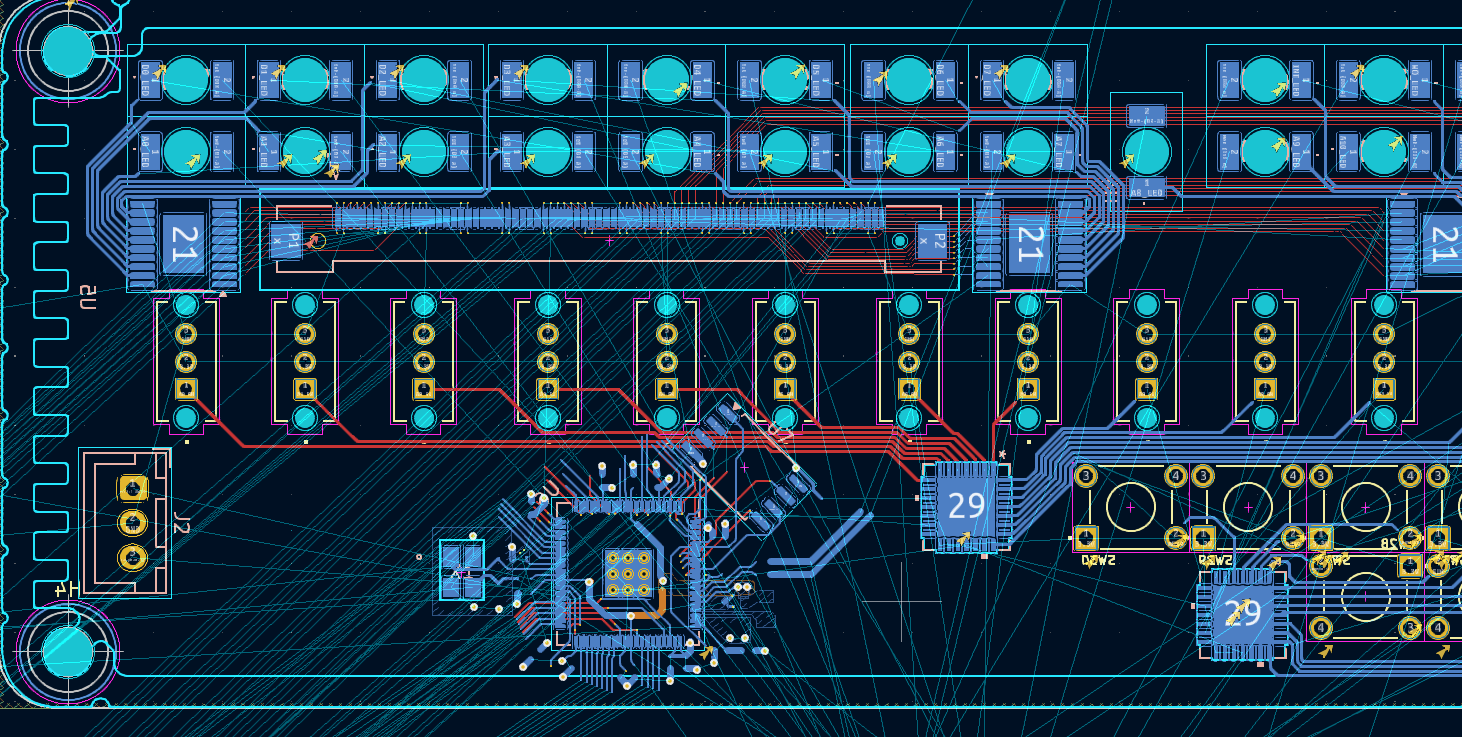
Team/journal/img - member1/week9/3.40.png
