AlphaCassiopeiae/web/Team/journal/img - member1/week9/3.41.png

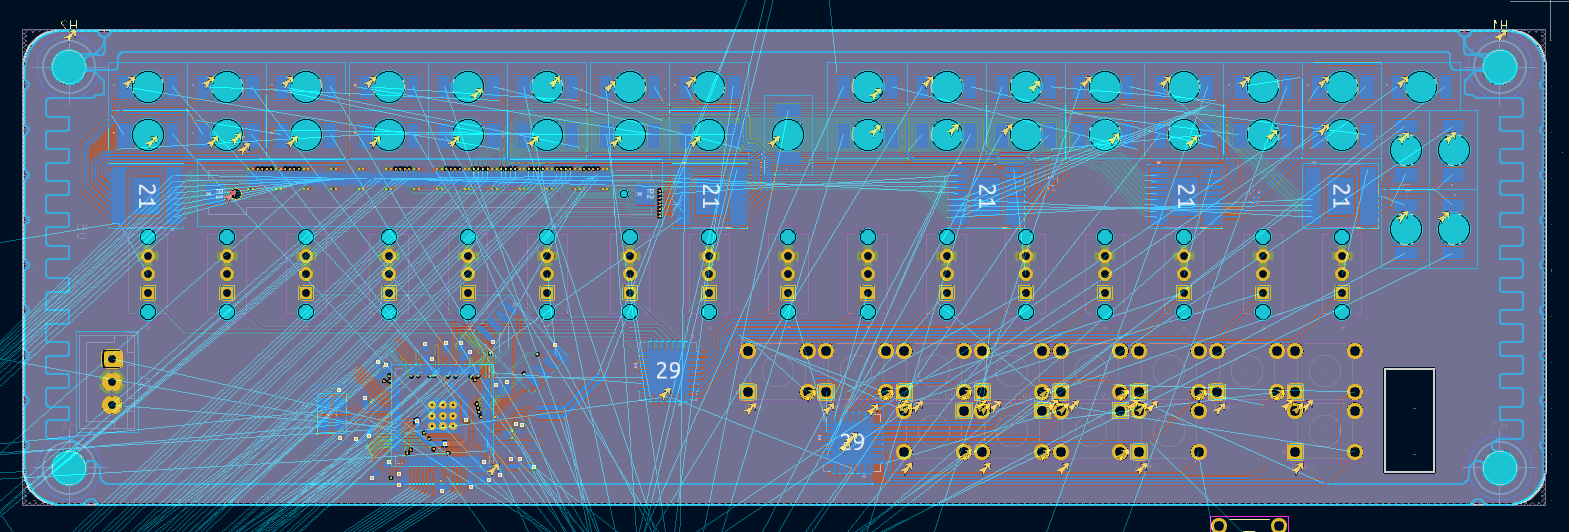
Team/journal/img - member1/week9/3.41.png
