AlphaCassiopeiae/web/Team/journal/img - member1/week9/4.22.png

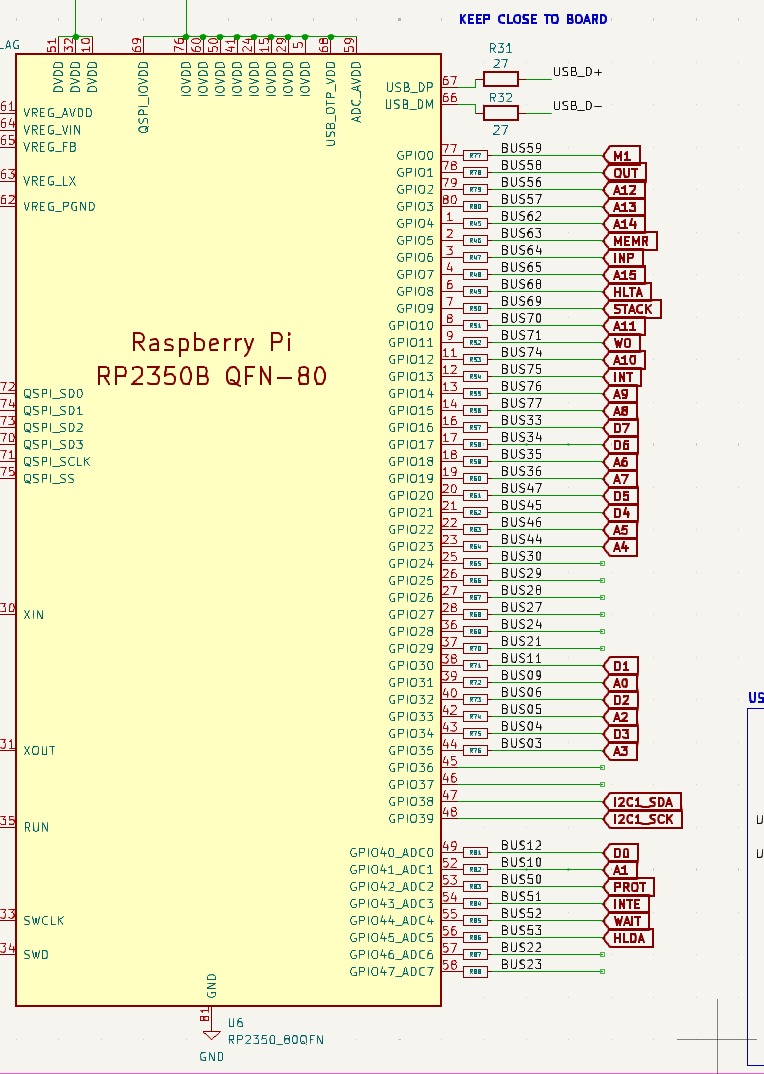
Team/journal/img - member1/week9/4.22.png
