AlphaCassiopeiae/web/Team/journal/img - member1/week9/5.4.png

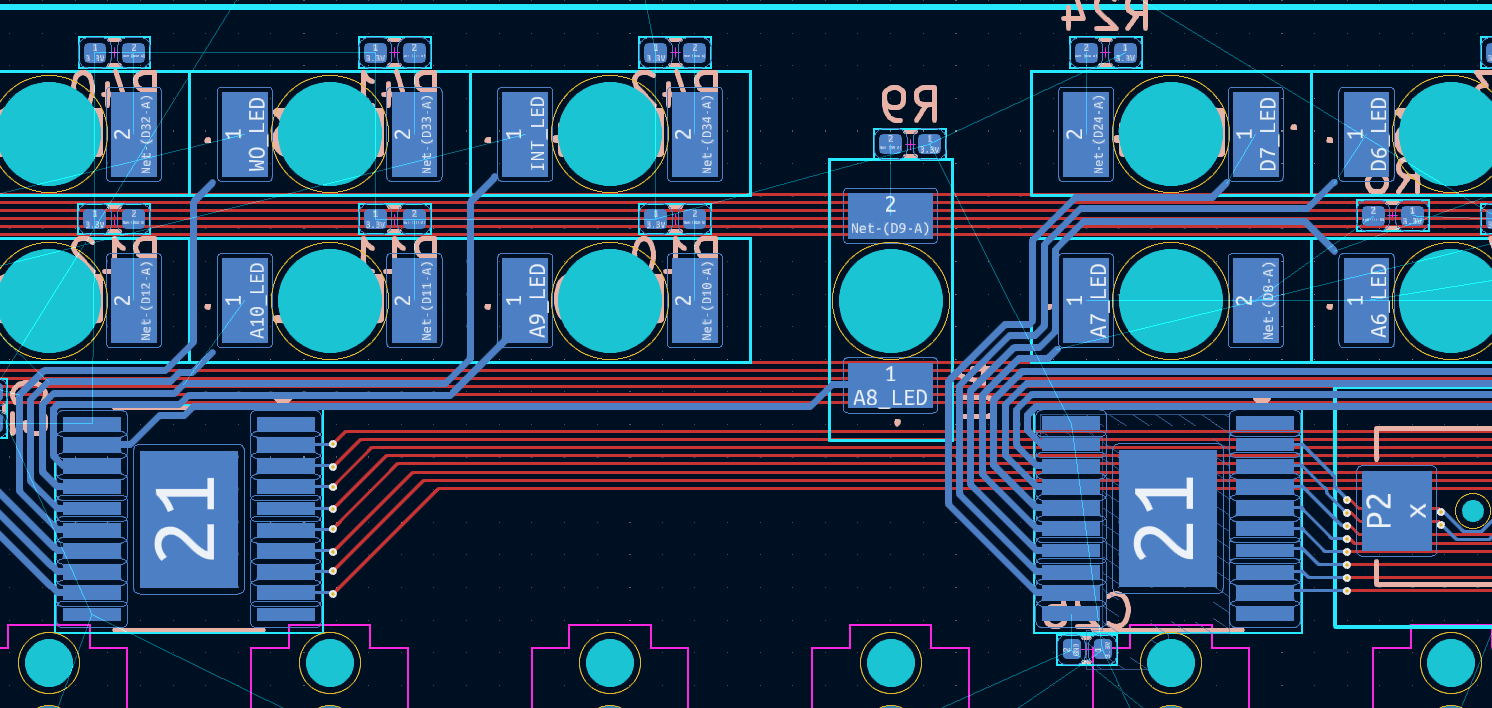
Team/journal/img - member1/week9/5.4.png
