AlphaCassiopeiae/web/Team/journal/img - member1/week9/5.5.png

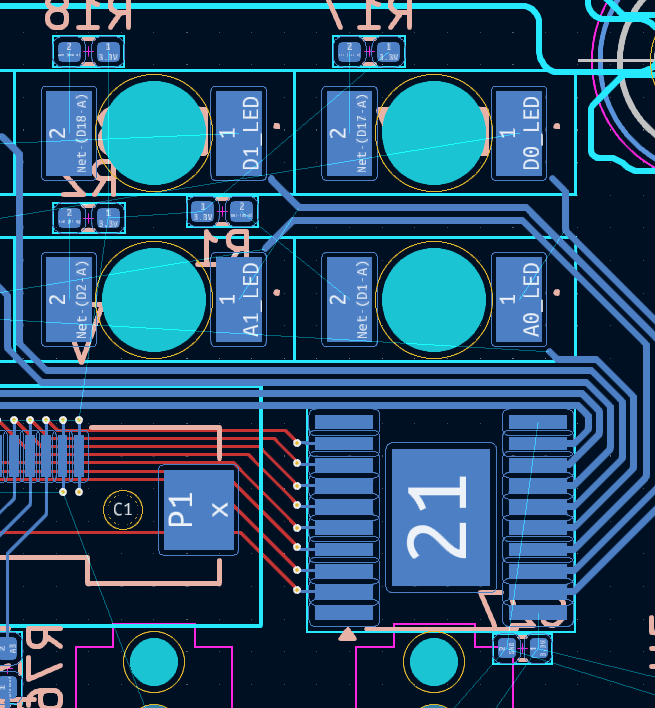
Team/journal/img - member1/week9/5.5.png
