AlphaCassiopeiae/web/Team/journal/img - member1/week9/5.6.png

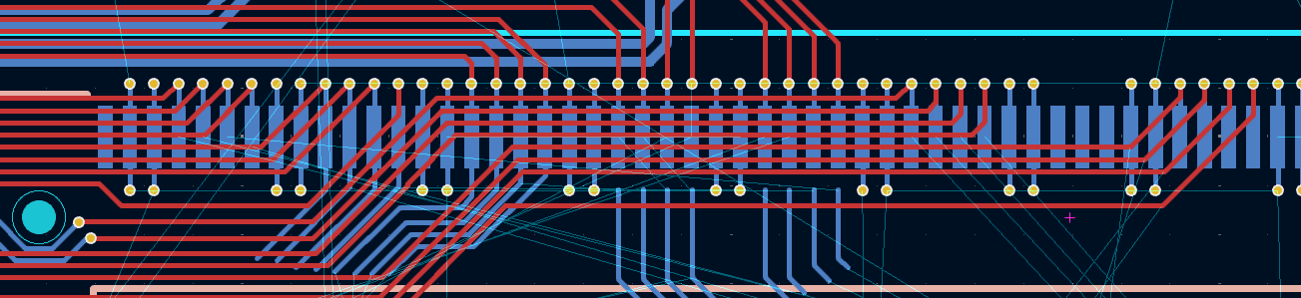
Team/journal/img - member1/week9/5.6.png
