AlphaCassiopeiae/web/Team/journal/img - member1/week9/5.14.png

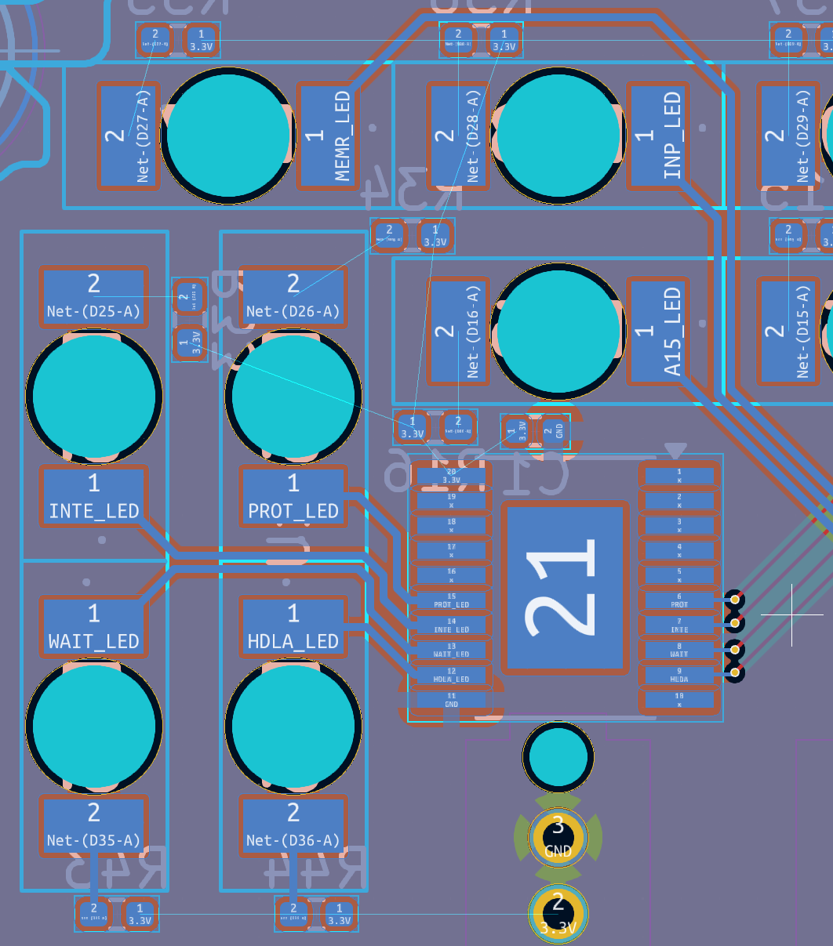
Team/journal/img - member1/week9/5.14.png
