AlphaCassiopeiae/web/Team/journal/img - member1/week9/6.7.png

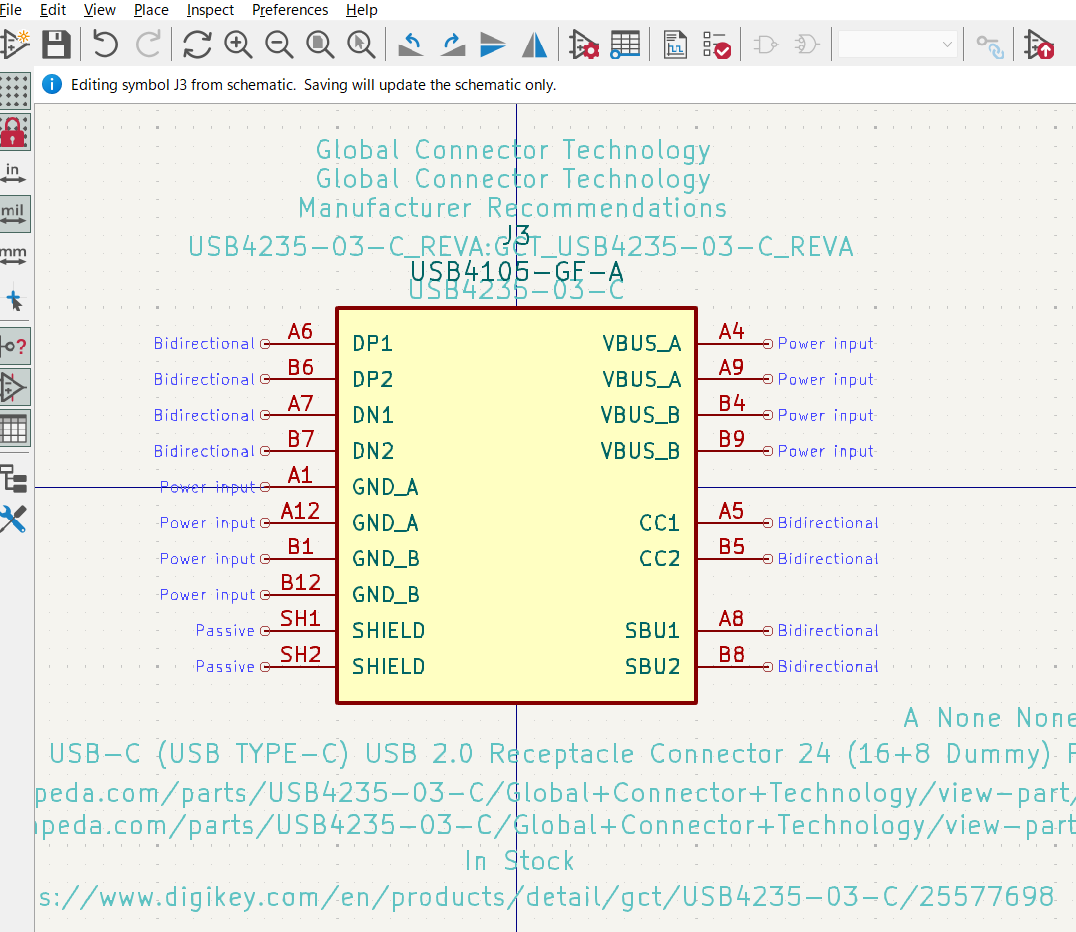
Team/journal/img - member1/week9/6.7.png
