AlphaCassiopeiae/web/Team/journal/img - member1/week9/6.13.png

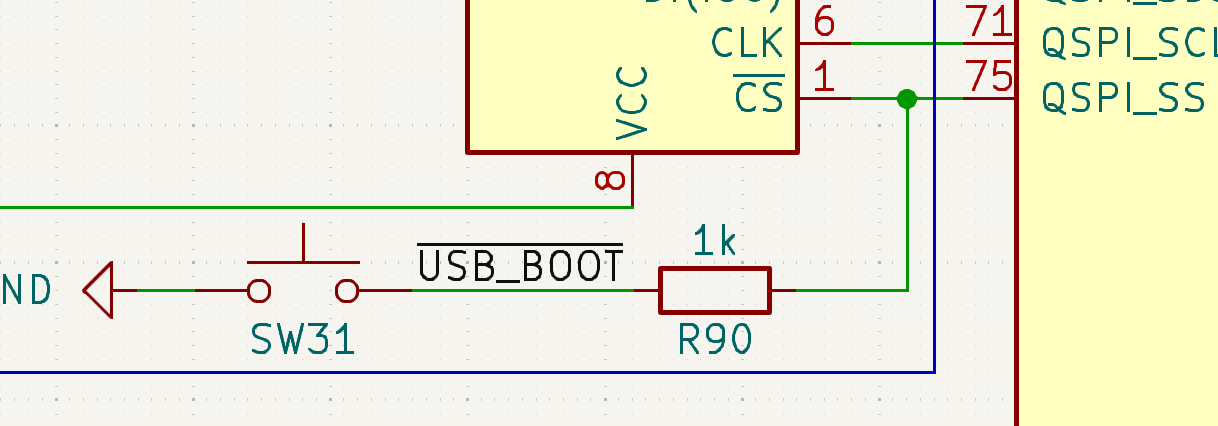
Team/journal/img - member1/week9/6.13.png
