AlphaCassiopeiae/web/Team/journal/img - member1/week9/7.3.png

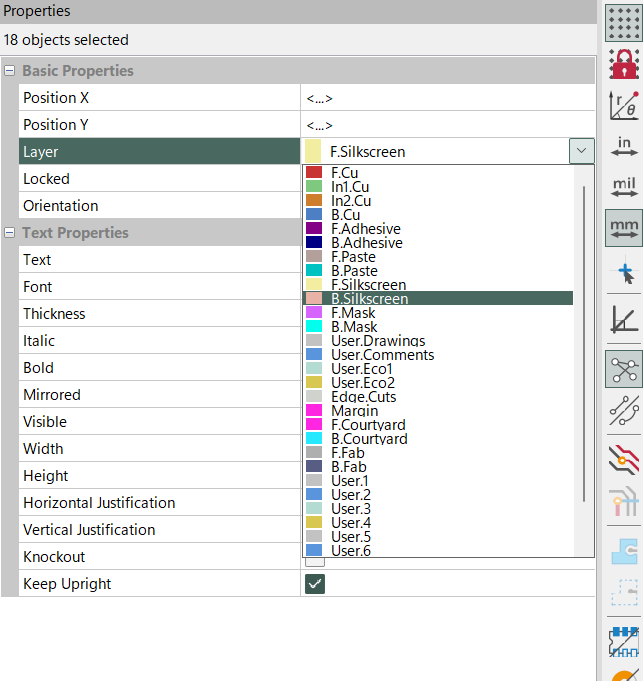
Team/journal/img - member1/week9/7.3.png
