AlphaCassiopeiae/web/Team/journal/img - member1/week9/7.28.png

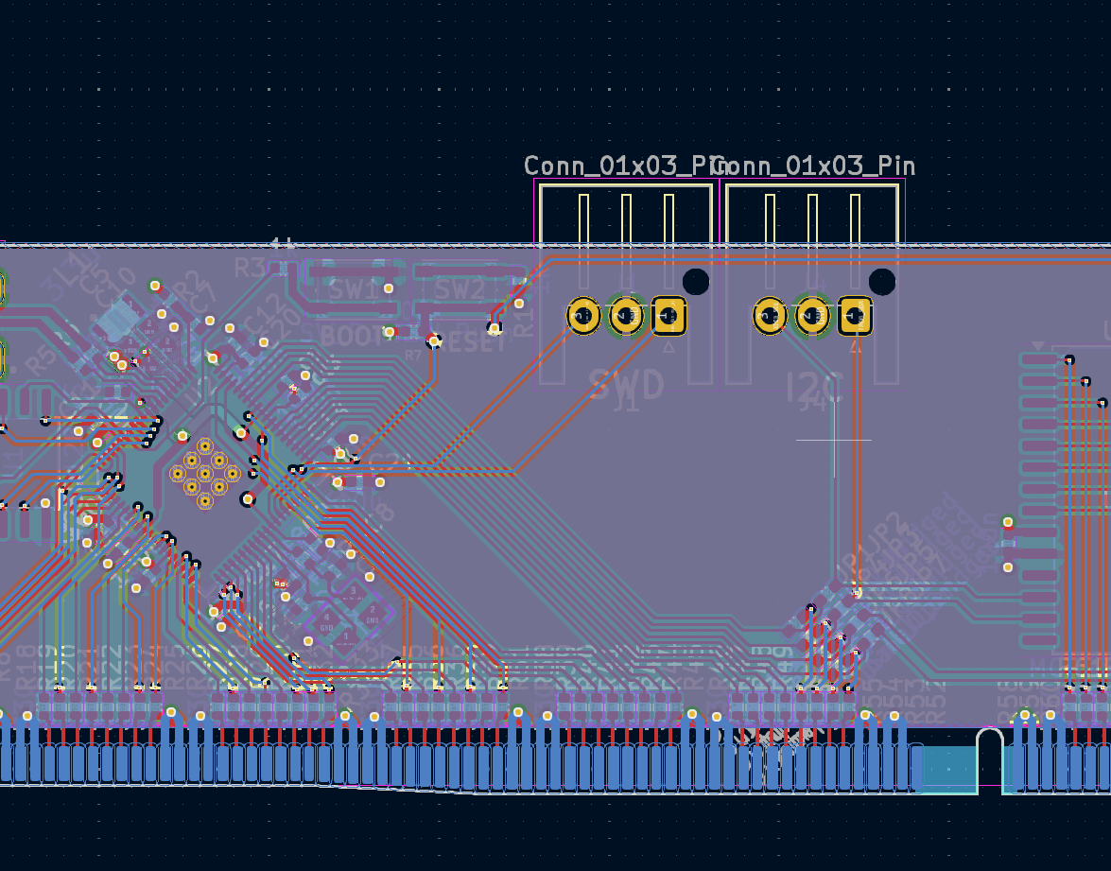
Team/journal/img - member1/week9/7.28.png
