AlphaCassiopeiae/web/Team/journal/img - member1/week9/8.11.png

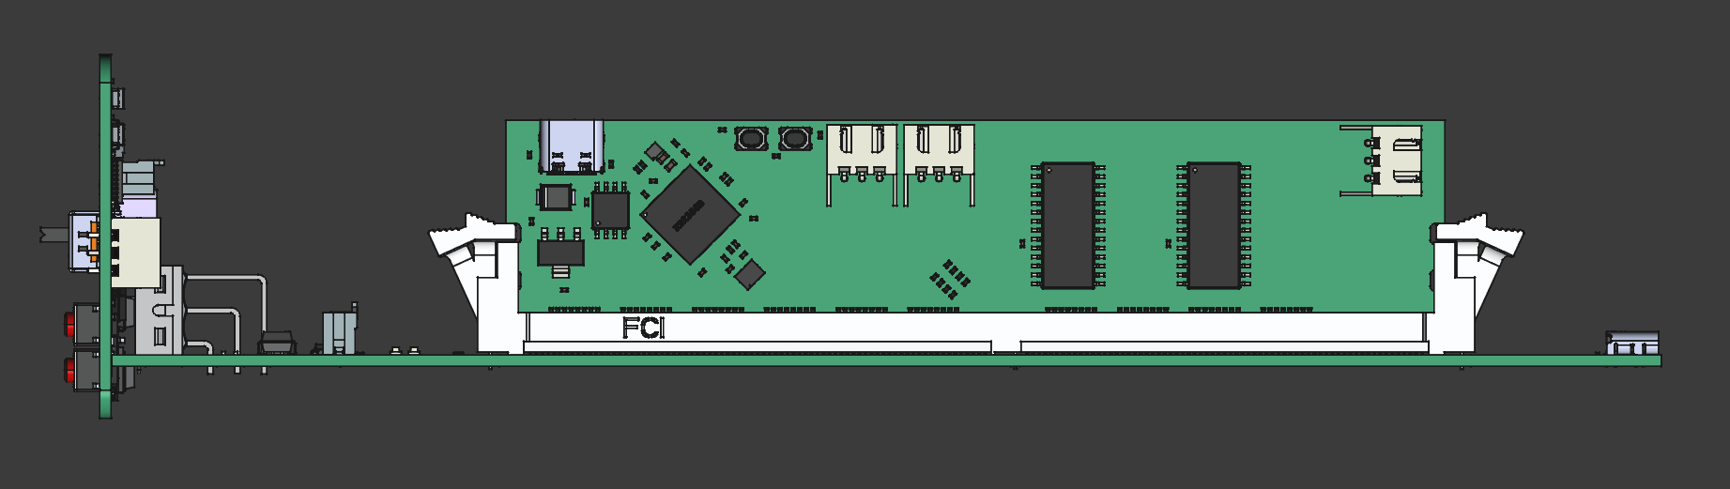
Team/journal/img - member1/week9/8.11.png
