AlphaCassiopeiae/web/Team/journal/img - member1/week9/8.22.png

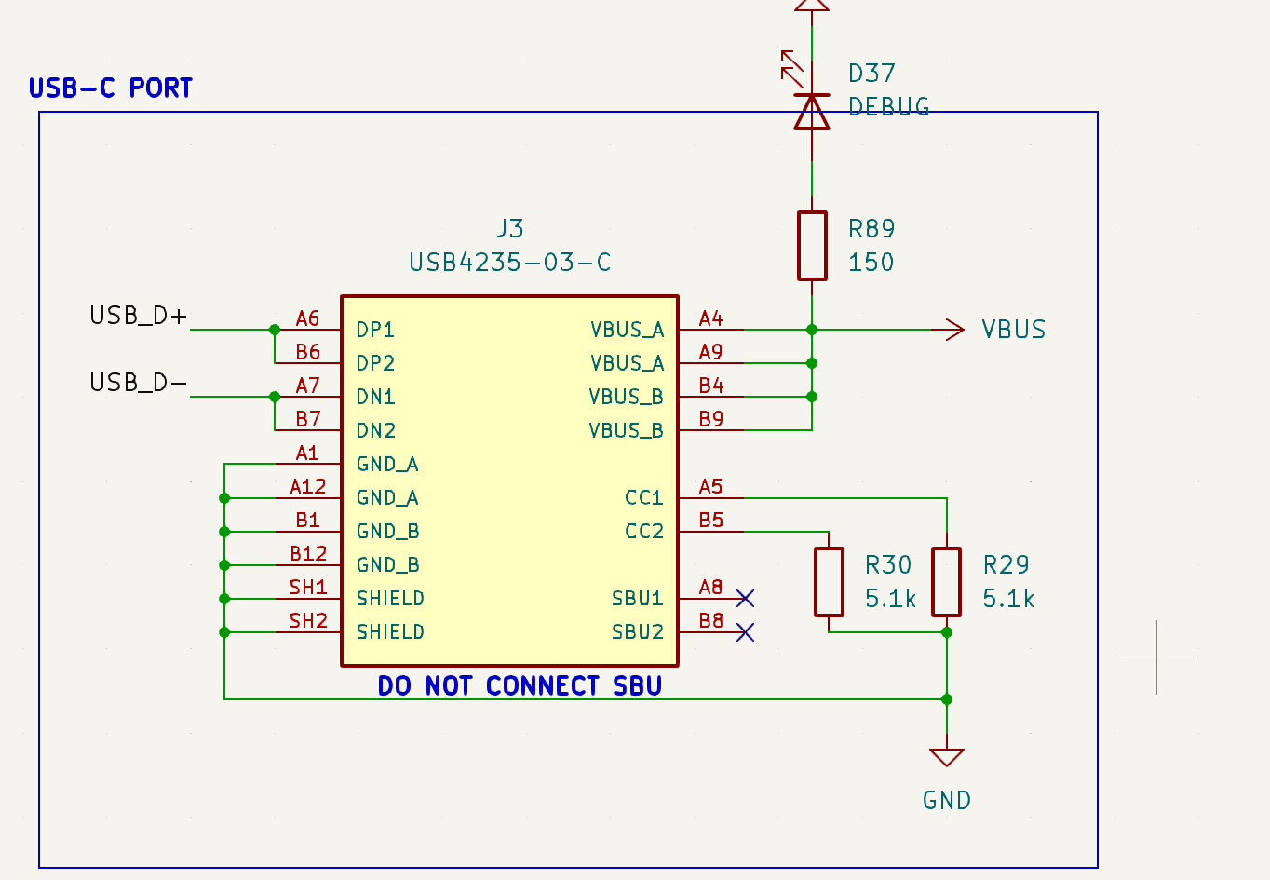
Team/journal/img - member1/week9/8.22.png
