AlphaCassiopeiae/web/Team/journal/img - member1/week9/8.26.png

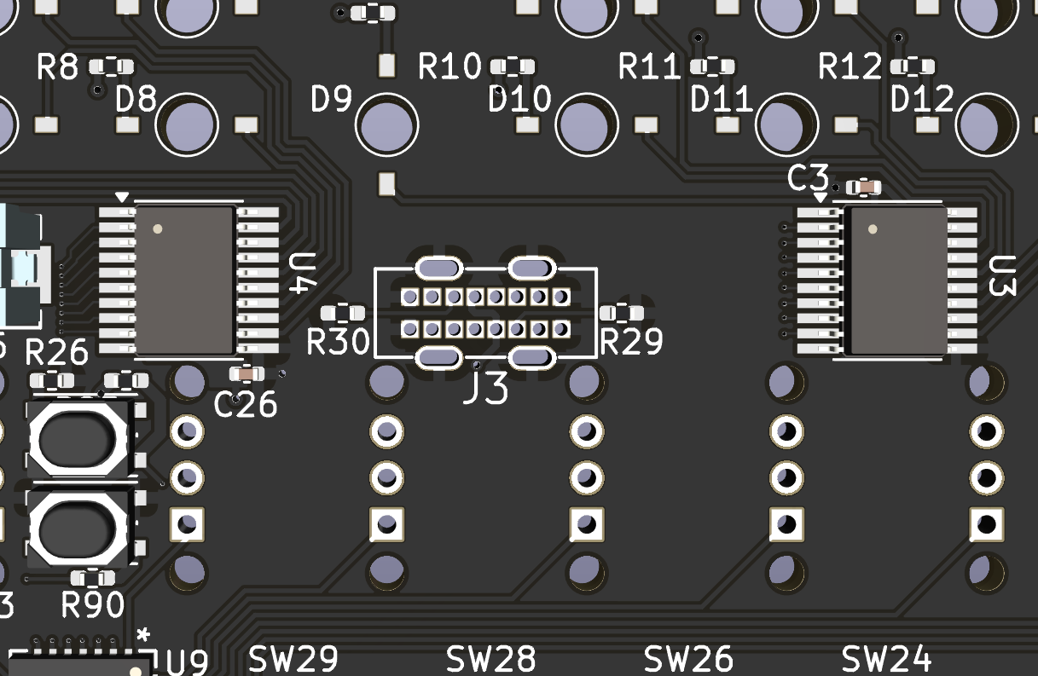
Team/journal/img - member1/week9/8.26.png
