AlphaCassiopeiae/web/Team/journal/img - member1/week9/8.33.png

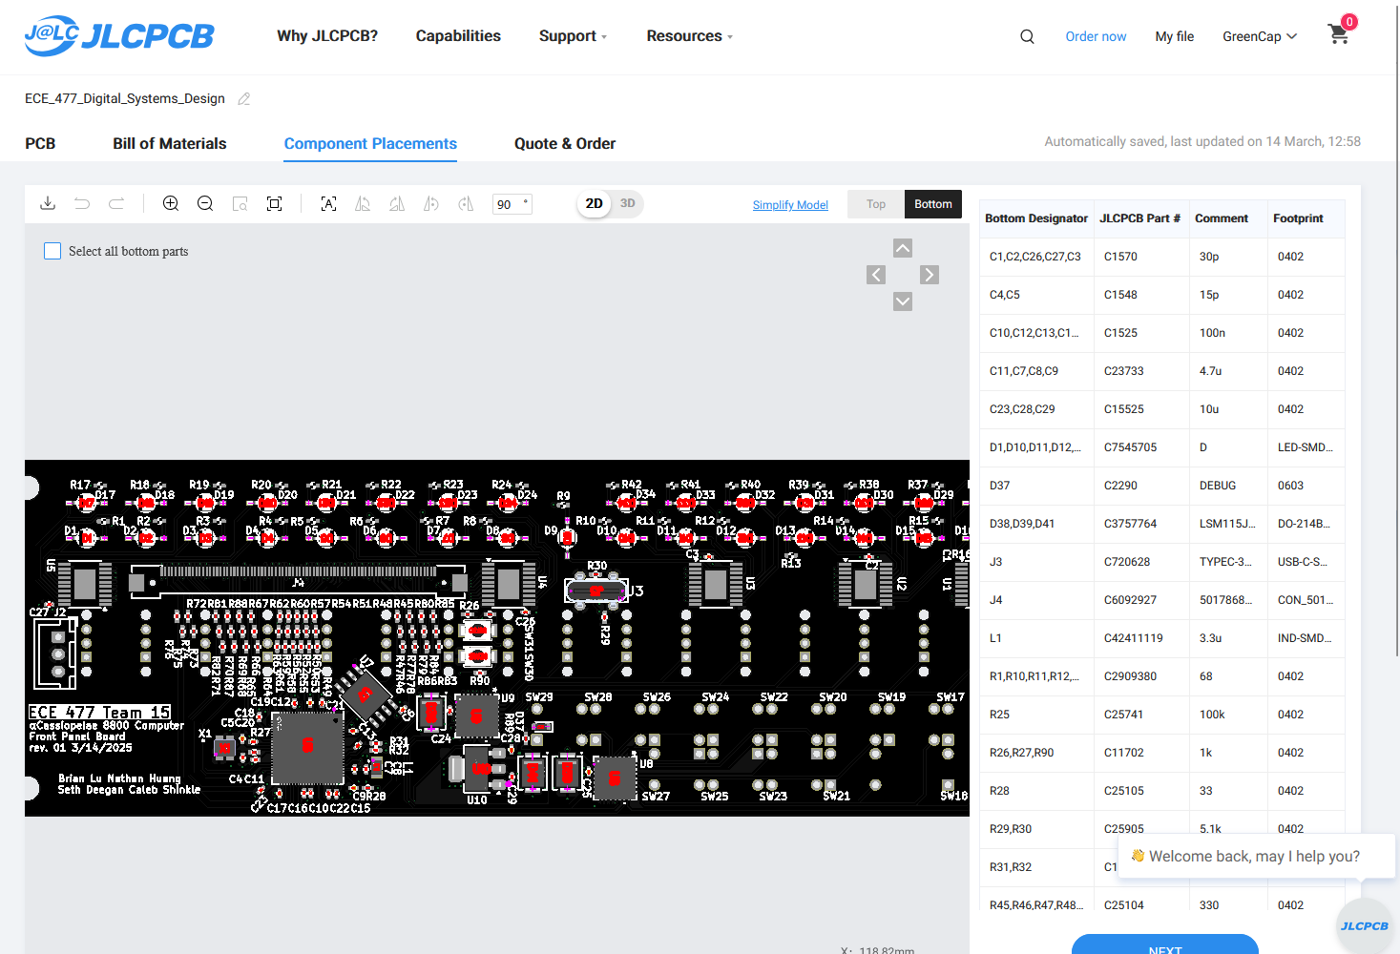
Team/journal/img - member1/week9/8.33.png
