AlphaCassiopeiae/web/Team/journal/img - member1/week9/9.1.png

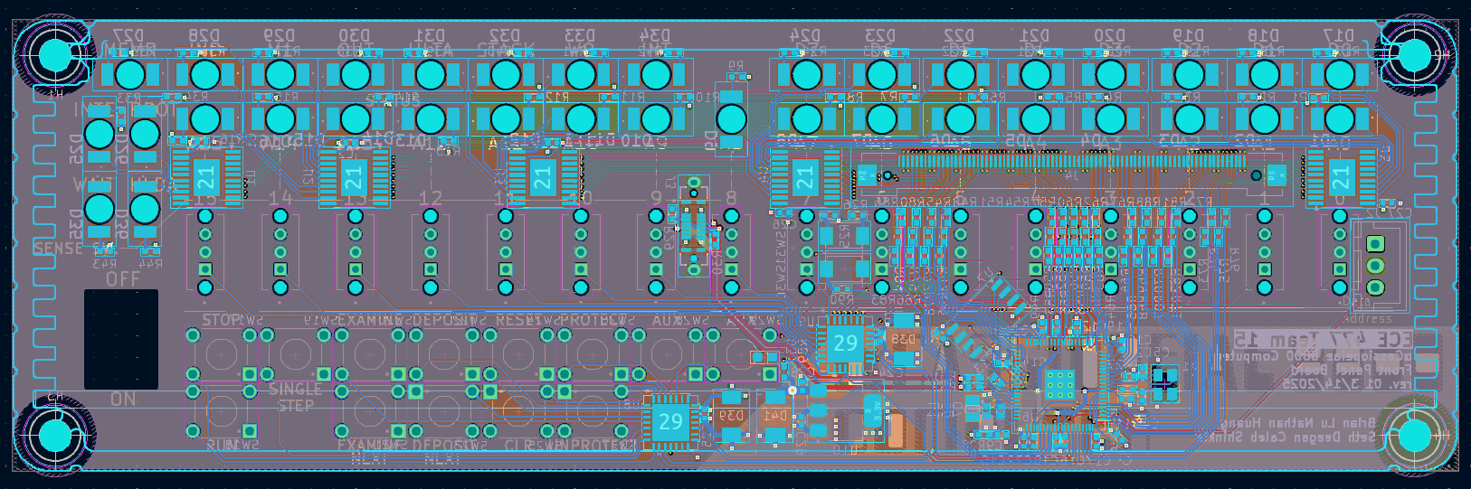
Team/journal/img - member1/week9/9.1.png
