AlphaCassiopeiae/web/Team/journal/img - member1/week9/9.11.png

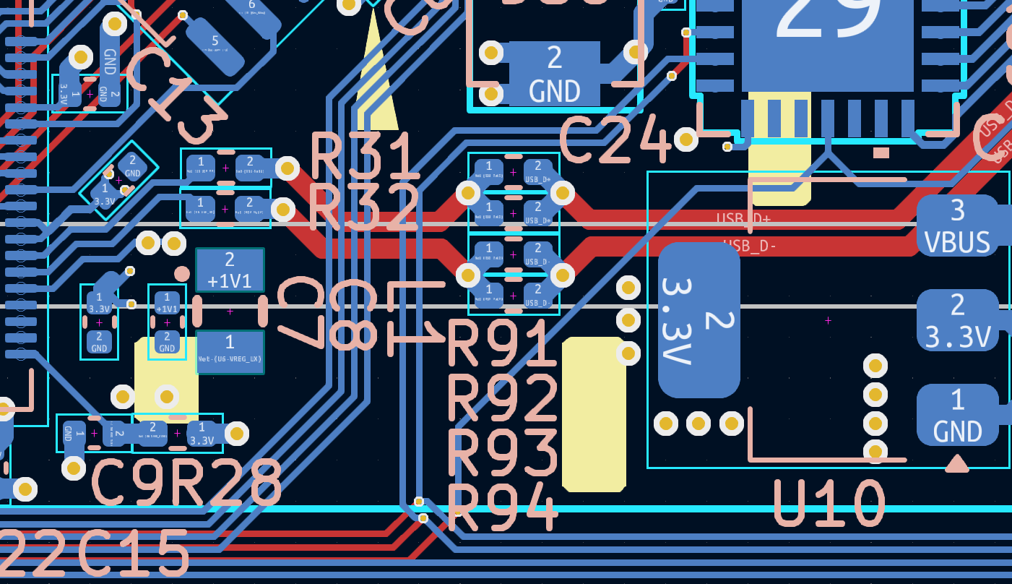
Team/journal/img - member1/week9/9.11.png
