AlphaCassiopeiae/web/Team/journal/img - member1/week9/9.15.png

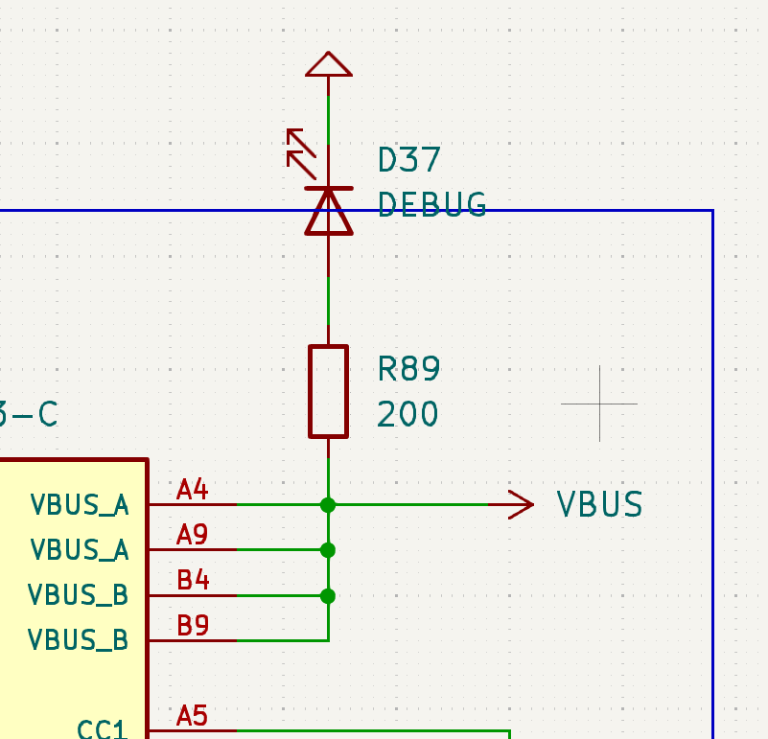
Team/journal/img - member1/week9/9.15.png
