AlphaCassiopeiae/web/Team/journal/img - member1/week10/1.8.png

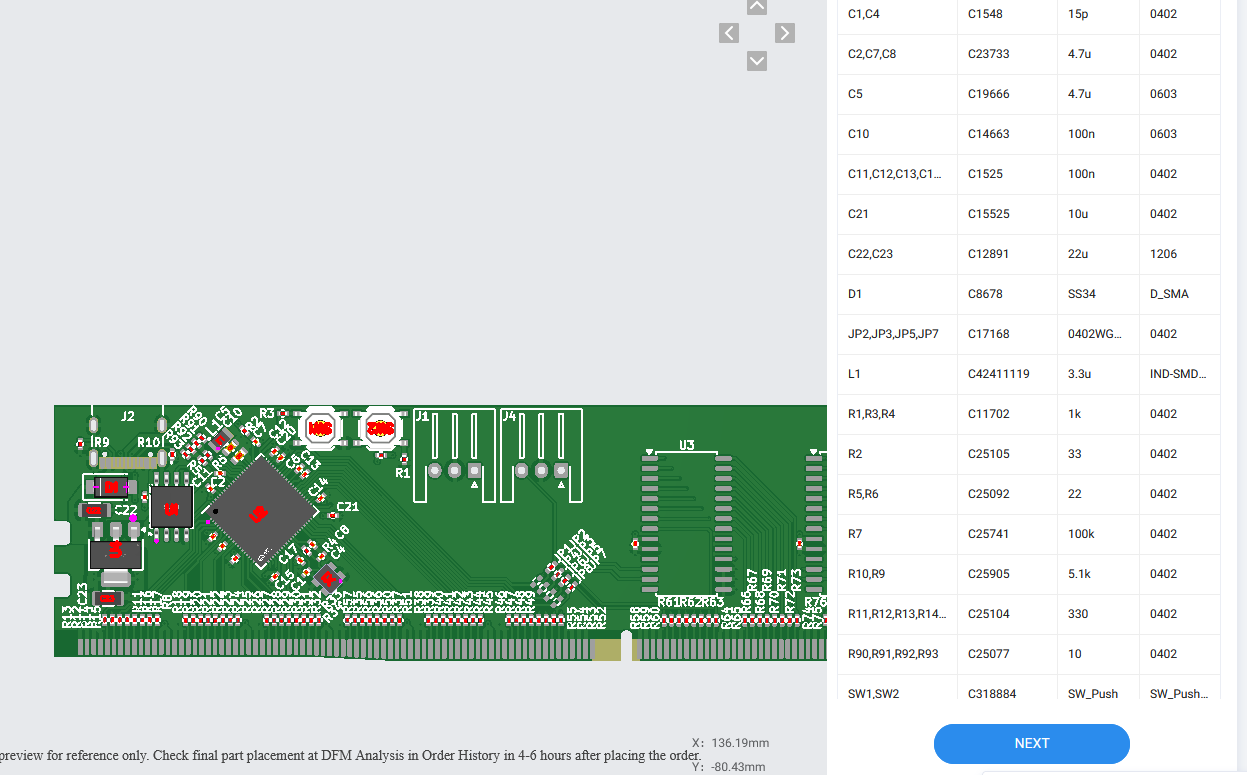
Team/journal/img - member1/week10/1.8.png
