AlphaCassiopeiae/web/Team/journal/img - member1/week10/2.12.png

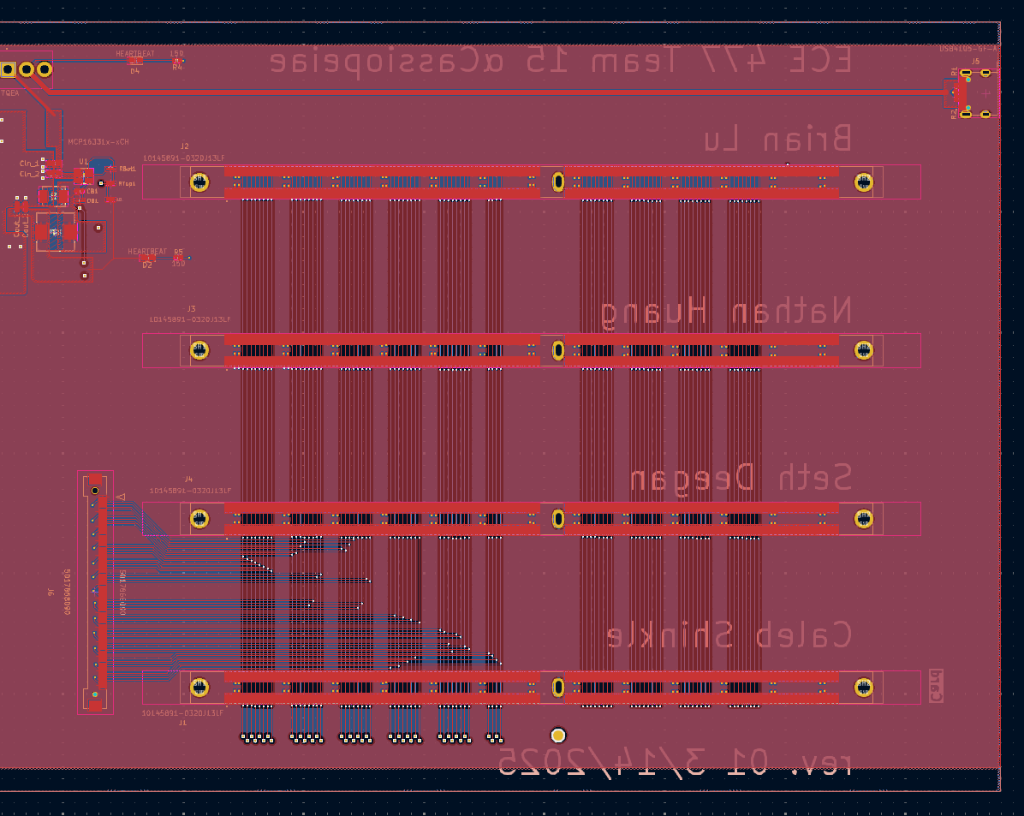
Team/journal/img - member1/week10/2.12.png
