AlphaCassiopeiae/web/Team/journal/img - member1/week10/2.33.png

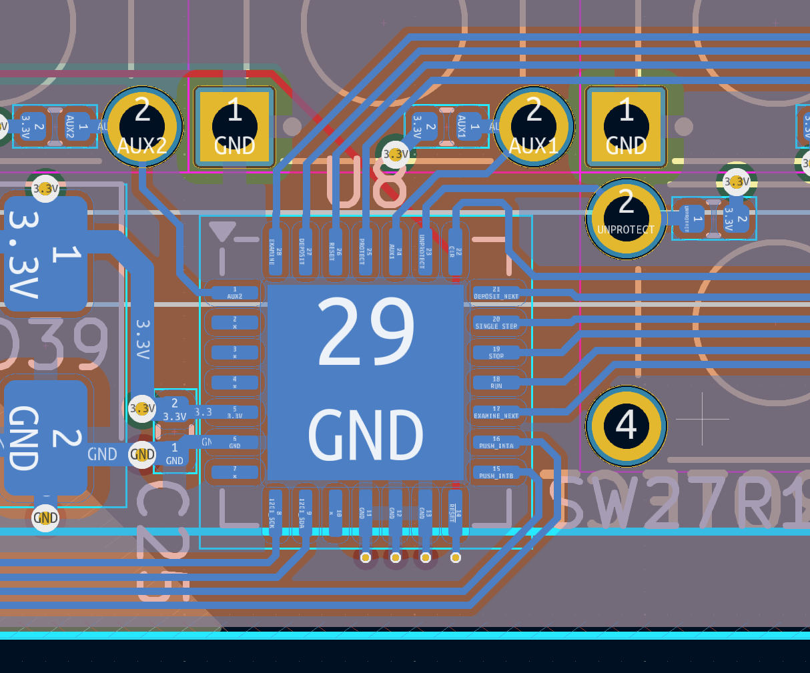
Team/journal/img - member1/week10/2.33.png
