AlphaCassiopeiae/web/Team/journal/img - member1/week10/2.36.png

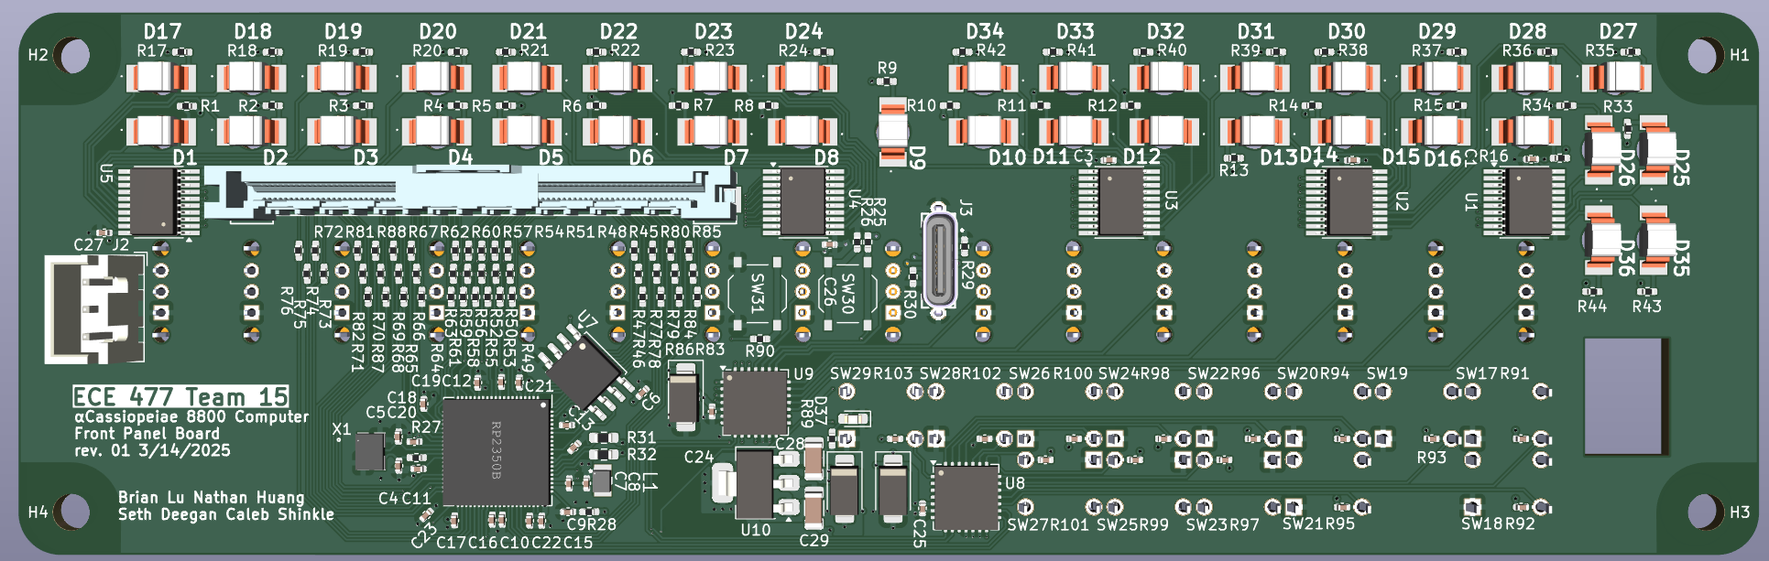
Team/journal/img - member1/week10/2.36.png
