AlphaCassiopeiae/web/Team/journal/img - member1/week10/3.25.png

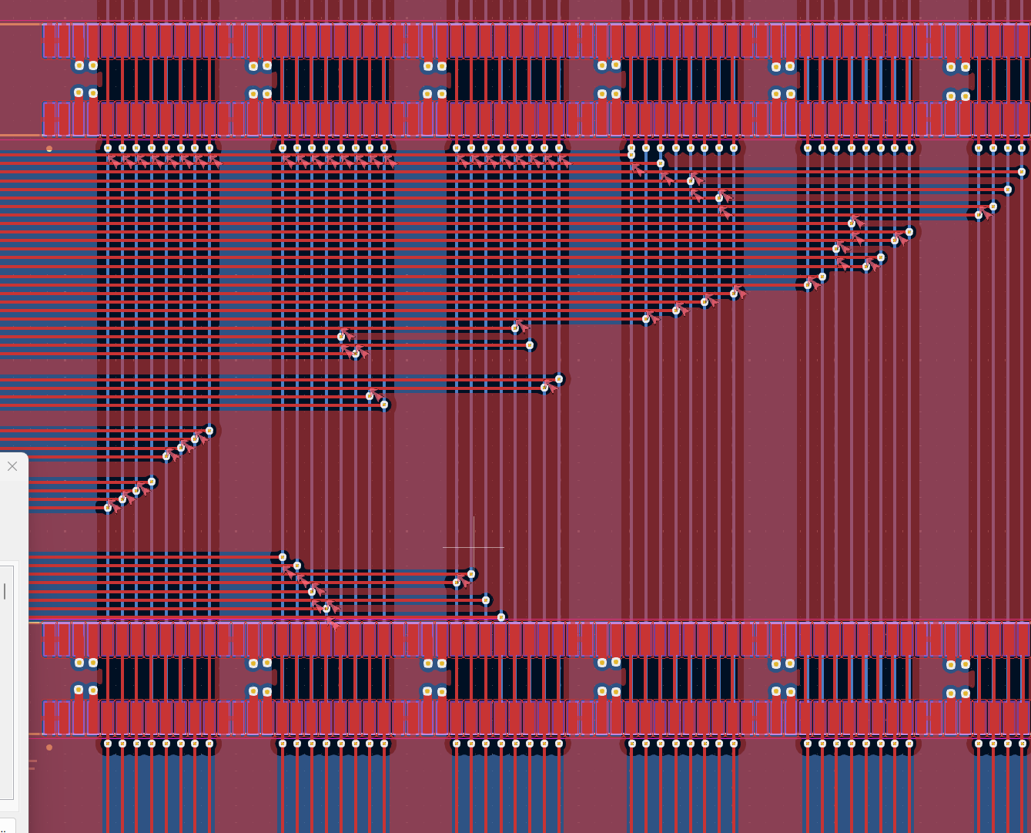
Team/journal/img - member1/week10/3.25.png
