AlphaCassiopeiae/web/Team/journal/img - member1/week10/3.27.png

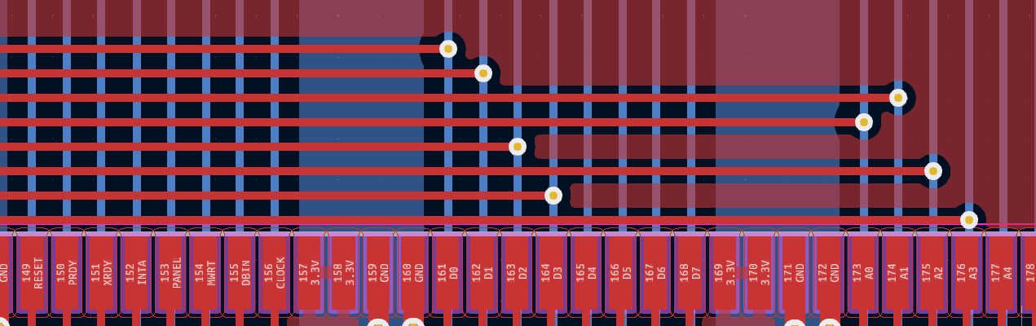
Team/journal/img - member1/week10/3.27.png
