AlphaCassiopeiae/web/Team/journal/img - member1/week11/2.1.png

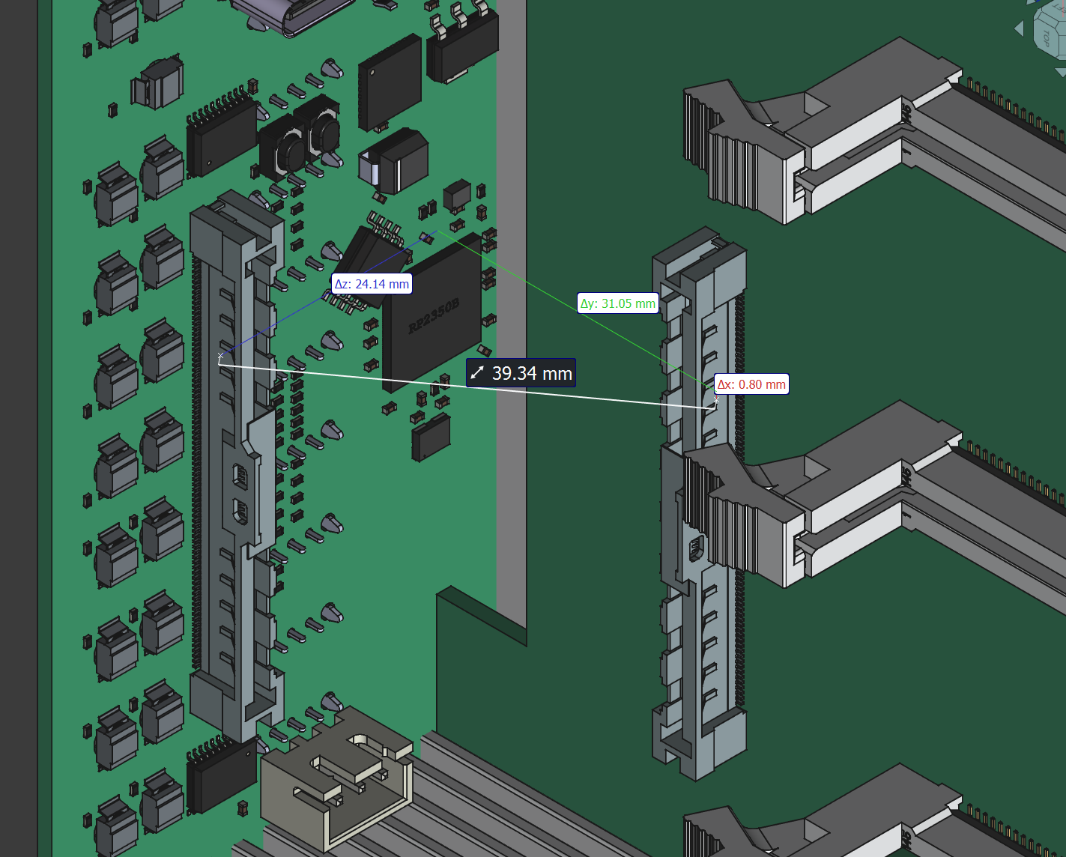
Team/journal/img - member1/week11/2.1.png
