AlphaCassiopeiae/web/Team/journal/img - member1/week13/1.2.png

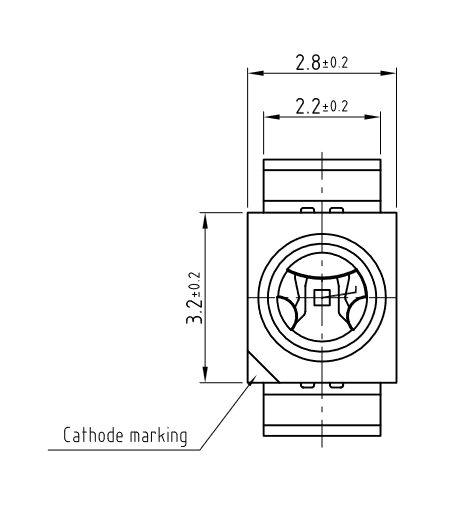
Team/journal/img - member1/week13/1.2.png
