AlphaCassiopeiae/web/Team/journal/img - member1/week13/4.1.png

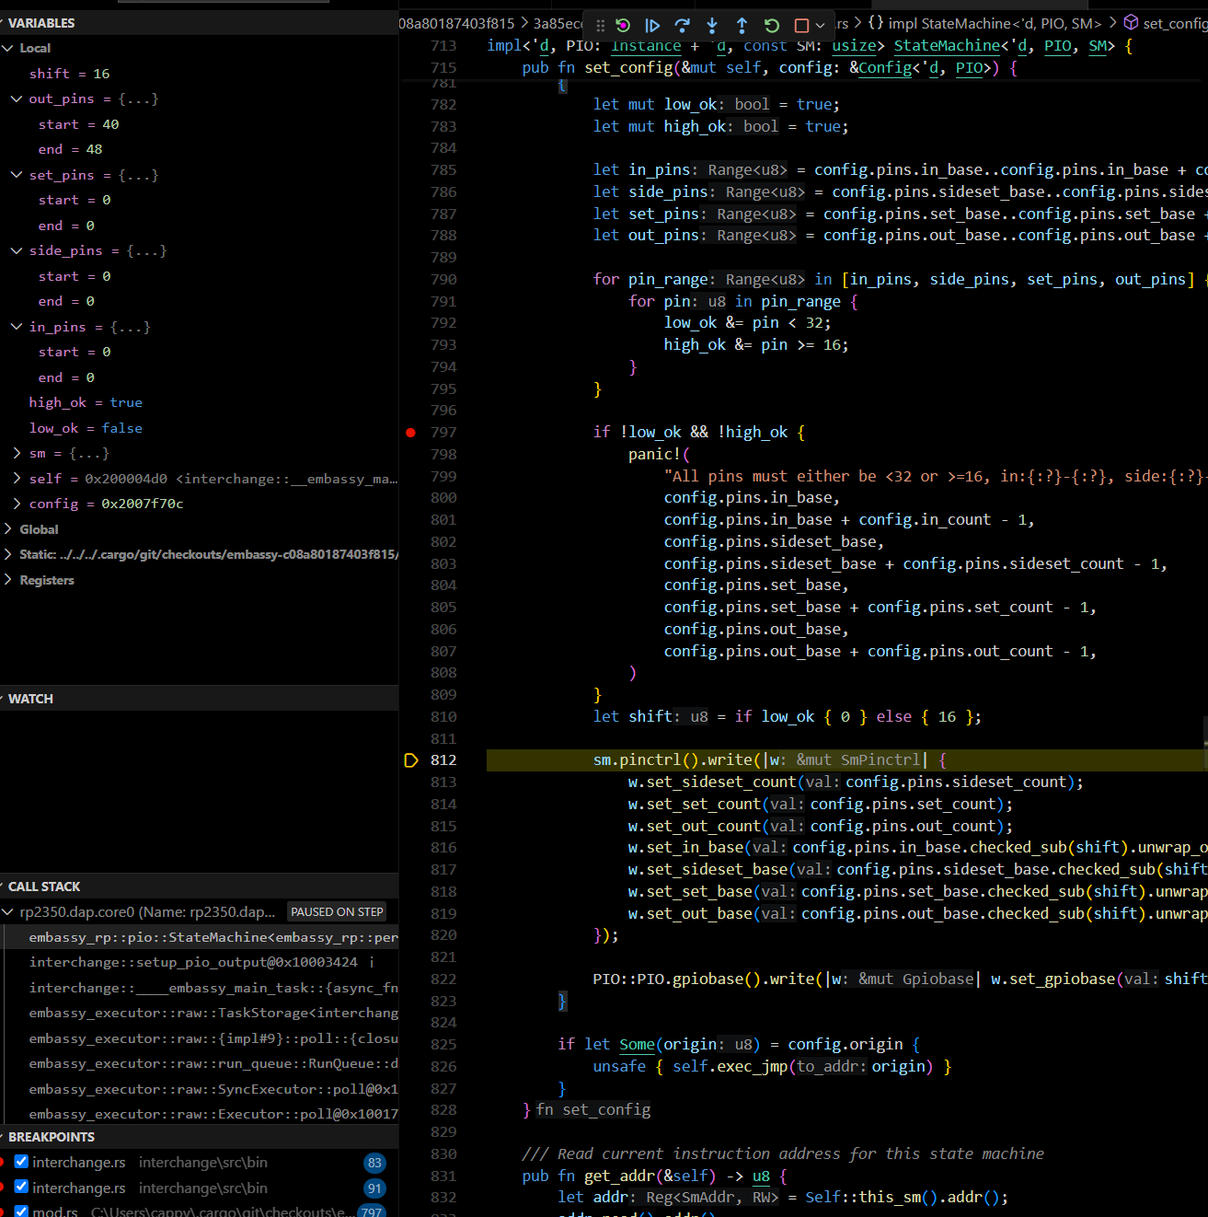
Team/journal/img - member1/week13/4.1.png
