AlphaCassiopeiae/web/Team/journal/img - member3/week2/Cary Quadrangle.jpg

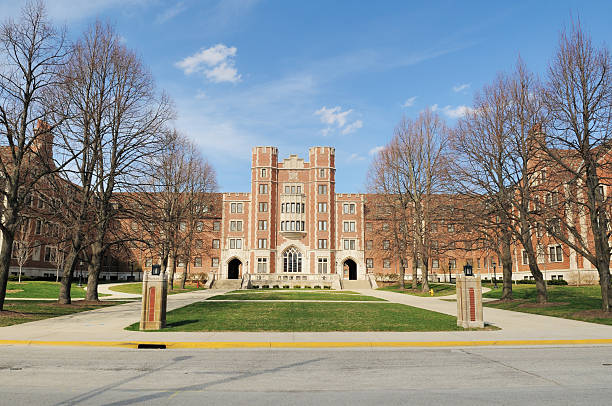
Team/journal/img - member3/week2/Cary Quadrangle.jpg
