AlphaCassiopeiae/web/Team/journal/img - member4/week3/1.2.png

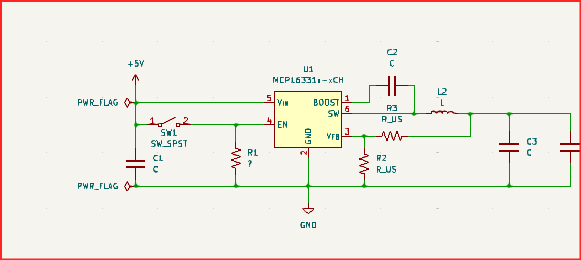
Team/journal/img - member4/week3/1.2.png
