AlphaCassiopeiae/web/Team/journal/img - member4/week3/1.3.png

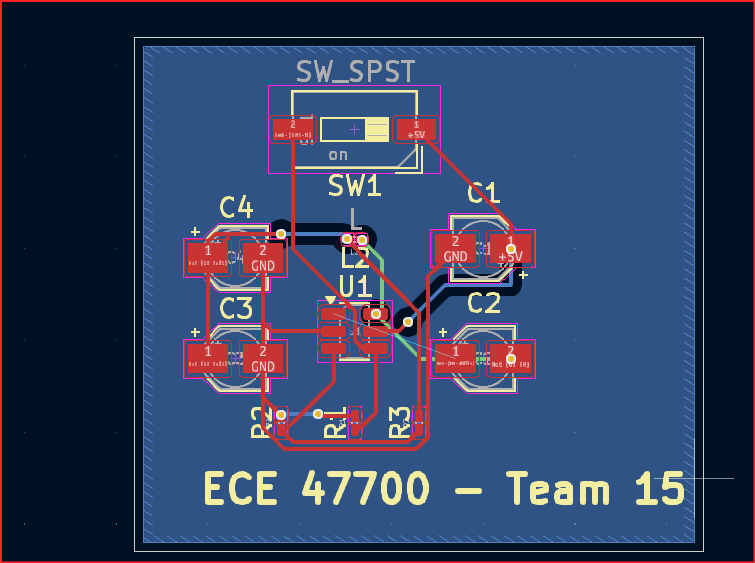
Team/journal/img - member4/week3/1.3.png
