AlphaCassiopeiae/web/Team/journal/img - member4/week3/2.1.png

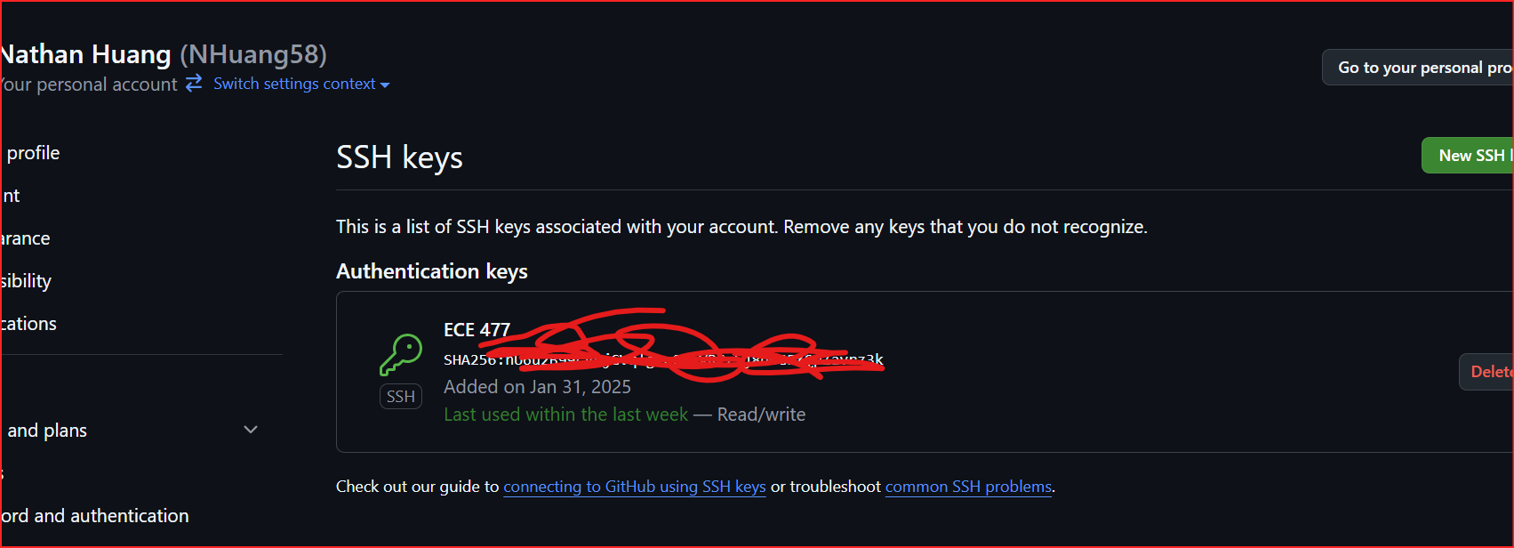
Team/journal/img - member4/week3/2.1.png
