AlphaCassiopeiae/web/Team/journal/img - member4/week3/5.1.png

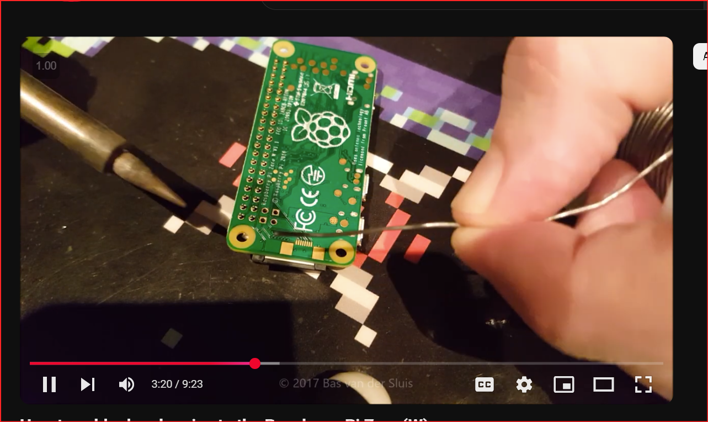
Team/journal/img - member4/week3/5.1.png
