AlphaCassiopeiae/web/Team/journal/img - member4/week4/2.png

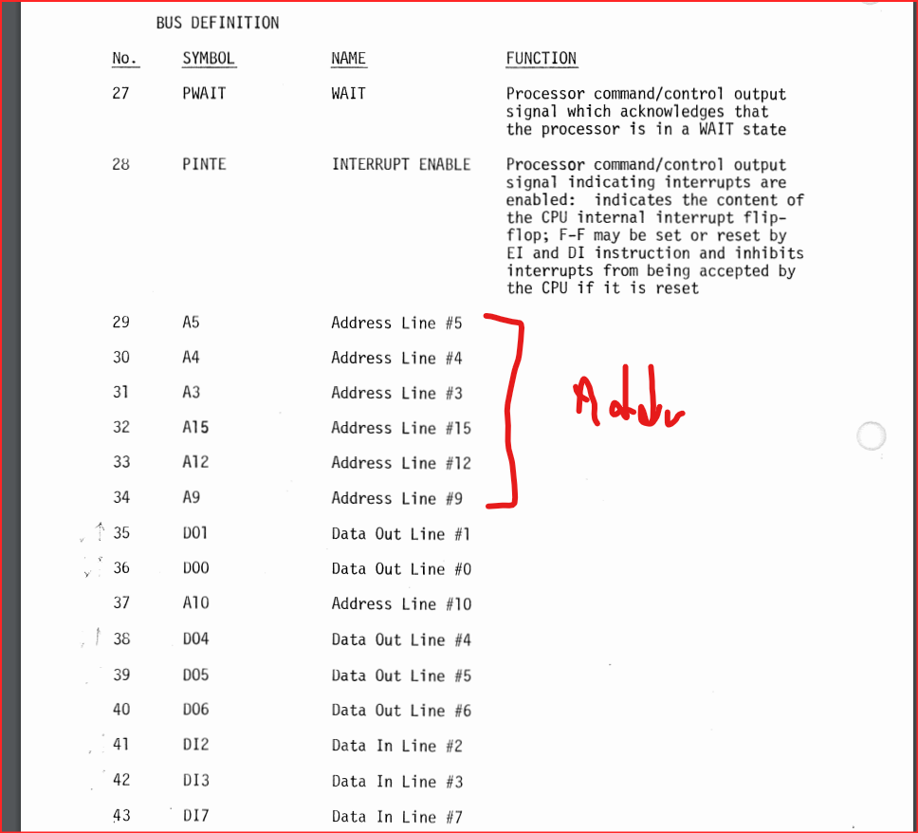
Team/journal/img - member4/week4/2.png
