AlphaCassiopeiae/web/Team/journal/img - member4/week5/1.2.png

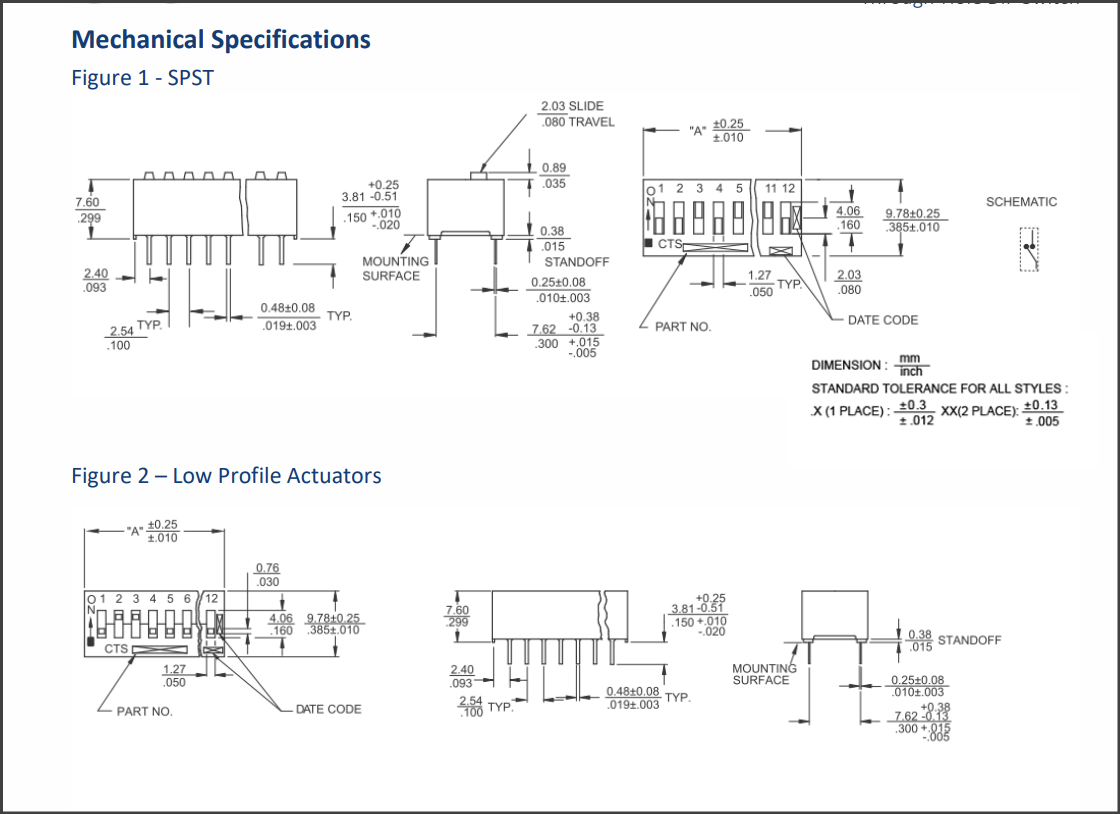
Team/journal/img - member4/week5/1.2.png
