AlphaCassiopeiae/web/Team/journal/img - member4/week5/2.2.jpg

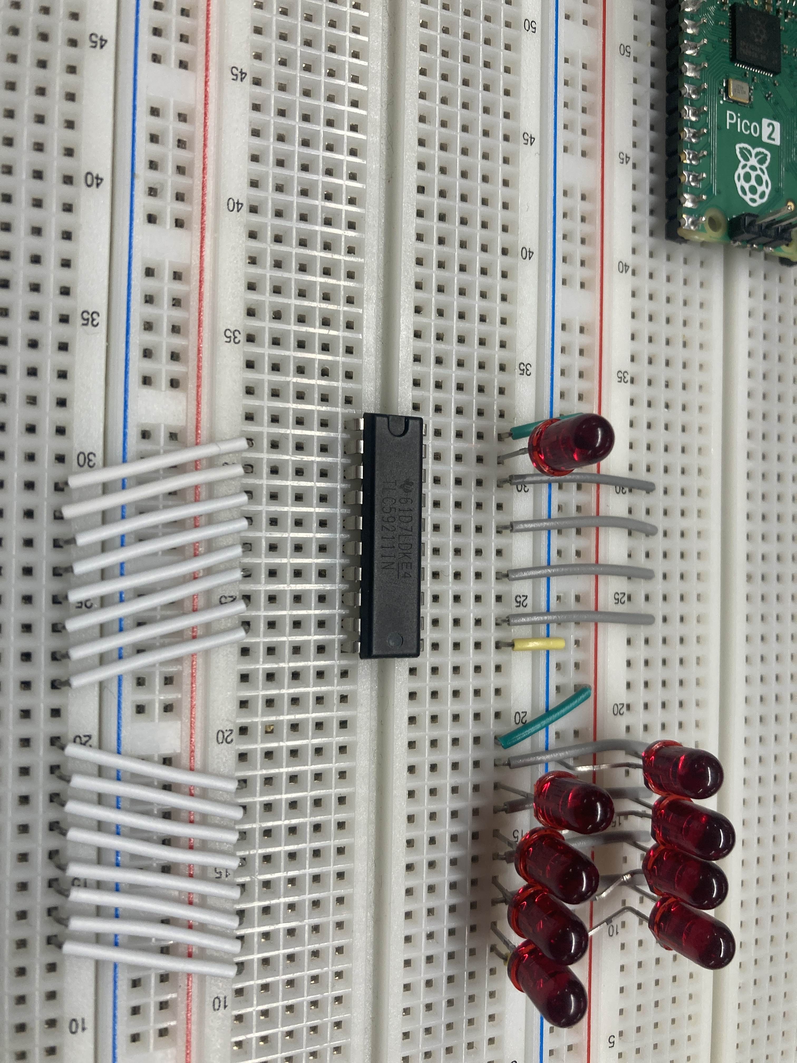
Team/journal/img - member4/week5/2.2.jpg
