AlphaCassiopeiae/web/Team/journal/img - member4/week5/3.2.png

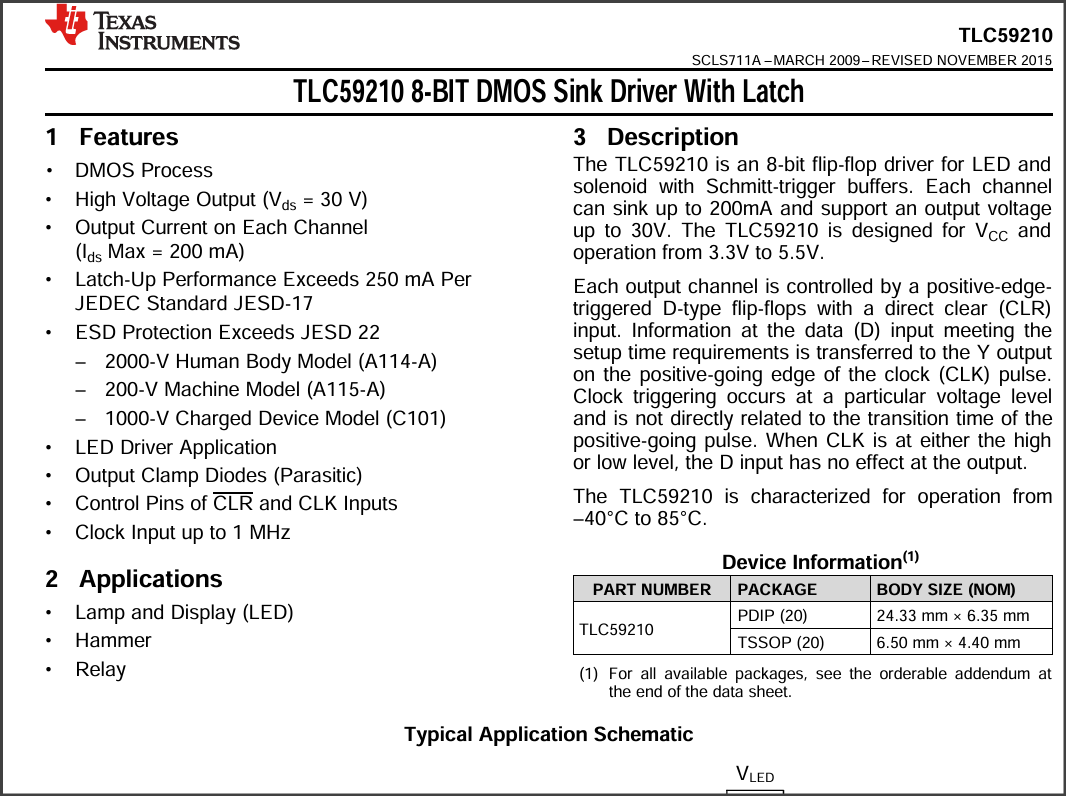
Team/journal/img - member4/week5/3.2.png
