AlphaCassiopeiae/web/Team/journal/img - member4/week5/4.1.png

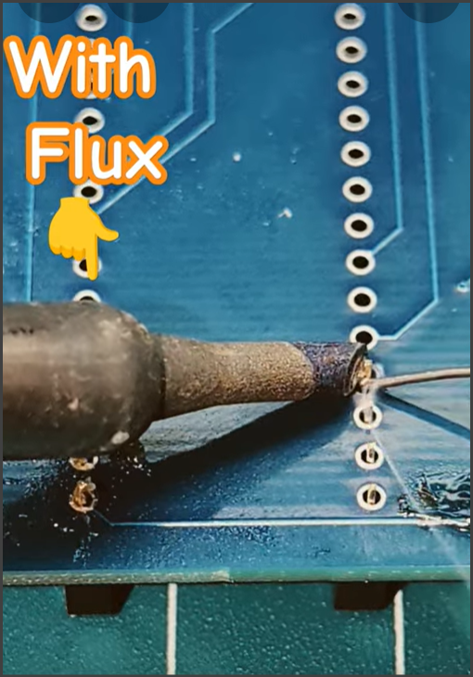
Team/journal/img - member4/week5/4.1.png
