AlphaCassiopeiae/web/Team/journal/img - member4/week5/4.3.jpg

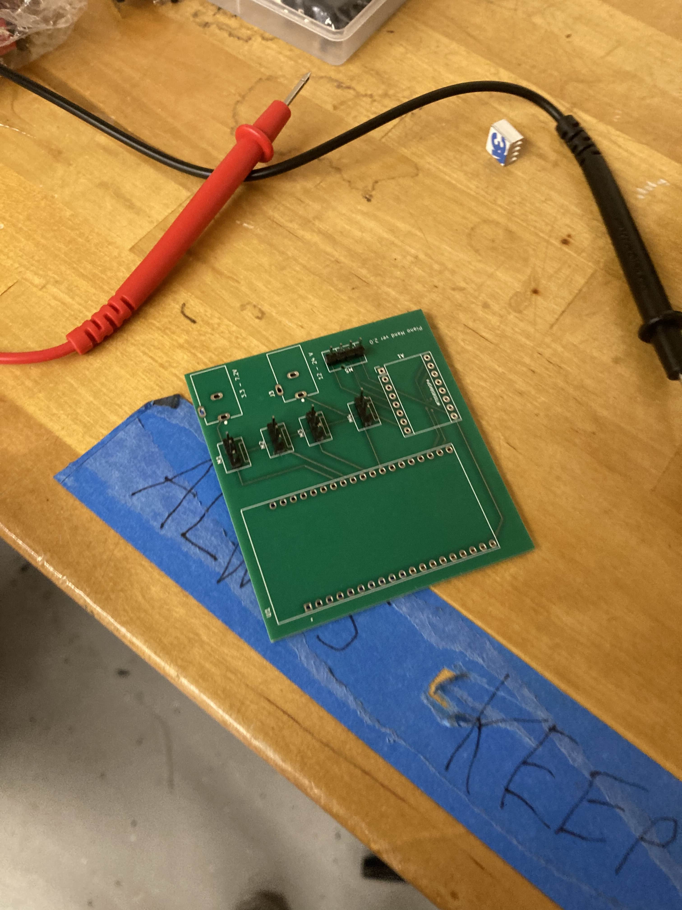
Team/journal/img - member4/week5/4.3.jpg
