AlphaCassiopeiae/web/Team/journal/img - member4/week6/1.1.png

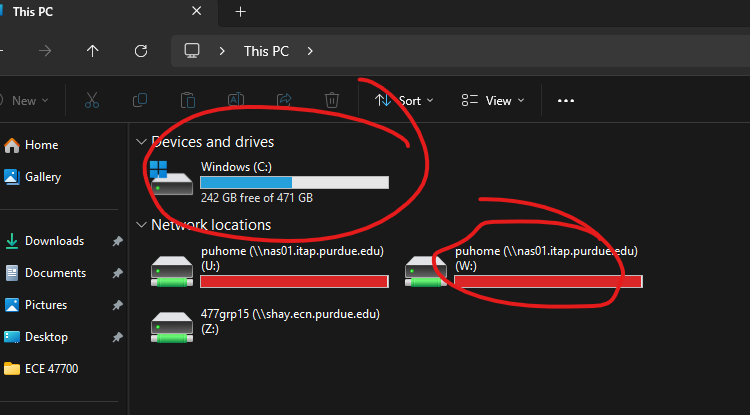
Team/journal/img - member4/week6/1.1.png
