AlphaCassiopeiae/web/Team/journal/img - member4/week6/3.3.png

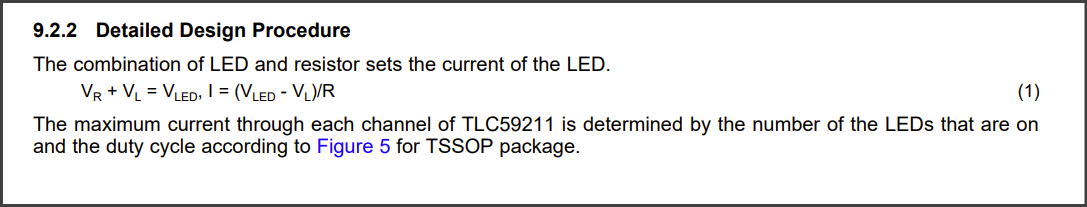
Team/journal/img - member4/week6/3.3.png
