AlphaCassiopeiae/web/Team/journal/img - member4/week6/4.3.jpg

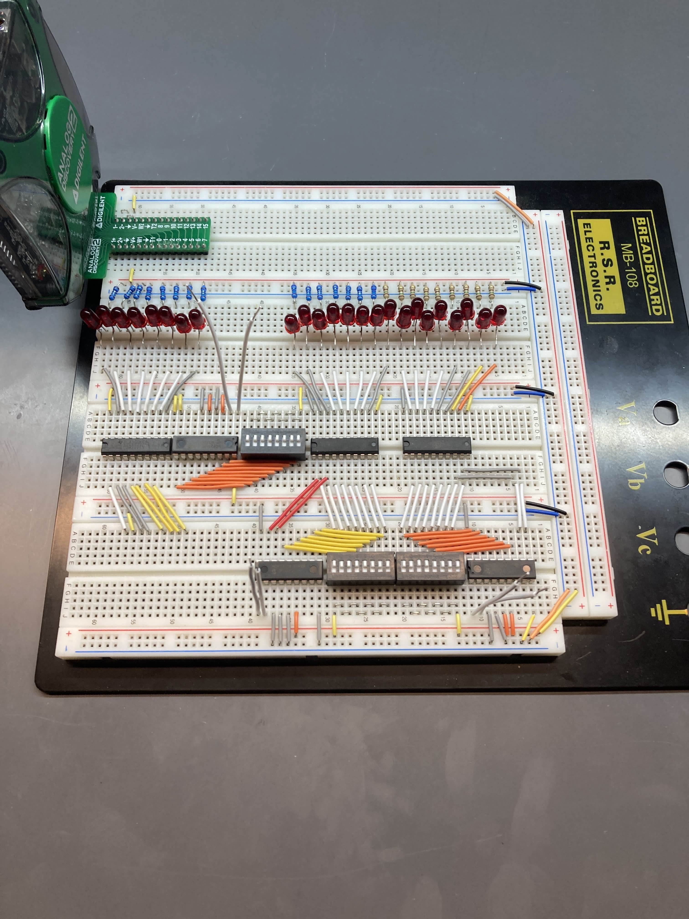
Team/journal/img - member4/week6/4.3.jpg
