AlphaCassiopeiae/web/Team/journal/img - member4/week7/1.1.jpg

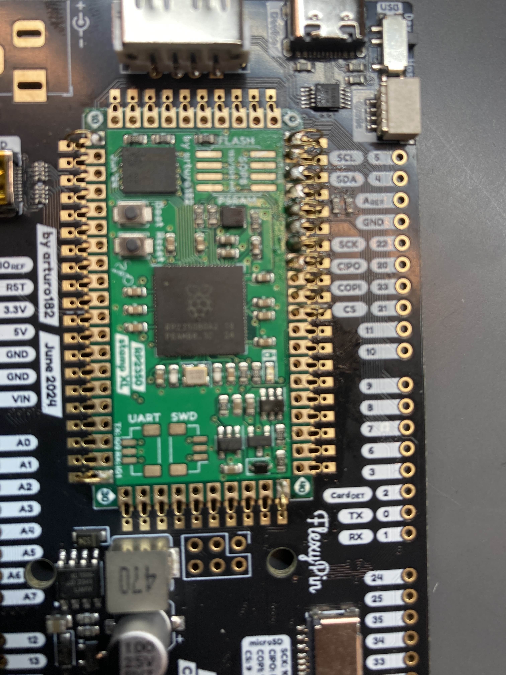
Team/journal/img - member4/week7/1.1.jpg
