AlphaCassiopeiae/web/Team/journal/img - member4/week7/3.1.png

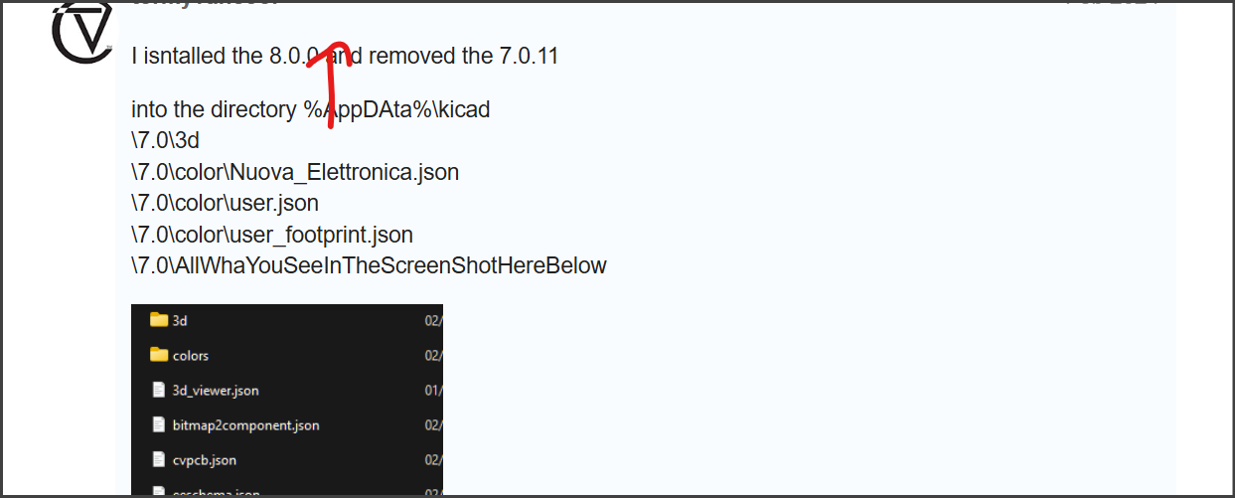
Team/journal/img - member4/week7/3.1.png
