AlphaCassiopeiae/web/Team/journal/img - member4/week7/3.2.png

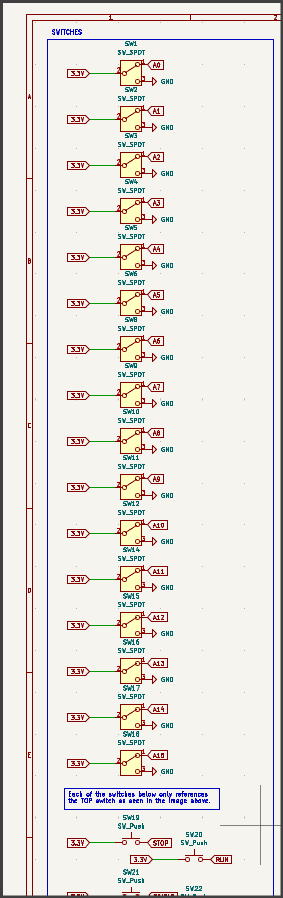
Team/journal/img - member4/week7/3.2.png
