AlphaCassiopeiae/web/Team/journal/img - member4/week7/3.4.png

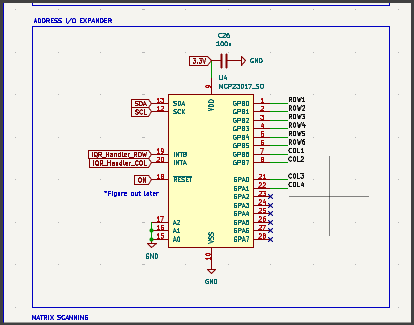
Team/journal/img - member4/week7/3.4.png
