AlphaCassiopeiae/web/Team/journal/img - member4/week7/3.5.png

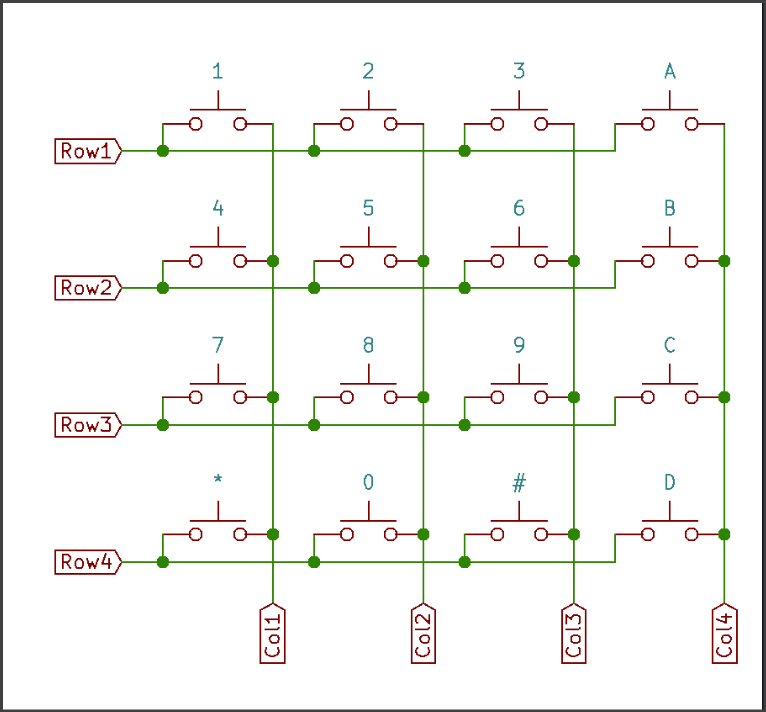
Team/journal/img - member4/week7/3.5.png
