AlphaCassiopeiae/web/Team/journal/img - member4/week7/4.2.png

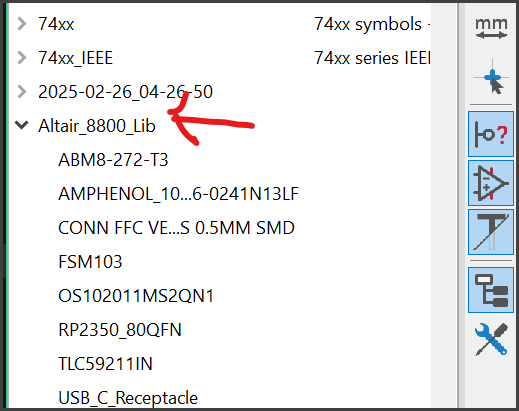
Team/journal/img - member4/week7/4.2.png
