AlphaCassiopeiae/web/Team/journal/img - member4/week7/5.8.png

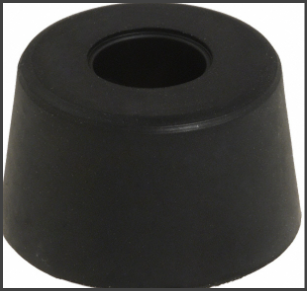
Team/journal/img - member4/week7/5.8.png
