AlphaCassiopeiae/web/Team/journal/img - member4/week8/1.2.png

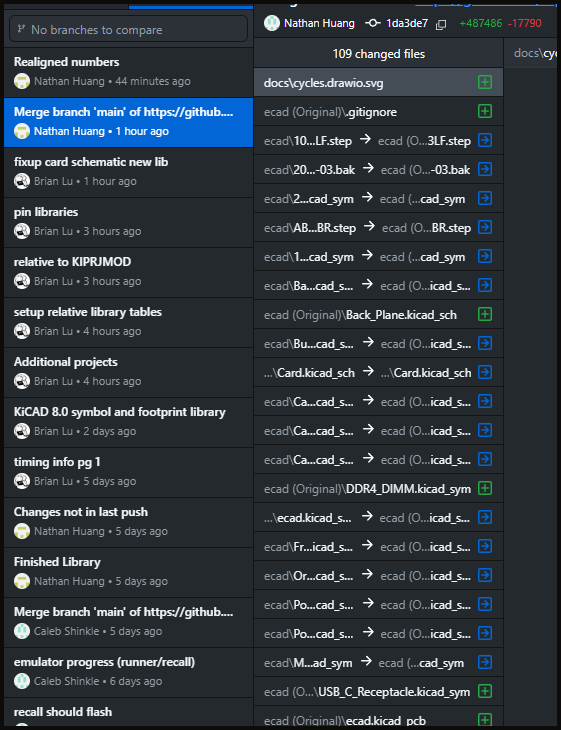
Team/journal/img - member4/week8/1.2.png
