AlphaCassiopeiae/web/Team/journal/img - member4/week8/2.3.png

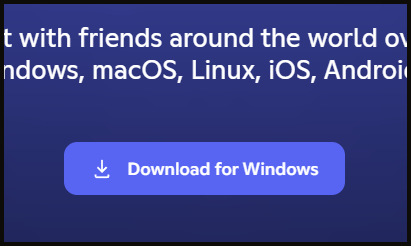
Team/journal/img - member4/week8/2.3.png
