AlphaCassiopeiae/web/Team/journal/img - member4/week8/4.3.png

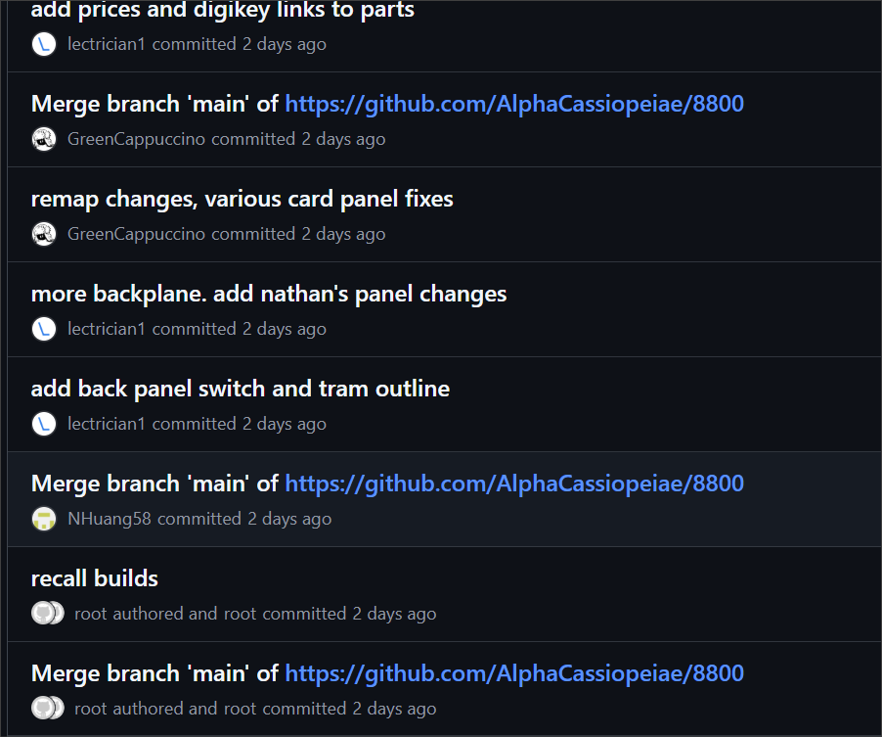
Team/journal/img - member4/week8/4.3.png
