AlphaCassiopeiae/web/Team/journal/img - member4/week9/2.5.png

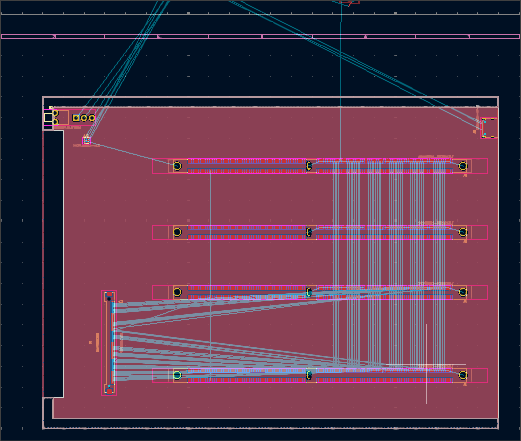
Team/journal/img - member4/week9/2.5.png
