AlphaCassiopeiae/web/Team/journal/img - member4/week9/4.6.png

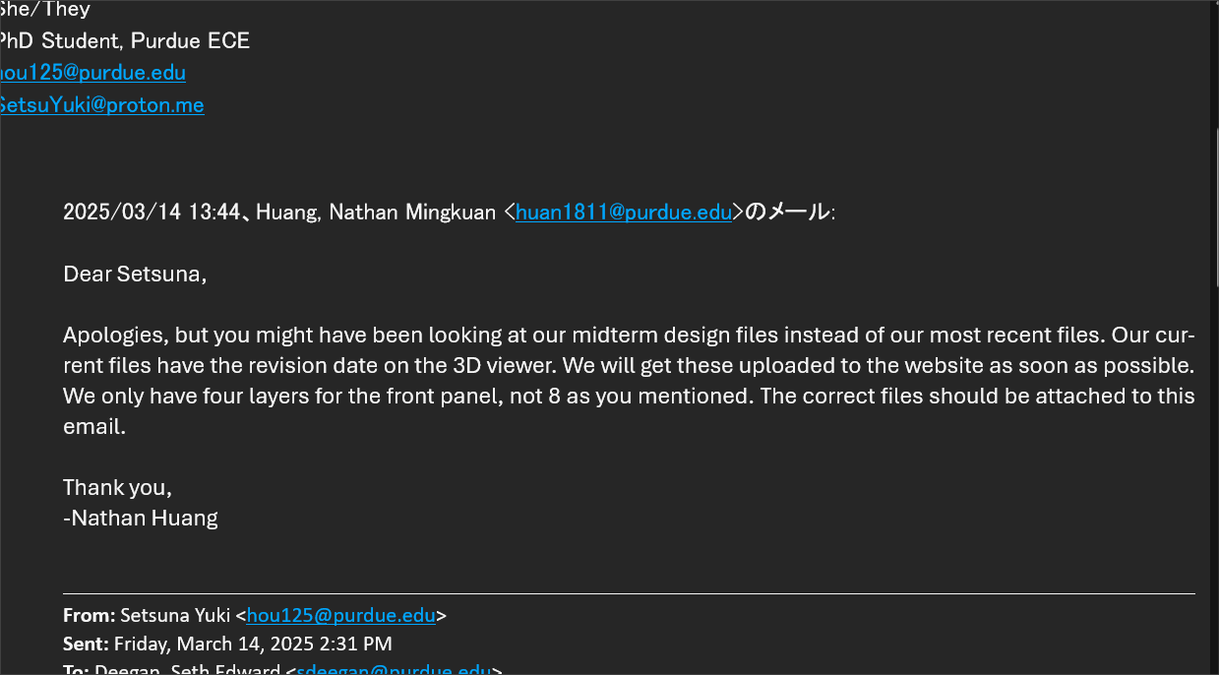
Team/journal/img - member4/week9/4.6.png
