AlphaCassiopeiae/web/Team/journal/img - member4/week11/1.3.jpg

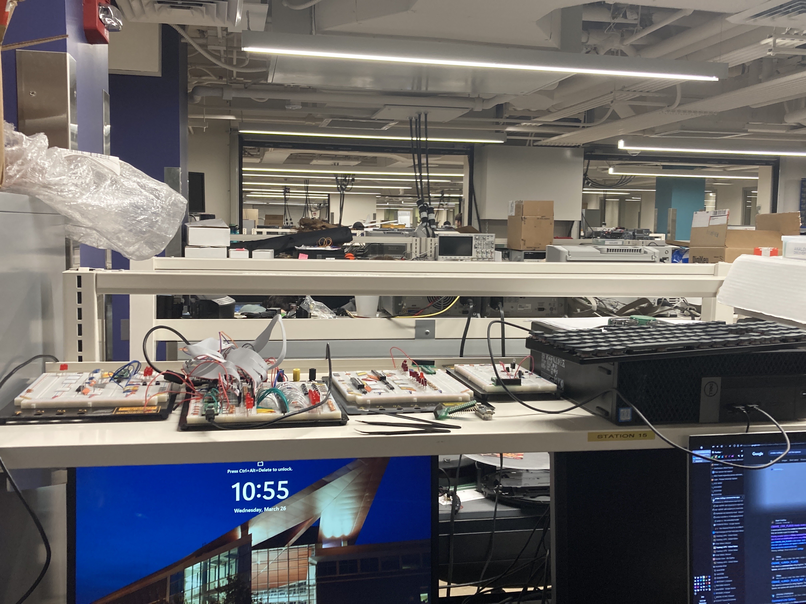
Team/journal/img - member4/week11/1.3.jpg
