AlphaCassiopeiae/web/Team/journal/img - member4/week12/4.17.jpg

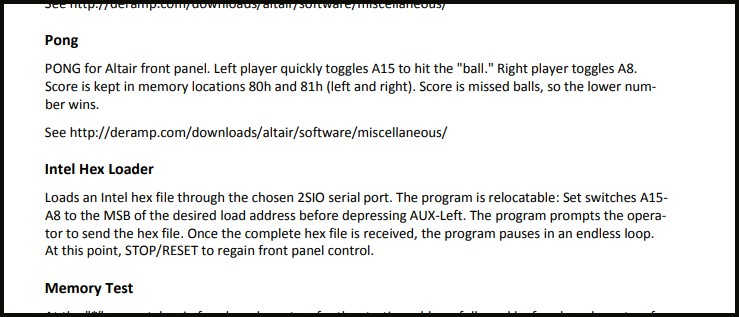
Team/journal/img - member4/week12/4.17.jpg
