AlphaCassiopeiae/web/Team/journal/img - member4/week12/4.18.jpg

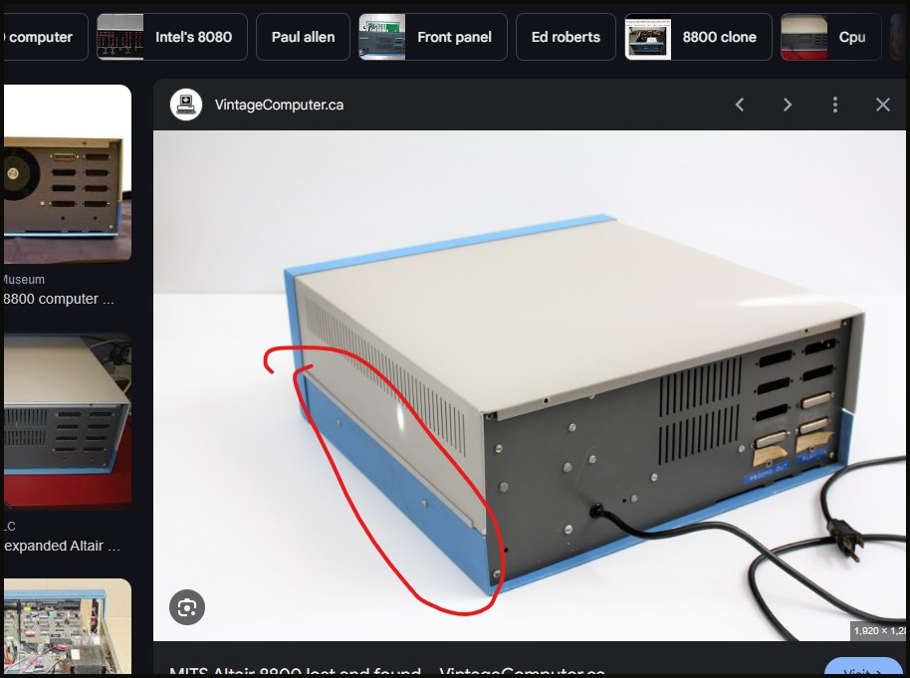
Team/journal/img - member4/week12/4.18.jpg
