AlphaCassiopeiae/web/Team/journal/img - member4/week13/1.1.jpg

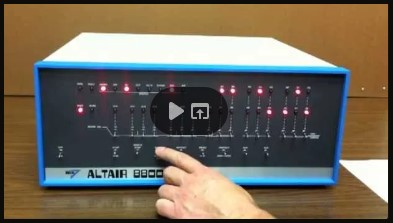
Team/journal/img - member4/week13/1.1.jpg
