AlphaCassiopeiae/web/Team/journal/img - member4/week13/1.8.jpg

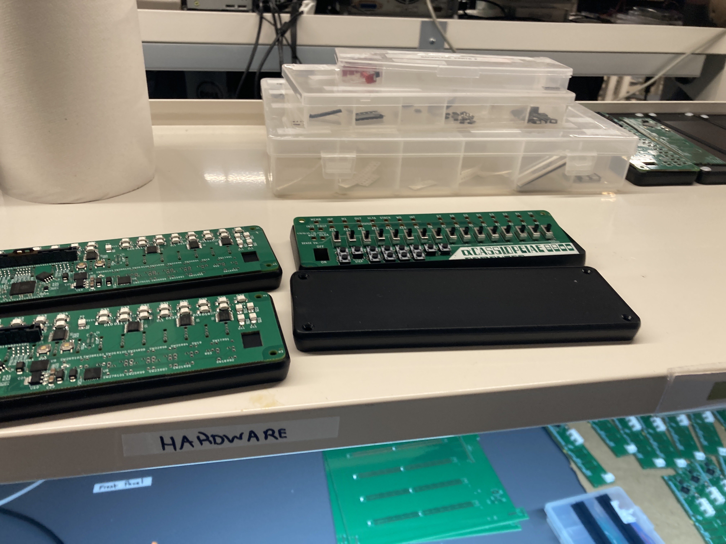
Team/journal/img - member4/week13/1.8.jpg
