AlphaCassiopeiae/web/Team/journal/img - member4/week13/2.4.jpg

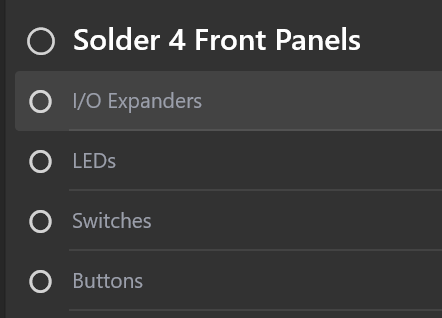
Team/journal/img - member4/week13/2.4.jpg
