AlphaCassiopeiae/web/Team/journal/img - member4/week13/4.1.jpg

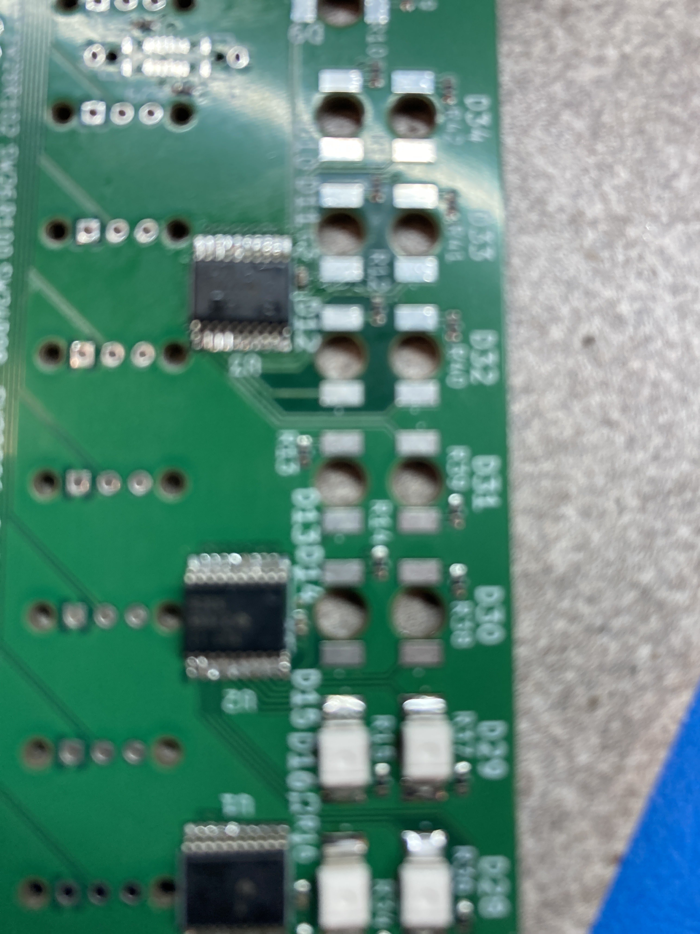
Team/journal/img - member4/week13/4.1.jpg
