AlphaCassiopeiae/web/Team/journal/img - member4/week14/2.2.jpg

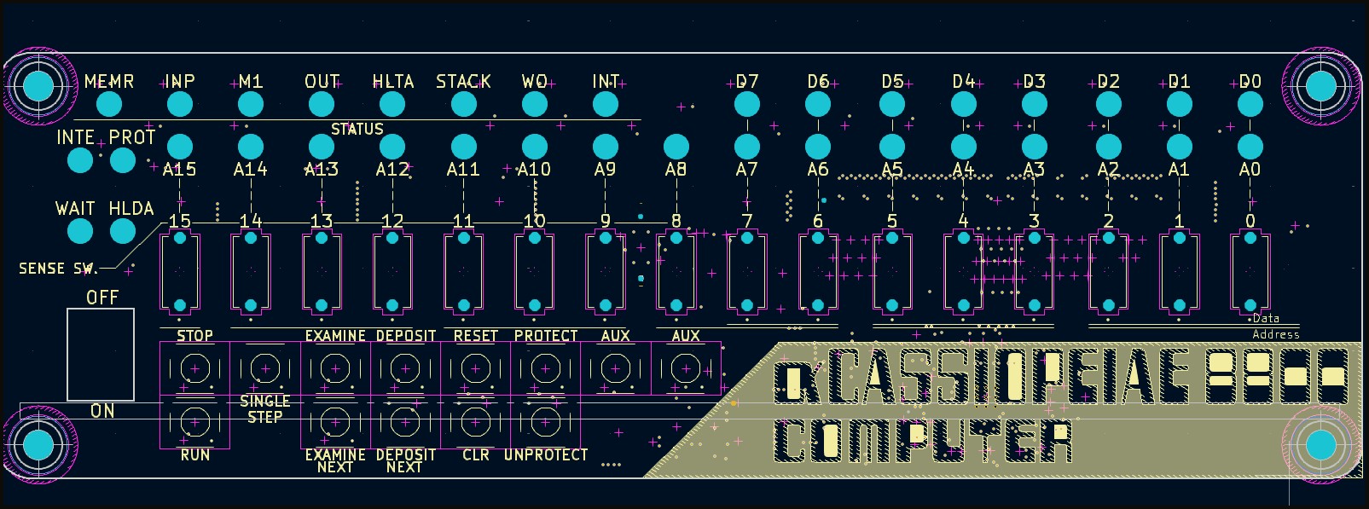
Team/journal/img - member4/week14/2.2.jpg
