AlphaCassiopeiae/web/Team/journal/img - member4/week14/2.9.jpg

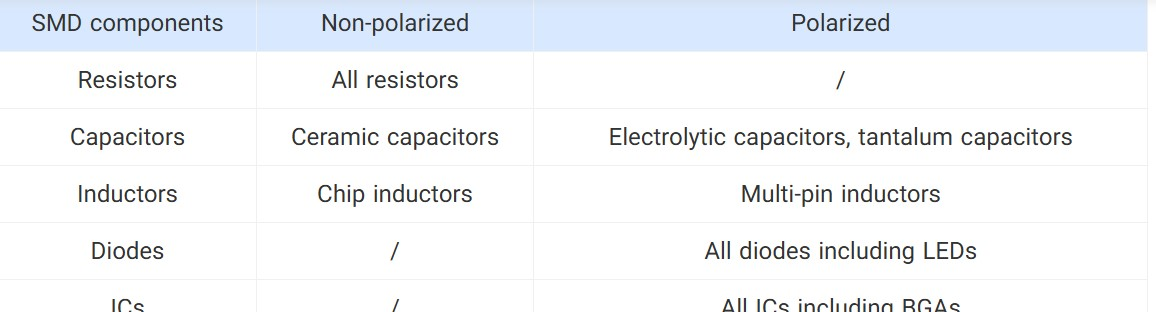
Team/journal/img - member4/week14/2.9.jpg
