AlphaCassiopeiae/web/Team/journal/img - member4/week14/2.21.jpg

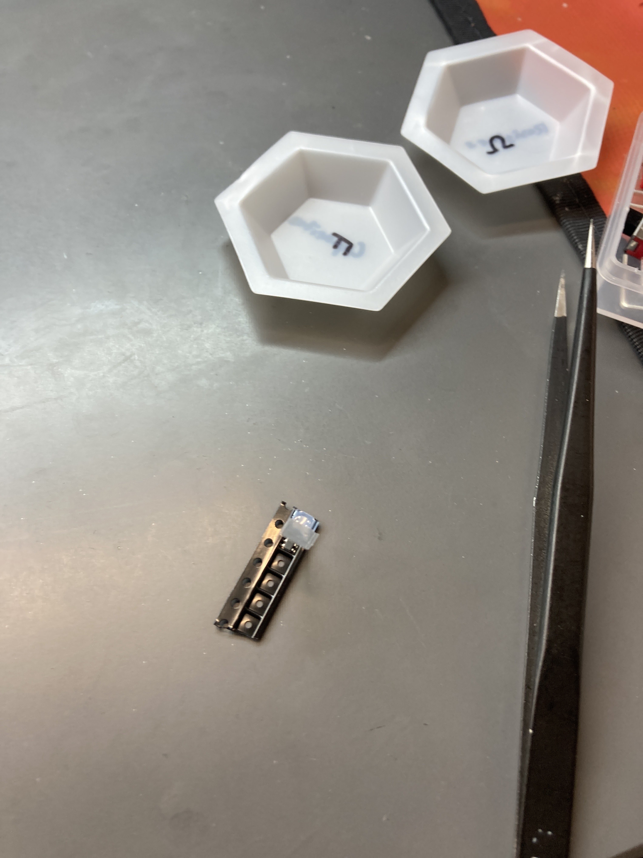
Team/journal/img - member4/week14/2.21.jpg
