AlphaCassiopeiae/web/Team/journal/img - member4/week15/1.2.jpg

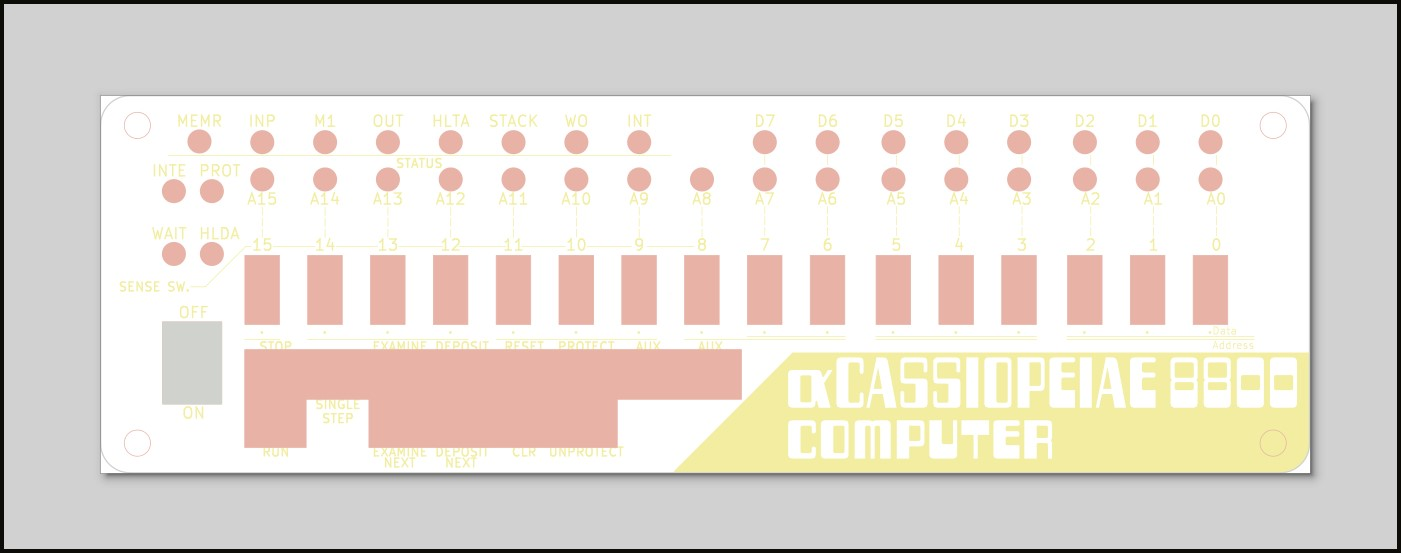
Team/journal/img - member4/week15/1.2.jpg
