AlphaCassiopeiae/web/Team/journal/img - member4/week15/1.3.jpg

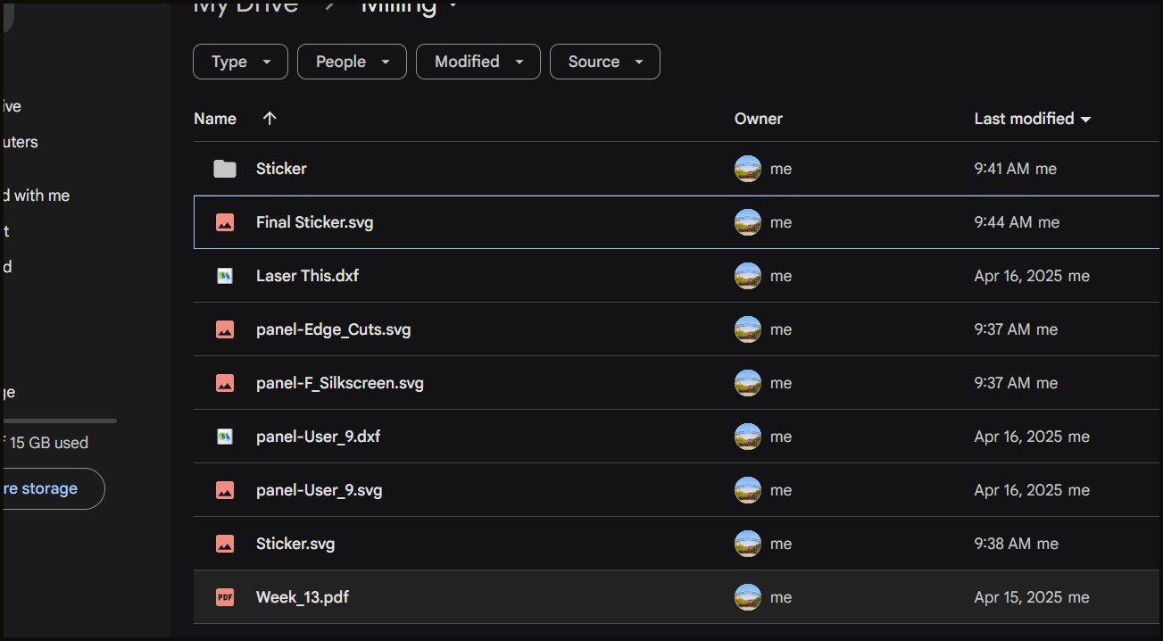
Team/journal/img - member4/week15/1.3.jpg
