AlphaCassiopeiae/web/Team/journal/img - member4/week15/2.9.jpg

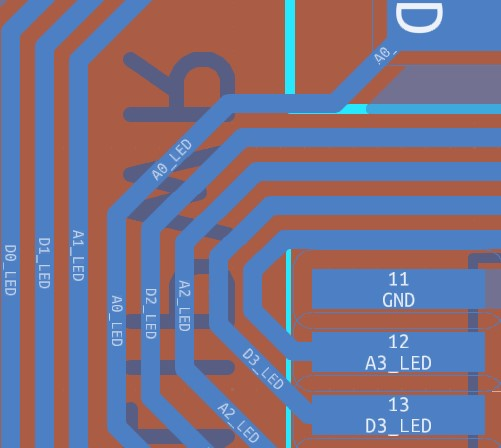
Team/journal/img - member4/week15/2.9.jpg
