AlphaCassiopeiae/web/(commit log)

2025-02-21 Linked new documents
    [A7 - Bill of Materials.xlsx]
2025-02-24 LED desc update
2025-03-05 kicad projects
2025-03-10 PCB Changes
2025-03-14 Updated mcad
    [Team 15 - Project CAD Files.stp]
2025-03-18 Production ECAD files
    [Team 15 - Project CAD Design Files.FCStd, bom.csv, positions.csv]
2025-03-19 ECAD via revisions
    [positions.csv]
2025-03-20 enlarge holes to 0.3mm
2025-04-26 journal updates
    [20250325_8800_computer.csv]
